aleksejm/6xUSB-Power-Meter/ESP-12-breakout-master/README.md

# ESP-12 breakout board

---
A simple ESP-12 breakout board for development and deployment.

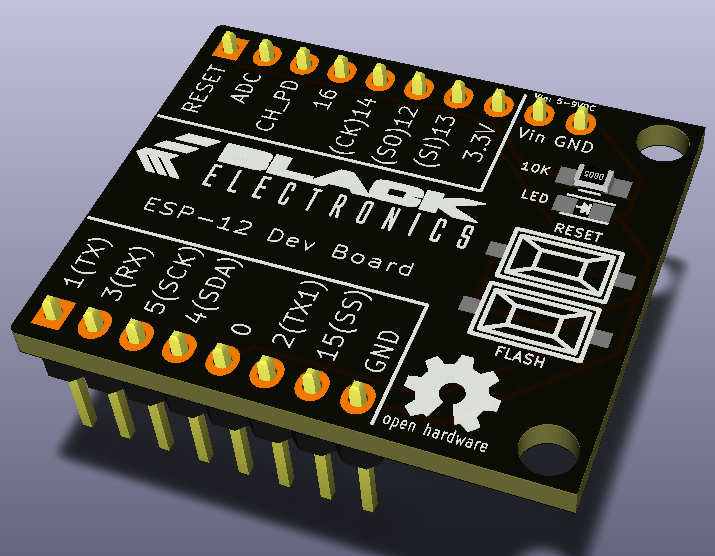
[picture p1: ESP-12-breakout-master/top.png]
Top


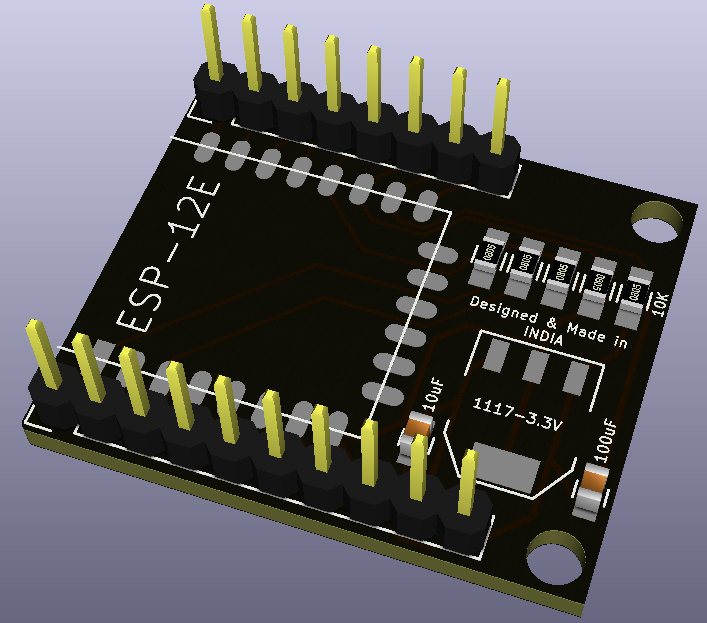
[picture p2: ESP-12-breakout-master/bottom.png]
Bottom


see [logs](https://hackaday.io/project/13018-esp-12e-breakout-board)

[Cern Open Hardware v1.2 Licence](http://www.ohwr.org/attachments/2388/cern_ohl_v_1_2.txt)
