aleksejm/6xUSB-Power-Meter/Hardware/PCB/6xUSB_PowMet_new/6xUSB_PowMet.html

## KiBoM PCB Bill of Materials

Source File | F:\OneDrive\GitHub\6xUSB-Power-Meter\Hardware\PCB\6xUSB_PowMet_new\6xUSB_PowMet.sch
BoM Date | 02/12/2018 14:07:56
Schematic Version | v2.2
Schematic Date | 2018-11-22
KiCad Version | Eeschema (5.0.1)-3
Component Groups | 71
Component Count (per PCB) | 159
Fitted Components (per PCB) | 159
Number of PCBs | 1
Total Component Count (for 1 PCBs) | 159

## Component Groups

KiCad Fields (default)

Generated Fields

User Fields

Empty Fields

| Description | Part | References | Value | Footprint | Quantity Per PCB | Datasheet | Series | Tolerance | Voltage | Part Number | Manufacturerer
