aleksejm/6xUSB-Power-Meter/Hardware/PCB/6xUSB_PowMet_new/_6xUSB_PowMet.html

# F:\OneDrive\GitHub\6xUSB-Power-Meter\Hardware\PCB\6xUSB_PowMet_new\6xUSB_PowMet.sch

02/12/2018 13:47:54

Eeschema (5.0.1)-3

Component Count:161

Ref | Qnty | Value | Part | Footprint | Description | Vendor
C1 | 1 | 1n | Device:C_Small | Capacitors_SMD:C_0805 | Unpolarized capacitor, small symbol
C2, C3 | 2 | 100n | Device:C_Small | Capacitors_SMD:C_0805 | Unpolarized capacitor, small symbol
C4, C5 | 2 | 22pF | Device:C_Small | Capacitors_SMD:C_0603 | Unpolarized capacitor, small symbol
C6, C7 | 2 | 18pF | Device:C_Small | Capacitors_SMD:C_0805 | Unpolarized capacitor, small symbol
C8, C21, C23 | 3 | 100n | Device:C | Capacitors_SMD:C_0805 | Unpolarized capacitor
C9 | 1 | 10nF | Device:C_Small | Capacitors_SMD:C_0805 | Unpolarized capacitor, small symbol
C10 | 1 | 100uF | Device:CP1_Small | Capacitors_SMD:C_0805 | Polarized capacitor, small US symbol
C11, C12, C14 | 3 | 0.1uF | Device:C_Small | Capacitors_SMD:C_0603 | Unpolarized capacitor, small symbol
C13 | 1 | 10uF | Device:C_Small | Capacitors_SMD:C_0805 | Unpolarized capacitor, small symbol
C15, C27, C41, C42, C43, C44, C45 | 7 | 10uF | Device:C_Small | Capacitors_SMD:C_0805 | Unpolarized capacitor, small symbol
C16, C17 | 2 | 22uF | Device:C_Small | Capacitors_SMD:C_1206 | Unpolarized capacitor, small symbol
C18, C19, C24, C29, C32, C37, C38, C39, C40 | 9 | 100nF | Device:C_Small | Capacitors_SMD:C_0805 | Unpolarized capacitor, small symbol
C20 | 1 | 15nF | Device:C_Small | Capacitors_SMD:C_0805 | Unpolarized capacitor, small symbol
C22, C31, C33, C34, C35, C36 | 6 | 1nF | Device:C_Small | Capacitors_SMD:C_0805 | Unpolarized capacitor, small symbol
C25 | 1 | 470nF | Device:C_Small | Capacitors_SMD:C_0805 | Unpolarized capacitor, small symbol
C26 | 1 | 1uF | Device:C_Small | Capacitors_SMD:C_0805 | Unpolarized capacitor, small symbol
C28 | 1 | 470pF | Device:C_Small | Capacitors_SMD:C_0805 | Unpolarized capacitor, small symbol
C30 | 1 | 220uF | Device:CP1_Small | Capacitors_SMD:c_elec_6.3x7.7 | Polarized capacitor, small US symbol
CON2 | 1 | JACK | conn:Jack-DC | Connect:JACK_ALIM | DC Barrel Jack
D1 | 1 | CD1206-S01575 | Device:D_Small | Diodes_SMD:D_1206 | Diode, small symbol
D2 | 1 | MC Stat | 6xUSB_PowMet-rescue:Led_Small | LEDs:LED_0603
D3 | 1 | Act | 6xUSB_PowMet-rescue:Led_Small | LEDs:LED_0805
D4 | 1 | SKL14 | Device:D_Schottky | Diodes_SMD:D_SOD-123F | Schottky diode
D5 | 1 | SK2030YD2 | 6xUSB_PowMet-rescue:SCHDPAK | TO_SOT_Packages_SMD:TO-263-2
F1 | 1 | 500mA | 6xUSB_PowMet-rescue:F_Small | Fuse_Holders_and_Fuses:Fuse_SMD1206_HandSoldering
F2, F3, F4, F5, F6, F7 | 6 | F_Small | 6xUSB_PowMet-rescue:F_Small | Fuse_Holders_and_Fuses:Fuse_SMD1206_Wave
IC1 | 1 | ATMEGA32-M | atmel:ATMEGA32-16MU | Housings_QFP:TQFP-44_10x10mm_Pitch0.8mm | QFN/MLF44, 32k Flash, 2k SRAM, 1k EEPROM, JTAG
J1 | 1 | Conn_01x07 | conn:Conn_01x07 | Connectors_Molex:Molex_SPOX-5267_22-03-5075_07x2.54mm_Straight | Generic connector, single row, 01x07
J2 | 1 | Conn_01x02 | conn:Conn_01x02 | Connectors_Molex:Molex_SPOX-5267_22-03-5025_02x2.54mm_Straight | Generic connector, single row, 01x02
J3 | 1 | Conn_01x06 | conn:Conn_01x06 | Connectors_Molex:Molex_SPOX-5267_22-03-5065_06x2.54mm_Straight | Generic connector, single row, 01x06
JP1 | 1 | Reset | Jumper:SolderJumper_2_Open | Jumpers:SMT-JUMPER_2_NO_SILK | Solder Jumper, 2-pole, open
L1 | 1 | 10uH | 6xUSB_PowMet-rescue:L-RESCUE-6xUSB_PowMet | Inductors:Inductor_1212
L2 | 1 | 100Mhz 470ohm | Device:Ferrite_Bead_Small | Resistors_SMD:R_0805_HandSoldering | Ferrite bead, small symbol
L3 | 1 | 2.2uH | 6xUSB_PowMet-rescue:INDUCTOR_SMALL | Inductors:SELF-WE-PD-XXL
LED1 | 1 | P4 | 6xUSB_PowMet-rescue:Led_Small | LEDs:LED_0805
LED2 | 1 | P2 | 6xUSB_PowMet-rescue:Led_Small | LEDs:LED_0805
LED3 | 1 | P3 | 6xUSB_PowMet-rescue:Led_Small | LEDs:LED_0805
LED4 | 1 | P1 | 6xUSB_PowMet-rescue:Led_Small | LEDs:LED_0805
LED5 | 1 | U_PW | 6xUSB_PowMet-rescue:Led_Small | LEDs:LED_D5.0mm
LED6 | 1 | DC_PW | 6xUSB_PowMet-rescue:Led_Small | LEDs:LED_D5.0mm
LED7 | 1 | ST_USB | 6xUSB_PowMet-rescue:Led_Small | LEDs:LED_D5.0mm
LED8 | 1 | ST_DC | 6xUSB_PowMet-rescue:Led_Small | LEDs:LED_D5.0mm
P1 | 1 | USB_B | conn:USB_B | Connect:USB_B | USB Type B connector
P2, P4 | 2 | CONN_02X04 | 6xUSB_PowMet-rescue:CONN_02X04 | Socket_Strips:Socket_Strip_Straight_2x04
P3, P5, P6, P7, P8, P9 | 6 | USB_A | conn:USB_A | USB-A_vertical1:USB_A_Vertical | USB Type A connector
Q1 | 1 | CSD17577Q5A | transistors:IRF7607PBF | Personal:AB2_SON5x6_FET | HexFET N-MOS Power Mosfet, Vds 20V, Rdson 0.03R, Id 5.2A, Micro8
Q2 | 1 | CSD16342Q5A | transistors:IRF7607PBF | Mosfet:AB2_SON5x6_FET | HexFET N-MOS Power Mosfet, Vds 20V, Rdson 0.03R, Id 5.2A, Micro8
Q3, Q5, Q6, Q7, Q8, Q9 | 6 | IRLML6401 | 6xUSB_PowMet-rescue:P-CHAN-MOSFET_SOT | TO_SOT_Packages_SMD:SOT-23
Q4 | 1 | IRFR5305PBF | Device:Q_PMOS_GDS | TO_SOT_Packages_SMD1:TO-252-2Lead | P-MOSFET transistor, gate/drain/source
R1, R32 | 2 | 10K | Device:R_Small | Resistors_SMD:R_0805 | Resistor, small symbol
R2 | 1 | 15K | Device:R_Small | Resistors_SMD:R_0805 | Resistor, small symbol
R3, R4, R6, R7, R8, R10, R12, R15, R16, R20, R28, R30 | 12 | 10K | Device:R_Small | Resistors_SMD:R_0805 | Resistor, small symbol
R5, R11, R18, R19, R21, R22, R34, R50, R51 | 9 | 470 | Device:R_Small | Resistors_SMD:R_0805 | Resistor, small symbol
R9 | 1 | 2.7K | Device:R_Small | Resistors_SMD:R_0805 | Resistor, small symbol
R13, R14, R17 | 3 | 100K | Device:R_Small | Resistors_SMD:R_0805 | Resistor, small symbol
R23 | 1 | 100K | Device:R_Small | Resistors_SMD:R_0805 | Resistor, small symbol
R24 | 1 | 100 | Device:R_Small | Resistors_SMD:R_0805 | Resistor, small symbol
R25, R35, R37, R38, R39, R40 | 6 | 1K | Device:R_Small | Resistors_SMD:R_0805 | Resistor, small symbol
R26, R36, R42, R43, R44, R45 | 6 | 100R | Device:R_Small | Resistors_SMD:R_0805 | Resistor, small symbol
R27 | 1 | 1K07 | Device:R_Small | Resistors_SMD:R_0805 | Resistor, small symbol
R29, R41, R46, R47, R48, R49 | 6 | 0.02R | Device:R_Small | Resistors_SMD:R_1206 | Resistor, small symbol
R31 | 1 | 73K2 | Device:R_Small | Resistors_SMD:R_0805 | Resistor, small symbol
R33 | 1 | 470K | Device:R_Small | Resistors_SMD:R_0805 | Resistor, small symbol
SW1 | 1 | Reset | Switch:SW_Push | Buttons_Switches_SMD:SW_SPST_B3U-1000P | Push button switch, generic, two pins
U1 | 1 | ESP-12 | RF_Module:ESP-07 | ESP8266:ESP-12 | 802.11 b/g/n Wi-Fi Module
U2 | 1 | FE1.1s | 6xUSB_PowMet-rescue:FE1.1s | Housings_SSOP:TSSOP-28_4.4x9.7mm_Pitch0.65mm
U3 | 1 | 24LC02 | 6xUSB_PowMet-rescue:24LC02 | Housings_SOIC:SOIC-8_3.9x4.9mm_Pitch1.27mm
U4 | 1 | AP1117E33 | 6xUSB_PowMet-rescue:AP1117E50 | TO_SOT_Packages_SMD:SOT-89-3
U5 | 1 | LM4040 | 6xUSB_PowMet-rescue:LM4040AvvDBZ | TO_SOT_Packages_SMD:SOT-23
U6 | 1 | LM3150 | 6xUSB_PowMet-rescue:LM3150 | Housings_SSOP:SSOP-14_5.3x6.2mm_Pitch0.65mm
U7, U9, U10, U11, U12, U13 | 6 | LT6106 | 6xUSB_PowMet-rescue:LT6106 | TO_SOT_Packages_SMD:SOT-23-5
U8 | 1 | LTC4412 | 6xUSB_PowMet-rescue:LTC4412 | TO_SOT_Packages_SMD:SOT-23-6
Y1 | 1 | 16MHz | Device:Crystal_GND24_Small | Crystals:Crystal_SMD_2016-4pin_2.0x1.6mm | Four pin crystal, GND on pins 2 and 4, small symbol
Y2 | 1 | 12Mhz | Device:Crystal_Small | Crystals:Crystal_SMD_HC49-SD | Two pin crystal, small symbol
