aleksejm/6xUSB-Power-Meter/KiCad librarys/webench_schematic_exchange_design_4493365_1_Accel15/Accel15/readme.txt

**********************************************************
*************  Important Instructions Follow  ************
**********************************************************

All files exported to: Z:\\44\\93\\4493365\\1\Accel15\2016-05-09_02-05-33.lia

To import your new Board into PCAD / ACCEL:

1. Unzip the downloaded folder files to a local directory and
Start the Accel/ PCAD program.
2. From the menu select "File" and then select "Open".
3. Select the file named in the path above ending with ".pcb"
and "Open" the file.
4. Your board should be viewable within Accel.

To import your new Schematic into PCAD / ACCEL:

1. Unzip the downloaded folder files to a local directory and
	Start the Accel/ PCAD program.
2. From the menu select "File" and then select "Open".
3. Select the file named in the path above ending with ".sch"
and "Open" the file.
4. Your board should be viewable within Accel.

For additional information, please visit this site:
http://www.accelerated-designs.com/help/PCAD_Accel_BrdSch_Import.html

To import your new library part to PCAD / ACCEL:

1. Start the Library Manager.
2. Select "Library" from the menu at the top of the screen.
3. Select "Translate"
4. Select the source file as the one we have sent you.
5. Specify where you would like to store the destination file.
6. Select the source Format as "PCAD ASCII".
7. Selcet the destination as "PCAD Binary"
8. Translate.

To import your new library parts into Protel DXP:

1. Start Protel DXP.
2. Select File/New/PCB Library.
3. Select File/Import
4. Browse to the included *.lia ile and select it.

For additional information, please visit this site:
http://www.accelerated-designs.com/help/PCAD_Accel_Import.html

If you're exporting to Altium, visit this site for more information:
http://www.accelerated-designs.com/help/Altiumimport.html

To view a video, please visit:
http://youtu.be/sJ1KhFu3wl4

Symbol "WB_DIODE_SCHOTTKY" renamed to "WB_DIODE_SCHOTTK"
Symbol "WB_PRIM_AC_VOLTAGE_SOURCE" renamed to "WB_PRIM_AC_VOLTA"
Symbol "WB_PRIMITIVE_CAPACITOR" renamed to "WB_PRIMITIVE_CAP"
Symbol "WB_PRIMITIVE_INDUCTOR" renamed to "WB_PRIMITIVE_IND"
Symbol "WB_STARTUP_VOLTAGE_SOURCE" renamed to "WB_STARTUP_VOLTA"
Symbol "WB_SOURCE_RESISTOR" renamed to "WB_SOURCE_RESIST"
Symbol "WB_PRIM_STARTUP_VOLTAGE_SOURCE" renamed to "WB_PRIM_STARTUP_"
Symbol "WB_PWL_CURRENT_LOAD" renamed to "WB_PWL_CURRENT_L"
Symbol "WB_PWL_VOLTAGE_SOURCE" renamed to "WB_PWL_VOLTAGE_S"
Symbol "WB_PRIM_PWL_VOLTAGE_SOURCE" renamed to "WB_PRIM_PWL_VOLT"
Symbol "WB_PRIMITIVE_BATTERY" renamed to "WB_PRIMITIVE_BAT"
Component "C0805C103K5RACTU" renamed to "C0805C103K5RACTU"
Component "WB_CURRENT_LOAD" renamed to "WB_CURRENT_LOAD"
Component "16SVP180MX" renamed to "16SVP180MX"
Component "CDBC520-G" renamed to "CDBC520-G"
Component "WB_GND" renamed to "WB_GND"
Component "SER2915L-223KL" renamed to "SER2915L-223KL"
Component "ERJ-6ENF3241V" renamed to "ERJ-6ENF3241V"
Component "ERJ-6ENF1002V" renamed to "ERJ-6ENF1002V"
Component "TPS5450DDAR" renamed to "TPS5450DDAR"
Component "WB_BATTERY" renamed to "WB_BATTERY"
Component "C3216X5R1E476M160AC" renamed to "C3216X5R1E476M16"
The Symbol WB_CONTINUATION was missing a RefDes attribute, a refdes was created for the symbol.
The Symbol WB_CONTINUATION was missing a Type attribute, a type was created for the symbol.
The Symbol WB_CONTINUATION was missing a Value attribute, a value was created for the symbol.
The Symbol WB_BLOCK_IO was missing a RefDes attribute, a refdes was created for the symbol.
The Symbol WB_BLOCK_IO was missing a Type attribute, a type was created for the symbol.
The Symbol WB_BLOCK_IO was missing a Value attribute, a value was created for the symbol.
The Symbol WB_VOLTAGE_PROBE was missing a RefDes attribute, a refdes was created for the symbol.
The Symbol WB_VOLTAGE_PROBE was missing a Type attribute, a type was created for the symbol.
The Symbol WB_VOLTAGE_PROBE was missing a Value attribute, a value was created for the symbol.
The Symbol WB_PRIM_AC_VOLTA was missing a RefDes attribute, a refdes was created for the symbol.
The Symbol WB_PRIM_AC_VOLTA was missing a Type attribute, a type was created for the symbol.
The Symbol WB_PRIM_AC_VOLTA was missing a Value attribute, a value was created for the symbol.
The Symbol WB_PRIMITIVE_CAP was missing a RefDes attribute, a refdes was created for the symbol.
The Symbol WB_PRIMITIVE_CAP was missing a Type attribute, a type was created for the symbol.
The Symbol WB_PRIMITIVE_CAP was missing a Value attribute, a value was created for the symbol.
The Symbol WB_PRIMITIVE_IND was missing a RefDes attribute, a refdes was created for the symbol.
The Symbol WB_PRIMITIVE_IND was missing a Type attribute, a type was created for the symbol.
The Symbol WB_PRIMITIVE_IND was missing a Value attribute, a value was created for the symbol.
The Symbol WB_STARTUP_VOLTA was missing a RefDes attribute, a refdes was created for the symbol.
The Symbol WB_STARTUP_VOLTA was missing a Type attribute, a type was created for the symbol.
The Symbol WB_STARTUP_VOLTA was missing a Value attribute, a value was created for the symbol.
The Symbol WB_SOURCE_RESIST was missing a RefDes attribute, a refdes was created for the symbol.
The Symbol WB_SOURCE_RESIST was missing a Type attribute, a type was created for the symbol.
The Symbol WB_SOURCE_RESIST was missing a Value attribute, a value was created for the symbol.
The Symbol WB_PRIM_STARTUP_ was missing a RefDes attribute, a refdes was created for the symbol.
The Symbol WB_PRIM_STARTUP_ was missing a Type attribute, a type was created for the symbol.
The Symbol WB_PRIM_STARTUP_ was missing a Value attribute, a value was created for the symbol.
The Symbol WB_CURRENT_PROBE was missing a RefDes attribute, a refdes was created for the symbol.
The Symbol WB_CURRENT_PROBE was missing a Type attribute, a type was created for the symbol.
The Symbol WB_CURRENT_PROBE was missing a Value attribute, a value was created for the symbol.
The Symbol WB_PWL_CURRENT_L was missing a RefDes attribute, a refdes was created for the symbol.
The Symbol WB_PWL_CURRENT_L was missing a Type attribute, a type was created for the symbol.
The Symbol WB_PWL_CURRENT_L was missing a Value attribute, a value was created for the symbol.
The Symbol WB_LOAD_RESISTOR was missing a RefDes attribute, a refdes was created for the symbol.
The Symbol WB_LOAD_RESISTOR was missing a Type attribute, a type was created for the symbol.
The Symbol WB_LOAD_RESISTOR was missing a Value attribute, a value was created for the symbol.
The Symbol WB_PWL_VOLTAGE_S was missing a RefDes attribute, a refdes was created for the symbol.
The Symbol WB_PWL_VOLTAGE_S was missing a Type attribute, a type was created for the symbol.
The Symbol WB_PWL_VOLTAGE_S was missing a Value attribute, a value was created for the symbol.
The Symbol WB_PRIM_PWL_VOLT was missing a RefDes attribute, a refdes was created for the symbol.
The Symbol WB_PRIM_PWL_VOLT was missing a Type attribute, a type was created for the symbol.
The Symbol WB_PRIM_PWL_VOLT was missing a Value attribute, a value was created for the symbol.
The Symbol WB_PRIMITIVE_BAT was missing a RefDes attribute, a refdes was created for the symbol.
The Symbol WB_PRIMITIVE_BAT was missing a Type attribute, a type was created for the symbol.
The Symbol WB_PRIMITIVE_BAT was missing a Value attribute, a value was created for the symbol.
SolderPaste and SolderMask data have been removed from the follow pad styles:
	"RX44Y57D0T"
	"R10630430000200A"
	"RX152Y31D0T"
	"RX71Y117D0T"
	"RX210Y220D0T"
	"RX250Y208D0T"
	"RX78Y18p14D0T"
	"RX94Y122D0T"
