aleksejm/6xUSB-Power-Meter/KiCad librarys/webench_schematic_exchange_design_4493365_1_Accel15/Pads3/2016-05-09_02-05-34/readme.txt

**********************************************************
*************  Important Instructions Follow  ************
**********************************************************

All files exported to: Z:\\44\\93\\4493365\\1\Pads3\2016-05-09_02-05-34\2016-05-09_02-05-34

To import your new BOARD file into PADS:

1. Unzip the downloaded folder files to a local directory and
Start the PowerPCB program.
2. Select File/Import from the menu at the top of the screen.
3. From the windows screen select the file and path listed above.
The file should have the extension ".asc".
4. You should now have an image of your board available in PADs.

For additional information, please visit this site:
http://www.accelerated-designs.com/help/PowerPCB_BrdSch_import.html

For more information and instructions on creating a library, please
visit this site:
http://www.accelerated-designs.com/help/PowerPCB_import.html

To import your new LIBRARY PARTS to PADS:
1. Start the PowerPCB program.
2. Select File/Library from the menu at the top of the screen.
3. Select the library to translate into from the "Library" list box.
4. Select the Decal icon.
5. Select import from the bottom of the library screen.
6. Select the *.d file included in the zip file.
7. To import a matching symbol with your footprint, simply
repeat the above proceedure (#4 - #6) for the CAE (*.c) and Parts
(*.p) files using the appropriate Icons.

For additional information, please visit this site:
http://www.accelerated-designs.com/help/PowerPCB_import.html

To view a video tutorial, please visit:
http://youtu.be/BT0ao-Y2C-M

Component "C0805C103K5RACTU" renamed to "C0805C103K5RACTU"
Component "WB_CURRENT_LOAD" renamed to "WB_CURRENT_LOAD"
Component "16SVP180MX" renamed to "16SVP180MX"
Component "CDBC520-G" renamed to "CDBC520-G"
Component "WB_GND" renamed to "WB_GND"
Component "SER2915L-223KL" renamed to "SER2915L-223KL"
Component "ERJ-6ENF3241V" renamed to "ERJ-6ENF3241V"
Component "ERJ-6ENF1002V" renamed to "ERJ-6ENF1002V"
Component "TPS5450DDAR" renamed to "TPS5450DDAR"
Component "WB_BATTERY" renamed to "WB_BATTERY"
Component "C3216X5R1E476M160AC" renamed to "C3216X5R1E476M160AC"
The Symbol WB_CONTINUATION was missing a RefDes attribute, a refdes was created for the symbol.
The Symbol WB_CONTINUATION was missing a Type attribute, a type was created for the symbol.
The Symbol WB_CONTINUATION was missing a Value attribute, a value was created for the symbol.
The Symbol WB_BLOCK_IO was missing a RefDes attribute, a refdes was created for the symbol.
The Symbol WB_BLOCK_IO was missing a Type attribute, a type was created for the symbol.
The Symbol WB_BLOCK_IO was missing a Value attribute, a value was created for the symbol.
The Symbol WB_VOLTAGE_PROBE was missing a RefDes attribute, a refdes was created for the symbol.
The Symbol WB_VOLTAGE_PROBE was missing a Type attribute, a type was created for the symbol.
The Symbol WB_VOLTAGE_PROBE was missing a Value attribute, a value was created for the symbol.
The Symbol WB_PRIM_AC_VOLTAGE_SOURCE was missing a RefDes attribute, a refdes was created for the symbol.
The Symbol WB_PRIM_AC_VOLTAGE_SOURCE was missing a Type attribute, a type was created for the symbol.
The Symbol WB_PRIM_AC_VOLTAGE_SOURCE was missing a Value attribute, a value was created for the symbol.
The Symbol WB_PRIMITIVE_CAPACITOR was missing a RefDes attribute, a refdes was created for the symbol.
The Symbol WB_PRIMITIVE_CAPACITOR was missing a Type attribute, a type was created for the symbol.
The Symbol WB_PRIMITIVE_CAPACITOR was missing a Value attribute, a value was created for the symbol.
The Symbol WB_PRIMITIVE_INDUCTOR was missing a RefDes attribute, a refdes was created for the symbol.
The Symbol WB_PRIMITIVE_INDUCTOR was missing a Type attribute, a type was created for the symbol.
The Symbol WB_PRIMITIVE_INDUCTOR was missing a Value attribute, a value was created for the symbol.
The Symbol WB_STARTUP_VOLTAGE_SOURCE was missing a RefDes attribute, a refdes was created for the symbol.
The Symbol WB_STARTUP_VOLTAGE_SOURCE was missing a Type attribute, a type was created for the symbol.
The Symbol WB_STARTUP_VOLTAGE_SOURCE was missing a Value attribute, a value was created for the symbol.
The Symbol WB_SOURCE_RESISTOR was missing a RefDes attribute, a refdes was created for the symbol.
The Symbol WB_SOURCE_RESISTOR was missing a Type attribute, a type was created for the symbol.
The Symbol WB_SOURCE_RESISTOR was missing a Value attribute, a value was created for the symbol.
The Symbol WB_PRIM_STARTUP_VOLTAGE_SOURCE was missing a RefDes attribute, a refdes was created for the symbol.
The Symbol WB_PRIM_STARTUP_VOLTAGE_SOURCE was missing a Type attribute, a type was created for the symbol.
The Symbol WB_PRIM_STARTUP_VOLTAGE_SOURCE was missing a Value attribute, a value was created for the symbol.
The Symbol WB_CURRENT_PROBE was missing a RefDes attribute, a refdes was created for the symbol.
The Symbol WB_CURRENT_PROBE was missing a Type attribute, a type was created for the symbol.
The Symbol WB_CURRENT_PROBE was missing a Value attribute, a value was created for the symbol.
The Symbol WB_PWL_CURRENT_LOAD was missing a RefDes attribute, a refdes was created for the symbol.
The Symbol WB_PWL_CURRENT_LOAD was missing a Type attribute, a type was created for the symbol.
The Symbol WB_PWL_CURRENT_LOAD was missing a Value attribute, a value was created for the symbol.
The Symbol WB_LOAD_RESISTOR was missing a RefDes attribute, a refdes was created for the symbol.
The Symbol WB_LOAD_RESISTOR was missing a Type attribute, a type was created for the symbol.
The Symbol WB_LOAD_RESISTOR was missing a Value attribute, a value was created for the symbol.
The Symbol WB_PWL_VOLTAGE_SOURCE was missing a RefDes attribute, a refdes was created for the symbol.
The Symbol WB_PWL_VOLTAGE_SOURCE was missing a Type attribute, a type was created for the symbol.
The Symbol WB_PWL_VOLTAGE_SOURCE was missing a Value attribute, a value was created for the symbol.
The Symbol WB_PRIM_PWL_VOLTAGE_SOURCE was missing a RefDes attribute, a refdes was created for the symbol.
The Symbol WB_PRIM_PWL_VOLTAGE_SOURCE was missing a Type attribute, a type was created for the symbol.
The Symbol WB_PRIM_PWL_VOLTAGE_SOURCE was missing a Value attribute, a value was created for the symbol.
The Symbol WB_PRIMITIVE_BATTERY was missing a RefDes attribute, a refdes was created for the symbol.
The Symbol WB_PRIMITIVE_BATTERY was missing a Type attribute, a type was created for the symbol.
The Symbol WB_PRIMITIVE_BATTERY was missing a Value attribute, a value was created for the symbol.

Ultra Librarian Gold 8.1.44 Process Report

Message - Component "C0805C103K5RACTU" attribute "Cap" references text style "" that is not in the database.
The default pattern text style "H50s3" was substituted.
Message - Component "C0805C103K5RACTU" attribute "ESR" references text style "" that is not in the database.
The default pattern text style "H50s3" was substituted.
Message - Component "C0805C103K5RACTU" attribute "IRMS" references text style "" that is not in the database.
The default pattern text style "H50s3" was substituted.
Message - Component "C0805C103K5RACTU" attribute "VDC" references text style "" that is not in the database.
The default pattern text style "H50s3" was substituted.
Message - Component "16SVP180MX" attribute "Datasheet URL" references text style "" that is not in the database.
The default pattern text style "H50s3" was substituted.
Message - Component "16SVP180MX" attribute "Cap" references text style "" that is not in the database.
The default pattern text style "H50s3" was substituted.
Message - Component "16SVP180MX" attribute "ESR" references text style "" that is not in the database.
The default pattern text style "H50s3" was substituted.
Message - Component "16SVP180MX" attribute "IRMS" references text style "" that is not in the database.
The default pattern text style "H50s3" was substituted.
Message - Component "16SVP180MX" attribute "VDC" references text style "" that is not in the database.
The default pattern text style "H50s3" was substituted.
Message - Component "CDBC520-G" attribute "Datasheet URL" references text style "" that is not in the database.
The default pattern text style "H50s3" was substituted.
Message - Component "CDBC520-G" attribute "Io" references text style "" that is not in the database.
The default pattern text style "H50s3" was substituted.
Message - Component "CDBC520-G" attribute "VRRM" references text style "" that is not in the database.
The default pattern text style "H50s3" was substituted.
Message - Component "CDBC520-G" attribute "VFatIo" references text style "" that is not in the database.
The default pattern text style "H50s3" was substituted.
Message - Component "SER2915L-223KL" attribute "Datasheet URL" references text style "" that is not in the database.
The default pattern text style "H50s3" was substituted.
Message - Component "SER2915L-223KL" attribute "L" references text style "" that is not in the database.
The default pattern text style "H50s3" was substituted.
Message - Component "SER2915L-223KL" attribute "DCR" references text style "" that is not in the database.
The default pattern text style "H50s3" was substituted.
Message - Component "SER2915L-223KL" attribute "IDC" references text style "" that is not in the database.
The default pattern text style "H50s3" was substituted.
Message - Component "ERJ-6ENF3241V" attribute "Resistance" references text style "" that is not in the database.
The default pattern text style "H50s3" was substituted.
Message - Component "ERJ-6ENF3241V" attribute "Power" references text style "" that is not in the database.
The default pattern text style "H50s3" was substituted.
Message - Component "ERJ-6ENF3241V" attribute "Tolerance" references text style "" that is not in the database.
The default pattern text style "H50s3" was substituted.
Message - Component "ERJ-6ENF1002V" attribute "Resistance" references text style "" that is not in the database.
The default pattern text style "H50s3" was substituted.
Message - Component "ERJ-6ENF1002V" attribute "Power" references text style "" that is not in the database.
The default pattern text style "H50s3" was substituted.
Message - Component "ERJ-6ENF1002V" attribute "Tolerance" references text style "" that is not in the database.
The default pattern text style "H50s3" was substituted.
Message - Component "TPS5450DDAR" attribute "Datasheet URL" references text style "" that is not in the database.
The default pattern text style "H50s3" was substituted.
Message - Component "TPS5450DDAR" attribute "Frequency" references text style "" that is not in the database.
The default pattern text style "H50s3" was substituted.
Message - Component "TPS5450DDAR" attribute "Imax" references text style "" that is not in the database.
The default pattern text style "H50s3" was substituted.
Message - Component "TPS5450DDAR" attribute "Package" references text style "" that is not in the database.
The default pattern text style "H50s3" was substituted.
Message - Component "TPS5450DDAR" attribute "Mktg_Package" references text style "" that is not in the database.
The default pattern text style "H50s3" was substituted.
Message - Component "TPS5450DDAR" attribute "NSID" references text style "" that is not in the database.
The default pattern text style "H50s3" was substituted.

TextStyle count:  24
Padstack count:   8
Pattern count:    6
Symbol count:     24
Component count:  11

Export

Component "TPS5450DDAR" duplicate pin name "NC" changed to "NC_1"
