aleksejm/6xUSB-Power-Meter/Hardware/Webench desing for eagle/webench_board_exchange_design_4493365_25_Eagle/Eagle/2017-07-22_13-21-48/readme.txt

 

**********************************************************
*************  Important Instructions Follow  ************
**********************************************************
 
All files exported to: Z:\\44\\93\\4493365\\25\Eagle\2017-07-22_13-21-48\2017-07-22_13-21-48.xml

**********************************************************
*****************Schematic Instructions  *******************
**********************************************************

To import your new Schematic file into Eagle:

1. Unzip the downloaded folder files to local directory and Start Eagle.
2. Select "File"->"Open"->"Schematic..." from the menu at the top of
the screen.
3. Browse to your newly exported file and select the ".sch" file extension.
4. You should now see your schamtic available in Eagle.

**********************************************************
*******************  PCB Instructions  *******************
**********************************************************

To import your new BOARD file into Eagle:

1. Unzip the downloaded folder files to local directory and Start Eagle.
2. Select "File"->"Open"->"Board..." from the menu at the top of
the screen.
3. Browse to your newly exported file and select the ".brd" file extension.
4. Planes will need to be repoured to update the polygon fills
	1. Once your board is loaded, type "ratsnest" into the command
	   line and press the Enter key.
	2. The polygons should all be filled now.
5. You should now have an image of your board available in Eagle.

**********************************************************
*******************  LIB Instructions  *******************
**********************************************************

To import your new library into Eagle:

1. Start Eagle.
2. Select "File"->"New"->"Library" from the menu.
3. In the blank library window, select "File" -> "Execute Script"
from the menu.
5. Browse to your newly exported Eagle Script file (".scr" file extension)
6. After opening the file, the script will populate the new library.
Layer 93 should NOT exist.
7. Use "File"->Save As: "AcceleratedDesigns_Lib.lbr" and to the desired
location in Eagle native format.
8. Update schematic with the imported library, Select Library and click on Update; open the library file
	and sync. each part.

For additional information, please visit this site:
http://www.accelerated-designs.com/help/Eagle_import.html

You may also find this video helpful:
http://youtu.be/5jGuWY-Yy3Q

**********************************************************
**********************************************************
**********************************************************

Component "6SVPC330M" renamed to "6SVPC330M"
Component "EMK212B7474KD-T" renamed to "EMK212B7474KD-T"
Component "08053C104KAT2A" renamed to "08053C104KAT2A"
Component "C0805C102K5RACTU" renamed to "C0805C102K5RACTU"
Component "C3216X5R1E476M160AC" renamed to "C3216X5R1E476M160AC"
Component "ERJ-6ENF7322V" renamed to "ERJ-6ENF7322V"
Component "CC0805KRX7R9BB153" renamed to "CC0805KRX7R9BB153"
Component "EMK212B7105KG-T" renamed to "EMK212B7105KG-T"
Component "B350A-13-F" renamed to "B350A-13-F"
Component "LM3150MH/NOPB" renamed to "LM3150MH/NOPB"
Component "XAL1010-472MEB" renamed to "XAL1010-472MEB"
Component "ERJ-6ENF1002V" renamed to "ERJ-6ENF1002V"
Component "ERJ-6ENF2373V" renamed to "ERJ-6ENF2373V"
Component "C0805C223K5RACTU" renamed to "C0805C223K5RACTU"
Component "TP-1502" renamed to "TP-1502"
Component "CSD16321Q5" renamed to "CSD16321Q5"
Component "CSD18509Q5B" renamed to "CSD18509Q5B"

Ultra Librarian Gold 8.1.204 Process Report

Message - Padstack "RX44Y57D0T" Shape(4) is a CIRCLE with no diameter.
Message - Padstack "RX44Y71D0T" Shape(4) is a CIRCLE with no diameter.
Message - Padstack "RX128Y31D0T" Shape(4) is a CIRCLE with no diameter.
Message - Padstack "RX86Y64D0T" Shape(4) is a CIRCLE with no diameter.
Message - Padstack "RX94Y445D0T" Shape(4) is a CIRCLE with no diameter.
Message - Padstack "RX56Y14D0T" Shape(4) is a CIRCLE with no diameter.
Message - Padstack "RX118Y122D0T" Shape(4) is a CIRCLE with no diameter.
Message - Padstack "RX31p5Y27p56D0T" Shape(4) is a CIRCLE with no diameter.
Message - Padstack "RX4p3Y4p56D0T" Shape(4) is a CIRCLE with no diameter.
Message - Padstack "RX1p37Yp71D0T" Shape(4) is a CIRCLE with no diameter.
Message - Padstack "RX3p85Y4p52D0T" Shape(4) is a CIRCLE with no diameter.
Message - Component "6SVPC330M" attribute "Datasheet URL" references text style "" that is not in the database.
The default pattern text style "H50s3" was substituted.
Message - Component "6SVPC330M" attribute "Cap" references text style "" that is not in the database.
The default pattern text style "H50s3" was substituted.
Message - Component "6SVPC330M" attribute "ESR" references text style "" that is not in the database.
The default pattern text style "H50s3" was substituted.
Message - Component "6SVPC330M" attribute "IRMS" references text style "" that is not in the database.
The default pattern text style "H50s3" was substituted.
Message - Component "6SVPC330M" attribute "VDC" references text style "" that is not in the database.
The default pattern text style "H50s3" was substituted.
Message - Component "EMK212B7474KD-T" attribute "Cap" references text style "" that is not in the database.
The default pattern text style "H50s3" was substituted.
Message - Component "EMK212B7474KD-T" attribute "ESR" references text style "" that is not in the database.
The default pattern text style "H50s3" was substituted.
Message - Component "EMK212B7474KD-T" attribute "IRMS" references text style "" that is not in the database.
The default pattern text style "H50s3" was substituted.
Message - Component "EMK212B7474KD-T" attribute "VDC" references text style "" that is not in the database.
The default pattern text style "H50s3" was substituted.
Message - Component "08053C104KAT2A" attribute "Cap" references text style "" that is not in the database.
The default pattern text style "H50s3" was substituted.
Message - Component "08053C104KAT2A" attribute "ESR" references text style "" that is not in the database.
The default pattern text style "H50s3" was substituted.
Message - Component "08053C104KAT2A" attribute "IRMS" references text style "" that is not in the database.
The default pattern text style "H50s3" was substituted.
Message - Component "08053C104KAT2A" attribute "VDC" references text style "" that is not in the database.
The default pattern text style "H50s3" was substituted.
Message - Component "C0805C102K5RACTU" attribute "Cap" references text style "" that is not in the database.
The default pattern text style "H50s3" was substituted.
Message - Component "C0805C102K5RACTU" attribute "ESR" references text style "" that is not in the database.
The default pattern text style "H50s3" was substituted.
Message - Component "C0805C102K5RACTU" attribute "IRMS" references text style "" that is not in the database.
The default pattern text style "H50s3" was substituted.
Message - Component "C0805C102K5RACTU" attribute "VDC" references text style "" that is not in the database.
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
Message - Component "ERJ-6ENF1002V" attribute "Power" references text style "" that is not in the database.
The default pattern text style "H50s3" was substituted.
Message - Component "ERJ-6ENF1002V" attribute "Tolerance" references text style "" that is not in the database.
The default pattern text style "H50s3" was substituted.
Message - Component "ERJ-6ENF2373V" attribute "Resistance" references text style "" that is not in the database.
The default pattern text style "H50s3" was substituted.
Message - Component "ERJ-6ENF2373V" attribute "Power" references text style "" that is not in the database.
The default pattern text style "H50s3" was substituted.
Message - Component "ERJ-6ENF2373V" attribute "Tolerance" references text style "" that is not in the database.
The default pattern text style "H50s3" was substituted.
Message - Component "C0805C223K5RACTU" attribute "Cap" references text style "" that is not in the database.
The default pattern text style "H50s3" was substituted.
Message - Component "C0805C223K5RACTU" attribute "ESR" references text style "" that is not in the database.
The default pattern text style "H50s3" was substituted.
Message - Component "C0805C223K5RACTU" attribute "IRMS" references text style "" that is not in the database.
The default pattern text style "H50s3" was substituted.
Message - Component "C0805C223K5RACTU" attribute "VDC" references text style "" that is not in the database.
The default pattern text style "H50s3" was substituted.

TextStyle count:  24
Padstack count:   16
Pattern count:    9
Symbol count:     9
Component count:  17

Export

Component "C3216X5R1E476M160AC" has the following missing dependency and will be skipped: Footprint "1206L"
