aleksejm/6xUSB-Power-Meter/3D_case/3Dcase.pdf

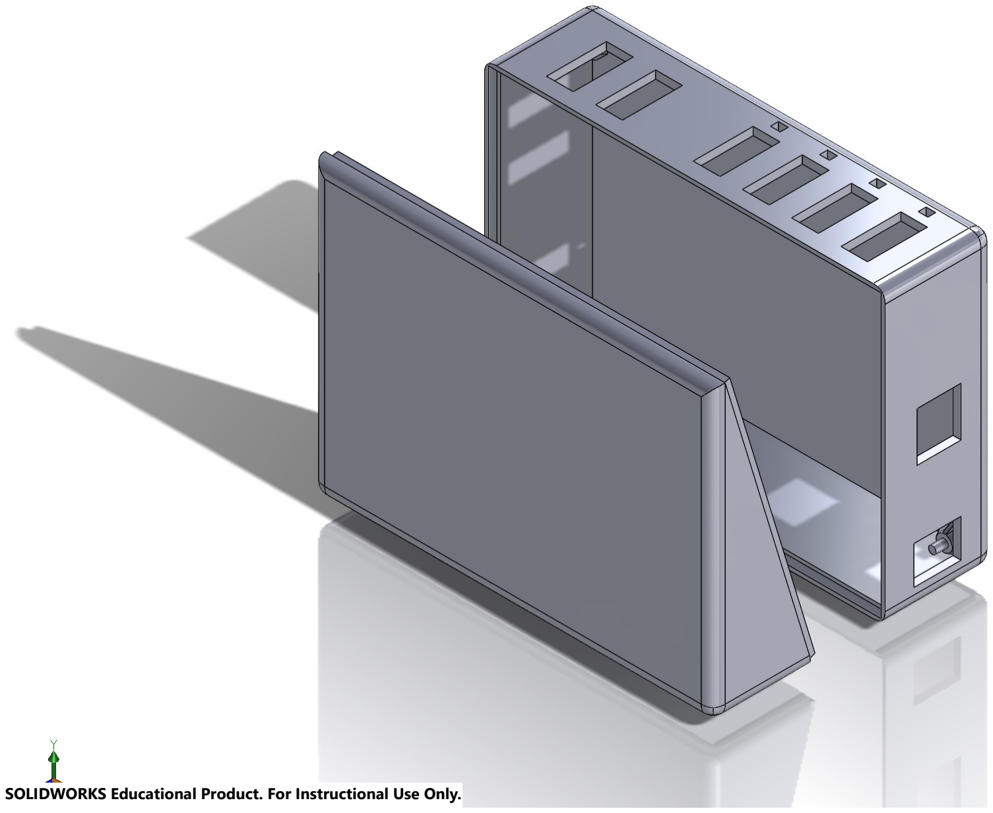
[picture p3: page 1]

SOLIDWORKS Educational Product. For Instructional Use Only.
