aleksejm/6xUSB-Power-Meter/5.5+Device+1.jpg

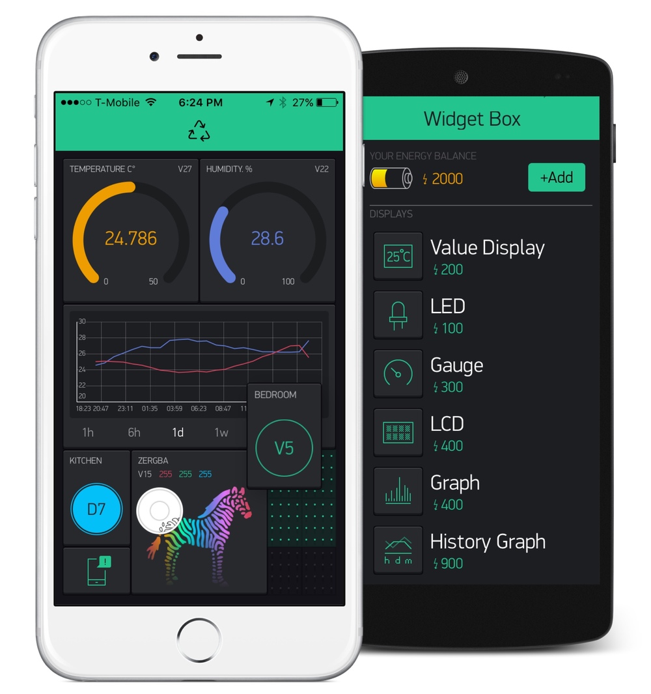
5.5+Device+1.jpg
