aleksejm/6xUSB-Power-Meter/6xUSB_PowMet1.PNG

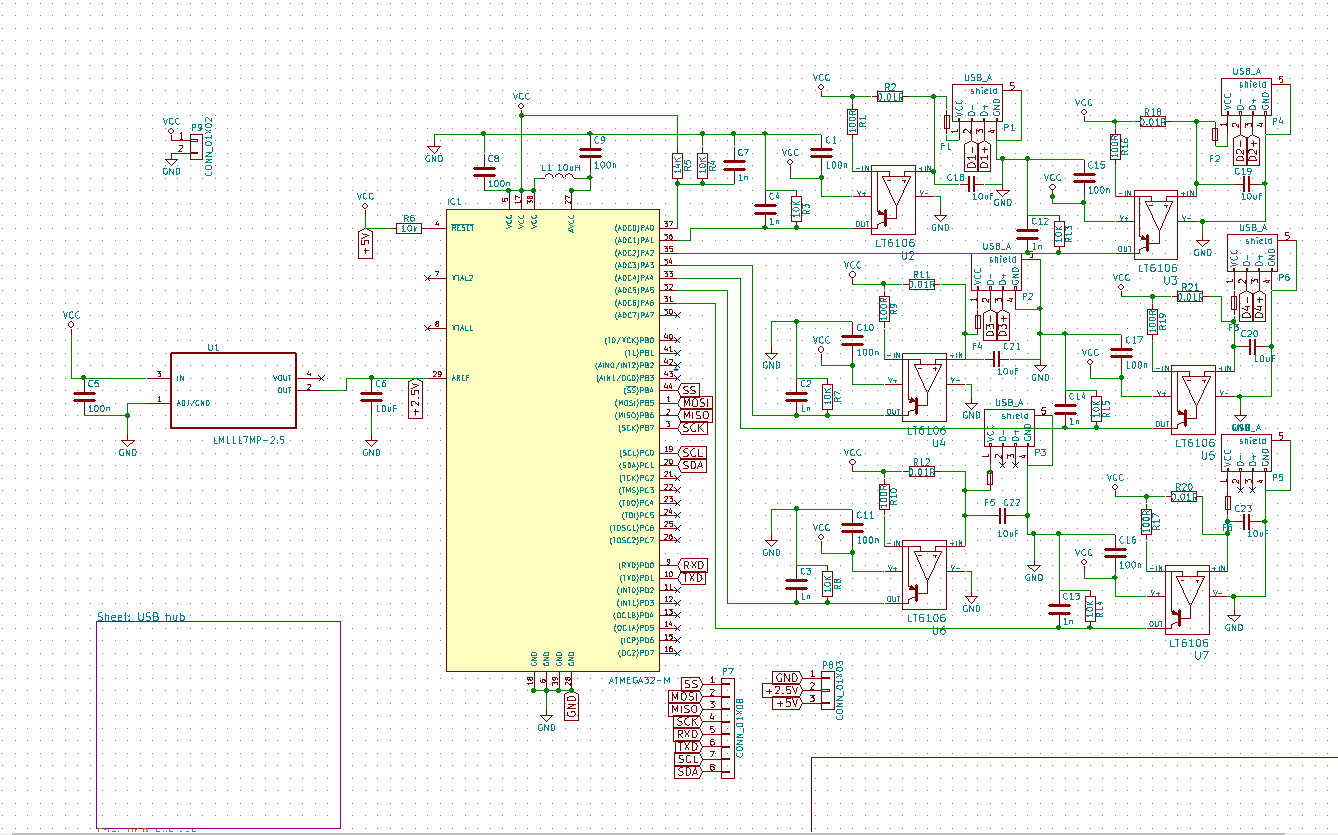
6xUSB_PowMet1.PNG
