aleksejm/6xUSB-Power-Meter/6xUSB_PowMet2_hub.PNG

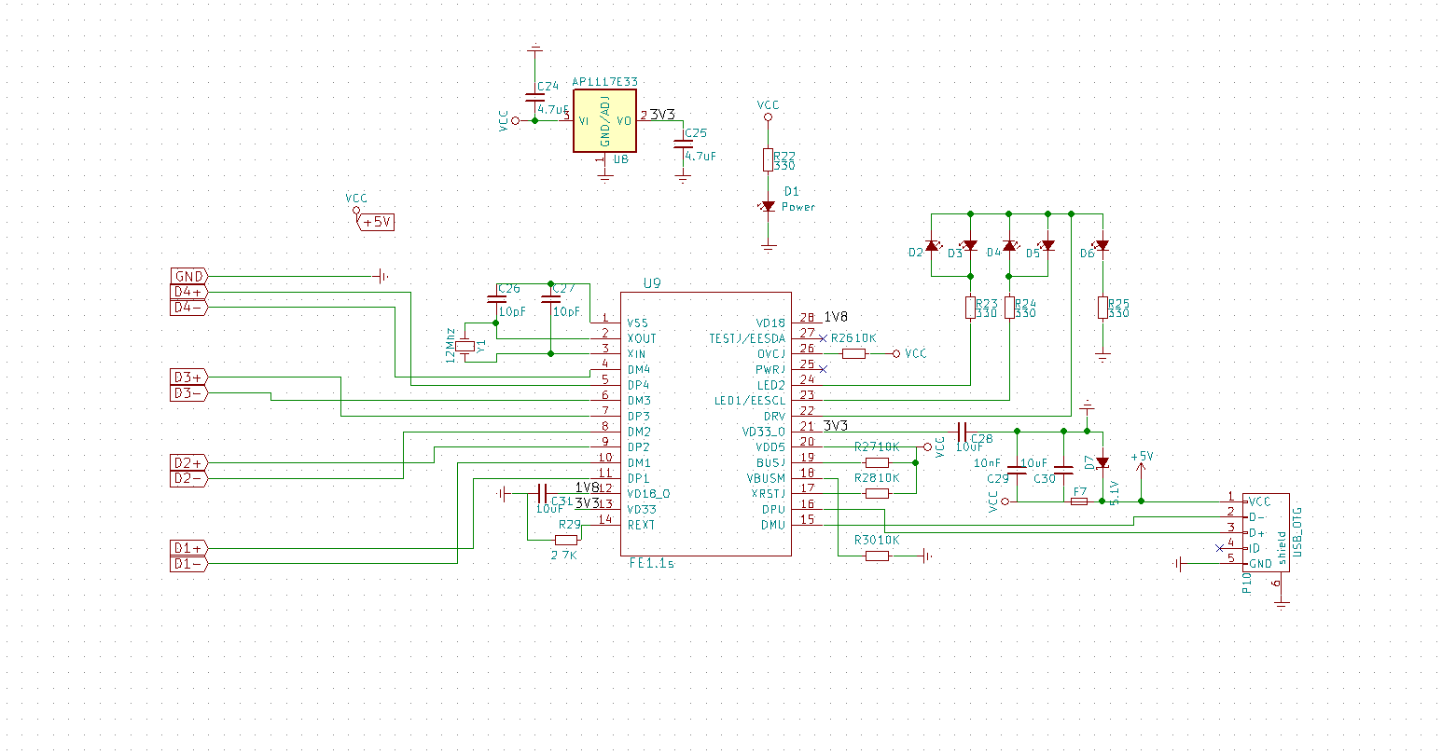
6xUSB_PowMet2_hub.PNG
