aleksejm/6xUSB-Power-Meter/6xUSB_PowMet_back.jpg

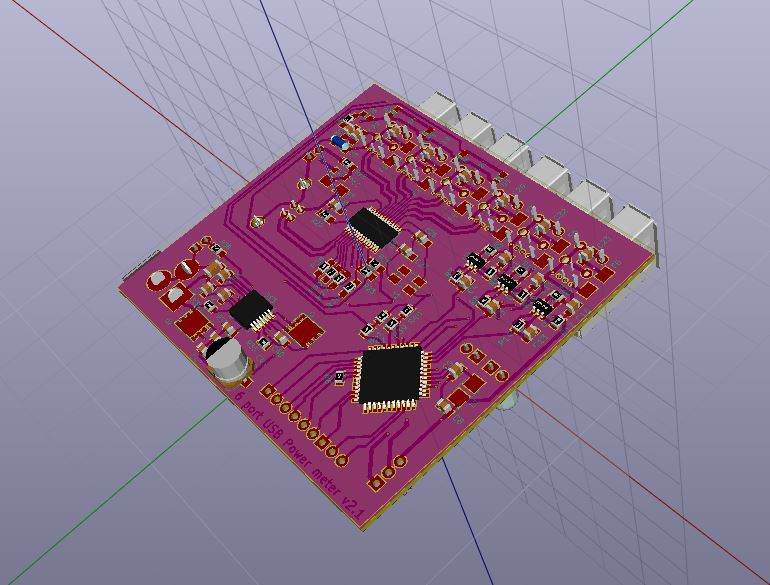
6xUSB_PowMet_back.jpg
