aleksejm/6xUSB-Power-Meter/6xUSB_PowMet_board1.jpg

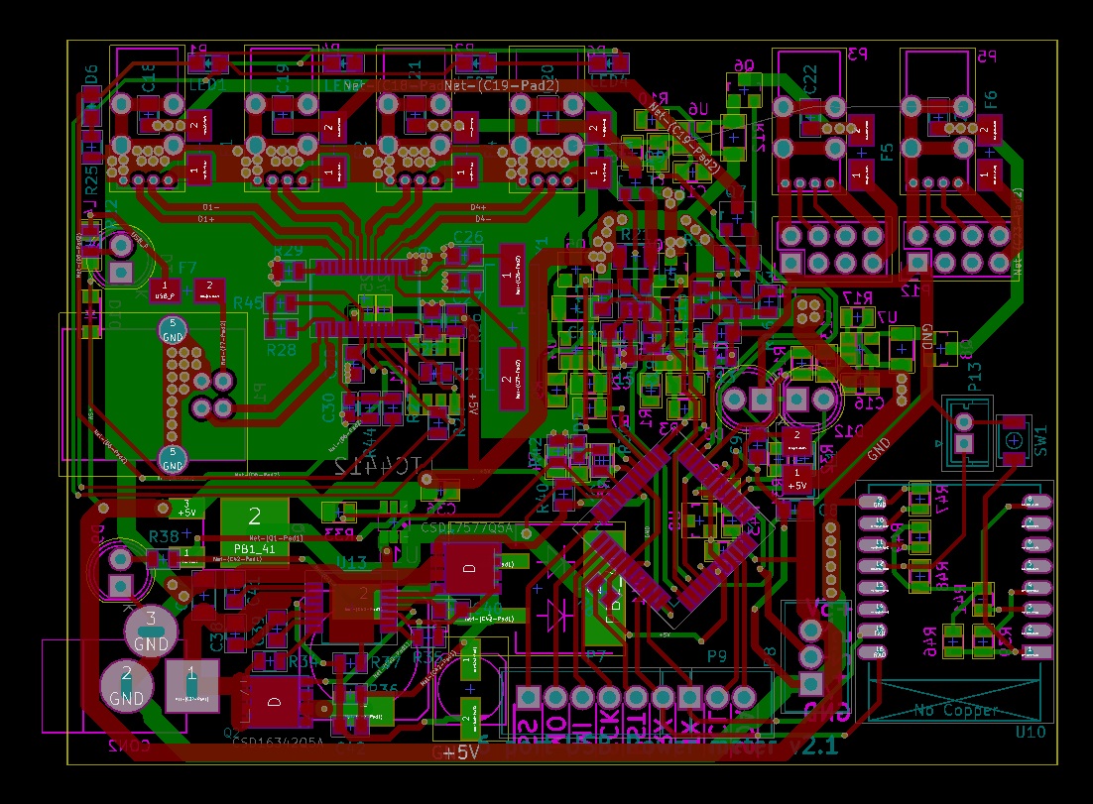
6xUSB_PowMet_board1.jpg
