aleksejm/6xUSB-Power-Meter/6xUSB_PowMet_board.JPG

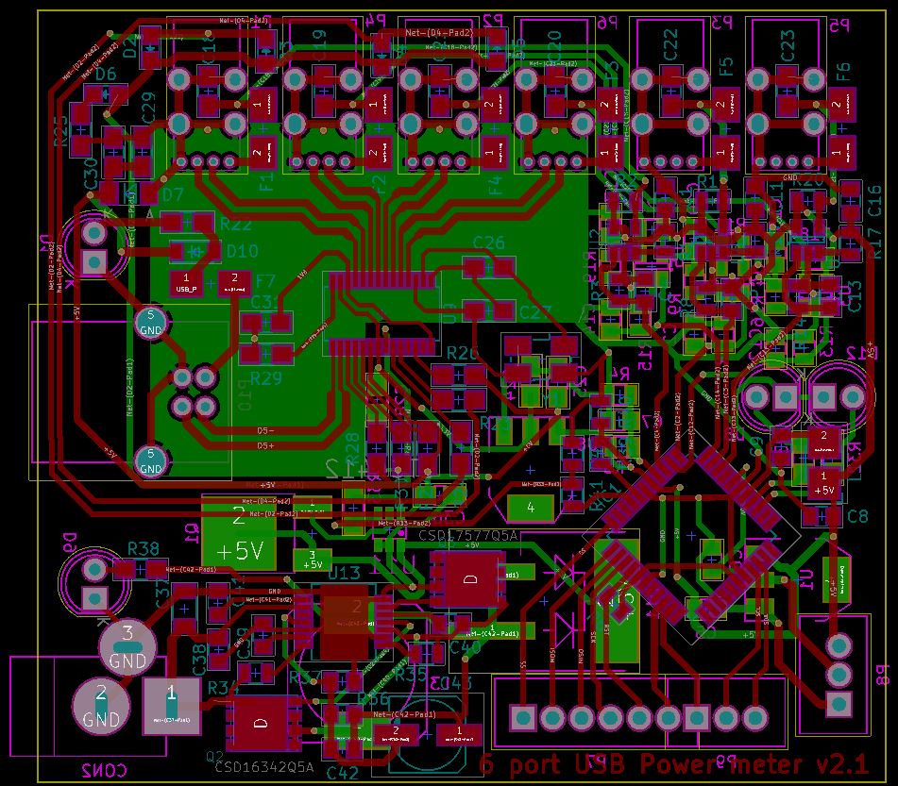
6xUSB_PowMet_board.JPG
