aleksejm/6xUSB-Power-Meter/6xUSB_PowMet_front1.jpg

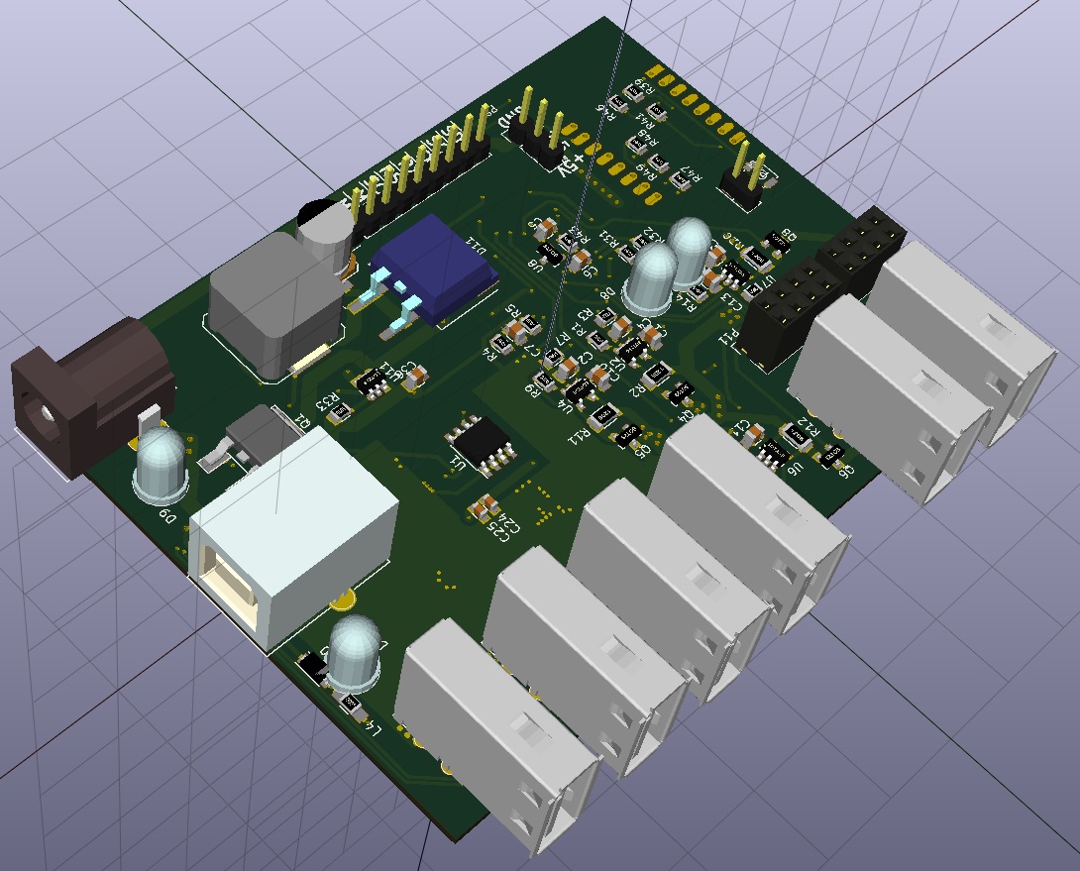
6xUSB_PowMet_front1.jpg
