aleksejm/6xUSB-Power-Meter/6xUSB_PowMet_front.jpg

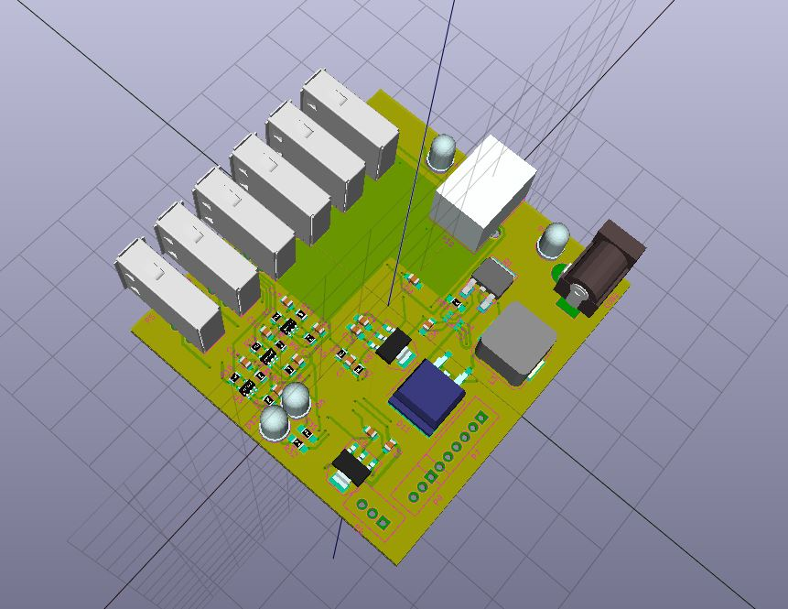
6xUSB_PowMet_front.jpg
