aleksejm/6xUSB-Power-Meter/Hardware/6xUSB_PowMet1.jpg

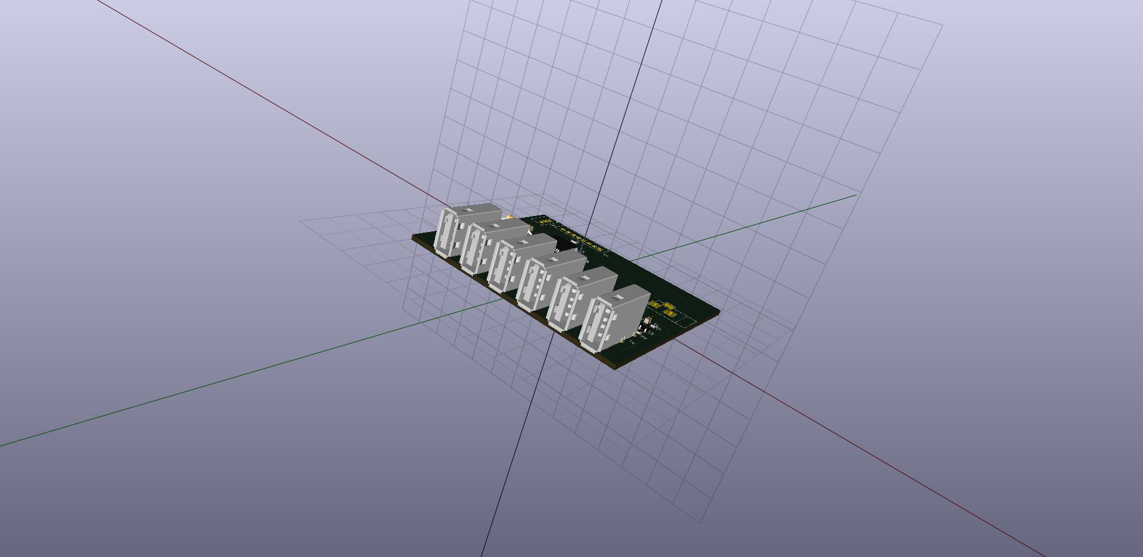
Hardware/6xUSB_PowMet1.jpg
