aleksejm/6xUSB-Power-Meter/Hardware/6xUSB_PowMet.jpg

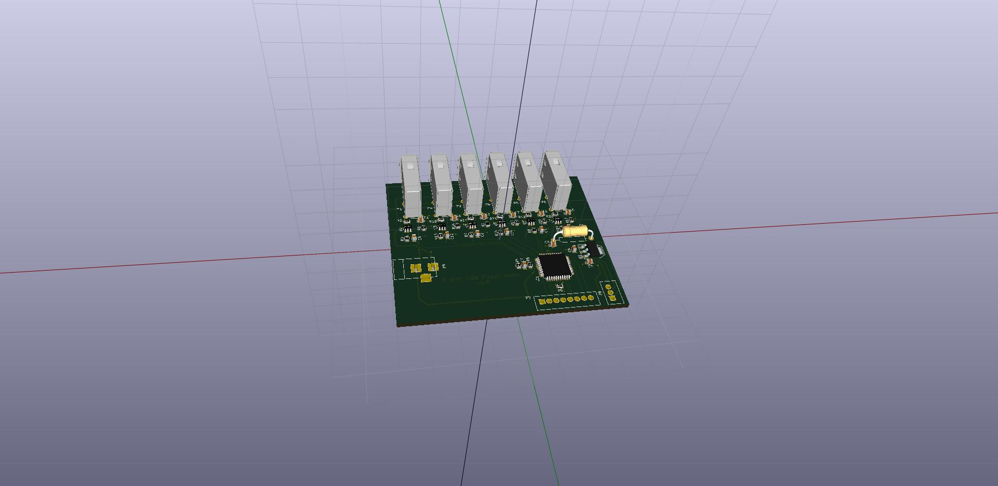
Hardware/6xUSB_PowMet.jpg
