aleksejm/6xUSB-Power-Meter/Hardware/6xUSB_PowMet_Blynk.jpg

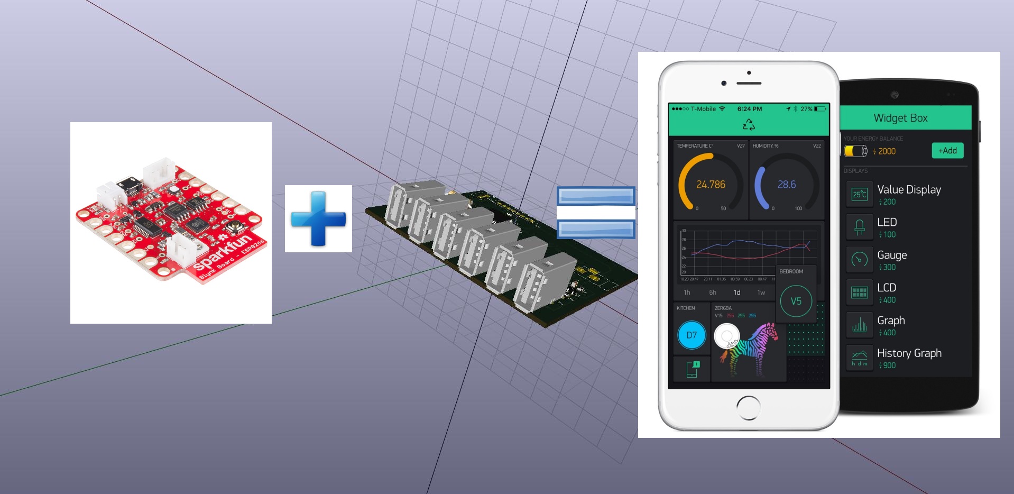
Hardware/6xUSB_PowMet_Blynk.jpg
