aleksejm/6xUSB-Power-Meter/Hardware/AoXUAwj.png

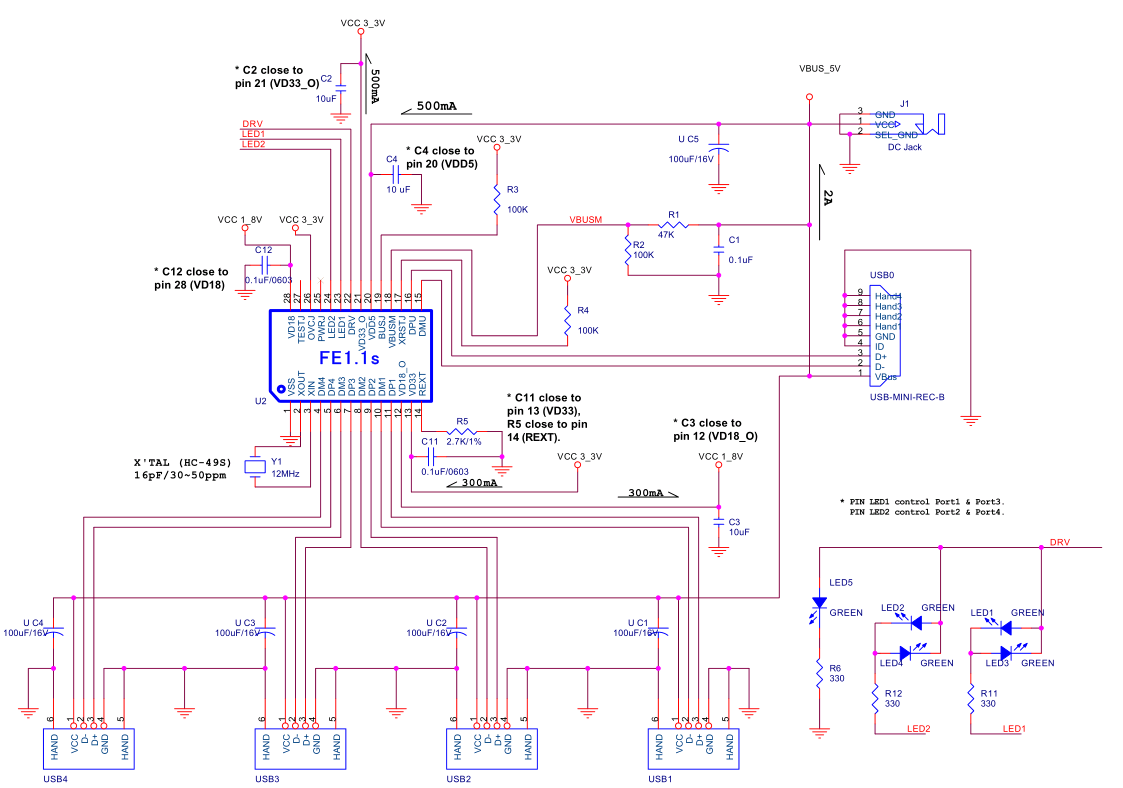
Hardware/AoXUAwj.png
