aleksejm/6xUSB-Power-Meter/Hardware/atmega32.png

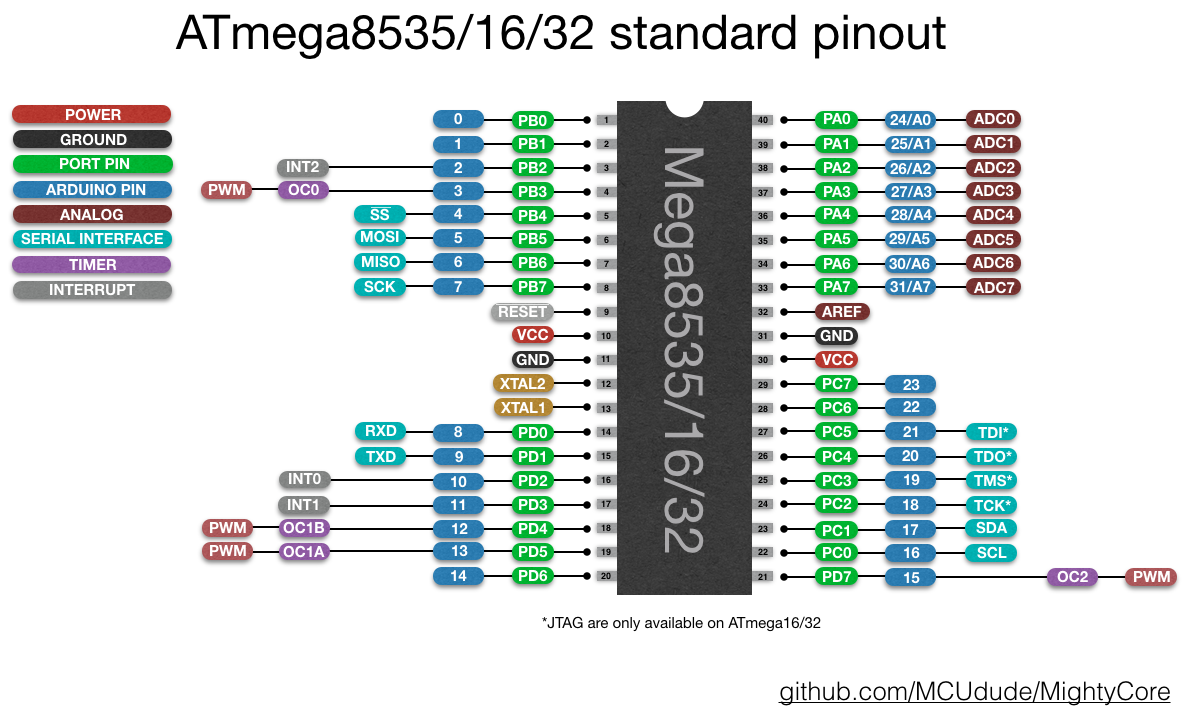
Hardware/atmega32.png
