aleksejm/6xUSB-Power-Meter/Hardware/fe1.1s_schematic_files/gf2_270x185.jpg

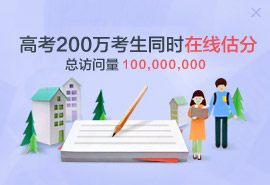
Hardware/fe1.1s_schematic_files/gf2_270x185.jpg
