aleksejm/6xUSB-Power-Meter/Hardware/view.jpg

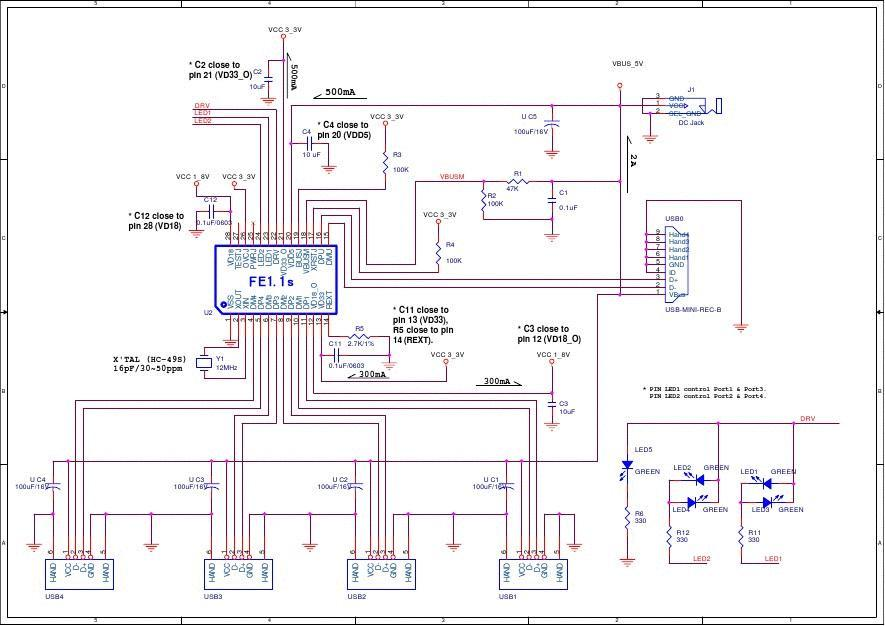
Hardware/view.jpg
