aleksejm/6xUSB-Power-Meter/LCD_Shield_3Dpcb.JPG

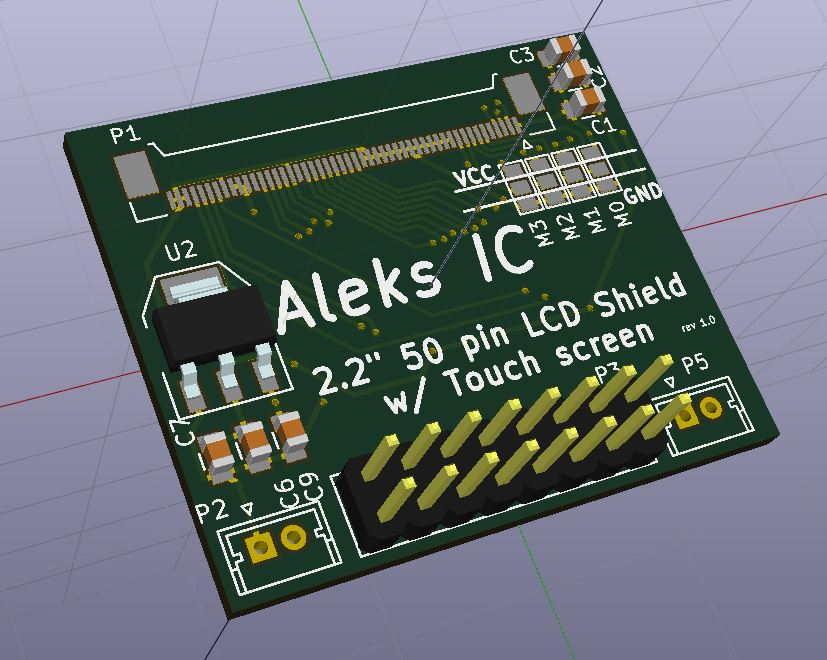
LCD_Shield_3Dpcb.JPG
