aleksejm/6xUSB-Power-Meter/LCD_Shield_pcb.JPG

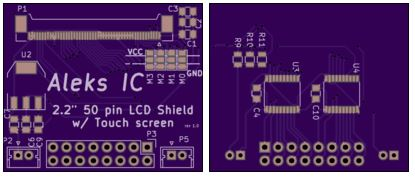
LCD_Shield_pcb.JPG
