aleksejm/6xUSB-Power-Meter/pcb.jpg

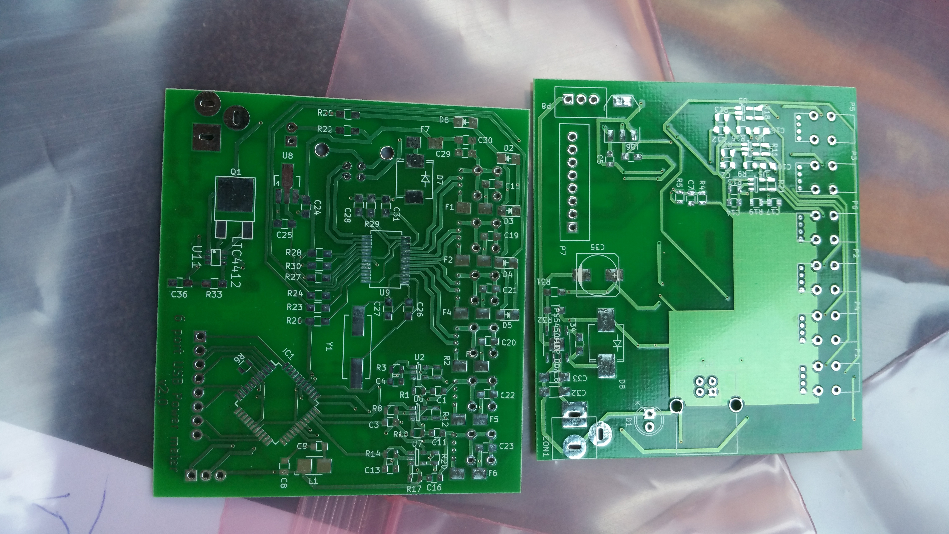
pcb.jpg
