aleksejm/6xUSB-Power-Meter/Schematic1.JPG

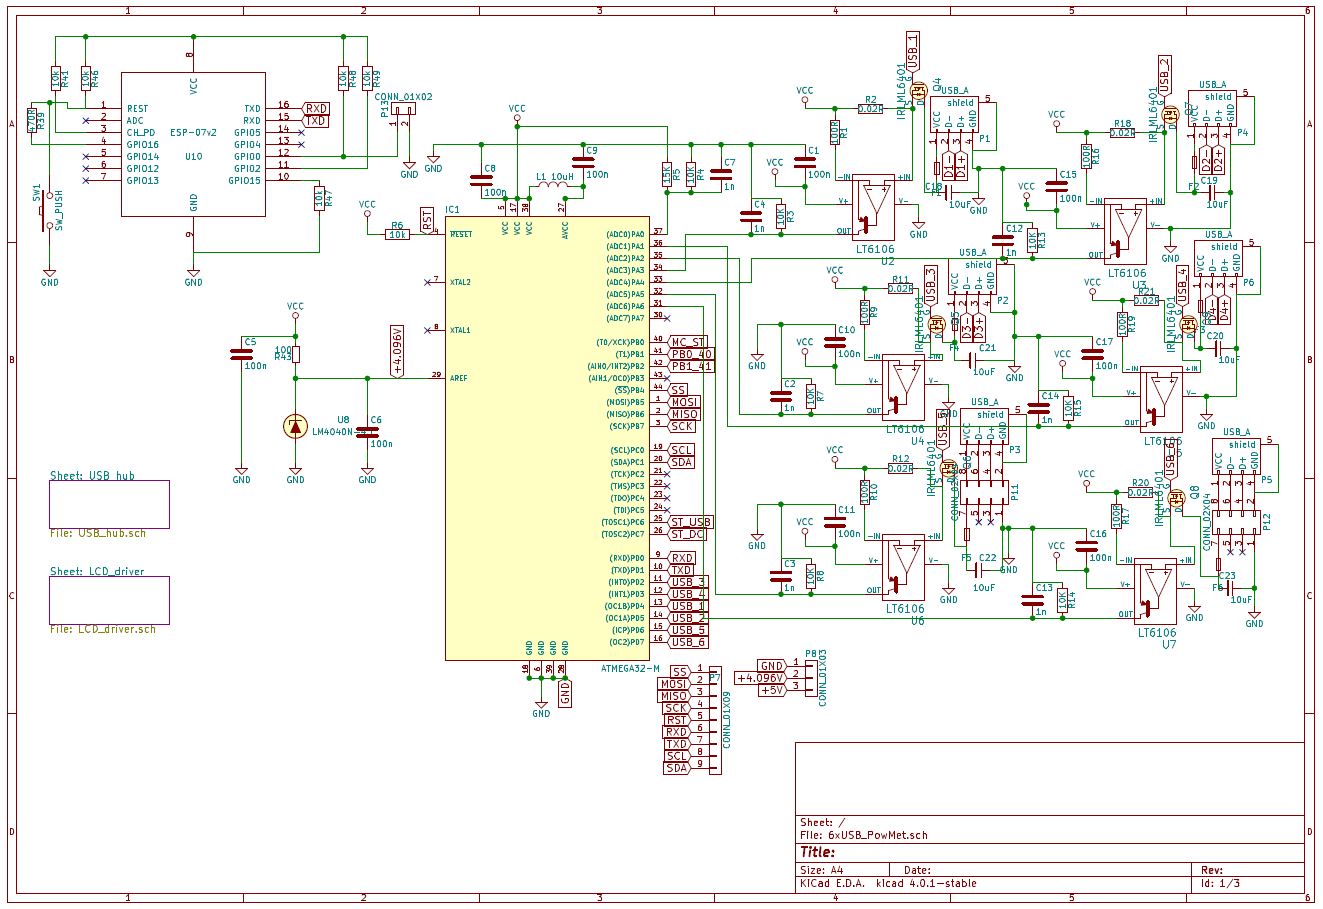
Schematic1.JPG
