aleksejm/6xUSB-Power-Meter/Schematic2.JPG

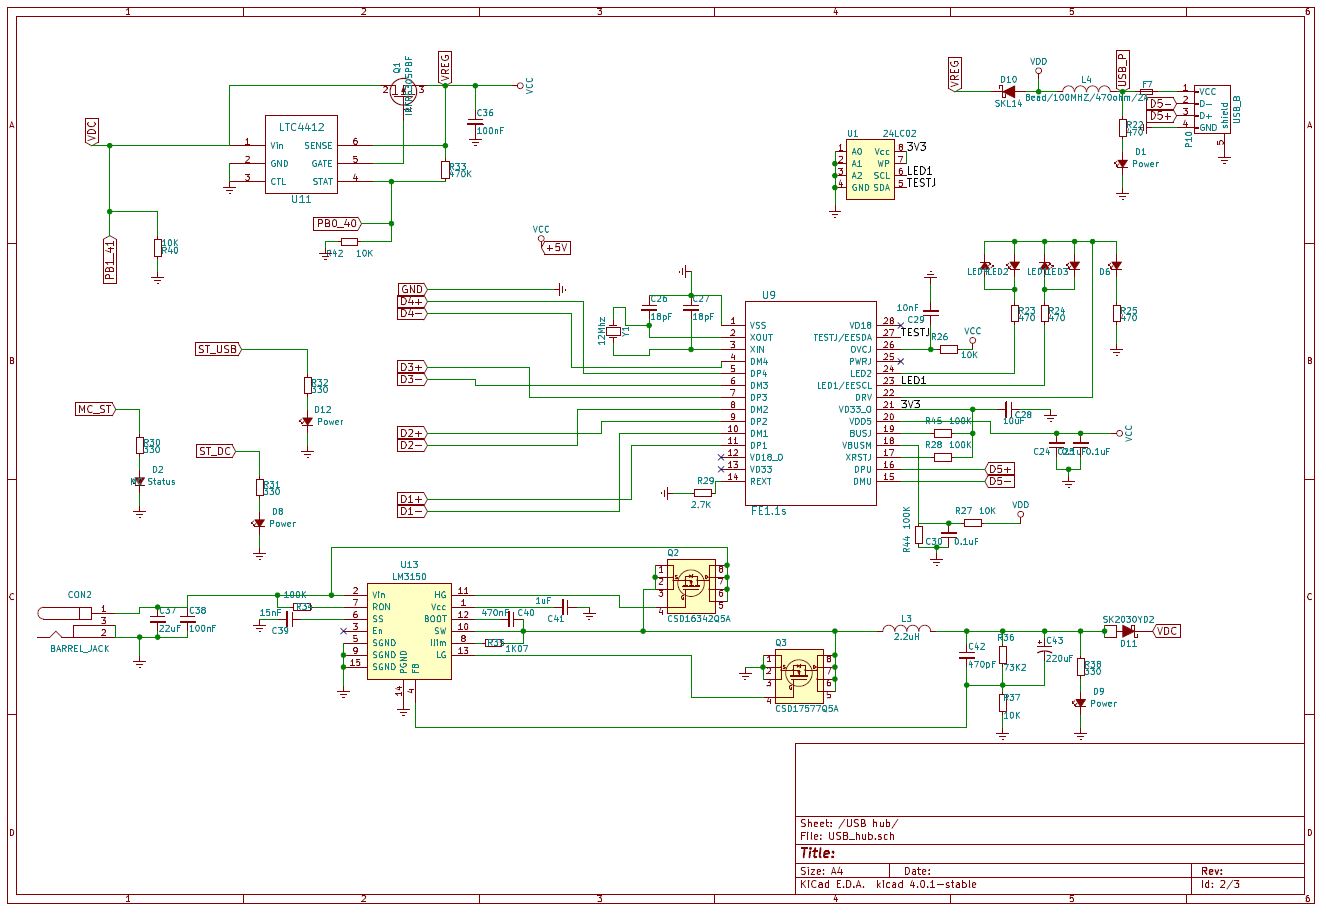
Schematic2.JPG
