aleksejm/6xUSB-Power-Meter/USB power table.png

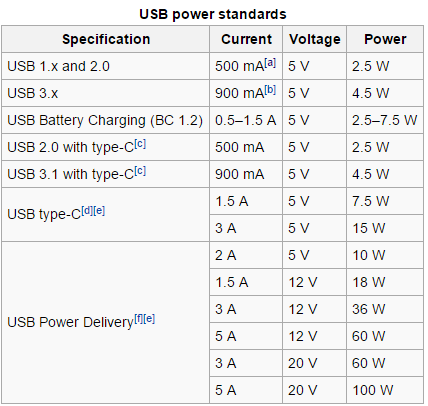
USB power table.png
