aleksejm/6xUSB-Power-Meter/USB_Protection+IV.JPG

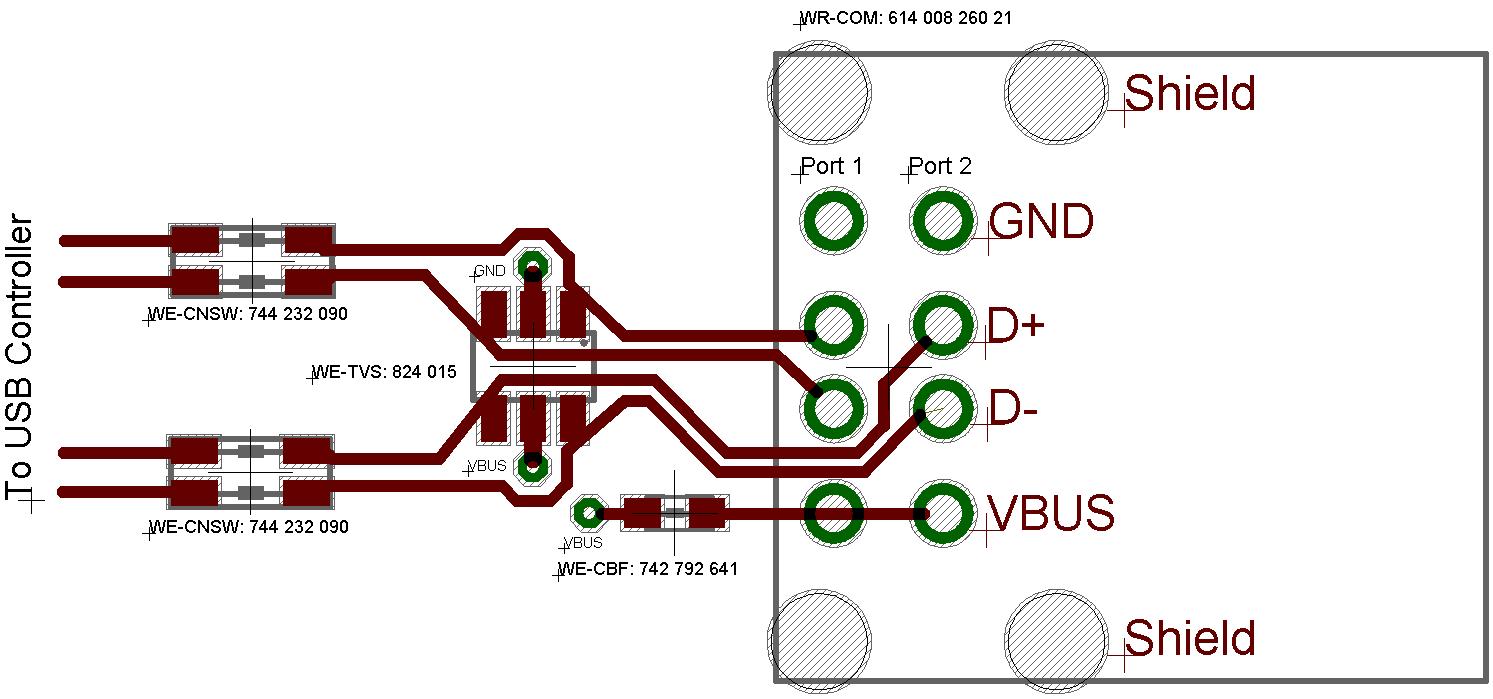
USB_Protection+IV.JPG
