aleksejm/6xUSB-Power-Meter/working.jpg

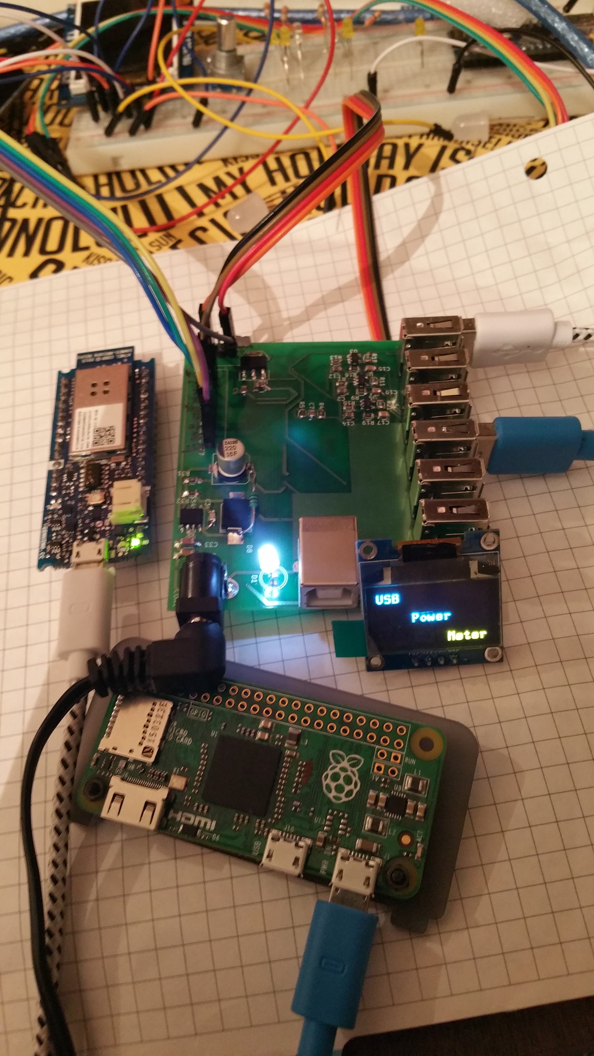
working.jpg
