aleksejm/6xUSB-Power-Meter/6xUSB_Pow_Met_BOM.xlsx

Sheet: Sheet1
version | source | date | tool | number | name | tstamps | title | company | rev | date2 | source3 | number4 | value | ref | value5 | footprint | lib | part | names | tstamps6 | tstamp | datasheet | field | name7 | lib8 | part9 | field10 | name11 | num | name12 | type | description | docs | fp | alias | logical | uri | code | name13 | ref14 | pin
D | M:/Personal/GitHub/6xUSB-Power-Meter/Hardware/PCB/6xUSB_PowMet.sch | 11.07.2016 11:37:07 | Eeschema 4.0.1-stable | 1 | / | / |  |  |  |  | 6xUSB_PowMet.sch | 1
D | M:/Personal/GitHub/6xUSB-Power-Meter/Hardware/PCB/6xUSB_PowMet.sch | 11.07.2016 11:37:07 | Eeschema 4.0.1-stable | 1 | / | / |  |  |  |  | 6xUSB_PowMet.sch | 2
D | M:/Personal/GitHub/6xUSB-Power-Meter/Hardware/PCB/6xUSB_PowMet.sch | 11.07.2016 11:37:07 | Eeschema 4.0.1-stable | 1 | / | / |  |  |  |  | 6xUSB_PowMet.sch | 3
D | M:/Personal/GitHub/6xUSB-Power-Meter/Hardware/PCB/6xUSB_PowMet.sch | 11.07.2016 11:37:07 | Eeschema 4.0.1-stable | 1 | / | / |  |  |  |  | 6xUSB_PowMet.sch | 4
D | M:/Personal/GitHub/6xUSB-Power-Meter/Hardware/PCB/6xUSB_PowMet.sch | 11.07.2016 11:37:07 | Eeschema 4.0.1-stable | 2 | /USB hub/ | /571758E7/ |  |  |  |  | USB_hub.sch | 1
D | M:/Personal/GitHub/6xUSB-Power-Meter/Hardware/PCB/6xUSB_PowMet.sch | 11.07.2016 11:37:07 | Eeschema 4.0.1-stable | 2 | /USB hub/ | /571758E7/ |  |  |  |  | USB_hub.sch | 2
D | M:/Personal/GitHub/6xUSB-Power-Meter/Hardware/PCB/6xUSB_PowMet.sch | 11.07.2016 11:37:07 | Eeschema 4.0.1-stable | 2 | /USB hub/ | /571758E7/ |  |  |  |  | USB_hub.sch | 3
D | M:/Personal/GitHub/6xUSB-Power-Meter/Hardware/PCB/6xUSB_PowMet.sch | 11.07.2016 11:37:07 | Eeschema 4.0.1-stable | 2 | /USB hub/ | /571758E7/ |  |  |  |  | USB_hub.sch | 4
D |  |  |  |  |  |  |  |  |  |  |  |  |  | U2 | LT6106 | TO_SOT_Packages_SMD:SOT-23-5 | 6xUSB_PowMet-cache | LT6106 | / | / | 570E2B6B
D |  |  |  |  |  |  |  |  |  |  |  |  |  | R6 | 10k | Resistors_SMD:R_0805 | device | R | / | / | 570E382E
D |  |  |  |  |  |  |  |  |  |  |  |  |  | C8 | 100n | Capacitors_SMD:C_0805 | device | C | / | / | 570E3C48
D |  |  |  |  |  |  |  |  |  |  |  |  |  | C9 | 100n | Capacitors_SMD:C_0805 | device | C | / | / | 570E3CA3
D |  |  |  |  |  |  |  |  |  |  |  |  |  | L1 | 10uH | Inductors:Inductor_1212 | 6xUSB_PowMet-rescue | L-RESCUE-6xUSB_PowMet | / | / | 570E40B6
D |  |  |  |  |  |  |  |  |  |  |  |  |  | R5 | 15K | Resistors_SMD:R_0805 | device | R | / | / | 570E46E8
D |  |  |  |  |  |  |  |  |  |  |  |  |  | R4 | 10K | Resistors_SMD:R_0805 | device | R | / | / | 570E4833
D |  |  |  |  |  |  |  |  |  |  |  |  |  | C7 | 1n | Capacitors_SMD:C_0805 | device | C | / | / | 570E48BE
D |  |  |  |  |  |  |  |  |  |  |  |  |  | C4 | 1n | Capacitors_SMD:C_0805 | device | C | / | / | 570E6D6B
D |  |  |  |  |  |  |  |  |  |  |  |  |  | C1 | 100n | Capacitors_SMD:C_0805 | device | C | / | / | 570E6DE6
D |  |  |  |  |  |  |  |  |  |  |  |  |  | R3 | 10K | Resistors_SMD:R_0805 | device | R | / | / | 570E6E51
D |  |  |  |  |  |  |  |  |  |  |  |  |  | R1 | 100R | Resistors_SMD:R_0805 | device | R | / | / | 570E73AC
D |  |  |  |  |  |  |  |  |  |  |  |  |  | R2 | 0.02R | Resistors_SMD:R_1206 | device | R | / | / | 570E75EB
D |  |  |  |  |  |  |  |  |  |  |  |  |  | U3 | LT6106 | TO_SOT_Packages_SMD:SOT-23-5 | 6xUSB_PowMet-cache | LT6106 | / | / | 570E7C75
D |  |  |  |  |  |  |  |  |  |  |  |  |  | C12 | 1n | Capacitors_SMD:C_0805 | device | C | / | / | 570E7C7B
D |  |  |  |  |  |  |  |  |  |  |  |  |  | C15 | 100n | Capacitors_SMD:C_0805 | device | C | / | / | 570E7C81
D |  |  |  |  |  |  |  |  |  |  |  |  |  | R13 | 10K | Resistors_SMD:R_0805 | device | R | / | / | 570E7C87
D |  |  |  |  |  |  |  |  |  |  |  |  |  | R16 | 100R | Resistors_SMD:R_0805 | device | R | / | / | 570E7C9D
D |  |  |  |  |  |  |  |  |  |  |  |  |  | R18 | 0.02R | Resistors_SMD:R_1206 | device | R | / | / | 570E7CAC
D |  |  |  |  |  |  |  |  |  |  |  |  |  | U4 | LT6106 | TO_SOT_Packages_SMD:SOT-23-5 | 6xUSB_PowMet-cache | LT6106 | / | / | 570EDEC8
D |  |  |  |  |  |  |  |  |  |  |  |  |  | C2 | 1n | Capacitors_SMD:C_0805 | device | C | / | / | 570EDECE
D |  |  |  |  |  |  |  |  |  |  |  |  |  | C10 | 100n | Capacitors_SMD:C_0805 | device | C | / | / | 570EDED4
D |  |  |  |  |  |  |  |  |  |  |  |  |  | R7 | 10K | Resistors_SMD:R_0805 | device | R | / | / | 570EDEDA
D |  |  |  |  |  |  |  |  |  |  |  |  |  | R9 | 100R | Resistors_SMD:R_0805 | device | R | / | / | 570EDEEF
D |  |  |  |  |  |  |  |  |  |  |  |  |  | R11 | 0.02R | Resistors_SMD:R_1206 | device | R | / | / | 570EDEFE | https://www.elfadistrelec.lv/Web/Downloads/_t/ds/erj8cw_eng_tds.pdf?mime=application%2Fpdf | ERJ8CWFR020V | Kod
D |  |  |  |  |  |  |  |  |  |  |  |  |  | U5 | LT6106 | TO_SOT_Packages_SMD:SOT-23-5 | 6xUSB_PowMet-cache | LT6106 | / | / | 570EE251
D |  |  |  |  |  |  |  |  |  |  |  |  |  | C14 | 1n | Capacitors_SMD:C_0805 | device | C | / | / | 570EE257
D |  |  |  |  |  |  |  |  |  |  |  |  |  | C17 | 100n | Capacitors_SMD:C_0805 | device | C | / | / | 570EE25D
D |  |  |  |  |  |  |  |  |  |  |  |  |  | R15 | 10K | Resistors_SMD:R_0805 | device | R | / | / | 570EE263
D |  |  |  |  |  |  |  |  |  |  |  |  |  | R19 | 100R | Resistors_SMD:R_0805 | device | R | / | / | 570EE278
D |  |  |  |  |  |  |  |  |  |  |  |  |  | R21 | 0.02R | Resistors_SMD:R_1206 | device | R | / | / | 570EE287
D |  |  |  |  |  |  |  |  |  |  |  |  |  | U6 | LT6106 | TO_SOT_Packages_SMD:SOT-23-5 | 6xUSB_PowMet-cache | LT6106 | / | / | 570EE6AF
D |  |  |  |  |  |  |  |  |  |  |  |  |  | C3 | 1n | Capacitors_SMD:C_0805 | device | C | / | / | 570EE6B5
D |  |  |  |  |  |  |  |  |  |  |  |  |  | C11 | 100n | Capacitors_SMD:C_0805 | device | C | / | / | 570EE6BB
D |  |  |  |  |  |  |  |  |  |  |  |  |  | R8 | 10K | Resistors_SMD:R_0805 | device | R | / | / | 570EE6C1
D |  |  |  |  |  |  |  |  |  |  |  |  |  | R10 | 100R | Resistors_SMD:R_0805 | device | R | / | / | 570EE6D6
D |  |  |  |  |  |  |  |  |  |  |  |  |  | R12 | 0.02R | Resistors_SMD:R_1206 | device | R | / | / | 570EE6E5
D |  |  |  |  |  |  |  |  |  |  |  |  |  | U7 | LT6106 | TO_SOT_Packages_SMD:SOT-23-5 | 6xUSB_PowMet-cache | LT6106 | / | / | 570EEA1B
D |  |  |  |  |  |  |  |  |  |  |  |  |  | C13 | 1n | Capacitors_SMD:C_0805 | device | C | / | / | 570EEA21
D |  |  |  |  |  |  |  |  |  |  |  |  |  | C16 | 100n | Capacitors_SMD:C_0805 | device | C | / | / | 570EEA27
D |  |  |  |  |  |  |  |  |  |  |  |  |  | R14 | 10K | Resistors_SMD:R_0805 | device | R | / | / | 570EEA2D
D |  |  |  |  |  |  |  |  |  |  |  |  |  | R17 | 100R | Resistors_SMD:R_0805 | device | R | / | / | 570EEA42
D |  |  |  |  |  |  |  |  |  |  |  |  |  | R20 | 0.02R | Resistors_SMD:R_1206 | device | R | / | / | 570EEA51
D |  |  |  |  |  |  |  |  |  |  |  |  |  | P1 | USB_A | USB-A_vertical1:USB_A_Vertical | conn | USB_A | / | / | 5710A0F2
D |  |  |  |  |  |  |  |  |  |  |  |  |  | P4 | USB_A | USB-A_vertical1:USB_A_Vertical | conn | USB_A | / | / | 5710A8AC
D |  |  |  |  |  |  |  |  |  |  |  |  |  | P2 | USB_A | USB-A_vertical1:USB_A_Vertical | conn | USB_A | / | / | 5710A975
D |  |  |  |  |  |  |  |  |  |  |  |  |  | P5 | USB_A | USB-A_vertical1:USB_A_Vertical | conn | USB_A | / | / | 5710B4D7
D |  |  |  |  |  |  |  |  |  |  |  |  |  | P3 | USB_A | USB-A_vertical1:USB_A_Vertical | conn | USB_A | / | / | 5710B5A7
D |  |  |  |  |  |  |  |  |  |  |  |  |  | P6 | USB_A | USB-A_vertical1:USB_A_Vertical | conn | USB_A | / | / | 5710B3D1
D |  |  |  |  |  |  |  |  |  |  |  |  |  | P8 | CONN_01X03 | Connect:Wafer_Vertical10x5.8x7RM2.5-3 | conn | CONN_01X03 | / | / | 571174BB
D |  |  |  |  |  |  |  |  |  |  |  |  |  | F1 | F_Small | Fuse_Holders_and_Fuses:Fuse_SMD1206_HandSoldering | device | F_Small | / | / | 571A9766
D |  |  |  |  |  |  |  |  |  |  |  |  |  | F2 | F_Small | Fuse_Holders_and_Fuses:Fuse_SMD1206_HandSoldering | device | F_Small | / | / | 571ABA94
D |  |  |  |  |  |  |  |  |  |  |  |  |  | F3 | F_Small | Fuse_Holders_and_Fuses:Fuse_SMD1206_HandSoldering | device | F_Small | / | / | 571ABBEE
D |  |  |  |  |  |  |  |  |  |  |  |  |  | F4 | F_Small | Fuse_Holders_and_Fuses:Fuse_SMD1206_HandSoldering | device | F_Small | / | / | 571ABCE5
D |  |  |  |  |  |  |  |  |  |  |  |  |  | F5 | F_Small | Fuse_Holders_and_Fuses:Fuse_SMD1206_HandSoldering | device | F_Small | / | / | 571ABE05
D |  |  |  |  |  |  |  |  |  |  |  |  |  | F6 | F_Small | Fuse_Holders_and_Fuses:Fuse_SMD1206_HandSoldering | device | F_Small | / | / | 571ABEF2
D |  |  |  |  |  |  |  |  |  |  |  |  |  | C18 | 10uF | Capacitors_SMD:C_0805 | device | C_Small | / | / | 571B50F2
D |  |  |  |  |  |  |  |  |  |  |  |  |  | C19 | 10uF | Capacitors_SMD:C_0805 | device | C_Small | / | / | 571B5652
D |  |  |  |  |  |  |  |  |  |  |  |  |  | C20 | 10uF | Capacitors_SMD:C_0805 | device | C_Small | / | / | 571B5934
D |  |  |  |  |  |  |  |  |  |  |  |  |  | C21 | 10uF | Capacitors_SMD:C_0805 | device | C_Small | / | / | 571B5A3D
D |  |  |  |  |  |  |  |  |  |  |  |  |  | C22 | 10uF | Capacitors_SMD:C_0805 | device | C_Small | / | / | 571B5B61
D |  |  |  |  |  |  |  |  |  |  |  |  |  | C23 | 10uF | Capacitors_SMD:C_0805 | device | C_Small | / | / | 571B5C5E
D |  |  |  |  |  |  |  |  |  |  |  |  |  | P7 | CONN_01X06 | Connect:Wafer_Vertical17.5x5.8x7RM2.5-6 | conn | CONN_01X06 | / | / | 57441869
D |  |  |  |  |  |  |  |  |  |  |  |  |  | P9 | CONN_01X03 | Connect:Wafer_Vertical10x5.8x7RM2.5-3 | conn | CONN_01X03 | / | / | 57441936
D |  |  |  |  |  |  |  |  |  |  |  |  |  | R43 | 100 | Resistors_SMD:R_0805 | device | R_Small | / | / | 57618F6B
D |  |  |  |  |  |  |  |  |  |  |  |  |  | U8 | LM4040N-4.1 | TO_SOT_Packages_SMD:SOT-23 | TexasInstruments | LM4040AvvDBZ | / | / | 5767B0E4 |  | IC TI LM4040AvvDBZ | BOM
D |  |  |  |  |  |  |  |  |  |  |  |  |  | C6 | 100n | Capacitors_SMD:C_0805 | device | C | / | / | 5767C2D0
D |  |  |  |  |  |  |  |  |  |  |  |  |  | C5 | 100n | Capacitors_SMD:C_0805 | device | C | / | / | 5767CCA6
D |  |  |  |  |  |  |  |  |  |  |  |  |  | Q4 | IRLML6401 | TO_SOT_Packages_SMD:SOT-23 | transistor | P-CHAN-MOSFET_SOT | / | / | 5774C8A2 | https://www.elfadistrelec.lv/Web/Downloads/1_/en/zmint_RECTIFIER_FET-Trans-IRLML6401_EN.pdf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
D |  |  |  |  |  |  |  |  |  |  |  |  |  | Q7 | IRLML6401 | TO_SOT_Packages_SMD:SOT-23 | transistor | P-CHAN-MOSFET_SOT | / | / | 57755F7C | https://www.elfadistrelec.lv/Web/Downloads/1_/en/zmint_RECTIFIER_FET-Trans-IRLML6401_EN.pdf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
D |  |  |  |  |  |  |  |  |  |  |  |  |  | Q5 | IRLML6401 | TO_SOT_Packages_SMD:SOT-23 | transistor | P-CHAN-MOSFET_SOT | / | / | 577568A4 | https://www.elfadistrelec.lv/Web/Downloads/1_/en/zmint_RECTIFIER_FET-Trans-IRLML6401_EN.pdf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
D |  |  |  |  |  |  |  |  |  |  |  |  |  | Q9 | IRLML6401 | TO_SOT_Packages_SMD:SOT-23 | transistor | P-CHAN-MOSFET_SOT | / | / | 577581AE | https://www.elfadistrelec.lv/Web/Downloads/1_/en/zmint_RECTIFIER_FET-Trans-IRLML6401_EN.pdf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
D |  |  |  |  |  |  |  |  |  |  |  |  |  | Q6 | IRLML6401 | TO_SOT_Packages_SMD:SOT-23 | transistor | P-CHAN-MOSFET_SOT | / | / | 5775AF53 | https://www.elfadistrelec.lv/Web/Downloads/1_/en/zmint_RECTIFIER_FET-Trans-IRLML6401_EN.pdf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
D |  |  |  |  |  |  |  |  |  |  |  |  |  | Q8 | IRLML6401 | TO_SOT_Packages_SMD:SOT-23 | transistor | P-CHAN-MOSFET_SOT | / | / | 5775BC2E | https://www.elfadistrelec.lv/Web/Downloads/1_/en/zmint_RECTIFIER_FET-Trans-IRLML6401_EN.pdf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
D |  |  |  |  |  |  |  |  |  |  |  |  |  | IC1 | ATMEGA32-M | Housings_QFP:TQFP-44_10x10mm_Pitch0.8mm | atmel | ATMEGA32-M | / | / | 570DEDBC
D |  |  |  |  |  |  |  |  |  |  |  |  |  | P11 | CONN_02X04 | Socket_Strips:Socket_Strip_Straight_2x04 | conn | CONN_02X04 | / | / | 577A61C4
D |  |  |  |  |  |  |  |  |  |  |  |  |  | P12 | CONN_02X04 | Socket_Strips:Socket_Strip_Straight_2x04 | conn | CONN_02X04 | / | / | 577A84E6
D |  |  |  |  |  |  |  |  |  |  |  |  |  | U10 | ESP-07v2 | ESP8266:ESP-07v2 | ESP8266 | ESP-07v2 | / | / | 577E5087
D |  |  |  |  |  |  |  |  |  |  |  |  |  | R47 | 10k | Resistors_SMD:R_0805 | device | R | / | / | 577E60F6
D |  |  |  |  |  |  |  |  |  |  |  |  |  | R41 | 10k | Resistors_SMD:R_0805 | device | R | / | / | 577E677D
D |  |  |  |  |  |  |  |  |  |  |  |  |  | R46 | 10k | Resistors_SMD:R_0805 | device | R | / | / | 577E6B97
D |  |  |  |  |  |  |  |  |  |  |  |  |  | R49 | 10k | Resistors_SMD:R_0805 | device | R | / | / | 577E71EB
D |  |  |  |  |  |  |  |  |  |  |  |  |  | R39 | 470R | Resistors_SMD:R_0805 | device | R | / | / | 577E763A
D |  |  |  |  |  |  |  |  |  |  |  |  |  | R48 | 10k | Resistors_SMD:R_0805 | device | R | / | / | 577E7BF2
D |  |  |  |  |  |  |  |  |  |  |  |  |  | P13 | CONN_01X02 | Connectors_Molex:Molex_MicroLatch-53253-0270_02x2.00mm_Straight | conn | CONN_01X02 | / | / | 577E817D
D |  |  |  |  |  |  |  |  |  |  |  |  |  | SW1 | SW_PUSH | Buttons_Switches_SMD:SW_SPST_B3U-1000P | device | SW_PUSH | / | / | 577E8867
D |  |  |  |  |  |  |  |  |  |  |  |  |  | C27 | 18pF | Capacitors_SMD:C_0805 | device | C_Small | /USB hub/ | /571758E7/ | 5717A030
D |  |  |  |  |  |  |  |  |  |  |  |  |  | C26 | 18pF | Capacitors_SMD:C_0805 | device | C_Small | /USB hub/ | /571758E7/ | 5717A070
D |  |  |  |  |  |  |  |  |  |  |  |  |  | Y1 | 12Mhz | Crystals:Crystal_HC49-SD_SMD | device | Crystal_Small | /USB hub/ | /571758E7/ | 5717A09F
D |  |  |  |  |  |  |  |  |  |  |  |  |  | R29 | 2.7K | Resistors_SMD:R_0805 | device | R_Small | /USB hub/ | /571758E7/ | 5718DE22
D |  |  |  |  |  |  |  |  |  |  |  |  |  | R22 | 470 | Resistors_SMD:R_0805 | device | R_Small | /USB hub/ | /571758E7/ | 5718F570
D |  |  |  |  |  |  |  |  |  |  |  |  |  | D1 | Power | LEDs:LED-5MM | device | Led_Small | /USB hub/ | /571758E7/ | 5718F5E1
D |  |  |  |  |  |  |  |  |  |  |  |  |  | R26 | 10K | Resistors_SMD:R_0805 | device | R_Small | /USB hub/ | /571758E7/ | 57190BCF
D |  |  |  |  |  |  |  |  |  |  |  |  |  | R23 | 470 | Resistors_SMD:R_0805 | device | R_Small | /USB hub/ | /571758E7/ | 57194837
D |  |  |  |  |  |  |  |  |  |  |  |  |  | LED4 | Led_Small | LEDs:LED_0805 | device | Led_Small | /USB hub/ | /571758E7/ | 57194916
D |  |  |  |  |  |  |  |  |  |  |  |  |  | LED2 | Led_Small | LEDs:LED_0805 | device | Led_Small | /USB hub/ | /571758E7/ | 571949EB
D |  |  |  |  |  |  |  |  |  |  |  |  |  | LED1 | Led_Small | LEDs:LED_0805 | device | Led_Small | /USB hub/ | /571758E7/ | 57194A55
D |  |  |  |  |  |  |  |  |  |  |  |  |  | LED3 | Led_Small | LEDs:LED_0805 | device | Led_Small | /USB hub/ | /571758E7/ | 57194AC4
D |  |  |  |  |  |  |  |  |  |  |  |  |  | R24 | 470 | Resistors_SMD:R_0805 | device | R_Small | /USB hub/ | /571758E7/ | 57195054
D |  |  |  |  |  |  |  |  |  |  |  |  |  | D6 | Led_Small | LEDs:LED_0805 | device | Led_Small | /USB hub/ | /571758E7/ | 57197C06
D |  |  |  |  |  |  |  |  |  |  |  |  |  | R25 | 470 | Resistors_SMD:R_0805 | device | R_Small | /USB hub/ | /571758E7/ | 57197CF7
D |  |  |  |  |  |  |  |  |  |  |  |  |  | C28 | 10uF | Capacitors_SMD:C_0805 | device | C_Small | /USB hub/ | /571758E7/ | 571991D3
D |  |  |  |  |  |  |  |  |  |  |  |  |  | R27 | 10K | Resistors_SMD:R_0805 | device | R_Small | /USB hub/ | /571758E7/ | 5719A40D
D |  |  |  |  |  |  |  |  |  |  |  |  |  | R28 | 100K | Resistors_SMD:R_0805 | device | R_Small | /USB hub/ | /571758E7/ | 5719A4AA
D |  |  |  |  |  |  |  |  |  |  |  |  |  | F7 | 500mA | Fuse_Holders_and_Fuses:Fuse_SMD1206_HandSoldering | device | F_Small | /USB hub/ | /571758E7/ | 5719B8C4
D |  |  |  |  |  |  |  |  |  |  |  |  |  | P10 | USB_B | Connect:USB_B | conn | USB_B | /USB hub/ | /571758E7/ | 572B35D9
D |  |  |  |  |  |  |  |  |  |  |  |  |  | U11 | LTC4412 | tom_kicad_lib:SOT-6 | 6xUSB_PowMet-cache | LTC4412 | /USB hub/ | /571758E7/ | 57343D46
D |  |  |  |  |  |  |  |  |  |  |  |  |  | Q1 | IRFR5305PBF | TO_SOT_Packages_SMD1:TO-252-2Lead | device | Q_PMOS_GDS | /USB hub/ | /571758E7/ | 57344130
D |  |  |  |  |  |  |  |  |  |  |  |  |  | C36 | 100nF | Capacitors_SMD:C_0805 | device | C_Small | /USB hub/ | /571758E7/ | 5734496A
D |  |  |  |  |  |  |  |  |  |  |  |  |  | R33 | 470K | Resistors_SMD:R_0805 | device | R_Small | /USB hub/ | /571758E7/ | 57344D56
D |  |  |  |  |  |  |  |  |  |  |  |  |  | CON2 | BARREL_JACK | Connect:JACK_ALIM | conn | BARREL_JACK | /USB hub/ | /571758E7/ | 574EA023
D |  |  |  |  |  |  |  |  |  |  |  |  |  | C37 | 22uF | Capacitors_SMD:C_1206 | device | C_Small | /USB hub/ | /571758E7/ | 574EA059
D |  |  |  |  |  |  |  |  |  |  |  |  |  | C38 | 100nF | Capacitors_SMD:C_0805 | device | C_Small | /USB hub/ | /571758E7/ | 574EA738
D |  |  |  |  |  |  |  |  |  |  |  |  |  | U13 | LM3150 | Housings_SSOP:SSOP-14_5.3x6.2mm_Pitch0.65mm | TexasInstruments | LM3150 | /USB hub/ | /571758E7/ | 574EA9D7 | http://www.ti.com/lit/ds/symlink/lm3150.pdf
D |  |  |  |  |  |  |  |  |  |  |  |  |  | R34 | 100K | Resistors_SMD:R_0805 | device | R_Small | /USB hub/ | /571758E7/ | 574EACE8
D |  |  |  |  |  |  |  |  |  |  |  |  |  | C39 | 15nF | Capacitors_SMD:C_0805 | device | C_Small | /USB hub/ | /571758E7/ | 574EB129
D |  |  |  |  |  |  |  |  |  |  |  |  |  | C41 | 1uF | Capacitors_SMD:C_0805 | device | C_Small | /USB hub/ | /571758E7/ | 574EBFCD
D |  |  |  |  |  |  |  |  |  |  |  |  |  | C40 | 470nF | Capacitors_SMD:C_0805 | device | C_Small | /USB hub/ | /571758E7/ | 574EC410
D |  |  |  |  |  |  |  |  |  |  |  |  |  | R35 | 1K07 | Resistors_SMD:R_0805 | device | R_Small | /USB hub/ | /571758E7/ | 574EC696
D |  |  |  |  |  |  |  |  |  |  |  |  |  | Q2 | CSD16342Q5A | Personal:AB2_SON5x6_FET | transistors | IRF7607PBF | /USB hub/ | /571758E7/ | 574ED3DE
D |  |  |  |  |  |  |  |  |  |  |  |  |  | Q3 | CSD17577Q5A | Personal:AB2_SON5x6_FET | transistors | IRF7607PBF | /USB hub/ | /571758E7/ | 574EE57F
D |  |  |  |  |  |  |  |  |  |  |  |  |  | L3 | 2.2uH | Inductors:SELF-WE-PD-XXL | device | INDUCTOR_SMALL | /USB hub/ | /571758E7/ | 574EF69D
D |  |  |  |  |  |  |  |  |  |  |  |  |  | C42 | 470pF | Capacitors_SMD:C_0805 | device | C_Small | /USB hub/ | /571758E7/ | 574EF8F2
D |  |  |  |  |  |  |  |  |  |  |  |  |  | R36 | 73K2 | Resistors_SMD:R_0805 | device | R_Small | /USB hub/ | /571758E7/ | 574EFCDD
D |  |  |  |  |  |  |  |  |  |  |  |  |  | R37 | 10K | Resistors_SMD:R_0805 | device | R_Small | /USB hub/ | /571758E7/ | 574F00A4
D |  |  |  |  |  |  |  |  |  |  |  |  |  | C43 | 220uF | Capacitors_SMD:c_elec_6.3x7.7 | device | CP1_Small | /USB hub/ | /571758E7/ | 574F07DD
D |  |  |  |  |  |  |  |  |  |  |  |  |  | D10 | SKL14 | Diodes_SMD:SOD-123 | device | D_Schottky | /USB hub/ | /571758E7/ | 574F61B3 |  | Schottky diode 1 A 40 V | Поле4
D |  |  |  |  |  |  |  |  |  |  |  |  |  | D11 | SK2030YD2 | Diodes_SMD:DD-PAK_TO263_DualDiode | device | SCHDPAK | /USB hub/ | /571758E7/ | 574F72ED
D |  |  |  |  |  |  |  |  |  |  |  |  |  | R38 | 330 | Resistors_SMD:R_0805 | device | R_Small | /USB hub/ | /571758E7/ | 574F8E31
D |  |  |  |  |  |  |  |  |  |  |  |  |  | D9 | Power | LEDs:LED-5MM | device | Led_Small | /USB hub/ | /571758E7/ | 574F8E37
D |  |  |  |  |  |  |  |  |  |  |  |  |  | R31 | 330 | Resistors_SMD:R_0805 | device | R_Small | /USB hub/ | /571758E7/ | 574FA36F
D |  |  |  |  |  |  |  |  |  |  |  |  |  | D8 | Power | LEDs:LED-5MM | device | Led_Small | /USB hub/ | /571758E7/ | 574FA375
D |  |  |  |  |  |  |  |  |  |  |  |  |  | R32 | 330 | Resistors_SMD:R_0805 | device | R_Small | /USB hub/ | /571758E7/ | 574FA454
D |  |  |  |  |  |  |  |  |  |  |  |  |  | D12 | Power | LEDs:LED-5MM | device | Led_Small | /USB hub/ | /571758E7/ | 574FA45A
D |  |  |  |  |  |  |  |  |  |  |  |  |  | R40 | 10K | Resistors_SMD:R_0805 | device | R_Small | /USB hub/ | /571758E7/ | 5757E462
D |  |  |  |  |  |  |  |  |  |  |  |  |  | R42 | 10K | Resistors_SMD:R_0805 | device | R_Small | /USB hub/ | /571758E7/ | 5757F961
D |  |  |  |  |  |  |  |  |  |  |  |  |  | U9 | FE1.1s | Housings_SSOP:TSSOP-28_4.4x9.7mm_Pitch0.65mm | 6xUSB_PowMet-cache | FE1.1s | /USB hub/ | /571758E7/ | 57179F33
D |  |  |  |  |  |  |  |  |  |  |  |  |  | R44 | 100K | Resistors_SMD:R_0805 | device | R_Small | /USB hub/ | /571758E7/ | 5762AED3
D |  |  |  |  |  |  |  |  |  |  |  |  |  | C30 | 0.1uF | Capacitors_SMD:C_0603 | device | C_Small | /USB hub/ | /571758E7/ | 5762AFA2
D |  |  |  |  |  |  |  |  |  |  |  |  |  | R45 | 100K | Resistors_SMD:R_0805 | device | R_Small | /USB hub/ | /571758E7/ | 5762BA86
D |  |  |  |  |  |  |  |  |  |  |  |  |  | C29 | 10nF | Capacitors_SMD:C_0805 | device | C_Small | /USB hub/ | /571758E7/ | 5762C62B
D |  |  |  |  |  |  |  |  |  |  |  |  |  | U1 | 24LC02 | Housings_SOIC:SOIC-8_3.9x4.9mm_Pitch1.27mm | 6xUSB_PowMet-cache | 24LC02 | /USB hub/ | /571758E7/ | 5762D4C9
D |  |  |  |  |  |  |  |  |  |  |  |  |  | L4 | Bead/100MHZ/470ohm/2A | Resistors_SMD:R_0805_HandSoldering | device | INDUCTOR_SMALL | /USB hub/ | /571758E7/ | 5762F6C7
D |  |  |  |  |  |  |  |  |  |  |  |  |  | C24 | 0.1uF | Capacitors_SMD:C_0603 | device | C_Small | /USB hub/ | /571758E7/ | 5768147B
D |  |  |  |  |  |  |  |  |  |  |  |  |  | C25 | 0.1uF | Capacitors_SMD:C_0603 | device | C_Small | /USB hub/ | /571758E7/ | 5768156F
D |  |  |  |  |  |  |  |  |  |  |  |  |  | R30 | 330 | Resistors_SMD:R_0805 | device | R_Small | /USB hub/ | /571758E7/ | 577C94E0
D |  |  |  |  |  |  |  |  |  |  |  |  |  | D2 | MC Status | LEDs:LED_0603 | device | Led_Small | /USB hub/ | /571758E7/ | 577C94E6
D |  |  |  |  |  |  |  |  |  |  |  |  |  |  |  |  |  |  |  |  |  |  |  |  | 6xUSB_PowMet-cache | 24LC02 | U | Reference
D |  |  |  |  |  |  |  |  |  |  |  |  |  |  |  |  |  |  |  |  |  |  |  |  | 6xUSB_PowMet-cache | 24LC02 | 24LC02 | Value
D |  |  |  |  |  |  |  |  |  |  |  |  |  |  |  |  |  |  |  |  |  |  |  |  | 6xUSB_PowMet-cache | 24LC02 |  |  | 1 | A0 | input
D |  |  |  |  |  |  |  |  |  |  |  |  |  |  |  |  |  |  |  |  |  |  |  |  | 6xUSB_PowMet-cache | 24LC02 |  |  | 2 | A1 | input
D |  |  |  |  |  |  |  |  |  |  |  |  |  |  |  |  |  |  |  |  |  |  |  |  | 6xUSB_PowMet-cache | 24LC02 |  |  | 3 | A2 | input
D |  |  |  |  |  |  |  |  |  |  |  |  |  |  |  |  |  |  |  |  |  |  |  |  | 6xUSB_PowMet-cache | 24LC02 |  |  | 4 | GND | power_in
D |  |  |  |  |  |  |  |  |  |  |  |  |  |  |  |  |  |  |  |  |  |  |  |  | 6xUSB_PowMet-cache | 24LC02 |  |  | 5 | SDA | input
D |  |  |  |  |  |  |  |  |  |  |  |  |  |  |  |  |  |  |  |  |  |  |  |  | 6xUSB_PowMet-cache | 24LC02 |  |  | 6 | SCL | input
D |  |  |  |  |  |  |  |  |  |  |  |  |  |  |  |  |  |  |  |  |  |  |  |  | 6xUSB_PowMet-cache | 24LC02 |  |  | 7 | WP | input
D |  |  |  |  |  |  |  |  |  |  |  |  |  |  |  |  |  |  |  |  |  |  |  |  | 6xUSB_PowMet-cache | 24LC02 |  |  | 8 | Vcc | power_in
D |  |  |  |  |  |  |  |  |  |  |  |  |  |  |  |  |  |  |  |  |  |  |  |  | atmel | ATMEGA32-M | IC | Reference |  |  |  | QFN/MLF44, 32k Flash, 2k SRAM, 1k EEPROM, JTAG | http://www.atmel.com/Images/doc2503.pdf
D |  |  |  |  |  |  |  |  |  |  |  |  |  |  |  |  |  |  |  |  |  |  |  |  | atmel | ATMEGA32-M | ATMEGA32-M | Value |  |  |  | QFN/MLF44, 32k Flash, 2k SRAM, 1k EEPROM, JTAG | http://www.atmel.com/Images/doc2503.pdf
D |  |  |  |  |  |  |  |  |  |  |  |  |  |  |  |  |  |  |  |  |  |  |  |  | atmel | ATMEGA32-M | MLF/QFN44 | Footprint |  |  |  | QFN/MLF44, 32k Flash, 2k SRAM, 1k EEPROM, JTAG | http://www.atmel.com/Images/doc2503.pdf
D |  |  |  |  |  |  |  |  |  |  |  |  |  |  |  |  |  |  |  |  |  |  |  |  | atmel | ATMEGA32-M |  |  | 1 | (MOSI)PB5 | BiDi | QFN/MLF44, 32k Flash, 2k SRAM, 1k EEPROM, JTAG | http://www.atmel.com/Images/doc2503.pdf
D |  |  |  |  |  |  |  |  |  |  |  |  |  |  |  |  |  |  |  |  |  |  |  |  | atmel | ATMEGA32-M |  |  | 2 | (MISO)PB6 | BiDi | QFN/MLF44, 32k Flash, 2k SRAM, 1k EEPROM, JTAG | http://www.atmel.com/Images/doc2503.pdf
D |  |  |  |  |  |  |  |  |  |  |  |  |  |  |  |  |  |  |  |  |  |  |  |  | atmel | ATMEGA32-M |  |  | 3 | (SCK)PB7 | BiDi | QFN/MLF44, 32k Flash, 2k SRAM, 1k EEPROM, JTAG | http://www.atmel.com/Images/doc2503.pdf
D |  |  |  |  |  |  |  |  |  |  |  |  |  |  |  |  |  |  |  |  |  |  |  |  | atmel | ATMEGA32-M |  |  | 4 | ~RESET | input | QFN/MLF44, 32k Flash, 2k SRAM, 1k EEPROM, JTAG | http://www.atmel.com/Images/doc2503.pdf
D |  |  |  |  |  |  |  |  |  |  |  |  |  |  |  |  |  |  |  |  |  |  |  |  | atmel | ATMEGA32-M |  |  | 5 | VCC | power_in | QFN/MLF44, 32k Flash, 2k SRAM, 1k EEPROM, JTAG | http://www.atmel.com/Images/doc2503.pdf
D |  |  |  |  |  |  |  |  |  |  |  |  |  |  |  |  |  |  |  |  |  |  |  |  | atmel | ATMEGA32-M |  |  | 6 | GND | power_in | QFN/MLF44, 32k Flash, 2k SRAM, 1k EEPROM, JTAG | http://www.atmel.com/Images/doc2503.pdf
D |  |  |  |  |  |  |  |  |  |  |  |  |  |  |  |  |  |  |  |  |  |  |  |  | atmel | ATMEGA32-M |  |  | 7 | XTAL2 | BiDi | QFN/MLF44, 32k Flash, 2k SRAM, 1k EEPROM, JTAG | http://www.atmel.com/Images/doc2503.pdf
D |  |  |  |  |  |  |  |  |  |  |  |  |  |  |  |  |  |  |  |  |  |  |  |  | atmel | ATMEGA32-M |  |  | 8 | XTAL1 | BiDi | QFN/MLF44, 32k Flash, 2k SRAM, 1k EEPROM, JTAG | http://www.atmel.com/Images/doc2503.pdf
D |  |  |  |  |  |  |  |  |  |  |  |  |  |  |  |  |  |  |  |  |  |  |  |  | atmel | ATMEGA32-M |  |  | 9 | (RXD)PD0 | BiDi | QFN/MLF44, 32k Flash, 2k SRAM, 1k EEPROM, JTAG | http://www.atmel.com/Images/doc2503.pdf
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
D |  |  |  |  |  |  |  |  |  |  |  |  |  |  |  |  |  |  |  |  |  |  |  |  | atmel | ATMEGA32-M |  |  | 42 | (AIN0/INT2)PB2 | BiDi | QFN/MLF44, 32k Flash, 2k SRAM, 1k EEPROM, JTAG | http://www.atmel.com/Images/doc2503.pdf
D |  |  |  |  |  |  |  |  |  |  |  |  |  |  |  |  |  |  |  |  |  |  |  |  | atmel | ATMEGA32-M |  |  | 43 | (AIN1/OC0)PB3 | BiDi | QFN/MLF44, 32k Flash, 2k SRAM, 1k EEPROM, JTAG | http://www.atmel.com/Images/doc2503.pdf
D |  |  |  |  |  |  |  |  |  |  |  |  |  |  |  |  |  |  |  |  |  |  |  |  | atmel | ATMEGA32-M |  |  | 44 | (~SS~)PB4 | BiDi | QFN/MLF44, 32k Flash, 2k SRAM, 1k EEPROM, JTAG | http://www.atmel.com/Images/doc2503.pdf
D |  |  |  |  |  |  |  |  |  |  |  |  |  |  |  |  |  |  |  |  |  |  |  |  | conn | BARREL_JACK | CON | Reference |  |  |  | DC Barrel Jack
D |  |  |  |  |  |  |  |  |  |  |  |  |  |  |  |  |  |  |  |  |  |  |  |  | conn | BARREL_JACK | BARREL_JACK | Value |  |  |  | DC Barrel Jack
D |  |  |  |  |  |  |  |  |  |  |  |  |  |  |  |  |  |  |  |  |  |  |  |  | conn | BARREL_JACK |  |  | 1 | ~ | passive | DC Barrel Jack
D |  |  |  |  |  |  |  |  |  |  |  |  |  |  |  |  |  |  |  |  |  |  |  |  | conn | BARREL_JACK |  |  | 2 | ~ | passive | DC Barrel Jack
D |  |  |  |  |  |  |  |  |  |  |  |  |  |  |  |  |  |  |  |  |  |  |  |  | conn | BARREL_JACK |  |  | 3 | ~ | passive | DC Barrel Jack
D |  |  |  |  |  |  |  |  |  |  |  |  |  |  |  |  |  |  |  |  |  |  |  |  | device | C | C | Reference |  |  |  | Unpolarized capacitor
D |  |  |  |  |  |  |  |  |  |  |  |  |  |  |  |  |  |  |  |  |  |  |  |  | device | C | C | Value |  |  |  | Unpolarized capacitor
D |  |  |  |  |  |  |  |  |  |  |  |  |  |  |  |  |  |  |  |  |  |  |  |  | device | C |  |  | 1 | ~ | passive | Unpolarized capacitor
D |  |  |  |  |  |  |  |  |  |  |  |  |  |  |  |  |  |  |  |  |  |  |  |  | device | C |  |  | 2 | ~ | passive | Unpolarized capacitor
D |  |  |  |  |  |  |  |  |  |  |  |  |  |  |  |  |  |  |  |  |  |  |  |  | device | C |  |  |  |  |  | Unpolarized capacitor |  | C?
D |  |  |  |  |  |  |  |  |  |  |  |  |  |  |  |  |  |  |  |  |  |  |  |  | device | C |  |  |  |  |  | Unpolarized capacitor |  | C_????_*
D |  |  |  |  |  |  |  |  |  |  |  |  |  |  |  |  |  |  |  |  |  |  |  |  | device | C |  |  |  |  |  | Unpolarized capacitor |  | C_????
D |  |  |  |  |  |  |  |  |  |  |  |  |  |  |  |  |  |  |  |  |  |  |  |  | device | C |  |  |  |  |  | Unpolarized capacitor |  | SMD*_c
D |  |  |  |  |  |  |  |  |  |  |  |  |  |  |  |  |  |  |  |  |  |  |  |  | device | C |  |  |  |  |  | Unpolarized capacitor |  | Capacitor*
D |  |  |  |  |  |  |  |  |  |  |  |  |  |  |  |  |  |  |  |  |  |  |  |  | conn | CONN_01X02 | P | Reference |  |  |  | Connector 01x02
D |  |  |  |  |  |  |  |  |  |  |  |  |  |  |  |  |  |  |  |  |  |  |  |  | conn | CONN_01X02 | CONN_01X02 | Value |  |  |  | Connector 01x02
D |  |  |  |  |  |  |  |  |  |  |  |  |  |  |  |  |  |  |  |  |  |  |  |  | conn | CONN_01X02 |  |  | 1 | P1 | passive | Connector 01x02
D |  |  |  |  |  |  |  |  |  |  |  |  |  |  |  |  |  |  |  |  |  |  |  |  | conn | CONN_01X02 |  |  | 2 | P2 | passive | Connector 01x02
D |  |  |  |  |  |  |  |  |  |  |  |  |  |  |  |  |  |  |  |  |  |  |  |  | conn | CONN_01X02 |  |  |  |  |  | Connector 01x02 |  | Pin_Header_Straight_1X02
D |  |  |  |  |  |  |  |  |  |  |  |  |  |  |  |  |  |  |  |  |  |  |  |  | conn | CONN_01X02 |  |  |  |  |  | Connector 01x02 |  | Pin_Header_Angled_1X02
D |  |  |  |  |  |  |  |  |  |  |  |  |  |  |  |  |  |  |  |  |  |  |  |  | conn | CONN_01X02 |  |  |  |  |  | Connector 01x02 |  | Socket_Strip_Straight_1X02
D |  |  |  |  |  |  |  |  |  |  |  |  |  |  |  |  |  |  |  |  |  |  |  |  | conn | CONN_01X02 |  |  |  |  |  | Connector 01x02 |  | Socket_Strip_Angled_1X02
D |  |  |  |  |  |  |  |  |  |  |  |  |  |  |  |  |  |  |  |  |  |  |  |  | conn | CONN_01X03 | P | Reference |  |  |  | Connector 01x03
D |  |  |  |  |  |  |  |  |  |  |  |  |  |  |  |  |  |  |  |  |  |  |  |  | conn | CONN_01X03 | CONN_01X03 | Value |  |  |  | Connector 01x03
D |  |  |  |  |  |  |  |  |  |  |  |  |  |  |  |  |  |  |  |  |  |  |  |  | conn | CONN_01X03 |  |  | 1 | P1 | passive | Connector 01x03
D |  |  |  |  |  |  |  |  |  |  |  |  |  |  |  |  |  |  |  |  |  |  |  |  | conn | CONN_01X03 |  |  | 2 | P2 | passive | Connector 01x03
D |  |  |  |  |  |  |  |  |  |  |  |  |  |  |  |  |  |  |  |  |  |  |  |  | conn | CONN_01X03 |  |  | 3 | P3 | passive | Connector 01x03
D |  |  |  |  |  |  |  |  |  |  |  |  |  |  |  |  |  |  |  |  |  |  |  |  | conn | CONN_01X03 |  |  |  |  |  | Connector 01x03 |  | Pin_Header_Straight_1X03
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
D |  |  |  |  |  |  |  |  |  |  |  |  |  |  |  |  |  |  |  |  |  |  |  |  | device | Crystal_Small | Y | Reference |  |  |  | Two pin crystal
D |  |  |  |  |  |  |  |  |  |  |  |  |  |  |  |  |  |  |  |  |  |  |  |  | device | Crystal_Small | Crystal_Small | Value |  |  |  | Two pin crystal
D |  |  |  |  |  |  |  |  |  |  |  |  |  |  |  |  |  |  |  |  |  |  |  |  | device | Crystal_Small |  |  | 1 | 1 | passive | Two pin crystal
D |  |  |  |  |  |  |  |  |  |  |  |  |  |  |  |  |  |  |  |  |  |  |  |  | device | Crystal_Small |  |  | 2 | 2 | passive | Two pin crystal
D |  |  |  |  |  |  |  |  |  |  |  |  |  |  |  |  |  |  |  |  |  |  |  |  | device | Crystal_Small |  |  |  |  |  | Two pin crystal |  | Crystal_
D |  |  |  |  |  |  |  |  |  |  |  |  |  |  |  |  |  |  |  |  |  |  |  |  | device | D_Schottky | D | Reference |  |  |  | Diode schottky
D |  |  |  |  |  |  |  |  |  |  |  |  |  |  |  |  |  |  |  |  |  |  |  |  | device | D_Schottky | D_Schottky | Value |  |  |  | Diode schottky
D |  |  |  |  |  |  |  |  |  |  |  |  |  |  |  |  |  |  |  |  |  |  |  |  | device | D_Schottky |  |  | 1 | K | passive | Diode schottky
D |  |  |  |  |  |  |  |  |  |  |  |  |  |  |  |  |  |  |  |  |  |  |  |  | device | D_Schottky |  |  | 2 | A | passive | Diode schottky
D |  |  |  |  |  |  |  |  |  |  |  |  |  |  |  |  |  |  |  |  |  |  |  |  | device | D_Schottky |  |  |  |  |  | Diode schottky |  | D-Pak_TO252AA
D |  |  |  |  |  |  |  |  |  |  |  |  |  |  |  |  |  |  |  |  |  |  |  |  | device | D_Schottky |  |  |  |  |  | Diode schottky |  | Diode_*
D |  |  |  |  |  |  |  |  |  |  |  |  |  |  |  |  |  |  |  |  |  |  |  |  | device | D_Schottky |  |  |  |  |  | Diode schottky |  | *SingleDiode
D |  |  |  |  |  |  |  |  |  |  |  |  |  |  |  |  |  |  |  |  |  |  |  |  | device | D_Schottky |  |  |  |  |  | Diode schottky |  | *SingleDiode*
D |  |  |  |  |  |  |  |  |  |  |  |  |  |  |  |  |  |  |  |  |  |  |  |  | device | D_Schottky |  |  |  |  |  | Diode schottky |  | *_Diode_*
D |  |  |  |  |  |  |  |  |  |  |  |  |  |  |  |  |  |  |  |  |  |  |  |  | ESP8266 | ESP-12 | U | Reference |  |  |  | ESP8622 ESP-12 module, 16 pins, 2mm, PCB antenna | http://l0l.org.uk/2014/12/esp8266-modules-hardware-guide-gotta-catch-em-all/ |  | ESP-07v2
D |  |  |  |  |  |  |  |  |  |  |  |  |  |  |  |  |  |  |  |  |  |  |  |  | ESP8266 | ESP-12 | ESP-12 | Value |  |  |  | ESP8622 ESP-12 module, 16 pins, 2mm, PCB antenna | http://l0l.org.uk/2014/12/esp8266-modules-hardware-guide-gotta-catch-em-all/ |  | ESP-07v2
D |  |  |  |  |  |  |  |  |  |  |  |  |  |  |  |  |  |  |  |  |  |  |  |  | ESP8266 | ESP-12 |  |  | 1 | REST | input | ESP8622 ESP-12 module, 16 pins, 2mm, PCB antenna | http://l0l.org.uk/2014/12/esp8266-modules-hardware-guide-gotta-catch-em-all/ |  | ESP-07v2
D |  |  |  |  |  |  |  |  |  |  |  |  |  |  |  |  |  |  |  |  |  |  |  |  | ESP8266 | ESP-12 |  |  | 2 | ADC | passive | ESP8622 ESP-12 module, 16 pins, 2mm, PCB antenna | http://l0l.org.uk/2014/12/esp8266-modules-hardware-guide-gotta-catch-em-all/ |  | ESP-07v2
D |  |  |  |  |  |  |  |  |  |  |  |  |  |  |  |  |  |  |  |  |  |  |  |  | ESP8266 | ESP-12 |  |  | 3 | CH_PD | input | ESP8622 ESP-12 module, 16 pins, 2mm, PCB antenna | http://l0l.org.uk/2014/12/esp8266-modules-hardware-guide-gotta-catch-em-all/ |  | ESP-07v2
D |  |  |  |  |  |  |  |  |  |  |  |  |  |  |  |  |  |  |  |  |  |  |  |  | ESP8266 | ESP-12 |  |  | 4 | GPIO16 | BiDi | ESP8622 ESP-12 module, 16 pins, 2mm, PCB antenna | http://l0l.org.uk/2014/12/esp8266-modules-hardware-guide-gotta-catch-em-all/ |  | ESP-07v2
D |  |  |  |  |  |  |  |  |  |  |  |  |  |  |  |  |  |  |  |  |  |  |  |  | ESP8266 | ESP-12 |  |  | 5 | GPIO14 | BiDi | ESP8622 ESP-12 module, 16 pins, 2mm, PCB antenna | http://l0l.org.uk/2014/12/esp8266-modules-hardware-guide-gotta-catch-em-all/ |  | ESP-07v2
D |  |  |  |  |  |  |  |  |  |  |  |  |  |  |  |  |  |  |  |  |  |  |  |  | ESP8266 | ESP-12 |  |  | 6 | GPIO12 | BiDi | ESP8622 ESP-12 module, 16 pins, 2mm, PCB antenna | http://l0l.org.uk/2014/12/esp8266-modules-hardware-guide-gotta-catch-em-all/ |  | ESP-07v2
D |  |  |  |  |  |  |  |  |  |  |  |  |  |  |  |  |  |  |  |  |  |  |  |  | ESP8266 | ESP-12 |  |  | 7 | GPIO13 | BiDi | ESP8622 ESP-12 module, 16 pins, 2mm, PCB antenna | http://l0l.org.uk/2014/12/esp8266-modules-hardware-guide-gotta-catch-em-all/ |  | ESP-07v2
D |  |  |  |  |  |  |  |  |  |  |  |  |  |  |  |  |  |  |  |  |  |  |  |  | ESP8266 | ESP-12 |  |  | 8 | VCC | power_in | ESP8622 ESP-12 module, 16 pins, 2mm, PCB antenna | http://l0l.org.uk/2014/12/esp8266-modules-hardware-guide-gotta-catch-em-all/ |  | ESP-07v2
D |  |  |  |  |  |  |  |  |  |  |  |  |  |  |  |  |  |  |  |  |  |  |  |  | ESP8266 | ESP-12 |  |  | 9 | GND | power_in | ESP8622 ESP-12 module, 16 pins, 2mm, PCB antenna | http://l0l.org.uk/2014/12/esp8266-modules-hardware-guide-gotta-catch-em-all/ |  | ESP-07v2
D |  |  |  |  |  |  |  |  |  |  |  |  |  |  |  |  |  |  |  |  |  |  |  |  | ESP8266 | ESP-12 |  |  | 10 | GPIO15 | BiDi | ESP8622 ESP-12 module, 16 pins, 2mm, PCB antenna | http://l0l.org.uk/2014/12/esp8266-modules-hardware-guide-gotta-catch-em-all/ |  | ESP-07v2
D |  |  |  |  |  |  |  |  |  |  |  |  |  |  |  |  |  |  |  |  |  |  |  |  | ESP8266 | ESP-12 |  |  | 11 | GPIO2 | BiDi | ESP8622 ESP-12 module, 16 pins, 2mm, PCB antenna | http://l0l.org.uk/2014/12/esp8266-modules-hardware-guide-gotta-catch-em-all/ |  | ESP-07v2
D |  |  |  |  |  |  |  |  |  |  |  |  |  |  |  |  |  |  |  |  |  |  |  |  | ESP8266 | ESP-12 |  |  | 12 | GPIO0 | BiDi | ESP8622 ESP-12 module, 16 pins, 2mm, PCB antenna | http://l0l.org.uk/2014/12/esp8266-modules-hardware-guide-gotta-catch-em-all/ |  | ESP-07v2
D |  |  |  |  |  |  |  |  |  |  |  |  |  |  |  |  |  |  |  |  |  |  |  |  | ESP8266 | ESP-12 |  |  | 13 | GPIO4 | BiDi | ESP8622 ESP-12 module, 16 pins, 2mm, PCB antenna | http://l0l.org.uk/2014/12/esp8266-modules-hardware-guide-gotta-catch-em-all/ |  | ESP-07v2
D |  |  |  |  |  |  |  |  |  |  |  |  |  |  |  |  |  |  |  |  |  |  |  |  | ESP8266 | ESP-12 |  |  | 14 | GPIO5 | BiDi | ESP8622 ESP-12 module, 16 pins, 2mm, PCB antenna | http://l0l.org.uk/2014/12/esp8266-modules-hardware-guide-gotta-catch-em-all/ |  | ESP-07v2
D |  |  |  |  |  |  |  |  |  |  |  |  |  |  |  |  |  |  |  |  |  |  |  |  | ESP8266 | ESP-12 |  |  | 15 | RXD | input | ESP8622 ESP-12 module, 16 pins, 2mm, PCB antenna | http://l0l.org.uk/2014/12/esp8266-modules-hardware-guide-gotta-catch-em-all/ |  | ESP-07v2
D |  |  |  |  |  |  |  |  |  |  |  |  |  |  |  |  |  |  |  |  |  |  |  |  | ESP8266 | ESP-12 |  |  | 16 | TXD | output | ESP8622 ESP-12 module, 16 pins, 2mm, PCB antenna | http://l0l.org.uk/2014/12/esp8266-modules-hardware-guide-gotta-catch-em-all/ |  | ESP-07v2
D |  |  |  |  |  |  |  |  |  |  |  |  |  |  |  |  |  |  |  |  |  |  |  |  | ESP8266 | ESP-12 |  |  |  |  |  | ESP8622 ESP-12 module, 16 pins, 2mm, PCB antenna | http://l0l.org.uk/2014/12/esp8266-modules-hardware-guide-gotta-catch-em-all/ | ESP-07* | ESP-07v2
D |  |  |  |  |  |  |  |  |  |  |  |  |  |  |  |  |  |  |  |  |  |  |  |  | ESP8266 | ESP-12 |  |  |  |  |  | ESP8622 ESP-12 module, 16 pins, 2mm, PCB antenna | http://l0l.org.uk/2014/12/esp8266-modules-hardware-guide-gotta-catch-em-all/ | ESP-12* | ESP-07v2
D |  |  |  |  |  |  |  |  |  |  |  |  |  |  |  |  |  |  |  |  |  |  |  |  | 6xUSB_PowMet-cache | FE1.1s | U | Reference
D |  |  |  |  |  |  |  |  |  |  |  |  |  |  |  |  |  |  |  |  |  |  |  |  | 6xUSB_PowMet-cache | FE1.1s | FE1.1s | Value
D |  |  |  |  |  |  |  |  |  |  |  |  |  |  |  |  |  |  |  |  |  |  |  |  | 6xUSB_PowMet-cache | FE1.1s |  |  | 1 | VSS | power_in
D |  |  |  |  |  |  |  |  |  |  |  |  |  |  |  |  |  |  |  |  |  |  |  |  | 6xUSB_PowMet-cache | FE1.1s |  |  | 2 | XOUT | output
D |  |  |  |  |  |  |  |  |  |  |  |  |  |  |  |  |  |  |  |  |  |  |  |  | 6xUSB_PowMet-cache | FE1.1s |  |  | 3 | XIN | input
D |  |  |  |  |  |  |  |  |  |  |  |  |  |  |  |  |  |  |  |  |  |  |  |  | 6xUSB_PowMet-cache | FE1.1s |  |  | 4 | DM4 | BiDi
D |  |  |  |  |  |  |  |  |  |  |  |  |  |  |  |  |  |  |  |  |  |  |  |  | 6xUSB_PowMet-cache | FE1.1s |  |  | 5 | DP4 | BiDi
D |  |  |  |  |  |  |  |  |  |  |  |  |  |  |  |  |  |  |  |  |  |  |  |  | 6xUSB_PowMet-cache | FE1.1s |  |  | 6 | DM3 | BiDi
D |  |  |  |  |  |  |  |  |  |  |  |  |  |  |  |  |  |  |  |  |  |  |  |  | 6xUSB_PowMet-cache | FE1.1s |  |  | 7 | DP3 | BiDi
D |  |  |  |  |  |  |  |  |  |  |  |  |  |  |  |  |  |  |  |  |  |  |  |  | 6xUSB_PowMet-cache | FE1.1s |  |  | 8 | DM2 | BiDi
D |  |  |  |  |  |  |  |  |  |  |  |  |  |  |  |  |  |  |  |  |  |  |  |  | 6xUSB_PowMet-cache | FE1.1s |  |  | 9 | DP2 | BiDi
D |  |  |  |  |  |  |  |  |  |  |  |  |  |  |  |  |  |  |  |  |  |  |  |  | 6xUSB_PowMet-cache | FE1.1s |  |  | 10 | DM1 | BiDi
D |  |  |  |  |  |  |  |  |  |  |  |  |  |  |  |  |  |  |  |  |  |  |  |  | 6xUSB_PowMet-cache | FE1.1s |  |  | 11 | DP1 | BiDi
D |  |  |  |  |  |  |  |  |  |  |  |  |  |  |  |  |  |  |  |  |  |  |  |  | 6xUSB_PowMet-cache | FE1.1s |  |  | 12 | VD18_O | power_out
D |  |  |  |  |  |  |  |  |  |  |  |  |  |  |  |  |  |  |  |  |  |  |  |  | 6xUSB_PowMet-cache | FE1.1s |  |  | 13 | VD33 | power_in
D |  |  |  |  |  |  |  |  |  |  |  |  |  |  |  |  |  |  |  |  |  |  |  |  | 6xUSB_PowMet-cache | FE1.1s |  |  | 14 | REXT | unspc
D |  |  |  |  |  |  |  |  |  |  |  |  |  |  |  |  |  |  |  |  |  |  |  |  | 6xUSB_PowMet-cache | FE1.1s |  |  | 15 | DMU | BiDi
D |  |  |  |  |  |  |  |  |  |  |  |  |  |  |  |  |  |  |  |  |  |  |  |  | 6xUSB_PowMet-cache | FE1.1s |  |  | 16 | DPU | BiDi
D |  |  |  |  |  |  |  |  |  |  |  |  |  |  |  |  |  |  |  |  |  |  |  |  | 6xUSB_PowMet-cache | FE1.1s |  |  | 17 | XRSTJ | input
D |  |  |  |  |  |  |  |  |  |  |  |  |  |  |  |  |  |  |  |  |  |  |  |  | 6xUSB_PowMet-cache | FE1.1s |  |  | 18 | VBUSM | input
D |  |  |  |  |  |  |  |  |  |  |  |  |  |  |  |  |  |  |  |  |  |  |  |  | 6xUSB_PowMet-cache | FE1.1s |  |  | 19 | BUSJ | input
D |  |  |  |  |  |  |  |  |  |  |  |  |  |  |  |  |  |  |  |  |  |  |  |  | 6xUSB_PowMet-cache | FE1.1s |  |  | 20 | VDD5 | power_in
D |  |  |  |  |  |  |  |  |  |  |  |  |  |  |  |  |  |  |  |  |  |  |  |  | 6xUSB_PowMet-cache | FE1.1s |  |  | 21 | VD33_O | power_out
D |  |  |  |  |  |  |  |  |  |  |  |  |  |  |  |  |  |  |  |  |  |  |  |  | 6xUSB_PowMet-cache | FE1.1s |  |  | 22 | DRV | BiDi
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
D |  |  |  |  |  |  |  |  |  |  |  |  |  |  |  |  |  |  |  |  |  |  |  |  | transistors | IRF7607PBF |  |  | 6 | D | passive | HexFET N-MOS Power Mosfet, Vds 20V, Rdson 0.03R, Id 5.2A, Micro8 | http://www.irf.com/product-info/datasheets/data/irf7607pbf.pdf
D |  |  |  |  |  |  |  |  |  |  |  |  |  |  |  |  |  |  |  |  |  |  |  |  | transistors | IRF7607PBF |  |  | 7 | D | passive | HexFET N-MOS Power Mosfet, Vds 20V, Rdson 0.03R, Id 5.2A, Micro8 | http://www.irf.com/product-info/datasheets/data/irf7607pbf.pdf
D |  |  |  |  |  |  |  |  |  |  |  |  |  |  |  |  |  |  |  |  |  |  |  |  | transistors | IRF7607PBF |  |  | 8 | D | passive | HexFET N-MOS Power Mosfet, Vds 20V, Rdson 0.03R, Id 5.2A, Micro8 | http://www.irf.com/product-info/datasheets/data/irf7607pbf.pdf
D |  |  |  |  |  |  |  |  |  |  |  |  |  |  |  |  |  |  |  |  |  |  |  |  | 6xUSB_PowMet-rescue | L-RESCUE-6xUSB_PowMet | L | Reference
D |  |  |  |  |  |  |  |  |  |  |  |  |  |  |  |  |  |  |  |  |  |  |  |  | 6xUSB_PowMet-rescue | L-RESCUE-6xUSB_PowMet | L-RESCUE-6xUSB_PowMet | Value
D |  |  |  |  |  |  |  |  |  |  |  |  |  |  |  |  |  |  |  |  |  |  |  |  | 6xUSB_PowMet-rescue | L-RESCUE-6xUSB_PowMet |  |  | 1 | ~ | passive
D |  |  |  |  |  |  |  |  |  |  |  |  |  |  |  |  |  |  |  |  |  |  |  |  | 6xUSB_PowMet-rescue | L-RESCUE-6xUSB_PowMet |  |  | 2 | ~ | passive
D |  |  |  |  |  |  |  |  |  |  |  |  |  |  |  |  |  |  |  |  |  |  |  |  | TexasInstruments | LM3150 | U | Reference |  |  |  | Wide-Vin Synchronous Buck SMPS Controller
D |  |  |  |  |  |  |  |  |  |  |  |  |  |  |  |  |  |  |  |  |  |  |  |  | TexasInstruments | LM3150 | LM3150 | Value |  |  |  | Wide-Vin Synchronous Buck SMPS Controller
D |  |  |  |  |  |  |  |  |  |  |  |  |  |  |  |  |  |  |  |  |  |  |  |  | TexasInstruments | LM3150 | IPC7351-Nominal:SOP65P640X120-15 | Footprint |  |  |  | Wide-Vin Synchronous Buck SMPS Controller
D |  |  |  |  |  |  |  |  |  |  |  |  |  |  |  |  |  |  |  |  |  |  |  |  | TexasInstruments | LM3150 | http://www.ti.com/lit/ds/symlink/lm3150.pdf | Datasheet |  |  |  | Wide-Vin Synchronous Buck SMPS Controller
D |  |  |  |  |  |  |  |  |  |  |  |  |  |  |  |  |  |  |  |  |  |  |  |  | TexasInstruments | LM3150 |  |  | 1 | Vcc | power_out | Wide-Vin Synchronous Buck SMPS Controller
D |  |  |  |  |  |  |  |  |  |  |  |  |  |  |  |  |  |  |  |  |  |  |  |  | TexasInstruments | LM3150 |  |  | 2 | Vin | power_in | Wide-Vin Synchronous Buck SMPS Controller
D |  |  |  |  |  |  |  |  |  |  |  |  |  |  |  |  |  |  |  |  |  |  |  |  | TexasInstruments | LM3150 |  |  | 3 | En | input | Wide-Vin Synchronous Buck SMPS Controller
D |  |  |  |  |  |  |  |  |  |  |  |  |  |  |  |  |  |  |  |  |  |  |  |  | TexasInstruments | LM3150 |  |  | 4 | FB | input | Wide-Vin Synchronous Buck SMPS Controller
D |  |  |  |  |  |  |  |  |  |  |  |  |  |  |  |  |  |  |  |  |  |  |  |  | TexasInstruments | LM3150 |  |  | 5 | SGND | power_in | Wide-Vin Synchronous Buck SMPS Controller
D |  |  |  |  |  |  |  |  |  |  |  |  |  |  |  |  |  |  |  |  |  |  |  |  | TexasInstruments | LM3150 |  |  | 6 | SS | input | Wide-Vin Synchronous Buck SMPS Controller
D |  |  |  |  |  |  |  |  |  |  |  |  |  |  |  |  |  |  |  |  |  |  |  |  | TexasInstruments | LM3150 |  |  | 7 | RON | input | Wide-Vin Synchronous Buck SMPS Controller
D |  |  |  |  |  |  |  |  |  |  |  |  |  |  |  |  |  |  |  |  |  |  |  |  | TexasInstruments | LM3150 |  |  | 8 | Ilim | input | Wide-Vin Synchronous Buck SMPS Controller
D |  |  |  |  |  |  |  |  |  |  |  |  |  |  |  |  |  |  |  |  |  |  |  |  | TexasInstruments | LM3150 |  |  | 9 | SGND | power_in | Wide-Vin Synchronous Buck SMPS Controller
D |  |  |  |  |  |  |  |  |  |  |  |  |  |  |  |  |  |  |  |  |  |  |  |  | TexasInstruments | LM3150 |  |  | 10 | SW | power_out | Wide-Vin Synchronous Buck SMPS Controller
D |  |  |  |  |  |  |  |  |  |  |  |  |  |  |  |  |  |  |  |  |  |  |  |  | TexasInstruments | LM3150 |  |  | 11 | HG | output | Wide-Vin Synchronous Buck SMPS Controller
D |  |  |  |  |  |  |  |  |  |  |  |  |  |  |  |  |  |  |  |  |  |  |  |  | TexasInstruments | LM3150 |  |  | 12 | BOOT | input | Wide-Vin Synchronous Buck SMPS Controller
D |  |  |  |  |  |  |  |  |  |  |  |  |  |  |  |  |  |  |  |  |  |  |  |  | TexasInstruments | LM3150 |  |  | 13 | LG | input | Wide-Vin Synchronous Buck SMPS Controller
D |  |  |  |  |  |  |  |  |  |  |  |  |  |  |  |  |  |  |  |  |  |  |  |  | TexasInstruments | LM3150 |  |  | 14 | PGND | power_in | Wide-Vin Synchronous Buck SMPS Controller
D |  |  |  |  |  |  |  |  |  |  |  |  |  |  |  |  |  |  |  |  |  |  |  |  | TexasInstruments | LM3150 |  |  | 15 | SGND | power_in | Wide-Vin Synchronous Buck SMPS Controller
D |  |  |  |  |  |  |  |  |  |  |  |  |  |  |  |  |  |  |  |  |  |  |  |  | TexasInstruments | LM4040AvvDBZ | U | Reference |  |  |  | VRef Shunt 0.1% 100ppm/K [SOT-23]
D |  |  |  |  |  |  |  |  |  |  |  |  |  |  |  |  |  |  |  |  |  |  |  |  | TexasInstruments | LM4040AvvDBZ | LM4040AvvDBZ | Value |  |  |  | VRef Shunt 0.1% 100ppm/K [SOT-23]
D |  |  |  |  |  |  |  |  |  |  |  |  |  |  |  |  |  |  |  |  |  |  |  |  | TexasInstruments | LM4040AvvDBZ | smd-semi:SOT-23 | Footprint |  |  |  | VRef Shunt 0.1% 100ppm/K [SOT-23]
D |  |  |  |  |  |  |  |  |  |  |  |  |  |  |  |  |  |  |  |  |  |  |  |  | TexasInstruments | LM4040AvvDBZ | IC TI LM4040AvvDBZ | BOM |  |  |  | VRef Shunt 0.1% 100ppm/K [SOT-23]
D |  |  |  |  |  |  |  |  |  |  |  |  |  |  |  |  |  |  |  |  |  |  |  |  | TexasInstruments | LM4040AvvDBZ |  |  | 1 | ~ | passive | VRef Shunt 0.1% 100ppm/K [SOT-23]
D |  |  |  |  |  |  |  |  |  |  |  |  |  |  |  |  |  |  |  |  |  |  |  |  | TexasInstruments | LM4040AvvDBZ |  |  | 2 | ~ | passive | VRef Shunt 0.1% 100ppm/K [SOT-23]
D |  |  |  |  |  |  |  |  |  |  |  |  |  |  |  |  |  |  |  |  |  |  |  |  | TexasInstruments | LM4040AvvDBZ |  |  |  |  |  | VRef Shunt 0.1% 100ppm/K [SOT-23] |  | SOT-23
D |  |  |  |  |  |  |  |  |  |  |  |  |  |  |  |  |  |  |  |  |  |  |  |  | 6xUSB_PowMet-cache | LT6106 | U | Reference
D |  |  |  |  |  |  |  |  |  |  |  |  |  |  |  |  |  |  |  |  |  |  |  |  | 6xUSB_PowMet-cache | LT6106 | LT6106 | Value
D |  |  |  |  |  |  |  |  |  |  |  |  |  |  |  |  |  |  |  |  |  |  |  |  | 6xUSB_PowMet-cache | LT6106 |  |  | 1 | OUT | passive
D |  |  |  |  |  |  |  |  |  |  |  |  |  |  |  |  |  |  |  |  |  |  |  |  | 6xUSB_PowMet-cache | LT6106 |  |  | 2 | V- | power_in
D |  |  |  |  |  |  |  |  |  |  |  |  |  |  |  |  |  |  |  |  |  |  |  |  | 6xUSB_PowMet-cache | LT6106 |  |  | 3 | -IN | passive
D |  |  |  |  |  |  |  |  |  |  |  |  |  |  |  |  |  |  |  |  |  |  |  |  | 6xUSB_PowMet-cache | LT6106 |  |  | 4 | +IN | passive
D |  |  |  |  |  |  |  |  |  |  |  |  |  |  |  |  |  |  |  |  |  |  |  |  | 6xUSB_PowMet-cache | LT6106 |  |  | 5 | V+ | power_in
D |  |  |  |  |  |  |  |  |  |  |  |  |  |  |  |  |  |  |  |  |  |  |  |  | 6xUSB_PowMet-cache | LTC4412 | U | Reference
D |  |  |  |  |  |  |  |  |  |  |  |  |  |  |  |  |  |  |  |  |  |  |  |  | 6xUSB_PowMet-cache | LTC4412 | LTC4412 | Value
D |  |  |  |  |  |  |  |  |  |  |  |  |  |  |  |  |  |  |  |  |  |  |  |  | 6xUSB_PowMet-cache | LTC4412 |  |  | 1 | Vin | power_in
D |  |  |  |  |  |  |  |  |  |  |  |  |  |  |  |  |  |  |  |  |  |  |  |  | 6xUSB_PowMet-cache | LTC4412 |  |  | 2 | GND | power_in
D |  |  |  |  |  |  |  |  |  |  |  |  |  |  |  |  |  |  |  |  |  |  |  |  | 6xUSB_PowMet-cache | LTC4412 |  |  | 3 | CTL | input
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
D |  |  |  |  |  |  |  |  |  |  |  |  |  |  |  |  |  |  |  |  |  |  |  |  | conn | USB_B |  |  | 2 | D- | passive | B connector
D |  |  |  |  |  |  |  |  |  |  |  |  |  |  |  |  |  |  |  |  |  |  |  |  | conn | USB_B |  |  | 3 | D+ | passive | B connector
D |  |  |  |  |  |  |  |  |  |  |  |  |  |  |  |  |  |  |  |  |  |  |  |  | conn | USB_B |  |  | 4 | GND | power_in | B connector
D |  |  |  |  |  |  |  |  |  |  |  |  |  |  |  |  |  |  |  |  |  |  |  |  | conn | USB_B |  |  | 5 | shield | passive | B connector
D |  |  |  |  |  |  |  |  |  |  |  |  |  |  |  |  |  |  |  |  |  |  |  |  | conn | USB_B |  |  |  |  |  | B connector |  | USB*
D |  |  |  |  |  |  |  |  |  |  |  |  |  |  |  |  |  |  |  |  |  |  |  |  |  |  |  |  |  |  |  |  |  |  |  | 6xUSB_PowMet-rescue | M:\Personal\GitHub\6xUSB-Power-Meter\Hardware\PCB\6xUSB_PowMet-rescue.lib
D |  |  |  |  |  |  |  |  |  |  |  |  |  |  |  |  |  |  |  |  |  |  |  |  |  |  |  |  |  |  |  |  |  |  |  | device | C:\Program Files\KiCad\share\kicad\library\device.lib
D |  |  |  |  |  |  |  |  |  |  |  |  |  |  |  |  |  |  |  |  |  |  |  |  |  |  |  |  |  |  |  |  |  |  |  | transistors | C:\Program Files\KiCad\share\kicad\library\transistors.lib
D |  |  |  |  |  |  |  |  |  |  |  |  |  |  |  |  |  |  |  |  |  |  |  |  |  |  |  |  |  |  |  |  |  |  |  | conn | C:\Program Files\KiCad\share\kicad\library\conn.lib
D |  |  |  |  |  |  |  |  |  |  |  |  |  |  |  |  |  |  |  |  |  |  |  |  |  |  |  |  |  |  |  |  |  |  |  | atmel | C:\Program Files\KiCad\share\kicad\library\atmel.lib
D |  |  |  |  |  |  |  |  |  |  |  |  |  |  |  |  |  |  |  |  |  |  |  |  |  |  |  |  |  |  |  |  |  |  |  | TexasInstruments | M:\Personal\kicad-schlib-master\kicad-schlib-master\library\TexasInstruments.lib
D |  |  |  |  |  |  |  |  |  |  |  |  |  |  |  |  |  |  |  |  |  |  |  |  |  |  |  |  |  |  |  |  |  |  |  | transistor | M:\Personal\kicad-lib-master2\kicad-lib-master\components\transistor.lib
D |  |  |  |  |  |  |  |  |  |  |  |  |  |  |  |  |  |  |  |  |  |  |  |  |  |  |  |  |  |  |  |  |  |  |  | ESP8266 | M:\Personal\kicad-ESP8266-master\kicad-ESP8266-master\ESP8266.lib
D |  |  |  |  |  |  |  |  |  |  |  |  |  |  |  |  |  |  |  |  |  |  |  |  |  |  |  |  |  |  |  |  |  |  |  | 6xUSB_PowMet-cache | M:\Personal\GitHub\6xUSB-Power-Meter\Hardware\PCB\6xUSB_PowMet-cache.lib
D |  |  |  |  |  |  |  |  |  |  |  |  |  |  |  |  |  |  |  |  |  |  |  |  |  |  |  |  |  |  |  |  |  |  |  |  |  | 1 | Net-(R9-Pad2) | U4 | 3
D |  |  |  |  |  |  |  |  |  |  |  |  |  |  |  |  |  |  |  |  |  |  |  |  |  |  |  |  |  |  |  |  |  |  |  |  |  | 1 | Net-(R9-Pad2) | R9 | 2
D |  |  |  |  |  |  |  |  |  |  |  |  |  |  |  |  |  |  |  |  |  |  |  |  |  |  |  |  |  |  |  |  |  |  |  |  |  | 2 | Net-(Q7-Pad2) | Q7 | 2
D |  |  |  |  |  |  |  |  |  |  |  |  |  |  |  |  |  |  |  |  |  |  |  |  |  |  |  |  |  |  |  |  |  |  |  |  |  | 2 | Net-(Q7-Pad2) | U3 | 4
D |  |  |  |  |  |  |  |  |  |  |  |  |  |  |  |  |  |  |  |  |  |  |  |  |  |  |  |  |  |  |  |  |  |  |  |  |  | 2 | Net-(Q7-Pad2) | R18 | 2
D |  |  |  |  |  |  |  |  |  |  |  |  |  |  |  |  |  |  |  |  |  |  |  |  |  |  |  |  |  |  |  |  |  |  |  |  |  | 3 | Net-(R19-Pad2) | R19 | 2
D |  |  |  |  |  |  |  |  |  |  |  |  |  |  |  |  |  |  |  |  |  |  |  |  |  |  |  |  |  |  |  |  |  |  |  |  |  | 3 | Net-(R19-Pad2) | U5 | 3
D |  |  |  |  |  |  |  |  |  |  |  |  |  |  |  |  |  |  |  |  |  |  |  |  |  |  |  |  |  |  |  |  |  |  |  |  |  | 4 | Net-(R16-Pad2) | U3 | 3
D |  |  |  |  |  |  |  |  |  |  |  |  |  |  |  |  |  |  |  |  |  |  |  |  |  |  |  |  |  |  |  |  |  |  |  |  |  | 4 | Net-(R16-Pad2) | R16 | 2
D |  |  |  |  |  |  |  |  |  |  |  |  |  |  |  |  |  |  |  |  |  |  |  |  |  |  |  |  |  |  |  |  |  |  |  |  |  | 5 | Net-(Q4-Pad2) | U2 | 4
D |  |  |  |  |  |  |  |  |  |  |  |  |  |  |  |  |  |  |  |  |  |  |  |  |  |  |  |  |  |  |  |  |  |  |  |  |  | 5 | Net-(Q4-Pad2) | Q4 | 2
D |  |  |  |  |  |  |  |  |  |  |  |  |  |  |  |  |  |  |  |  |  |  |  |  |  |  |  |  |  |  |  |  |  |  |  |  |  | 5 | Net-(Q4-Pad2) | R2 | 2
D |  |  |  |  |  |  |  |  |  |  |  |  |  |  |  |  |  |  |  |  |  |  |  |  |  |  |  |  |  |  |  |  |  |  |  |  |  | 6 | Net-(R1-Pad2) | U2 | 3
D |  |  |  |  |  |  |  |  |  |  |  |  |  |  |  |  |  |  |  |  |  |  |  |  |  |  |  |  |  |  |  |  |  |  |  |  |  | 6 | Net-(R1-Pad2) | R1 | 2
D |  |  |  |  |  |  |  |  |  |  |  |  |  |  |  |  |  |  |  |  |  |  |  |  |  |  |  |  |  |  |  |  |  |  |  |  |  | 7 | Net-(P11-Pad5) | P11 | 5
D |  |  |  |  |  |  |  |  |  |  |  |  |  |  |  |  |  |  |  |  |  |  |  |  |  |  |  |  |  |  |  |  |  |  |  |  |  | 8 | Net-(P11-Pad3) | P11 | 3
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
D |  |  |  |  |  |  |  |  |  |  |  |  |  |  |  |  |  |  |  |  |  |  |  |  |  |  |  |  |  |  |  |  |  |  |  |  |  | 101 | USB_P | R22 | 1
D |  |  |  |  |  |  |  |  |  |  |  |  |  |  |  |  |  |  |  |  |  |  |  |  |  |  |  |  |  |  |  |  |  |  |  |  |  | 101 | USB_P | L4 | 2

Sheet: Sheet2
ref | value5 | footprint | lib | part | datasheet | field | name7 | Elfa | Elfa +10 | Elfa +100 | Lemona | CLemona +10 | Lemona +100 | Salvats | TME 100+ | num | name12 | type | description | docs | fp | alias | logical | uri | code | name13 | ref14 | pin
U2 | LT6106 | TO_SOT_Packages_SMD:SOT-23-5 | 6xUSB_PowMet-cache | LT6106 |  |  |  | 1.27 | 1.22 | 1.09 | 1.77
R6 | 10k | Resistors_SMD:R_0805 | device | R |  |  |  |  |  |  |  |  |  | 0.01
C8 | 100n | Capacitors_SMD:C_0805 | device | C |  |  |  | 0.00423 | 0.00399 | 0.00375 |  |  |  | 0.007
C9 | 100n | Capacitors_SMD:C_0805 | device | C
L1 | 10uH | Inductors:Inductor_1212 | 6xUSB_PowMet-rescue | L-RESCUE-6xUSB_PowMet |  | CV201210-100K |  | 0.266 | 0.154 | 0.117 | 0.26 | 0.15 | 0.11
R5 | 15K | Resistors_SMD:R_0805 | device | R |  |  |  | 0.013 | 0.012 |  |  |  |  | 0.01
R4 | 10K | Resistors_SMD:R_0805 | device | R
C7 | 1n | Capacitors_SMD:C_0805 | device | C |  | C0805C102J5GAC7025 |  | 0.0082 | 0.00774 | 0.00726 | 0.0105 |  |  | 0.009
C4 | 1n | Capacitors_SMD:C_0805 | device | C
C1 | 100n | Capacitors_SMD:C_0805 | device | C
R3 | 10K | Resistors_SMD:R_0805 | device | R
R1 | 100R | Resistors_SMD:R_0805 | device | R
R2 | 0.02R | Resistors_SMD:R_1206 | device | R |  | Welwyn LR1206-01-R020-F-LF |  |  |  |  | 0.46 | 0.41 | 0.38
U3 | LT6106 | TO_SOT_Packages_SMD:SOT-23-5 | 6xUSB_PowMet-cache | LT6106 |  |  |  | 1.05 | 1.01 | 0.9 | 1.77
C12 | 1n | Capacitors_SMD:C_0805 | device | C
C15 | 100n | Capacitors_SMD:C_0805 | device | C
R13 | 10K | Resistors_SMD:R_0805 | device | R
R16 | 100R | Resistors_SMD:R_0805 | device | R
R18 | 0.02R | Resistors_SMD:R_1206 | device | R
U4 | LT6106 | TO_SOT_Packages_SMD:SOT-23-5 | 6xUSB_PowMet-cache | LT6106 |  |  |  | 1.05 | 1.01 | 0.9 | 1.77
C2 | 1n | Capacitors_SMD:C_0805 | device | C
C10 | 100n | Capacitors_SMD:C_0805 | device | C
R7 | 10K | Resistors_SMD:R_0805 | device | R
R9 | 100R | Resistors_SMD:R_0805 | device | R
R11 | 0.02R | Resistors_SMD:R_1206 | device | R | https://www.elfadistrelec.lv/Web/Downloads/_t/ds/erj8cw_eng_tds.pdf?mime=application%2Fpdf | ERJ8CWFR020V | Kod
U5 | LT6106 | TO_SOT_Packages_SMD:SOT-23-5 | 6xUSB_PowMet-cache | LT6106 |  |  |  | 1.05 | 1.01 | 0.9 | 1.77
C14 | 1n | Capacitors_SMD:C_0805 | device | C
C17 | 100n | Capacitors_SMD:C_0805 | device | C
R15 | 10K | Resistors_SMD:R_0805 | device | R
R19 | 100R | Resistors_SMD:R_0805 | device | R
R21 | 0.02R | Resistors_SMD:R_1206 | device | R
U6 | LT6106 | TO_SOT_Packages_SMD:SOT-23-5 | 6xUSB_PowMet-cache | LT6106 |  |  |  | 1.05 | 1.01 | 0.9 | 1.77
C3 | 1n | Capacitors_SMD:C_0805 | device | C
C11 | 100n | Capacitors_SMD:C_0805 | device | C
R8 | 10K | Resistors_SMD:R_0805 | device | R
R10 | 100R | Resistors_SMD:R_0805 | device | R
R12 | 0.02R | Resistors_SMD:R_1206 | device | R
U7 | LT6106 | TO_SOT_Packages_SMD:SOT-23-5 | 6xUSB_PowMet-cache | LT6106 |  |  |  | 1.05 | 1.01 | 0.9 | 1.77
C13 | 1n | Capacitors_SMD:C_0805 | device | C
C16 | 100n | Capacitors_SMD:C_0805 | device | C
R14 | 10K | Resistors_SMD:R_0805 | device | R
R17 | 100R | Resistors_SMD:R_0805 | device | R
R20 | 0.02R | Resistors_SMD:R_1206 | device | R
P1 | USB_A | USB-A_vertical1:USB_A_Vertical | conn | USB_A |  | MX-67329-8000 |  |  |  |  | 1.07 |  |  | 1.17
P4 | USB_A | USB-A_vertical1:USB_A_Vertical | conn | USB_A
P2 | USB_A | USB-A_vertical1:USB_A_Vertical | conn | USB_A
P5 | USB_A | USB-A_vertical1:USB_A_Vertical | conn | USB_A
P3 | USB_A | USB-A_vertical1:USB_A_Vertical | conn | USB_A
P6 | USB_A | USB-A_vertical1:USB_A_Vertical | conn | USB_A
P8 | CONN_01X03 | Connect:Wafer_Vertical10x5.8x7RM2.5-3 | conn | CONN_01X03
F1 | F_Small | Fuse_Holders_and_Fuses:Fuse_SMD1206_HandSoldering | device | F_Small |  | MF-NSMF200-2 |  | 0.424 | 0.385 | 0.371 | 0.36
F2 | F_Small | Fuse_Holders_and_Fuses:Fuse_SMD1206_HandSoldering | device | F_Small
F3 | F_Small | Fuse_Holders_and_Fuses:Fuse_SMD1206_HandSoldering | device | F_Small
F4 | F_Small | Fuse_Holders_and_Fuses:Fuse_SMD1206_HandSoldering | device | F_Small
F5 | F_Small | Fuse_Holders_and_Fuses:Fuse_SMD1206_HandSoldering | device | F_Small
F6 | F_Small | Fuse_Holders_and_Fuses:Fuse_SMD1206_HandSoldering | device | F_Small
C18 | 10uF | Capacitors_SMD:C_0805 | device | C_Small |  | CL21A106KOQNNNE |  |  |  |  |  |  |  | 0.026
C19 | 10uF | Capacitors_SMD:C_0805 | device | C_Small
C20 | 10uF | Capacitors_SMD:C_0805 | device | C_Small
C21 | 10uF | Capacitors_SMD:C_0805 | device | C_Small
C22 | 10uF | Capacitors_SMD:C_0805 | device | C_Small
C23 | 10uF | Capacitors_SMD:C_0805 | device | C_Small
P7 | CONN_01X06 | Connect:Wafer_Vertical17.5x5.8x7RM2.5-6 | conn | CONN_01X06
P9 | CONN_01X03 | Connect:Wafer_Vertical10x5.8x7RM2.5-3 | conn | CONN_01X03
R43 | 100 | Resistors_SMD:R_0805 | device | R_Small
U8 | LM4040N-4.1 | TO_SOT_Packages_SMD:SOT-23 | TexasInstruments | LM4040AvvDBZ |  | IC TI LM4040AvvDBZ | BOM |  |  |  | 0.71 | 0.58 | 0.46
C6 | 100n | Capacitors_SMD:C_0805 | device | C
C5 | 100n | Capacitors_SMD:C_0805 | device | C
Q4 | IRLML6401 | TO_SOT_Packages_SMD:SOT-23 | transistor | P-CHAN-MOSFET_SOT | https://www.elfadistrelec.lv/Web/Downloads/1_/en/zmint_RECTIFIER_FET-Trans-IRLML6401_EN.pdf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 |  |  | 0.27 | 0.23 |  | 0.11 | 0.09 | 0.08
Q7 | IRLML6401 | TO_SOT_Packages_SMD:SOT-23 | transistor | P-CHAN-MOSFET_SOT | https://www.elfadistrelec.lv/Web/Downloads/1_/en/zmint_RECTIFIER_FET-Trans-IRLML6401_EN.pdf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 |  |  | 0.27 | 0.23 |  |  |  | 0.09
Q5 | IRLML6401 | TO_SOT_Packages_SMD:SOT-23 | transistor | P-CHAN-MOSFET_SOT | https://www.elfadistrelec.lv/Web/Downloads/1_/en/zmint_RECTIFIER_FET-Trans-IRLML6401_EN.pdf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 |  |  | 0.27 | 0.23 |  |  |  | 0.09
Q9 | IRLML6401 | TO_SOT_Packages_SMD:SOT-23 | transistor | P-CHAN-MOSFET_SOT | https://www.elfadistrelec.lv/Web/Downloads/1_/en/zmint_RECTIFIER_FET-Trans-IRLML6401_EN.pdf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 |  |  | 0.27 | 0.23 |  |  |  | 0.09
Q6 | IRLML6401 | TO_SOT_Packages_SMD:SOT-23 | transistor | P-CHAN-MOSFET_SOT | https://www.elfadistrelec.lv/Web/Downloads/1_/en/zmint_RECTIFIER_FET-Trans-IRLML6401_EN.pdf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 |  |  | 0.27 | 0.23 |  |  |  | 0.09
Q8 | IRLML6401 | TO_SOT_Packages_SMD:SOT-23 | transistor | P-CHAN-MOSFET_SOT | https://www.elfadistrelec.lv/Web/Downloads/1_/en/zmint_RECTIFIER_FET-Trans-IRLML6401_EN.pdf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 |  |  | 0.27 | 0.23 |  |  |  | 0.09
IC1 | ATMEGA32-M | Housings_QFP:TQFP-44_10x10mm_Pitch0.8mm | atmel | ATMEGA32-M |  |  |  |  |  |  | 4.56 |  |  | 3.56
P11 | CONN_02X04 | Socket_Strips:Socket_Strip_Straight_2x04 | conn | CONN_02X04
P12 | CONN_02X04 | Socket_Strips:Socket_Strip_Straight_2x04 | conn | CONN_02X04
U10 | ESP-07v2 | ESP8266:ESP-07v2 | ESP8266 | ESP-07v2
R47 | 10k | Resistors_SMD:R_0805 | device | R
R41 | 10k | Resistors_SMD:R_0805 | device | R
R46 | 10k | Resistors_SMD:R_0805 | device | R
R49 | 10k | Resistors_SMD:R_0805 | device | R
R39 | 470R | Resistors_SMD:R_0805 | device | R
R48 | 10k | Resistors_SMD:R_0805 | device | R
P13 | CONN_01X02 | Connectors_Molex:Molex_MicroLatch-53253-0270_02x2.00mm_Straight | conn | CONN_01X02
SW1 | SW_PUSH | Buttons_Switches_SMD:SW_SPST_B3U-1000P | device | SW_PUSH
C27 | 18pF | Capacitors_SMD:C_0805 | device | C_Small |  | CSM18PFNP0 |  |  |  |  | 0.04
C26 | 18pF | Capacitors_SMD:C_0805 | device | C_Small
Y1 | 12Mhz | Crystals:Crystal_HC49-SD_SMD | device | Crystal_Small |  | ABLS-12.000MHZ-B4-T |  |  |  |  | 0.83 |  | 0.29
R29 | 2.7K | Resistors_SMD:R_0805 0.1% | device | R_Small |  | ERA6APB272V |  | 0.6655 | 0.605 | 0.5687 | 0.45
R22 | 470 | Resistors_SMD:R_0805 | device | R_Small
D1 | Power | LEDs:LED-5MM | device | Led_Small
R26 | 10K | Resistors_SMD:R_0805 | device | R_Small
R23 | 470 | Resistors_SMD:R_0805 | device | R_Small
LED4 | Led_Small | LEDs:LED_0805 | device | Led_Small
LED2 | Led_Small | LEDs:LED_0805 | device | Led_Small
LED1 | Led_Small | LEDs:LED_0805 | device | Led_Small
LED3 | Led_Small | LEDs:LED_0805 | device | Led_Small
R24 | 470 | Resistors_SMD:R_0805 | device | R_Small
D6 | Led_Small | LEDs:LED_0805 | device | Led_Small
R25 | 470 | Resistors_SMD:R_0805 | device | R_Small
C28 | 10uF | Capacitors_SMD:C_0805 | device | C_Small
R27 | 10K | Resistors_SMD:R_0805 | device | R_Small
R28 | 100K | Resistors_SMD:R_0805 | device | R_Small
F7 | 500mA | Fuse_Holders_and_Fuses:Fuse_SMD1206_HandSoldering | device | F_Small |  | SF-1206F050-2 |  | 0.442 | 0.401 | 0.334 | 0.48 | 0.43
P10 | USB_B | Connect:USB_B | conn | USB_B
U11 | LTC4412 | tom_kicad_lib:SOT-6 | 6xUSB_PowMet-cache | LTC4412 |  |  |  | 3.84 | 3.57 | 3.29 | 3.82 | 3.15 | 2.74
Q1 | IRFR5305PBF | TO_SOT_Packages_SMD1:TO-252-2Lead | device | Q_PMOS_GDS |  |  |  | 1.31 | 0.847 | 0.75 |  |  |  | 0.67
C36 | 100nF | Capacitors_SMD:C_0805 | device | C_Small
R33 | 470K | Resistors_SMD:R_0805 | device | R_Small
CON2 | BARREL_JACK | Connect:JACK_ALIM | conn | BARREL_JACK
C37 | 22uF | Capacitors_SMD:C_1206/0805 | device | C_Small |  |  |  |  |  |  |  |  |  | 0.029
C38 | 100nF | Capacitors_SMD:C_0805 | device | C_Small
U13 | LM3150 | Housings_SSOP:SSOP-14_5.3x6.2mm_Pitch0.65mm | TexasInstruments | LM3150 | http://www.ti.com/lit/ds/symlink/lm3150.pdf |  |  |  |  |  | 4.27 | 3.7 | 3.19
R34 | 100K | Resistors_SMD:R_0805 | device | R_Small
C39 | 15nF | Capacitors_SMD:C_0805 | device | C_Small |  | RND1500805B153K500 | CSM15NFY5V | 0.0659 | 0.0316 | 0.0241 | 0.04
C41 | 1uF | Capacitors_SMD:C_0805 | device | C_Small |  | CL21F105ZBFNNNE |  |  |  |  |  |  |  | 0.008
C40 | 470nF | Capacitors_SMD:C_0805 | device | C_Small |  | L21B474KBFNNNG |  |  |  |  |  |  |  | 0.023
R35 | 1K07 | Resistors_SMD:R_0805 | device | R_Small |  | ERJ6ENF1071V |  |  |  |  |  | 0.07 | 0.02
Q2 | CSD16342Q5A | Personal:AB2_SON5x6_FET | transistors | IRF7607PBF |  |  |  |  |  |  | 1
Q3 | CSD17577Q5A | Personal:AB2_SON5x6_FET | transistors | IRF7607PBF |  |  |  |  |  |  | 1.2
L3 | 2.2uH | Inductors:SELF-WE-PD-XXL | device | INDUCTOR_SMALL |  | SRP1245A-2R2M |  | 1.83 | 1.61 | 1.34 | 1.78 | 1.56 | 1.31
C42 | 470pF | Capacitors_SMD:C_0805 | device | C_Small |  |  |  |  |  |  |  |  |  | 0.005
R36 | 73K2 | Resistors_SMD:R_0805 | device | R_Small |  | PCF0805R-73K2BT1 |  |  |  |  | 0.86 | 0.37 | 0.33
R37 | 10K | Resistors_SMD:R_0805 | device | R_Small
C43 | 220uF | Capacitors_SMD:c_elec_6.3x7.7 | device | CP1_Small |  |  |  | 0.266 | 0.243 | 0.22 |  |  |  | 0.18
D10 | SKL14 | Diodes_SMD:SOD-123 | device | D_Schottky |  | Schottky diode 1 A 40 V | Поле4 | 0.0968 | 0.0847 | 0.0726 | 0.1 | 0.09 | 0.08
D11 | SK2030YD2 | Diodes_SMD:DD-PAK_TO263_DualDiode | device | SCHDPAK |  |  |  | 0.66 | 0.595 | 0.528 | 0.64
R38 | 330 | Resistors_SMD:R_0805 | device | R_Small
D9 | Power | LEDs:LED-5MM | device | Led_Small
R31 | 330 | Resistors_SMD:R_0805 | device | R_Small
D8 | Power | LEDs:LED-5MM | device | Led_Small
R32 | 330 | Resistors_SMD:R_0805 | device | R_Small
D12 | Power | LEDs:LED-5MM | device | Led_Small
R40 | 10K | Resistors_SMD:R_0805 | device | R_Small
R42 | 10K | Resistors_SMD:R_0805 | device | R_Small
U9 | FE1.1s | Housings_SSOP:TSSOP-28_4.4x9.7mm_Pitch0.65mm | 6xUSB_PowMet-cache | FE1.1s
R44 | 100K | Resistors_SMD:R_0805 | device | R_Small
C30 | 0.1uF | Capacitors_SMD:C_0603 | device | C_Small |  | C0603C104Z3VACTU |  | 0.0676 | 0.0288 | 0.022 | 0.0657 | 0.028 | 0.0214
R45 | 100K | Resistors_SMD:R_0805 | device | R_Small
C29 | 10nF | Capacitors_SMD:C_0805 | device | C_Small
U1 | 24LC02 | Housings_SOIC:SOIC-8_3.9x4.9mm_Pitch1.27mm | 6xUSB_PowMet-cache | 24LC02 |  |  |  | 0.254 | 0.242 | 0.223 | 0.24
L4 | Bead/100MHZ/470ohm/2A | Resistors_SMD:R_0805_HandSoldering | device | INDUCTOR_SMALL |  | HZ0805G471R-10 |  |  |  |  | 0.15 | 0.11 | 0.0871
C24 | 0.1uF | Capacitors_SMD:C_0603 | device | C_Small
C25 | 0.1uF | Capacitors_SMD:C_0603 | device | C_Small
R30 | 330 | Resistors_SMD:R_0805 | device | R_Small
D2 | MC Status | LEDs:LED_0603 | device | Led_Small
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
