aleksejm/6xUSB-Power-Meter/Parts.xlsx

ref | value5 | footprint | Count | part | names | tstamps6 | Salvats.lv | 10+ | Elfase.lv | 10+2 | Lemona.lv | 10+3 | TME.lv | docs
IC1 | ATMEGA32-M | Housings_QFP:TQFP-44_10x10mm_Pitch0.8mm | atmel | ATMEGA32-M | / | / | 3.56 |  |  |  | 3.69
U | LT6106 | TO_SOT_Packages_SMD: SOT-23-5 | 6 | LT6106 | / | / |  |  | 1.27 | 1.22 | 1.77 |  | 2.41
U1 | LM1117MP-2.5 | TO_SOT_Packages_SMD:SOT-223 (ZLDO1117G33TA) | 1 | LM1117MP-2.5 | / | / |  |  | 0.59 |  | 1 | 0.76
C5 | 100n | Capacitors_SMD:C_0805 | 9 | C | / | / |  | 0.07 | 0.09 |  | 0.04
C6 | 10uF | Capacitors_Tantalum_SMD:TantalC_SizeA_EIA-3216 | 1 | C | / | / | 0.11 |  |  |  | 0.14
R6 | 10k | Resistors_SMD:R_0805 | 13 | R | / | / |  |  |  |  |  | 0.29
L1 | 10uH | Resistors_ThroughHole:Resistor_Horizontal_RM15mm | 1 | XAL6060-103MEC | / | / |  |  | 0.35 |  | 4.98
R5 | 14K | Resistors_SMD:R_0805 | 1 | R | / | /
C7 | 1n | Capacitors_SMD:C_0805 | 7 | C | / | /
R1 | 100R | Resistors_SMD:R_0805 | 6 | R | / | /
R2 | 0.01R | Resistors_SMD:R_0805 | 6 | R | / | / |  | 0.1
P1 | USB_A | USB-A_vertical1:USB_A_Vertical | 6 | USB_A | / | / | 1.71
P7 | CONN_01X08 | Connect:Wafer_Vertical22.5x5.8x7RM2.5-8 | 1 | CONN_01X08 | / | /
P8 | CONN_01X03 | Connect:Wafer_Vertical10x5.8x7RM2.5-3 | 1 | CONN_01X03 | / | /
F1 | F_Small 0.5A | Fuse_Holders_and_Fuses:Fuse_SMD1206_HandSoldering | 1 | F_Small | / | /
F2 | F_Small 3A | Fuse_Holders_and_Fuses:Fuse_SMD1206_HandSoldering | 6 | F_Small | / | / | 0.57
C18 | 10uF | Capacitors_SMD:C_0805_HandSoldering | 9 | C_Small | / | / |  | 0.26
U9 | FE1.1s | Housings_SSOP:SSOP-28_5.3x10.2mm_Pitch0.65mm | 1 | FE1.1s | /USB hub/ | /571758E7/
C27 | 10pF | Capacitors_SMD:C_0805_HandSoldering | 2 | C_Small | /USB hub/ | /571758E7/ |  | 0.14
Y1 | 12Mhz | Quartz SMD 12 MHz, LF XTAL032878, IQD | 1 | Crystal_Small | /USB hub/ | /571758E7/ |  |  | 1.16 | 1.09
R29 | 2.7K | Resistors_SMD:R_0805_HandSoldering | 1 | R_Small | /USB hub/ | /571758E7/
R22 | 330 | Resistors_SMD:R_0805_HandSoldering | device | R_Small | /USB hub/ | /571758E7/
D1 | Power | LEDs:LED-5MM | device | Led_Small | /USB hub/ | /571758E7/
R23 | 330 | Resistors_SMD:R_0805_HandSoldering | device | R_Small | /USB hub/ | /571758E7/
D2 | Led_Small | LEDs:LED-5MM | device | Led_Small | /USB hub/ | /571758E7/
D3 | Led_Small | LEDs:LED-5MM | device | Led_Small | /USB hub/ | /571758E7/
D4 | Led_Small | LEDs:LED-5MM | device | Led_Small | /USB hub/ | /571758E7/
D5 | Led_Small | LEDs:LED-5MM | device | Led_Small | /USB hub/ | /571758E7/
R24 | 330 | Resistors_SMD:R_0805_HandSoldering | device | R_Small | /USB hub/ | /571758E7/
D6 | Led_Small | LEDs:LED-5MM | device | Led_Small | /USB hub/ | /571758E7/
R25 | 330 | Resistors_SMD:R_0805_HandSoldering | device | R_Small | /USB hub/ | /571758E7/
C29 | 10nF | Capacitors_SMD:C_0805_HandSoldering | device | C_Small | /USB hub/ | /571758E7/ | 0.07
F7 | F_Small | Fuse_Holders_and_Fuses:Fuse_SMD1206_HandSoldering | 1 | F | /USB hub/ | /571758E7/ | 0.57
D7 | 5.1V | Diodes_SMD:SMC_Standard | device | D_Schottky_Small | /USB hub/ | /571758E7/ | 0.09
U8 | AP1117E33 | TO_SOT_Packages_SMD:SOT89-3_Housing_Handsoldering | regul | AP1117E33 | /USB hub/ | /571758E7/ |  |  |  |  | 0.66
C24 | 4.7uF | Capacitors_SMD:C_0805_HandSoldering | device | C_Small | /USB hub/ | /571758E7/ |  | 0.31
P10 | USB_B |  | conn | USB_B | /USB hub/ | /571758E7/ | 0.26
CON1 | BARREL_JACK | Connect:JACK_ALIM | conn | BARREL_JACK | /USB hub/ | /571758E7/
C33 | 47uF | Capacitors_SMD:C_1206_HandSoldering | 2 | C_Small | /USB hub/ | /571758E7/ | 0.13
C34 | 10n | Capacitors_SMD:C_0805_HandSoldering | device | C_Small | /USB hub/ | /571758E7/ |  | 0.35
U10 | TPS5450-EP_DDA_8 | TPS5450-EP_DDA_8:DDA8_3X2P49 | TPS5450-EP_DDA_8 | TPS5450-EP_DDA_8 | /USB hub/ | /571758E7/ |  |  | 8.19 | 6.59 | 6.9
D8 | D_Schottky | Diodes_SMD:SMC_Handsoldering | device | D_Schottky | /USB hub/ | /571758E7/
R32 | 3.24K | Resistors_SMD:R_0805_HandSoldering | device | R_Small | /USB hub/ | /571758E7/ |  | 0.1
L2 | INDUCTOR_SMALL | SER2915L-223KL | device | 22 uH | /USB hub/ | /571758E7/ |  |  |  |  | 10.98
C35 | 180uF | Capacitors_SMD:c_elec_8x10.5 | device | CP1_Small | /USB hub/ | /571758E7/
U11 | LTC4412 | tom_kicad_lib:SOT-6 | tom_kicad | LTC4412 | /USB hub/ | /571758E7/ |  |  | 3.84 | 3.57 | 4.22
Q1 | IRFR5305PBF | TO_SOT_Packages_SMD1:TO-252-2Lead | device | Q_PMOS_GDS | /USB hub/ | /571758E7/ | 0.67 |  |  |  | 1.06
C36 | 100nF | Capacitors_SMD:C_0805_HandSoldering | device | C_Small | /USB hub/ | /571758E7/ |  | 0.07
R33 | 470K | Resistors_SMD:R_0805_HandSoldering | device | R_Small | /USB hub/ | /571758E7/ |  | 0.1
