aleksejm/6xUSB-Power-Meter/Hardware/PCB/6xUSB_PowMet.xlsx

 |  |  |  |  |  |  | Board Qty: | 250
 |  |  |  |  |  |  | Total Cost: | $19071.08 |  |  |  | $9300.69 |  |  |  |  |  | $7782.62 |  |  |  |  |  | $6473.75 |  |  |  |  |  | $9193.75 |  |  |  |  |  | $192829.26 |  |  |  |  |  | $7598.33
 |  |  |  |  |  |  | Unit Cost: | $76.28
Global Part Info |  |  |  |  |  |  |  |  | Digi-Key |  |  |  |  |  | Farnell |  |  |  |  |  | Mouser |  |  |  |  |  | Newark |  |  |  |  |  | Rs Components |  |  |  |  |  | ARROW
Refs | Value | Desc | Footprint | Manf | Manf# | Qty | Unit$ | Ext$ | Avail | Purch | Unit$ | Ext$ | Cat# | Doc | Avail | Purch | Unit$ | Ext$ | Cat# | Doc | Avail | Purch | Unit$ | Ext$ | Cat# | Doc | Avail | Purch | Unit$ | Ext$ | Cat# | Doc | Avail | Purch | Unit$ | Ext$ | Cat# | Doc | Avail | Purch | Unit$ | Ext$ | Cat# | Doc
C29 | 10nF |  | Capacitors_SMD:C_0805 | AVX | 08055C103KAT2A | 250 | $0.0097 | $2.43 | 171559 |  | $0.02 | $4.03 | 478-1383-1-ND | Link (http://www.digikey.com/product-detail/en/avx-corporation/08055C103KAT2A/478-1383-1-ND/564415) |  |  | $0.02 | $5.26 | 499225 | Link (http://it.farnell.com/avx/08055c103kat2a/condensatore-mlcc-x7r-10nf-50v/dp/499225) | 339968 |  | $0.01 | $2.75 | 581-08055C103K | Link (http://www.mouser.com/Search/Refine.aspx?Keyword=08055C103KAT2A%20) |  |  | $0.01 | $2.75 | 19C6332 | Link (http://www.newark.com/avx/08055c103kat2a/ceramic-capacitor-0-01uf-50v-x7r/dp/19C6332) | 2350 |  | $0.02 | $4.25 | 464-6672 | Link (http://it.rs-online.com/web/c/?searchTerm=08055C103KAT2A%20) | 79981 |  | $0.0097 | $2.43 |  | Link (https://www.arrow.com/en/products/08055c103kat2a/avx)
D1 | USB Power |  | LEDs:LED_D3.0mm_Horizontal_O6.35mm_Z6.0mm | Lite-On Technology | LTL-4291N | 250 | $0.0550 | $13.75 | 2726 |  | $0.09 | $23.46 | 160-1968-ND | Link (http://www.digikey.com/scripts/DkSearch/dksus.dll?WT.z_header=search_go&lang=en) |  |  |  |  |  |  | 5584 |  | $0.06 | $13.75 | 859-LTL-4291N | Link (http://www.mouser.com/Search/Refine.aspx?Keyword=LTL-4291N%20) |  |  |  |  |  |  |  |  |  |  |  |  | 97 |  | $0.2909 | $72.72
J1 | MICROUSB |  | kicad-libs-master:USB-MICRO-B-FCI-10118193 | Amphenol FCI | 10118193-0001LF | 250 | $0.2487 | $62.19 | 131424 |  | $0.27 | $68.61 | 609-4616-1-ND | Link (http://www.digikey.com/product-detail/en/amphenol-fci/10118193-0001LF/609-4616-1-ND/2785380) |  |  | $0.25 | $62.19 | 2751675 | Link (http://it.farnell.com/webapp/wcs/stores/servlet/Search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) | 41401 |  | $0.28 | $69.75 | 649-10118193-0001LF | Link (http://www.mouser.com/Search/Refine.aspx?Keyword=10118193-0001LF%20) |  |  | $0.27 | $68.25 | 67T2259 | Link (http://www.newark.com/webapp/wcs/stores/servlet/Search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) | 14 |  | $17.51 | $4376.90 | 863-2989 | Link (http://it.rs-online.com/web/c/?searchTerm=10118193-0001LF%20) | 16544 |  | $0.2697 | $67.42
CON2 | BARREL_JACK |  | Connect:JACK_ALIM | CUI Inc | PJ-082BH | 250 | $1.2000 | $300.00 | 2688 |  | $1.45 | $362.10 | CP-082BHCT-ND | Link (http://www.digikey.com/product-detail/en/cui-inc/PJ-082BH/CP-082BHCT-ND/3102547) |  |  |  |  |  |  | 2680 |  | $1.20 | $300.00 | 490-PJ-082BH | Link (http://www.mouser.com/Search/Refine.aspx?Keyword=PJ-082BH%20) |  |  |  |  |  |  |  |  |  |  |  |  | 314 |  | $1.7663 | $441.57
Q4-Q9 | IRLML6401 |  | TO_SOT_Packages_SMD:SOT-23 | Infineon Technologies AG | IRLML6401GTRPBF | 1500 | $0.1300 | $195.00 | 1724 |  | $0.15 | $220.26 | IRLML6401GTRPBFCT-ND | Link (http://www.digikey.com/product-detail/en/infineon-technologies/IRLML6401GTRPBF/IRLML6401GTRPBFCT-ND/2354251) |  |  |  |  |  |  | 5147 |  | $0.13 | $195.00 | 942-IRLML6401GTRPBF | Link (http://www.mouser.com/Search/Refine.aspx?Keyword=IRLML6401GTRPBF%20) |  |  |  |  |  |  | 550 |  | $0.23 | $350.79 | 907-5163 | Link (http://it.rs-online.com/web/c/?searchTerm=IRLML6401GTRPBF%20) | 1874 |  | $0.1416 | $212.40
C40 | 470nF |  | Capacitors_SMD:C_0805 | Taiyo Yuden | EMK212B7474KD-T | 250 | $0.0222 | $5.55 | 64988 |  | $0.04 | $9.20 | 587-1282-1-ND | Link (http://www.digikey.com/product-detail/en/taiyo-yuden/EMK212B7474KD-T/587-1282-1-ND/931059) |  |  | $0.02 | $5.55 | 2371391 | Link (http://it.farnell.com/webapp/wcs/stores/servlet/Search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) | 8215 |  | $0.03 | $7.25 | 963-EMK212B7474KD-T | Link (http://www.mouser.com/Search/Refine.aspx?Keyword=EMK212B7474KD-T%20) |  |  | $0.03 | $6.75 | 77M8438 | Link (http://www.newark.com/taiyo-yuden/emk212b7474kd-t/ceramic-capacitor-0-47uf-16v-x7r/dp/77M8438) |  |  |  |  |  |  | 10134 |  | $0.0280 | $7.00
C1,C3-C10,C15-C17,C27,C34,C35,C38,C48 | 100n |  | Capacitors_SMD:C_0805 | AVX | 08053C104KAT2A | 4250 | $0.0080 | $34.00 | 721714 |  | $0.01 | $48.49 | 478-3755-1-ND | Link (http://www.digikey.com/product-detail/en/avx-corporation/08053C104KAT2A/478-3755-1-ND/1116453) |  |  | $0.01 | $48.34 | 1740665 | Link (http://it.farnell.com/avx/08053c104kat2a/condensatore-mlcc-x7r-100nf-25v/dp/1740665) | 271062 |  | $0.01 | $34.00 | 581-08053C104K | Link (http://www.mouser.com/Search/Refine.aspx?Keyword=08053C104KAT2A%20) |  |  | $0.01 | $46.75 | 96M1381 | Link (http://www.newark.com/avx/08053c104kat2a/ceramic-capacitor-0-1uf-25v-x7r/dp/96M1381) | 10400 |  | $0.01 | $63.25 | 390-990 | Link (http://it.rs-online.com/web/c/?searchTerm=08053C104KAT2A%20) | 9832 |  | $0.0166 | $70.55
Q3 | CSD18509Q5B |  | Personal:AB2_SON5x6_FET | Texas Instruments | CSD18509Q5B | 250 | $1.4200 | $355.00 | 11368 |  | $1.60 | $399.50 | 296-37962-1-ND | Link (http://www.digikey.com/product-detail/en/texas-instruments/CSD18509Q5BT/296-37962-1-ND/4915649) |  |  | $1.99 | $496.95 | 2447869 | Link (http://it.farnell.com/texas-instruments/csd18509q5bt/mosfet-canale-n-40v-100a-vson/dp/2447869) | 5491 |  | $1.42 | $355.00 | 595-CSD18509Q5B | Link (http://www.mouser.com/ProductDetail/Texas-Instruments/CSD18509Q5B/) |  |  | $1.57 | $392.50 | 94X0491 | Link (http://www.newark.com/webapp/wcs/stores/servlet/Search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) | 35 |  | $1.83 | $456.56 | 914-2936 | Link (http://it.rs-online.com/web/c/?searchTerm=CSD18509Q5B%20) | 180 |  | $1.6362 | $409.05
D6 | Led_Small_3mm |  | LEDs:LED_D3.0mm_Horizontal_O6.35mm_Z6.0mm | Lite-On | MCL034MD | 250 | $0.0563 | $14.08 |  |  |  |  |  |  |  |  | $0.06 | $14.08 | 1581113 | Link (http://it.farnell.com/webapp/wcs/stores/servlet/Search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) |  |  |  |  |  |  |  |  | $0.08 | $20.50 | 14N9378 | Link (http://www.newark.com/webapp/wcs/stores/servlet/Search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) |  |  |  |  |  |  |  |  |  | $0.00
R7,R32 | 22R |  | Resistors_SMD:R_0805 | Yageo | RC0805JR-0722RL | 500 | $0.0040 | $2.00 | 832155 |  | $0.01 | $3.80 | 311-22ARCT-ND | Link (http://www.digikey.com/product-detail/en/yageo/RC0805JR-0722RL/311-22ARCT-ND/731232) |  |  | $0.01 | $4.20 | 9233806 | Link (http://it.farnell.com/yageo-phycomp/rc0805jr-0722rl/res-film-spesso-22r-5-0-125w-0805/dp/9233806) | 23511 |  | $0.004 | $2.00 | 603-RC0805JR-0722RL | Link (http://www.mouser.com/ProductDetail/Yageo/RC0805JR-0722RL/) |  |  | $0.004 | $2.00 | 68R0268 | Link (http://www.newark.com/yageo/rc0805jr-0722rl/res-thick-film-22r-5-0-125w-0805/dp/68R0268) | 11 |  | $5.49 | $2742.54 | 618-3987 | Link (http://it.rs-online.com/web/c/?searchTerm=RC0805JR-0722RL%20) | 2110 |  | $0.0070 | $3.50
R33 | 470K |  | Resistors_SMD:R_0805 | Yageo | RC0805JR-07470KL | 250 | $0.0040 | $1.00 | 142553 |  | $0.01 | $1.90 | 311-470KARCT-ND | Link (http://www.digikey.com/product-detail/en/yageo/RC0805JR-07470KL/311-470KARCT-ND/731281) |  |  | $0.01 | $2.79 | 9234330 | Link (http://it.farnell.com/yageo-phycomp/rc0805jr-07470kl/res-film-spesso-470k-5-0-125w/dp/9234330) | 13679 |  | $0.004 | $1.00 | 603-RC0805JR-07470KL | Link (http://www.mouser.com/ProductDetail/Yageo/RC0805JR-07470KL/?qs=sGAEpiMZZMu61qfTUdNhG0IfGdGRhTL5f7wUixn3vjY%3d) |  |  | $0.01 | $1.75 | 26M6828 | Link (http://www.newark.com/webapp/wcs/stores/servlet/Search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) |  |  |  |  |  |  | 10000 |  | $0.0072 | $1.80
U8 | LM4040N-4.1 |  | TO_SOT_Packages_SMD:SOT-23 | Texas Instruments | LM4040DIM3-4.1/NOPB | 250 | $0.4082 | $102.05 | 6749 |  | $0.54 | $134.20 | LM4040DIM3-4.1/NOPBCT-ND | Link (http://www.digikey.com/product-detail/en/texas-instruments/LM4040DIM3-4.1-NOPB/LM4040DIM3-4.1-NOPBCT-ND/212713) |  |  | $0.41 | $102.05 | 1468816 | Link (http://it.farnell.com/texas-instruments/lm4040dim3-4-1-nopb/rif-tensione-shunt-4-096v-sot/dp/1468816) | 981 |  | $0.41 | $103.25 | 926-LM4040DIM341NOPB | Link (http://www.mouser.com/ProductDetail/Texas-Instruments/LM4040DIM3-41-NOPB/) |  |  | $0.41 | $103.00 | 26K2435 | Link (http://www.newark.com/texas-instruments/lm4040dim3-4-1-nopb/voltage-ref-shunt-4-096v-sot-23/dp/26K2435) | 180 |  | $0.62 | $154.13 | 535-9644 | Link (http://it.rs-online.com/web/c/?searchTerm=LM4040DIM3-4.1%2FNOPB%20) | 2923 |  | $0.4345 | $108.62
R35 | 1K07 |  | Resistors_SMD:R_0805 | Vishay | CRCW0805464RFKEA | 250 | $0.0187 | $4.68 | 4590 |  | $0.02 | $4.68 | 541-464CCT-ND | Link (http://www.digikey.com/product-detail/en/vishay-dale/CRCW0805464RFKEA/541-464CCT-ND/1180744) |  |  | $0.02 | $5.93 | 1653004 | Link (http://it.farnell.com/vishay/crcw0805464rfkea/res-film-spesso-464r-1-0-125w/dp/1653004) | 4286 |  | $0.03 | $7.00 | 71-CRCW0805-464-E3 | Link (http://www.mouser.com/Search/Refine.aspx?Keyword=CRCW0805464RFKEA%20) |  |  | $0.02 | $4.75 | 53K0276 | Link (http://www.newark.com/vishay/crcw0805464rfkea/thick-film-resistor-464-ohm-125mw/dp/53K0276) |  |  |  |  | 679-1412 | Link (http://it.rs-online.com/web/p/resistori-smd/6791412P/) | 22 |  | $0.0813 | $20.32
SW1 | Reset |  | Buttons_Switches_SMD:SW_SPST_B3U-1000P |  |  | 250 | $0.0000 | $0.00 |  |  |  |  |  |  |  |  |  |  |  |  |  |  |  |  |  |  |  |  |  |  |  |  |  |  |  |  |  |  |  |  |  | $0.00
C43 | 330uF |  | Capacitors_SMD:CP_Elec_6.3x5.8 | Panasonic | 6SVPC330M | 250 | $0.4635 | $115.87 | 25136 |  | $0.58 | $144.80 | P16611CT-ND | Link (http://www.digikey.com/product-detail/en/panasonic-electronic-components/6SVPC330M/P16611CT-ND/4204447) |  |  | $0.47 | $116.66 | 2354770 | Link (http://it.farnell.com/panasonic-electronic-components/6svpc330m/condens-elett-allum-330uf-6-3v/dp/2354770) | 512 |  | $0.58 | $145.25 | 667-6SVPC330M | Link (http://www.mouser.com/Search/Refine.aspx?Keyword=6SVPC330M%20) |  |  | $0.65 | $162.75 | 89Y2716 | Link (http://www.newark.com/webapp/wcs/stores/servlet/Search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) | 240 |  | $0.46 | $115.87 | 795-5459 | Link (http://it.rs-online.com/web/p/condensatori-elettrolitici/7955459/) | 220 |  | $0.5048 | $126.20
U2,U4-U7,U14 | LT6106 |  | TO_SOT_Packages_SMD:SOT-23-5 | Linear Technology | LT6106IS5#TRPBF | 1500 | $1.0100 | $1515.00 | 105 |  | $1.01 | $1515.00 | LT6106IS5#TRMPBFCT-ND | Link (http://www.digikey.com/product-detail/en/linear-technology/LT6106IS5-TRMPBF/LT6106IS5-TRMPBFCT-ND/5965267) |  |  |  |  |  |  |  |  |  |  |  |  |  |  | $1.41 | $2115.00 | 84Y2567 | Link (http://www.newark.com/webapp/wcs/stores/servlet/Search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) |  |  |  |  |  |  | out |  | $1.0100 | $1515.00
D11 | SK152-TP |  | agg:DO-214AB-SMC | Micro Commercial Components | SK152-TP | 250 | $0.4327 | $108.17 |  |  |  |  |  |  |  |  |  |  |  |  |  |  |  |  | Not Assigned | Link (http://www.mouser.com/Search/Refine.aspx?Keyword=SK152-TP%20) |  |  |  |  |  |  |  |  |  |  |  |  | out |  | $0.4327 | $108.17
D9 | Power DC |  | LEDs:LED_D3.0mm_Horizontal_O6.35mm_Z6.0mm | Lite-On Technology | LTL-4291N | 250 | $0.0550 | $13.75 | 2726 |  | $0.09 | $23.46 | 160-1968-ND | Link (http://www.digikey.com/scripts/DkSearch/dksus.dll?WT.z_header=search_go&lang=en) |  |  |  |  |  |  | 5584 |  | $0.06 | $13.75 | 859-LTL-4291N | Link (http://www.mouser.com/Search/Refine.aspx?Keyword=LTL-4291N%20) |  |  |  |  |  |  |  |  |  |  |  |  | 97 |  | $0.2909 | $72.72
R36 | 73K2 |  | Resistors_SMD:R_0805 | Panasonic | ERJ-6ENF7322V | 250 | $0.0080 | $2.00 | 62502 |  | $0.02 | $4.17 | P73.2KCCT-ND | Link (http://www.digikey.com/product-detail/en/panasonic-electronic-components/ERJ-6ENF7322V/P73.2KCCT-ND/119511) |  |  | $0.01 | $3.48 | 2303742 | Link (http://it.farnell.com/panasonic-electronic-components/erj6enf7322v/res-film-spesso-73k2-1-0-125w/dp/2303742) | 11856 |  | $0.01 | $2.25 | 667-ERJ-6ENF7322V | Link (http://www.mouser.com/Search/Refine.aspx?Keyword=ERJ-6ENF7322V%20) |  |  | $0.01 | $2.00 | 53W4905 | Link (http://www.newark.com/panasonic-electronic-components/erj-6enf7322v/res-thick-film-73k2-1-0-125w-0805/dp/53W4905) |  |  | $0.57 | $143.50 | 812-7276 | Link (http://it.rs-online.com/web/c/?searchTerm=ERJ-6ENF7322V%20) | 1212 |  | $0.0111 | $2.77
R28,R38,R45 | 100K |  | Resistors_SMD:R_0805 | Yageo | RC0805JR-07100KL | 750 | $0.0020 | $1.50 | 583667 |  | $0.01 | $5.70 | 311-100KARCT-ND | Link (http://www.digikey.com/product-detail/en/yageo/RC0805JR-07100KL/311-100KARCT-ND/731186) |  |  | $0.01 | $5.74 | 9234250 | Link (http://it.farnell.com/yageo-phycomp/rc0805jr-07100kl/res-film-spesso-100k-5-0-125w/dp/9234250) | 176465 |  | $0.004 | $3.00 | 603-RC0805JR-07100KL | Link (http://www.mouser.com/ProductDetail/Yageo/RC0805JR-07100KL/) |  |  | $0.002 | $1.50 | 12AC2208 | Link (http://www.newark.com/yageo-phycomp/rc0805jr-07100kl/res-thick-film-100k-5-0-125w-0805/dp/12AC2208) |  |  |  |  |  |  | 106878 |  | $0.0071 | $5.33
R3,R4,R6,R8-R10,R13,R15-R17,R19,R26,R27,R30,R39,R40,R42 | 10K |  | Resistors_SMD:R_0805 | Yageo | RC0805JR-0710KL | 4250 | $0.0030 | $12.58 | 2409489 |  | $0.00296 | $12.58 | 311-10KARCT-ND | Link (http://www.digikey.com/product-detail/en/yageo/RC0805JR-0710KL/311-10KARCT-ND/731188) |  |  | $0.01 | $23.94 | 9234136 | Link (http://it.farnell.com/yageo-phycomp/rc0805jr-0710kl/res-film-spesso-10k-5-0-125w-0805/dp/9234136) | 334723 |  | $0.003 | $12.75 | 603-RC0805JR-0710KL | Link (http://www.mouser.com/Search/Refine.aspx?Keyword=RC0805JR-0710KL%20Yageo) |  |  | $0.003 | $12.75 | 68R0258 | Link (http://www.newark.com/yageo/rc0805jr-0710kl/res-thick-film-10k-5-0-125w-0805/dp/68R0258) | 8 |  | $19.29 | $81997.16 | 618-5163 | Link (http://it.rs-online.com/web/c/?searchTerm=RC0805JR-0710KL%20) |  |  |  | $0.00
C41 | 1uF |  | Capacitors_SMD:C_0805 | Taiyo Yuden | EMK212B7105KG-T | 250 | $0.0178 | $4.44 | 33192 |  | $0.04 | $11.00 | 587-1283-1-ND | Link (http://www.digikey.com/product-detail/en/taiyo-yuden/EMK212B7105KG-T/587-1283-1-ND/931060) |  |  | $0.02 | $4.44 | 2371387 | Link (http://it.farnell.com/webapp/wcs/stores/servlet/Search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) | 26687 |  | $0.05 | $11.50 | 963-EMK212B7105KG-T | Link (http://www.mouser.com/Search/Refine.aspx?Keyword=EMK212B7105KG-T%20) |  |  | $0.04 | $10.00 | 77M8436 | Link (http://www.newark.com/taiyo-yuden/emk212b7105kg-t/ceramic-capacitor-1uf-16v-x7r/dp/77M8436) |  |  |  |  |  |  | 2566 |  | $0.3570 | $89.25
C18-C20,C28,C36,C44,C45 | 10uF |  | Capacitors_SMD:C_0805 | Taiyo Yuden | EMK212ABJ106KG-T | 1750 | $0.0147 | $25.72 |  |  | $0.04 | $62.42 | EMK212ABJ106KG-T-ND | Link (http://www.digikey.com/scripts/DkSearch/dksus.dll?WT.z_header=search_go&lang=en) |  |  |  |  |  |  | 31960 |  | $0.04 | $71.75 | 963-EMK212ABJ106KG-T | Link (http://www.mouser.com/Search/Refine.aspx?Keyword=EMK212ABJ106KG-T%20) |  |  | $0.03 | $50.75 | 36X2055 | Link (http://www.newark.com/webapp/wcs/stores/servlet/Search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) |  |  |  |  |  |  | 816 |  | $0.0147 | $25.72
D3 | CD1206-S01575 |  | Diodes_SMD:D_1206 | Bourns | CD1206-S01575 | 250 | $0.0468 | $11.69 | 315000 |  | $0.06 | $14.33 | CD1206-S01575CT-ND | Link (http://www.digikey.com/product-detail/en/bourns-inc/CD1206-S01575/CD1206-S01575CT-ND/3741949) |  |  | $0.06 | $16.08 | 2211947 | Link (http://it.farnell.com/bourns/cd1206-s01575/diodo-commutaz-100v-150ma-1206/dp/2211947) | 45180 |  | $0.05 | $13.50 | 652-CD1206-S01575 | Link (http://www.mouser.com/Search/Refine.aspx?Keyword=CD1206-S01575%20) |  |  | $0.05 | $12.50 | 09J8040 | Link (http://www.newark.com/bourns/cd1206-s01575/diode-switching-100v-150ma-1206/dp/09J8040) | 1500 |  | $0.05 | $11.69 | 773-4514 | Link (http://it.rs-online.com/web/c/?searchTerm=CD1206-S01575%20) | 24086 |  | $0.3760 | $94.00
Y2 | 16.000 Mhz |  | Crystals:Crystal_SMD_5032-4pin_5.0x3.2mm | IQD | LFXTAL058709Cutt | 250 | $0.2553 | $63.83 |  |  |  |  |  |  |  |  |  |  |  |  | 474 |  | $0.29 | $72.50 | 449-LFXTAL058709CUTT | Link (http://www.mouser.com/ProductDetail/IQD/LFXTAL058709Cutt/) |  |  |  |  |  |  |  |  |  |  |  |  | out |  | $0.2553 | $63.83
Y1 | 12Mhz |  | Crystals:Crystal_HC49-SD_SMD | TXC Corporation | 9C-12.000MAAJ-T | 250 | $0.2623 | $65.57 | 7683 |  | $0.31 | $77.00 | 887-1053-1-ND | Link (http://www.digikey.com/product-detail/en/txc-corporation/9C-12.000MAAJ-T/887-1053-1-ND/2118930) |  |  | $0.29 | $73.35 | 1842280 | Link (http://it.farnell.com/txc/9c-12-000maaj-t/xtal-12-000mhz-18pf-smd-hc-49s/dp/1842280) | 790 |  | $0.28 | $70.25 | 717-9C-12.000MAAJ-T | Link (http://www.mouser.com/Search/Refine.aspx?Keyword=9C-12.000MAAJ-T%20) |  |  | $0.29 | $73.50 | 84R5843 | Link (http://www.newark.com/txc/9c-12-000maaj-t/crystal-12mhz-18pf-hc-49s/dp/84R5843) |  |  |  |  |  |  | 107 |  | $0.2623 | $65.57
R37 | 10K |  | Resistors_SMD:R_0805 | Panasonic | ERJ-6ENF1002V | 250 | $0.0040 | $1.00 |  |  | $0.02 | $4.17 | P10.0KCCT-ND | Link (http://www.digikey.com/product-detail/en/panasonic-electronic-components/ERJ-6ENF1002V/P10.0KCCT-ND/119248) |  |  | $0.01 | $3.48 | 2303654 | Link (http://it.farnell.com/panasonic-electronic-components/erj6enf1002v/res-film-spesso-10k-1-0-125w-0805/dp/2303654) | 53833 |  | $0.01 | $2.25 | 667-ERJ-6ENF1002V | Link (http://www.mouser.com/Search/Refine.aspx?Keyword=ERJ-6ENF1002V%20) |  |  | $0.004 | $1.00 | 90W3242 | Link (http://www.newark.com/panasonic-electronic-components/erj-6enf1002v/res-thick-film-10k-1-0-125w-0805/dp/90W3242) | 12 |  |  |  | 732-6031 | Link (http://it.rs-online.com/web/p/resistori-smd/7326031/) |  |  |  | $0.00
U12 | 5v to 3.3v LDO |  | TO_SOT_Packages_SMD:SOT-223-3Lead_TabPin2 | Texas Instruments | UA78M33CDCY | 250 | $0.2934 | $73.35 | 46068 |  | $0.38 | $94.88 | 296-27140-5-ND | Link (http://www.digikey.com/product-detail/en/texas-instruments/UA78M33CDCY/296-27140-5-ND/1910312) |  |  | $0.29 | $73.35 | 2296031 | Link (http://it.farnell.com/texas-instruments/ua78m33cdcy/v-reg-2vdo-0-5a-3-3v-4sot223/dp/2296031) | 3806 |  | $0.30 | $75.25 | 595-UA78M33CDCY | Link (http://www.mouser.com/ProductDetail/Texas-Instruments/UA78M33CDCY/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) |  |  | $0.30 | $75.00 | 03P0895 | Link (http://www.newark.com/texas-instruments/ua78m33cdcy/linear-voltage-regulator-3-3v/dp/03P0895) | 10 |  | $0.43 | $108.43 | 661-6733 | Link (http://it.rs-online.com/web/c/?searchTerm=UA78M33CDCY%20) | 2792 |  | $0.3139 | $78.48
D2 | MC Status |  | LEDs:LED_0603 | OSRAM Opto Semiconductors | LB Q39E-L2OO-35-1 | 250 | $0.0755 | $18.87 |  |  | $0.08 | $18.91 | LBQ39E-L2OO-35-1-ND | Link (http://www.digikey.com/scripts/DkSearch/dksus.dll?WT.z_header=search_go&lang=en) |  |  |  |  |  |  | 7594 |  | $0.08 | $20.50 | 720-LBQ39EL2N2351 | Link (http://www.mouser.com/Search/Refine.aspx?Keyword=LB%20Q39E-L2OO-35-1%20) |  |  |  |  |  |  | 14850 |  | $0.08 | $18.87 | 914-8640 | Link (http://it.rs-online.com/web/c/?searchTerm=LB%20Q39E-L2OO-35-1%20) |  |  |  | $0.00
U3 | ATMEGA32U4-AU |  | Housings_QFP:LQFP-44_10x10mm_Pitch0.8mm | Atmel | ATMEGA32U4-AU | 250 | $3.4196 | $854.90 | 9015 |  | $3.42 | $854.90 | ATMEGA32U4-AU-ND | Link (http://www.digikey.com/product-detail/en/microchip-technology/ATMEGA32U4-AU/ATMEGA32U4-AU-ND/1914602) |  |  | $3.71 | $927.47 | 1748525 | Link (http://it.farnell.com/atmel/atmega32u4-au/mcu-8bit-megaavr-16mhz-tqfp-44/dp/1748525) |  |  |  |  |  |  |  |  | $3.42 | $855.00 | 68T2838 | Link (http://www.newark.com/microchip/atmega32u4-au/microcontroller-mcu-8-bit-megaavr/dp/68T2838) | 8 |  | $5.40 | $1350.01 | 715-3805 | Link (http://it.rs-online.com/web/p/microcontroller/7153805/) | 1487 |  | $4.1540 | $1038.50
C2 | 0.33uF |  | Capacitors_SMD:C_0805 | Samsung Electro-Mechanics | CL21B334KOCNNNC | 250 | $0.0599 | $14.97 | 25231 |  | $0.06 | $14.97 | 1276-1797-1-ND | Link (http://www.digikey.com/product-detail/en/samsung-electro-mechanics-america-inc/CL21B334KOCNNNC/1276-1797-1-ND/3889883) |  |  |  |  |  |  |  |  |  |  |  |  |  |  |  |  |  |  |  |  |  |  | 766-5566 | Link (http://it.rs-online.com/web/c/?searchTerm=CL21B334KOCNNNC%20) | 349 |  | $0.3140 | $78.50
Q2 | CSD16321Q5 |  | Personal:AB2_SON5x6_FET | Texas Instruments | CSD16321Q5 | 250 | $1.1000 | $275.00 | 51153 |  | $1.26 | $315.60 | 296-24517-1-ND | Link (http://www.digikey.com/product-detail/en/texas-instruments/CSD16321Q5/296-24517-1-ND/2062291) |  |  | $1.26 | $316.24 | 1778303 | Link (http://it.farnell.com/texas-instruments/csd16321q5/mosfet-canale-n-25v-100a-8son/dp/1778303) |  |  |  |  |  |  |  |  | $1.10 | $275.00 | 34T4848 | Link (http://www.newark.com/texas-instruments/csd16321q5/n-channel-power-mosfet-nexfet/dp/34T4848) | 1060 |  | $1.42 | $353.98 | 827-4684 | Link (http://it.rs-online.com/web/c/?searchTerm=CSD16321Q5%20) | 2500 |  | $1.2274 | $306.85
C47,C49 | 1uF |  | Capacitors_SMD:C_0805 | Samsung Electro-Mechanics | CL21B105KPFNNNE | 500 | $0.0212 | $10.59 | 65 |  | $0.02 | $10.59 | 1276-1275-1-ND | Link (http://www.digikey.com/product-detail/en/samsung-electro-mechanics-america-inc/CL21B105KPFNNNE/1276-1275-1-ND/3889361) |  |  |  |  |  |  |  |  |  |  |  |  |  |  |  |  |  |  |  |  | $18.86 | $9428.81 | 766-5682 | Link (http://it.rs-online.com/web/c/?searchTerm=CL21B105KPFNNNE%20) | 290 |  | $0.2170 | $108.50
F7,F8 | MSMF050-2 |  | Resistors_SMD:R_1812 | Bourns | MF-MSMF050-2 | 500 | $0.1254 | $62.72 | 66376 |  | $0.13 | $64.90 | MF-MSMF050-2CT-ND | Link (http://www.digikey.com/product-detail/en/bourns-inc/MF-MSMF050-2/MF-MSMF050-2CT-ND/662842) |  |  | $0.13 | $62.72 | 9350314 | Link (http://it.farnell.com/bourns/msmf050-2/fuse-ptc-reset-15v-0-5a-smd/dp/9350314) | 33544 |  | $0.21 | $104.00 | 652-MF-MSMF050-2 | Link (http://www.mouser.com/Search/Refine.aspx?Keyword=MF-MSMF050-2%20) |  |  | $0.20 | $98.00 | 02J2718 | Link (http://www.newark.com/bourns/msmf050-2/fuse-ptc-reset-15v-500ma-1812/dp/02J2718) | 200 |  | $0.23 | $117.46 | 647-8156 | Link (http://it.rs-online.com/web/c/?searchTerm=MF-MSMF050-2%20) | 4631 |  | $0.1517 | $75.85
L8,L9 | WE-CBF |  | Inductors_SMD:L_0603 | WГјrth Elektronik | 742792641 | 1000 | $0.0950 | $95.00 | 39466 |  | $0.14 | $141.00 | 732-1592-1-ND | Link (http://www.digikey.com/product-detail/en/wurth-electronics-inc/742792641/732-1592-1-ND/1639536) |  |  | $0.14 | $140.32 | 1635705 | Link (http://it.farnell.com/wurth-elektronik/742792641/ferrite-perlina-0603-0-15ohm-2a/dp/1635705) | 16821 |  | $0.10 | $95.00 | 710-742792641 | Link (http://www.mouser.com/Search/Refine.aspx?Keyword=742792641%20) |  |  | $0.15 | $150.00 | 08P2436 | Link (http://www.newark.com/wurth-elektronik/742792641/ferrite-bead-0-15ohm-2a-0603/dp/08P2436) | 700 |  | $0.18 | $182.84 | 124-1834 | Link (http://it.rs-online.com/web/c/?searchTerm=742792641%20) |  |  |  | $0.00
C24,C30,C33 | 0.1uF |  | Capacitors_SMD:C_0603 | Yageo | CC0603KPX7R7BB104 | 750 | $0.0040 | $3.00 | 4139218 |  | $0.01 | $5.07 | 311-1088-1-ND | Link (http://www.digikey.com/product-detail/en/yageo/CC0603KRX7R7BB104/311-1088-1-ND/302998) |  |  |  |  |  |  | 9236 |  | $0.004 | $3.00 | 603-C0603KPX7R7BB104 | Link (http://www.mouser.com/Search/Refine.aspx?Keyword=CC0603KPX7R7BB104%20Yageo) |  |  |  |  | 65R8150 | Link (http://www.newark.com/webapp/wcs/stores/servlet/Search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) | 30 |  | $20.34 | $15251.39 | 669-8763 | Link (http://it.rs-online.com/web/c/?searchTerm=CC0603KPX7R7BB104%20) | 12695 |  | $0.0059 | $4.42
C25,C32 | 22pF |  | Capacitors_SMD:C_0603 | Yageo | CC0603JRNPO8BN220 | 500 | $0.0062 | $3.10 |  |  | $0.01 | $3.10 | CC0603JRNPO8BN220-ND | Link (http://www.digikey.com/scripts/DkSearch/dksus.dll?WT.z_header=search_go&lang=en) |  |  |  |  |  |  | 36214 |  | $0.01 | $6.00 | 603-CC603JRNPO8BN220 | Link (http://www.mouser.com/Search/Refine.aspx?Keyword=CC0603JRNPO8BN220%20Yageo) |  |  | $0.03 | $13.50 | 94W2864 | Link (http://www.newark.com/avx/06033a220jat2a/ceramic-capacitor-22pf-25v-c0g/dp/94W2864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) | 2 |  | $8.57 | $4283.89 | 616-9133 | Link (http://it.rs-online.com/web/c/?searchTerm=CC0603JRNPO8BN220%20) |  |  |  | $0.00
U9 | FE1.1s |  | Housings_SSOP:TSSOP-28_4.4x9.7mm_Pitch0.65mm | Terminus | FE1.1s-BSOP28B | 250 | $0.0170 | $4.25 |  |  | 0.35 |  |  |  |  |  |  |  |  |  |  |  |  |  |  |  |  |  |  |  |  |  |  |  |  |  |  |  |  |  | $0.0170 | $4.25
RV1,RV2 | CG0603MLC-05E |  | Inductors_SMD:L_0603 | Bourns | CG0603MLC-05E | 500 | $0.1095 | $54.74 | 199647 |  | $0.20 | $100.84 | CG0603MLC-05ECT-ND | Link (http://www.digikey.com/product-detail/en/bourns-inc/CG0603MLC-05E/CG0603MLC-05ECT-ND/3438061) |  |  | $0.11 | $54.74 | 1838966 | Link (http://it.farnell.com/bourns/cg0603mlc-05e/varistore-supp-protez-esd-20v/dp/1838966) | 30956 |  | $0.14 | $69.50 | 652-CG0603MLC-05E | Link (http://www.mouser.com/Search/Refine.aspx?Keyword=CG0603MLC-05E%20) |  |  | $0.14 | $69.50 | 97M3815 | Link (http://www.newark.com/bourns/cg0603mlc-05e/varistor-5v-20v-0603/dp/97M3815) |  |  | $0.12 | $58.47 | 851-8256 | Link (http://it.rs-online.com/web/c/?searchTerm=CG0603MLC-05E%20) | 12 |  | $0.2751 | $137.55
D10 | SKL14 |  | Diodes_SMD:SOD-123 | Micro Commercial Components | SM5817PL-TP | 250 | $0.0800 | $20.00 |  |  | $0.16 | $40.56 | SM5817PL-TPMSCT-ND | Link (http://www.digikey.com/product-detail/en/micro-commercial-co/SM5817PL-TP/SM5817PL-TPMSCT-ND/1793410) |  |  |  |  |  |  |  |  | $0.12 | $31.00 | 833-SM5817PL-TP | Link (http://www.mouser.com/Search/Refine.aspx?Keyword=SM5817PL-TP%20) |  |  | $0.08 | $20.00 | 69R6425 | Link (http://www.newark.com/webapp/wcs/stores/servlet/Search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) |  |  |  |  |  |  | 217 |  | $0.1164 | $29.10
L3 | 4.7uH 5.2mOhm |  |  | Coilcraft | XAL1010-472MEB | 250 | $4.1300 | $1032.50 |  |  |  |  |  |  |  |  | $4.29 | $1073.63 | 2289017 | Link (http://it.farnell.com/webapp/wcs/stores/servlet/Search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) |  |  | $4.13 | $1032.50 | 994-XAL1010-472MEB | Link (http://www.mouser.com/ProductDetail/Coilcraft/XAL1010-472MEB/) |  |  |  |  |  |  |  |  |  |  |  |  |  |  |  | $0.00
C39 | 15nF |  | Capacitors_SMD:C_0805 | Yageo | CC0805KRX7R9BB153 | 250 | $0.0140 | $3.50 | 46201 |  | $0.03 | $7.50 | 311-1143-1-ND | Link (http://www.digikey.com/product-detail/en/yageo/CC0805KRX7R9BB153/311-1143-1-ND/303053) |  |  | $0.03 | $6.91 | 718658 | Link (http://it.farnell.com/yageo-phycomp/cc0805krx7r9bb153/condensatore-mlcc-x7r-15nf-50v/dp/718658) | 8092 |  | $0.02 | $4.50 | 603-CC805KRX7R9BB153 | Link (http://www.mouser.com/Search/Refine.aspx?Keyword=CC0805KRX7R9BB153%20Yageo) |  |  | $0.01 | $3.50 | 46WX109 | Link (http://www.newark.com/yageo-phycomp/cc0805krx7r9bb153/multilayer-ceramic-capacitor-cc/dp/46WX109) |  |  |  |  |  |  | 2944 |  | $0.0171 | $4.28
P10 | USB_B |  | Connect:USB_B | LUMBERG | 2411 03 | 250 | $0.3970 | $99.25 |  |  |  |  |  |  |  |  | $0.51 | $128.36 | 1308876 | Link (http://it.farnell.com/webapp/wcs/stores/servlet/Search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) |  |  | $0.40 | $99.25 | 651-3241103 | Link (http://www.mouser.com/ProductDetail/Phoenix-Contact/3241103/?qs=sGAEpiMZZMsKdvST4JBTTF%2fsuhVjvd5M) |  |  | $0.98 | $245.25 | 31M6500 | Link (http://www.newark.com/webapp/wcs/stores/servlet/Search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) |  |  |  |  |  |  | 1068 |  | $0.4190 | $104.75
R14,R22-R25,R41,R43,R44,R47 | 100R |  | Resistors_SMD:R_0805 | Yageo | RC0805JR-07100RL | 2250 | $0.0030 | $6.75 | 721568 |  | $0.00341 | $7.67 | 311-100ARCT-ND | Link (http://www.digikey.com/product-detail/en/yageo/RC0805JR-07100RL/311-100ARCT-ND/731185) |  |  | $0.01 | $13.15 | 9233881 | Link (http://it.farnell.com/yageo-phycomp/rc0805jr-07100rl/res-film-spesso-100r-5-0-125w/dp/9233881) | 118519 |  | $0.003 | $6.75 | 603-RC0805JR-07100RL | Link (http://www.mouser.com/ProductDetail/Yageo/RC0805JR-07100RL/?qs=sGAEpiMZZMu61qfTUdNhG5eFuApKbqVdcXVxqHLtdOg%3d) |  |  | $0.003 | $6.75 | 68R0261 | Link (http://www.newark.com/yageo/rc0805jr-07100rl/res-thick-film-100r-5-0-125w-0805/dp/68R0261) | 8 |  | $21.21 | $47715.41 | 618-5135 | Link (http://it.rs-online.com/web/c/?searchTerm=RC0805JR-07100RL%20) | 4041 |  | $0.0068 | $15.30
Q1 | IRFR5305PBF |  | TO_SOT_Packages_SMD1:TO-252-2Lead | Infineon Technologies | QS8J13TR | 250 | $0.2720 | $68.00 | 14494 |  | $0.65 | $162.88 | IRFR5305PBFCT-ND | Link (http://www.digikey.com/product-detail/en/infineon-technologies/IRFR5305TRPBF/IRFR5305PBFCT-ND/812554) |  |  | 0.272 |  | 2101421 | Link (http://it.farnell.com/webapp/wcs/stores/servlet/Search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) |  |  |  |  |  |  |  |  |  |  |  |  |  |  |  |  |  |  | 825 |  | $0.4658 | $116.45
R1,R46 | 470R |  | Resistors_SMD:R_0805 | Yageo | RC0805JR-07470RL | 500 | $0.0040 | $2.00 | 257593 |  | $0.01 | $3.80 | 311-470ARCT-ND | Link (http://www.digikey.com/product-detail/en/yageo/RC0805JR-07470RL/311-470ARCT-ND/731280) |  |  | $0.01 | $3.83 | 9233962 | Link (http://it.farnell.com/yageo-phycomp/rc0805jr-07470rl/res-film-spesso-470r-5-0-125w/dp/9233962) | 106265 |  | $0.004 | $2.00 | 603-RC0805JR-07470RL | Link (http://www.mouser.com/Search/Refine.aspx?Keyword=RC0805JR-07470RL%20Yageo) |  |  | $0.004 | $2.00 | 68R0276 | Link (http://www.newark.com/yageo/rc0805jr-07470rl/res-thick-film-470r-5-0-125w-0805/dp/68R0276) | 2 |  | $19.29 | $9646.73 | 618-2546 | Link (http://it.rs-online.com/web/c/?searchTerm=RC0805JR-07470RL%20) | 458 |  | $0.0068 | $3.40
U1 | 24LC02 |  | Housings_SOIC:SOIC-8_3.9x4.9mm_Pitch1.27mm | Microchip Technology | 24LC02BT-I/SN | 250 | $0.1956 | $48.90 | 6461 |  | $0.26 | $64.00 | 24LC02BT-I/SNCT-ND | Link (http://www.digikey.com/product-detail/en/microchip-technology/24LC02BT-I-SN/24LC02BT-I-SNCT-ND/5011020) |  |  | $0.22 | $55.81 | 2763400 | Link (http://it.farnell.com/webapp/wcs/stores/servlet/Search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) |  |  |  |  |  |  |  |  | $0.36 | $89.75 | 18AC8068 | Link (http://www.newark.com/microchip/24lc02bt-i-sn/eeprom-2kbit-400khz-i2c-soic-8/dp/18AC8068) | 2825 |  | $0.20 | $48.90 | 823-0795 | Link (http://it.rs-online.com/web/c/?searchTerm=24LC02BT-I%2FSN%20) | 93 |  | $0.2627 | $65.67
U10 | ESP-07v2 |  | ESP8266:ESP-12E |  |  | 250 | $2.0000 | $500.00 |  |  | 2 |  |  |  |  |  |  |  |  |  |  |  |  |  |  |  |  |  |  |  |  |  |  |  |  |  |  |  |  |  |  | $0.00
TP1 | TEST |  | Measurement_Points:Measurement_Point_Round-SMD-Pad_Small |  |  | 250 | $0.0000 | $0.00 |  |  |  |  |  |  |  |  |  |  |  |  |  |  |  |  |  |  |  |  |  |  |  |  |  |  |  |  |  |  |  |  |  | $0.00
F1-F6 | F_Small |  | Fuse_Holders_and_Fuses:Fuse_SMD1206_Reflow | BEL Group | C1S 3.5 | 1500 | $0.1330 | $199.50 |  |  |  |  |  |  |  |  |  |  |  |  | 13865 |  | $0.13 | $199.50 | 530-C1S3.5 | Link (http://www.mouser.com/ProductDetail/Bel-Fuse/C1S-35/) |  |  |  |  |  |  |  |  |  |  |  |  | 4756 |  | $0.2005 | $300.75
P8 | CONN_01X03 |  | Pin_Headers:Pin_Header_Straight_1x03 |  |  | 250 | $0.0000 | $0.00 |  |  |  |  |  |  |  |  |  |  |  |  |  |  |  |  |  |  |  |  |  |  |  |  |  |  |  |  |  |  |  |  |  | $0.00
L1 | MH2029-300Y |  | Inductors_SMD:L_0805 | Bourns | MH2029-300Y | 250 | $0.0270 | $6.75 | 29894 |  | $0.0272 | $6.81 | MH2029-300YCT-ND | Link (http://www.digikey.com/product-detail/en/bourns-inc/MH2029-300Y/MH2029-300YCT-ND/3741761) |  |  | $0.17 | $42.79 | 1635729 | Link (http://it.farnell.com/wurth-elektronik/74279206/ferrite-bead-0-025ohm-3a-0805/dp/1635729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) | 9 |  | $0.0270 | $6.75 | 652-MH2029-300Y | Link (http://www.mouser.com/Search/Refine.aspx?Keyword=MH2029-300Y%20) |  |  |  | $0.00 | 02J2762 | Link (http://www.newark.com/bourns/mh2029-300y/ferrite-bead-0805-0-025ohm-3a/dp/02J2762) |  |  |  |  |  |  | 4000 |  | $0.0324 | $8.10
LED1-LED4 | Led_Small |  | Inductors_SMD:L_1806 | Kingbright | APA3010CGCK-GX | 1000 | $0.1050 | $105.00 | 13329 |  | $0.11 | $110.88 | 754-1580-1-ND | Link (http://www.digikey.com/product-detail/en/kingbright/APA3010CGCK-GX/754-1580-1-ND/2757947) |  |  | $0.15 | $146.00 | 3229580 | Link (http://it.farnell.com/webapp/wcs/stores/servlet/Search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) | 9872 |  | $0.10 | $105.00 | 604-APA3010CGCK-GX | Link (http://www.mouser.com/Search/Refine.aspx?Keyword=APA3010CGCK-GX%20) |  |  |  |  |  |  |  |  |  |  |  |  |  |  |  | $0.00
L2,L5-L7,L10 | WE-CNSW |  | Inductors_SMD:L_1206 | WГјrth Elektronik | 744232090 | 1250 | $0.7824 | $977.96 | 4911 |  | $0.82 | $1028.75 | 732-1469-1-ND | Link (http://www.digikey.com/product-detail/en/wurth-electronics-inc/744232090/732-1469-1-ND/1639481) |  |  | $0.78 | $977.96 | 1636474 | Link (http://it.farnell.com/wurth-elektronik/744232090/filtro-comune-emi-0-37a/dp/1636474) | 21631 |  | $1.00 | $1250.00 | 710-744232090 | Link (http://www.mouser.com/Search/Refine.aspx?Keyword=744232090%20) |  |  | $1.00 | $1250.00 | 08P2547 | Link (http://www.newark.com/webapp/wcs/stores/servlet/Search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) | 165 |  | $1.16 | $1453.65 | 500-3032 | Link (http://it.rs-online.com/web/p/induttori-avvolti-smd/5003032/) |  |  |  | $0.00
L4 | Bead/100MHZ/470ohm/2A |  | Resistors_SMD:R_0805_HandSoldering | Murata Electronics | BLM41PG471SN1L | 250 | $0.1530 | $38.25 | 58880 |  | $0.15 | $38.26 | 490-1060-1-ND | Link (http://www.digikey.com/product-detail/en/murata-electronics-north-america/BLM41PG471SN1L/490-1060-1-ND/584506) |  |  |  |  |  |  | 4039 |  | $0.15 | $38.25 | 81-BLM41PG471SN1L | Link (http://www.mouser.com/Search/Refine.aspx?Keyword=BLM41PG471SN1L%20) |  |  |  |  |  |  | 175 |  | $0.15 | $38.27 | 724-1602 | Link (http://it.rs-online.com/web/c/?searchTerm=BLM41PG471SN1L%20) | 6153 |  | $0.1578 | $39.45
R2,R11,R12,R18,R20,R21 | 0.02R |  | Resistors_SMD:R_1206 | Panasonic | ERJ8CWFR020V | 1500 | $0.1230 | $184.50 | 32426 |  | $0.13 | $189.57 | P0.02BVCT-ND | Link (http://www.digikey.com/product-detail/en/panasonic-electronic-components/ERJ-8CWFR020V/P0.02BVCT-ND/4927042) |  |  | $0.16 | $245.55 | 2145291 | Link (http://it.farnell.com/panasonic-electronic-components/erj8cwfr020v/resistore-pellicola-spessa-0-02/dp/2145291) | 20374 |  | $0.12 | $184.50 | 667-ERJ-8CWFR020V | Link (http://www.mouser.com/Search/Refine.aspx?Keyword=ERJ8CWFR020V%20) |  |  | $0.12 | $184.50 | 63W1419 | Link (http://www.newark.com/panasonic-electronic-components/erj8cwfr020v/smd-current-sense-resistors-aec/dp/63W1419) | 2 |  |  |  | 106-7117 | Link (http://it.rs-online.com/web/p/resistori-smd/1067117/) | 3558 |  | $0.6763 | $1014.45
C11-C14,C21-C23,C42 | 1nF |  | Capacitors_SMD:C_0805 | KEMET Corporation | C0805C102K5RACTU | 2000 | $0.0088 | $17.65 | 877870 |  | $0.01 | $21.60 | 399-1147-1-ND | Link (http://www.digikey.com/product-detail/en/kemet/C0805C102K5RACTU/399-1147-1-ND/411422) |  |  | $0.01 | $17.65 | 1414660 | Link (http://it.farnell.com/kemet/c0805c102k5ractu/condensatore-mlcc-x7r-1nf-50v/dp/1414660) |  |  |  |  |  |  |  |  | $0.01 | $22.00 | 64K2881 | Link (http://www.newark.com/kemet/c0805c102k5ractu/ceramic-capacitor-1000pf-50v-x7r/dp/64K2881) | 5300 |  | $0.01 | $25.51 | 264-4337 | Link (http://it.rs-online.com/web/c/?searchTerm=C0805C102K5RACTU%20) | 1738 |  | $0.0133 | $26.60
P13 | Burn |  | Pin_Headers:Pin_Header_Straight_2x01 |  |  | 250 | $0.0000 | $0.00 |  |  |  |  |  |  |  |  |  |  |  |  |  |  |  |  |  |  |  |  |  |  |  |  |  |  |  |  |  |  |  |  |  | $0.00
SW2 | Reset |  | Buttons_Switches_SMD:SW_SPST_B3U-3000P |  |  | 250 | $0.0000 | $0.00 |  |  |  |  |  |  |  |  |  |  |  |  |  |  |  |  |  |  |  |  |  |  |  |  |  |  |  |  |  |  |  |  |  | $0.00
U11 | LTC4412 | Testing pass | TO_SOT_Packages_SMD:SOT-23-6 | Linear Technology | LTC4412ES6#TRMPBF | 250 | $1.5800 | $395.00 | 27385 |  | $1.75 | $437.25 | LTC4412ES6#TRMPBFCT-ND | Link (http://www.digikey.com/product-detail/en/linear-technology/LTC4412ES6-TRMPBF/LTC4412ES6-TRMPBFCT-ND/890097) |  |  | $1.59 | $398.62 | 1663917 | Link (http://it.farnell.com/linear-technology/ltc4412es6-trmpbf/ic-power-path-controller-tsot23/dp/1663917) |  |  |  |  |  |  |  |  | $1.59 | $397.50 | 56M9516 | Link (http://www.newark.com/linear-technology/ltc4412es6-trmpbf/hot-swap-controller-28v-tsot-23/dp/56M9516) | 33 |  | $2.57 | $643.12 | 471-415 | Link (http://it.rs-online.com/web/p/controller-hot-swap/0471415/) | 2612 |  | $1.5800 | $395.00
C31,C37,C51 | 47uF |  | Capacitors_SMD:C_1206 | TDK | C3216X5R1E476M160AC | 750 | $0.3380 | $253.50 |  |  | $0.54 | $403.21 | 445-8047-1-ND | Link (http://www.digikey.com/product-detail/en/tdk-corporation/C3216X5R1E476M160AC/445-8047-1-ND/2792164) |  |  | $0.35 | $264.69 | 2525172 | Link (http://it.farnell.com/tdk/c3216x5r1e476m160ac/condensatore-mlcc-x5r-47uf-25v/dp/2525172) | 417 |  | $0.54 | $405.00 | 810-C3216X5R1E476M | Link (http://www.mouser.com/Search/Refine.aspx?Keyword=C3216X5R1E476M160AC%20TDK) |  |  | $0.34 | $253.50 | 65T7805 | Link (http://www.newark.com/tdk/c3216x5r1e476m160ac/ceramic-capacitor-47uf-25v-x5r/dp/65T7805) |  |  | $1.14 | $853.06 | 788-3060 | Link (http://it.rs-online.com/web/p/condensatori-ceramici-multistrato/7883060/) |  |  |  | $0.00
C46 | 22uF |  | Capacitors_Tantalum_SMD:CP_Tantalum_Case-R_EIA-2012-12_Reflow | AVX | F920J226MPA | 250 | $0.1170 | $29.25 | 56909 |  | $0.20 | $49.65 | 478-8119-1-ND | Link (http://www.digikey.com/product-detail/en/avx-corporation/F920J226MPA/478-8119-1-ND/4005716) |  |  |  |  |  |  | 9599 |  | $0.17 | $41.75 | 647-F920J226MPA | Link (http://www.mouser.com/ProductDetail/AVX/F920J226MPA/?qs=sGAEpiMZZMuEN2agSAc2puC4lhRhLeol0maKbKPpiSU%3d) |  |  | $0.12 | $29.25 | 54K5145 | Link (http://www.newark.com/webapp/wcs/stores/servlet/Search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) |  |  | $0.18 | $44.38 | 136-2649 | Link (http://it.rs-online.com/web/p/condensatori-al-tantalio/1362649/) | 3678 |  | $0.1751 | $43.77
P7 | CONN_01X09 |  | Pin_Headers:Pin_Header_Straight_1x09_Pitch2.54mm |  |  | 250 | $0.0000 | $0.00 |  |  |  |  |  |  |  |  |  |  |  |  |  |  |  |  |  |  |  |  |  |  |  |  |  |  |  |  |  |  |  |  |  | $0.00
R48,R49 | 150R |  | Resistors_SMD:R_0805 | Yageo | RC0805JR-07150RL | 500 | $0.0040 | $2.00 | 243058 |  | $0.01 | $3.80 | 311-150ARCT-ND | Link (http://www.digikey.com/product-detail/en/yageo/RC0805JR-07150RL/311-150ARCT-ND/731202) |  |  | $0.01 | $4.20 | 9233903 | Link (http://it.farnell.com/yageo-phycomp/rc0805jr-07150rl/res-film-spesso-150r-5-0-125w/dp/9233903) | 39670 |  | $0.004 | $2.00 | 603-RC0805JR-07150RL | Link (http://www.mouser.com/ProductDetail/Yageo/RC0805JR-07150RL/?qs=sGAEpiMZZMu61qfTUdNhG5eFuApKbqVdPgkp9m8x55I%3d) |  |  | $0.004 | $2.00 | 68R0262 | Link (http://www.newark.com/yageo/rc0805jr-07150rl/res-thick-film-150r-5-0-125w-0805/dp/68R0262) | 13 |  | $5.49 | $2742.54 | 618-3432 | Link (http://it.rs-online.com/web/c/?searchTerm=RC0805JR-07150RL%20) | 220 |  | $0.0071 | $3.55
R31 | 330 |  | Resistors_SMD:R_0805 | Yageo | RC0805JR-07330RL | 250 | $0.0050 | $1.25 | 424076 |  | $0.01 | $1.90 | 311-330ARCT-ND | Link (http://www.digikey.com/product-detail/en/yageo/RC0805JR-07330RL/311-330ARCT-ND/731258) |  |  | $0.01 | $2.44 | 9233946 | Link (http://it.farnell.com/yageo-phycomp/rc0805jr-07330rl/res-film-spesso-330r-5-0-125w/dp/9233946) |  |  |  |  |  |  |  |  | $0.01 | $1.25 | 68R0272 | Link (http://www.newark.com/yageo/rc0805jr-07330rl/res-thick-film-330r-5-0-125w-0805/dp/68R0272) | 9 |  | $5.49 | $1371.27 | 618-3195 | Link (http://it.rs-online.com/web/c/?searchTerm=RC0805JR-07330RL%20) | 4176 |  | $0.0068 | $1.70
R5 | 15K |  | Resistors_SMD:R_0805 | Yageo | RC0805JR-0715KL | 250 | $0.0040 | $1.00 | 186442 |  | $0.01 | $1.90 | 311-15KARCT-ND | Link (http://www.digikey.com/product-detail/en/yageo/RC0805JR-0715KL/311-15KARCT-ND/731205) |  |  | $0.01 | $2.47 | 9234152 | Link (http://it.farnell.com/yageo-phycomp/rc0805jr-0715kl/res-film-spesso-15k-5-0-125w-0805/dp/9234152) | 13578 |  | $0.004 | $1.00 | 603-RC0805JR-0715KL | Link (http://www.mouser.com/ProductDetail/Yageo/RC0805JR-0715KL/) |  |  | $0.01 | $1.25 | 26M6821 | Link (http://www.newark.com/webapp/wcs/stores/servlet/Search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) |  |  |  |  |  |  | 4368 |  | $0.0078 | $1.95
R29 | 2.7K |  | Resistors_SMD:R_0805 | MULTICOMP | MCWR08X2701FTL | 250 | $0.0040 | $1.00 |  |  |  |  |  |  |  |  | $0.0043583 | $1.09 | 2447627 | Link (http://it.farnell.com/multicomp/mcwr08x2701ftl/resist-film-spesso-2-7kohm-1-0/dp/2447627) |  |  |  |  |  |  |  |  | $0.004 | $1.00 | 94X1945 | Link (http://www.newark.com/multicomp/mcwr08x2701ftl/surface-mount-chip-resistor-thick/dp/94X1945) |  |  |  |  |  |  |  |  |  | $0.00
P1-P6 | USB_A |  | USB_A_Vertical:USB_A_Vertical | Wurth Electronics | 614004184726 | 1500 | $0.7664 | $1149.63 | 624 |  | $0.81 | $1210.95 | 732-10010-ND | Link (http://www.digikey.com/scripts/DkSearch/dksus.dll?WT.z_header=search_go&lang=en) |  |  | $0.77 | $1149.63 | 2617113 | Link (http://it.farnell.com/webapp/wcs/stores/servlet/Search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) | 826 |  | $0.79 | $1179.00 | 710-614004184726 | Link (http://www.mouser.com/Search/Refine.aspx?Keyword=614004184726%20) |  |  | $0.92 | $1375.50 | 96Y9883 | Link (http://www.newark.com/webapp/wcs/stores/servlet/Search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) |  |  |  |  |  |  |  |  |  | $0.00
P11,P12 | CONN_02X04 |  | Socket_Strips:Socket_Strip_Straight_2x04 |  |  | 500 | $0.0000 | $0.00 |  |  |  |  |  |  |  |  |  |  |  |  |  |  |  |  |  |  |  |  |  |  |  |  |  |  |  |  |  |  |  |  |  | $0.00
R34 | 237K |  | Resistors_SMD:R_0805 | Panasonic | ERJ-6ENF2373V | 250 | $0.0080 | $2.00 | 79530 |  | $0.02 | $4.17 | P237KCCT-ND | Link (http://www.digikey.com/product-detail/en/panasonic-electronic-components/ERJ-6ENF2373V/P237KCCT-ND/119658) |  |  | $0.01 | $3.48 | 2303801 | Link (http://it.farnell.com/panasonic-electronic-components/erj6enf2373v/res-film-spesso-237k-1-0-125w/dp/2303801) | 31165 |  | $0.01 | $2.25 | 667-ERJ-6ENF2373V | Link (http://www.mouser.com/Search/Refine.aspx?Keyword=ERJ-6ENF2373V%20) |  |  | $0.01 | $2.00 | 90W3378 | Link (http://www.newark.com/panasonic-electronic-components/erj-6enf2373v/res-thick-film-237k-1-0-125w-0805/dp/90W3378) |  |  | $0.54 | $135.53 | 814-4710 | Link (http://it.rs-online.com/web/c/?searchTerm=ERJ-6ENF2373V%20) | 4579 |  | $0.0103 | $2.58
C26,C52 | 18pF |  | Capacitors_SMD:C_0805 | Samsung Electro-Mechanics | CL21C180JBANNNC | 500 | $0.0052 | $2.60 | 177389 |  | $0.02 | $7.70 | 1276-1107-1-ND | Link (http://www.digikey.com/product-detail/en/samsung-electro-mechanics-america-inc/CL21C180JBANNNC/1276-1107-1-ND/3889193) |  |  |  |  |  |  |  |  |  |  |  |  |  |  |  |  |  |  | 1 |  | $11.62 | $5809.30 | 766-5809 | Link (http://it.rs-online.com/web/c/?searchTerm=CL21C180JBANNNC%20) | 704 |  | $0.0052 | $2.60
U13 | LM3150 |  | Housings_SSOP:SSOP-14_5.3x6.2mm_Pitch0.65mm | Texas Instruments | LM3150MH/NOPB | 250 | $2.7000 | $675.00 | 597 |  | $2.87 | $718.25 | LM3150MH/NOPB-ND | Link (http://www.digikey.com/scripts/DkSearch/dksus.dll?WT.z_header=search_go&lang=en) |  |  | $2.70 | $675.00 | 2323532 | Link (http://it.farnell.com/webapp/wcs/stores/servlet/Search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) |  |  |  |  |  |  |  |  | $2.72 | $680.00 | 96W2973 | Link (http://www.newark.com/webapp/wcs/stores/servlet/Search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) | 27 |  | $2.92 | $730.81 | 660-6128 | Link (http://it.rs-online.com/web/c/?searchTerm=LM3150MH%2FNOPB%20) | out |  |  | $0.00
 |  |  | LCD+PCB+Case |  |  | 250 | $30.6200 | $7655.00 |  |  | $30.62 |  |  |  |  |  |  |  |  |  |  |  |  |  |  |  |  |  |  |  |  |  |  |  |  |  |  |  |  |  |  | $0.00
 |  |  | PCB+Assembly | PCBWay |  | 250 | $4.1000 | $1025.00 |  |  | $4.10 |  |  |  |  |  |  |  |  |  |  |  |  |  |  |  |  |  |  |  |  |  |  |  |  |  |  |  |  |  |  | $0.00
 |  |  | LCD | Buydisplay.com |  |  |  |  |  |  | $11.52
 |  |  | Case |  |  |  |  |  |  |  | $15.00
 |  |  |  | PCBWay shipping |  |  |  | 65
 |  | Unit sell price | $90.00 |  | Crowtfunding loan | 5%
 |  | Profit per unit | $13.72 |  | Crowtfunding price | $1125.00
 |  | Full profit per Qty | $3428.92
 |  |  |  |  | My profit | $2303.92
 |  | Qty sold by | $22500.00
 |  |  | $3428.92
