aleksejm/6xUSB-Power-Meter/Hardware/PCB/Book1.xlsx

version | source | date | tool | number | name | tstamps | title | company | rev | date2 | source3 | number4 | value | ref | value5 | footprint | datasheet | field | name6 | lib | part | names | tstamps7 | tstamp | lib8 | part9 | alias | description | docs | fp | field10 | name11 | num | name12 | type | logical | uri | code | name13 | ref14 | pin
D | C:\Users\aleks\OneDrive\GitHub\6xUSB-Power-Meter\Hardware\PCB\6xUSB_PowMet.sch | 01/08/2017 22:26:18 | Eeschema 4.0.6 | 1 | / | / |  |  |  |  | 6xUSB_PowMet.sch | 1
D | C:\Users\aleks\OneDrive\GitHub\6xUSB-Power-Meter\Hardware\PCB\6xUSB_PowMet.sch | 01/08/2017 22:26:18 | Eeschema 4.0.6 | 1 | / | / |  |  |  |  | 6xUSB_PowMet.sch | 2
D | C:\Users\aleks\OneDrive\GitHub\6xUSB-Power-Meter\Hardware\PCB\6xUSB_PowMet.sch | 01/08/2017 22:26:18 | Eeschema 4.0.6 | 1 | / | / |  |  |  |  | 6xUSB_PowMet.sch | 3
D | C:\Users\aleks\OneDrive\GitHub\6xUSB-Power-Meter\Hardware\PCB\6xUSB_PowMet.sch | 01/08/2017 22:26:18 | Eeschema 4.0.6 | 1 | / | / |  |  |  |  | 6xUSB_PowMet.sch | 4
D | C:\Users\aleks\OneDrive\GitHub\6xUSB-Power-Meter\Hardware\PCB\6xUSB_PowMet.sch | 01/08/2017 22:26:18 | Eeschema 4.0.6 | 2 | /USB hub/ | /571758E7/ |  |  |  |  | USB_hub.sch | 1
D | C:\Users\aleks\OneDrive\GitHub\6xUSB-Power-Meter\Hardware\PCB\6xUSB_PowMet.sch | 01/08/2017 22:26:18 | Eeschema 4.0.6 | 2 | /USB hub/ | /571758E7/ |  |  |  |  | USB_hub.sch | 2
D | C:\Users\aleks\OneDrive\GitHub\6xUSB-Power-Meter\Hardware\PCB\6xUSB_PowMet.sch | 01/08/2017 22:26:18 | Eeschema 4.0.6 | 2 | /USB hub/ | /571758E7/ |  |  |  |  | USB_hub.sch | 3
D | C:\Users\aleks\OneDrive\GitHub\6xUSB-Power-Meter\Hardware\PCB\6xUSB_PowMet.sch | 01/08/2017 22:26:18 | Eeschema 4.0.6 | 2 | /USB hub/ | /571758E7/ |  |  |  |  | USB_hub.sch | 4
D |  |  |  |  |  |  |  |  |  |  |  |  |  | U2 | LT6106 | TO_SOT_Packages_SMD:SOT-23-5 | http://static6.arrow.com/aropdfconversion/8b6405b3cc635e5cb55e8c67a047617597ae70a1/43127956299691224992.pdf | Linear Technology | Manufacturer | 6xUSB_PowMet-cache | LT6106-RESCUE-6xUSB_PowMet | / | / | 570E2B6B
D |  |  |  |  |  |  |  |  |  |  |  |  |  | U2 | LT6106 | TO_SOT_Packages_SMD:SOT-23-5 | http://static6.arrow.com/aropdfconversion/8b6405b3cc635e5cb55e8c67a047617597ae70a1/43127956299691224992.pdf | LT6106IS5#TRPBF | Part Number | 6xUSB_PowMet-cache | LT6106-RESCUE-6xUSB_PowMet | / | / | 570E2B6B
D |  |  |  |  |  |  |  |  |  |  |  |  |  | R6 | 10K | Resistors_SMD:R_0805 |  |  |  | device | R | / | / | 570E382E
D |  |  |  |  |  |  |  |  |  |  |  |  |  | R5 | 15K | Resistors_SMD:R_0805 |  |  |  | device | R | / | / | 570E46E8
D |  |  |  |  |  |  |  |  |  |  |  |  |  | R4 | 10K | Resistors_SMD:R_0805 |  |  |  | device | R | / | / | 570E4833
D |  |  |  |  |  |  |  |  |  |  |  |  |  | C7 | 1n | Capacitors_SMD:C_0805 |  |  |  | device | C | / | / | 570E48BE
D |  |  |  |  |  |  |  |  |  |  |  |  |  | C4 | 1n | Capacitors_SMD:C_0805 |  |  |  | device | C | / | / | 570E6D6B
D |  |  |  |  |  |  |  |  |  |  |  |  |  | C1 | 100n | Capacitors_SMD:C_0805 |  |  |  | device | C | / | / | 570E6DE6
D |  |  |  |  |  |  |  |  |  |  |  |  |  | R3 | 10K | Resistors_SMD:R_0805 |  |  |  | device | R | / | / | 570E6E51
D |  |  |  |  |  |  |  |  |  |  |  |  |  | R1 | 100R | Resistors_SMD:R_0805 |  |  |  | device | R | / | / | 570E73AC
D |  |  |  |  |  |  |  |  |  |  |  |  |  | C12 | 1n | Capacitors_SMD:C_0805 |  |  |  | device | C | / | / | 570E7C7B
D |  |  |  |  |  |  |  |  |  |  |  |  |  | C15 | 100n | Capacitors_SMD:C_0805 |  |  |  | device | C | / | / | 570E7C81
D |  |  |  |  |  |  |  |  |  |  |  |  |  | R13 | 10K | Resistors_SMD:R_0805 |  |  |  | device | R | / | / | 570E7C87
D |  |  |  |  |  |  |  |  |  |  |  |  |  | R16 | 100R | Resistors_SMD:R_0805 |  |  |  | device | R | / | / | 570E7C9D
D |  |  |  |  |  |  |  |  |  |  |  |  |  | C2 | 1n | Capacitors_SMD:C_0805 |  |  |  | device | C | / | / | 570EDECE
D |  |  |  |  |  |  |  |  |  |  |  |  |  | C10 | 100n | Capacitors_SMD:C_0805 |  |  |  | device | C | / | / | 570EDED4
D |  |  |  |  |  |  |  |  |  |  |  |  |  | R7 | 10K | Resistors_SMD:R_0805 |  |  |  | device | R | / | / | 570EDEDA
D |  |  |  |  |  |  |  |  |  |  |  |  |  | R9 | 100R | Resistors_SMD:R_0805 |  |  |  | device | R | / | / | 570EDEEF
D |  |  |  |  |  |  |  |  |  |  |  |  |  | R11 | 0.02R | Resistors_SMD:R_1206 | https://www.elfadistrelec.lv/Web/Downloads/_t/ds/erj8cw_eng_tds.pdf?mime=application%2Fpdf | ERJ8CWFR020V | Part Number | device | R | / | / | 570EDEFE
D |  |  |  |  |  |  |  |  |  |  |  |  |  | R11 | 0.02R | Resistors_SMD:R_1206 | https://www.elfadistrelec.lv/Web/Downloads/_t/ds/erj8cw_eng_tds.pdf?mime=application%2Fpdf | Panasonic | Manufacturer | device | R | / | / | 570EDEFE
D |  |  |  |  |  |  |  |  |  |  |  |  |  | R11 | 0.02R | Resistors_SMD:R_1206 | https://www.elfadistrelec.lv/Web/Downloads/_t/ds/erj8cw_eng_tds.pdf?mime=application%2Fpdf | Res Thick Film 1206 0.02 Ohm 1% 1W ±50ppm/°C Pad SMD Automotive T/R | Description | device | R | / | / | 570EDEFE
D |  |  |  |  |  |  |  |  |  |  |  |  |  | R11 | 0.02R | Resistors_SMD:R_1206 | https://www.elfadistrelec.lv/Web/Downloads/_t/ds/erj8cw_eng_tds.pdf?mime=application%2Fpdf | 1% | Tolerance | device | R | / | / | 570EDEFE
D |  |  |  |  |  |  |  |  |  |  |  |  |  | C14 | 1n | Capacitors_SMD:C_0805 |  |  |  | device | C | / | / | 570EE257
D |  |  |  |  |  |  |  |  |  |  |  |  |  | C17 | 100n | Capacitors_SMD:C_0805 |  |  |  | device | C | / | / | 570EE25D
D |  |  |  |  |  |  |  |  |  |  |  |  |  | R15 | 10K | Resistors_SMD:R_0805 |  |  |  | device | R | / | / | 570EE263
D |  |  |  |  |  |  |  |  |  |  |  |  |  | R19 | 100R | Resistors_SMD:R_0805 |  |  |  | device | R | / | / | 570EE278
D |  |  |  |  |  |  |  |  |  |  |  |  |  | C3 | 1n | Capacitors_SMD:C_0805 |  |  |  | device | C | / | / | 570EE6B5
D |  |  |  |  |  |  |  |  |  |  |  |  |  | C11 | 100n | Capacitors_SMD:C_0805 |  |  |  | device | C | / | / | 570EE6BB
D |  |  |  |  |  |  |  |  |  |  |  |  |  | R8 | 10K | Resistors_SMD:R_0805 |  |  |  | device | R | / | / | 570EE6C1
D |  |  |  |  |  |  |  |  |  |  |  |  |  | R10 | 100R | Resistors_SMD:R_0805 |  |  |  | device | R | / | / | 570EE6D6
D |  |  |  |  |  |  |  |  |  |  |  |  |  | C13 | 1n | Capacitors_SMD:C_0805 |  |  |  | device | C | / | / | 570EEA21
D |  |  |  |  |  |  |  |  |  |  |  |  |  | C16 | 100n | Capacitors_SMD:C_0805 |  |  |  | device | C | / | / | 570EEA27
D |  |  |  |  |  |  |  |  |  |  |  |  |  | R14 | 10K | Resistors_SMD:R_0805 |  |  |  | device | R | / | / | 570EEA2D
D |  |  |  |  |  |  |  |  |  |  |  |  |  | R17 | 100R | Resistors_SMD:R_0805 |  |  |  | device | R | / | / | 570EEA42
D |  |  |  |  |  |  |  |  |  |  |  |  |  | P1 | USB_A | USB_A_Vertical:USB_A_Vertical |  |  |  | 6xUSB_PowMet-rescue | USB_A-RESCUE-6xUSB_PowMet | / | / | 5710A0F2
D |  |  |  |  |  |  |  |  |  |  |  |  |  | P4 | USB_A | USB_A_Vertical:USB_A_Vertical |  |  |  | 6xUSB_PowMet-rescue | USB_A-RESCUE-6xUSB_PowMet | / | / | 5710A8AC
D |  |  |  |  |  |  |  |  |  |  |  |  |  | P2 | USB_A | USB_A_Vertical:USB_A_Vertical |  |  |  | 6xUSB_PowMet-rescue | USB_A-RESCUE-6xUSB_PowMet | / | / | 5710A975
D |  |  |  |  |  |  |  |  |  |  |  |  |  | P5 | USB_A | USB_A_Vertical:USB_A_Vertical |  |  |  | 6xUSB_PowMet-rescue | USB_A-RESCUE-6xUSB_PowMet | / | / | 5710B4D7
D |  |  |  |  |  |  |  |  |  |  |  |  |  | P3 | USB_A | USB_A_Vertical:USB_A_Vertical |  |  |  | 6xUSB_PowMet-rescue | USB_A-RESCUE-6xUSB_PowMet | / | / | 5710B5A7
D |  |  |  |  |  |  |  |  |  |  |  |  |  | P6 | USB_A | USB_A_Vertical:USB_A_Vertical |  |  |  | 6xUSB_PowMet-rescue | USB_A-RESCUE-6xUSB_PowMet | / | / | 5710B3D1
D |  |  |  |  |  |  |  |  |  |  |  |  |  | P8 | CONN_01X03 | Pin_Headers:Pin_Header_Straight_1x03 |  |  |  | conn | CONN_01X03 | / | / | 571174BB
D |  |  |  |  |  |  |  |  |  |  |  |  |  | F1 | F_Small | Fuse_Holders_and_Fuses:Fuse_SMD1206_HandSoldering |  |  |  | 6xUSB_PowMet-cache | F_Small | / | / | 571A9766
D |  |  |  |  |  |  |  |  |  |  |  |  |  | F2 | F_Small | Fuse_Holders_and_Fuses:Fuse_SMD1206_HandSoldering |  |  |  | 6xUSB_PowMet-cache | F_Small | / | / | 571ABA94
D |  |  |  |  |  |  |  |  |  |  |  |  |  | F3 | F_Small | Fuse_Holders_and_Fuses:Fuse_SMD1206_HandSoldering |  |  |  | 6xUSB_PowMet-cache | F_Small | / | / | 571ABBEE
D |  |  |  |  |  |  |  |  |  |  |  |  |  | F4 | F_Small | Fuse_Holders_and_Fuses:Fuse_SMD1206_HandSoldering |  |  |  | 6xUSB_PowMet-cache | F_Small | / | / | 571ABCE5
D |  |  |  |  |  |  |  |  |  |  |  |  |  | F5 | F_Small | Fuse_Holders_and_Fuses:Fuse_SMD1206_HandSoldering |  |  |  | 6xUSB_PowMet-cache | F_Small | / | / | 571ABE05
D |  |  |  |  |  |  |  |  |  |  |  |  |  | F6 | F_Small | Fuse_Holders_and_Fuses:Fuse_SMD1206_HandSoldering |  |  |  | 6xUSB_PowMet-cache | F_Small | / | / | 571ABEF2
D |  |  |  |  |  |  |  |  |  |  |  |  |  | C18 | 10uF | Capacitors_SMD:C_0805 |  |  |  | device | C_Small | / | / | 571B50F2
D |  |  |  |  |  |  |  |  |  |  |  |  |  | C19 | 10uF | Capacitors_SMD:C_0805 |  |  |  | device | C_Small | / | / | 571B5652
D |  |  |  |  |  |  |  |  |  |  |  |  |  | C20 | 10uF | Capacitors_SMD:C_0805 |  |  |  | device | C_Small | / | / | 571B5934
D |  |  |  |  |  |  |  |  |  |  |  |  |  | C21 | 10uF | Capacitors_SMD:C_0805 |  |  |  | device | C_Small | / | / | 571B5A3D
D |  |  |  |  |  |  |  |  |  |  |  |  |  | C22 | 10uF | Capacitors_SMD:C_0805 |  |  |  | device | C_Small | / | / | 571B5B61
D |  |  |  |  |  |  |  |  |  |  |  |  |  | C23 | 10uF | Capacitors_SMD:C_0805 |  |  |  | device | C_Small | / | / | 571B5C5E
D |  |  |  |  |  |  |  |  |  |  |  |  |  | P7 | CONN_01X09 | Pin_Headers:Pin_Header_Straight_1x09_Pitch2.54mm |  |  |  | conn | CONN_01X09 | / | / | 57441869
D |  |  |  |  |  |  |  |  |  |  |  |  |  | R43 | 100R | Resistors_SMD:R_0805 |  |  |  | device | R_Small | / | / | 57618F6B
D |  |  |  |  |  |  |  |  |  |  |  |  |  | U8 | LM4040N-4.1 | TO_SOT_Packages_SMD:SOT-23 | http://www.ti.com/lit/ds/symlink/lm4040-n.pdf | LM4040DIM3-4.1/NOPB | Part Number | 6xUSB_PowMet-cache | LM4040AvvDBZ | / | / | 5767B0E4
D |  |  |  |  |  |  |  |  |  |  |  |  |  | U8 | LM4040N-4.1 | TO_SOT_Packages_SMD:SOT-23 | http://www.ti.com/lit/ds/symlink/lm4040-n.pdf | Texas Instruments | Manufacturer | 6xUSB_PowMet-cache | LM4040AvvDBZ | / | / | 5767B0E4
D |  |  |  |  |  |  |  |  |  |  |  |  |  | U8 | LM4040N-4.1 | TO_SOT_Packages_SMD:SOT-23 | http://www.ti.com/lit/ds/symlink/lm4040-n.pdf | V-Ref Precision 4.096V 15mA 3-Pin SOT-23 T/R | Description | 6xUSB_PowMet-cache | LM4040AvvDBZ | / | / | 5767B0E4
D |  |  |  |  |  |  |  |  |  |  |  |  |  | C6 | 100n | Capacitors_SMD:C_0805 |  |  |  | device | C | / | / | 5767C2D0
D |  |  |  |  |  |  |  |  |  |  |  |  |  | C5 | 100n | Capacitors_SMD:C_0805 |  |  |  | device | C | / | / | 5767CCA6
D |  |  |  |  |  |  |  |  |  |  |  |  |  | Q4 | IRLML6401 | TO_SOT_Packages_SMD:SOT-23 | https://www.elfadistrelec.lv/Web/Downloads/1_/en/zmint_RECTIFIER_FET-Trans-IRLML6401_EN.pdf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 |  |  | transistor | P-CHAN-MOSFET_SOT | / | / | 5774C8A2
D |  |  |  |  |  |  |  |  |  |  |  |  |  | Q7 | IRLML6401 | TO_SOT_Packages_SMD:SOT-23 | https://www.elfadistrelec.lv/Web/Downloads/1_/en/zmint_RECTIFIER_FET-Trans-IRLML6401_EN.pdf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 |  |  | transistor | P-CHAN-MOSFET_SOT | / | / | 57755F7C
D |  |  |  |  |  |  |  |  |  |  |  |  |  | Q5 | IRLML6401 | TO_SOT_Packages_SMD:SOT-23 | https://www.elfadistrelec.lv/Web/Downloads/1_/en/zmint_RECTIFIER_FET-Trans-IRLML6401_EN.pdf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 |  |  | transistor | P-CHAN-MOSFET_SOT | / | / | 577568A4
D |  |  |  |  |  |  |  |  |  |  |  |  |  | Q9 | IRLML6401 | TO_SOT_Packages_SMD:SOT-23 | https://www.elfadistrelec.lv/Web/Downloads/1_/en/zmint_RECTIFIER_FET-Trans-IRLML6401_EN.pdf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 |  |  | transistor | P-CHAN-MOSFET_SOT | / | / | 577581AE
D |  |  |  |  |  |  |  |  |  |  |  |  |  | Q6 | IRLML6401 | TO_SOT_Packages_SMD:SOT-23 | https://www.elfadistrelec.lv/Web/Downloads/1_/en/zmint_RECTIFIER_FET-Trans-IRLML6401_EN.pdf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 |  |  | transistor | P-CHAN-MOSFET_SOT | / | / | 5775AF53
D |  |  |  |  |  |  |  |  |  |  |  |  |  | Q8 | IRLML6401 | TO_SOT_Packages_SMD:SOT-23 | https://www.elfadistrelec.lv/Web/Downloads/1_/en/zmint_RECTIFIER_FET-Trans-IRLML6401_EN.pdf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 |  |  | transistor | P-CHAN-MOSFET_SOT | / | / | 5775BC2E
D |  |  |  |  |  |  |  |  |  |  |  |  |  | P11 | CONN_02X04 | Socket_Strips:Socket_Strip_Straight_2x04 |  |  |  | conn | CONN_02X04 | / | / | 577A61C4
D |  |  |  |  |  |  |  |  |  |  |  |  |  | P12 | CONN_02X04 | Socket_Strips:Socket_Strip_Straight_2x04 |  |  |  | conn | CONN_02X04 | / | / | 577A84E6
D |  |  |  |  |  |  |  |  |  |  |  |  |  | U10 | ESP-07v2 | ESP8266:ESP-12E |  |  |  | ESP8266 | ESP-12E | / | / | 577E5087
D |  |  |  |  |  |  |  |  |  |  |  |  |  | R47 | 10K | Resistors_SMD:R_0805 |  |  |  | device | R | / | / | 577E60F6
D |  |  |  |  |  |  |  |  |  |  |  |  |  | R41 | 10K | Resistors_SMD:R_0805 |  |  |  | device | R | / | / | 577E677D
D |  |  |  |  |  |  |  |  |  |  |  |  |  | R46 | 10K | Resistors_SMD:R_0805 |  |  |  | device | R | / | / | 577E6B97
D |  |  |  |  |  |  |  |  |  |  |  |  |  | R49 | 10K | Resistors_SMD:R_0805 |  |  |  | device | R | / | / | 577E71EB
D |  |  |  |  |  |  |  |  |  |  |  |  |  | R39 | 470R | Resistors_SMD:R_0805 |  |  |  | device | R | / | / | 577E763A
D |  |  |  |  |  |  |  |  |  |  |  |  |  | R48 | 10K | Resistors_SMD:R_0805 |  |  |  | device | R | / | / | 577E7BF2
D |  |  |  |  |  |  |  |  |  |  |  |  |  | P13 | Burn | Pin_Headers:Pin_Header_Straight_2x01 |  |  |  | conn | CONN_01X02 | / | / | 577E817D
D |  |  |  |  |  |  |  |  |  |  |  |  |  | SW1 | Reset | Buttons_Switches_SMD:SW_SPST_B3U-1000P |  |  |  | 6xUSB_PowMet-cache | SW_PUSH | / | / | 577E8867
D |  |  |  |  |  |  |  |  |  |  |  |  |  | C34 | 100n | Capacitors_SMD:C_0805 |  |  |  | device | C | / | / | 57A9A6FF
D |  |  |  |  |  |  |  |  |  |  |  |  |  | C44 | 100uF | Capacitors_SMD:C_0805 |  |  |  | device | CP1_Small | / | / | 57AA1481
D |  |  |  |  |  |  |  |  |  |  |  |  |  | U12 | AP1117E50 | TO_SOT_Packages_SMD:SOT-223-3Lead_TabPin2 |  |  |  | 6xUSB_PowMet-cache | AP1117E50 | / | / | 57AA1C18
D |  |  |  |  |  |  |  |  |  |  |  |  |  | C35 | 10uF | Capacitors_SMD:C_0805 |  |  |  | device | CP1_Small | / | / | 57AA228B
D |  |  |  |  |  |  |  |  |  |  |  |  |  | C45 | 100uF | Capacitors_SMD:C_0805 |  |  |  | device | CP1_Small | / | / | 57AA23F0
D |  |  |  |  |  |  |  |  |  |  |  |  |  | Y2 | 16.000 Mhz | Crystals:Crystal_SMD_3225-4pin_3.2x2.5mm | http://static6.arrow.com/aropdfconversion/4198db9119c7b2debcc1accfb3993af095de02d4/kx-7-12-88602_05.pdf | 12.88602 | Part Number | device | Crystal_GND24_Small | / | / | 587AF0E2
D |  |  |  |  |  |  |  |  |  |  |  |  |  | Y2 | 16.000 Mhz | Crystals:Crystal_SMD_3225-4pin_3.2x2.5mm | http://static6.arrow.com/aropdfconversion/4198db9119c7b2debcc1accfb3993af095de02d4/kx-7-12-88602_05.pdf | GEYER ELECTRONIC | Manufacturer | device | Crystal_GND24_Small | / | / | 587AF0E2
D |  |  |  |  |  |  |  |  |  |  |  |  |  | C32 | 22pF | Capacitors_SMD:C_0603 |  |  |  | device | C_Small | / | / | 587AF826
D |  |  |  |  |  |  |  |  |  |  |  |  |  | C33 | 22pF | Capacitors_SMD:C_0603 |  |  |  | device | C_Small | / | / | 587AF9C3
D |  |  |  |  |  |  |  |  |  |  |  |  |  | TP1 | TEST | Measurement_Points:Measurement_Point_Round-SMD-Pad_Small |  |  |  | device | TEST | / | / | 587DB6AB
D |  |  |  |  |  |  |  |  |  |  |  |  |  | L8 | WE-CBF | Inductors_SMD:L_0603 | http://katalog.we-online.de/pbs/datasheet/742792641.pdf | 742792641 | Part Number | device | L_Small | / | / | 597185B6
D |  |  |  |  |  |  |  |  |  |  |  |  |  | L8 | WE-CBF | Inductors_SMD:L_0603 | http://katalog.we-online.de/pbs/datasheet/742792641.pdf | Würth Elektronik | Manufacturer | device | L_Small | / | / | 597185B6
D |  |  |  |  |  |  |  |  |  |  |  |  |  | L8 | WE-CBF | Inductors_SMD:L_0603 | http://katalog.we-online.de/pbs/datasheet/742792641.pdf | WE-CBF SMD EMI Suppression Ferrite | Description | device | L_Small | / | / | 597185B6
D |  |  |  |  |  |  |  |  |  |  |  |  |  | L9 | WE-CBF | Inductors_SMD:L_0603 | http://katalog.we-online.de/pbs/datasheet/742792641.pdf | 742792641 | Part Number | device | L_Small | / | / | 5971A25C
D |  |  |  |  |  |  |  |  |  |  |  |  |  | L9 | WE-CBF | Inductors_SMD:L_0603 | http://katalog.we-online.de/pbs/datasheet/742792641.pdf | Würth Elektronik | Manufacturer | device | L_Small | / | / | 5971A25C
D |  |  |  |  |  |  |  |  |  |  |  |  |  | L9 | WE-CBF | Inductors_SMD:L_0603 | http://katalog.we-online.de/pbs/datasheet/742792641.pdf | WE-CBF SMD EMI Suppression Ferrite | Description | device | L_Small | / | / | 5971A25C
D |  |  |  |  |  |  |  |  |  |  |  |  |  | U3 | ATMEGA32U4-AU | Housings_QFP:LQFP-44_10x10mm_Pitch0.8mm | http://www.atmel.com/Images/Atmel-7766-8-bit-AVR-ATmega16U4-32U4_Datasheet.pdf | ATMEGA32U4-AU | Part Number | atmel | ATMEGA32U4-AU | / | / | 597551F3
D |  |  |  |  |  |  |  |  |  |  |  |  |  | U3 | ATMEGA32U4-AU | Housings_QFP:LQFP-44_10x10mm_Pitch0.8mm | http://www.atmel.com/Images/Atmel-7766-8-bit-AVR-ATmega16U4-32U4_Datasheet.pdf | Atmel | Manufacturer | atmel | ATMEGA32U4-AU | / | / | 597551F3
D |  |  |  |  |  |  |  |  |  |  |  |  |  | C49 | 1uF | Capacitors_SMD:C_0805 |  |  |  | device | C | / | / | 59766DA1
D |  |  |  |  |  |  |  |  |  |  |  |  |  | C9 | 100n | Capacitors_SMD:C_0805 |  |  |  | device | C | / | / | 5976896B
D |  |  |  |  |  |  |  |  |  |  |  |  |  | C8 | 100n | Capacitors_SMD:C_0805 |  |  |  | device | C | / | / | 59768AE6
D |  |  |  |  |  |  |  |  |  |  |  |  |  | D3 | CD1206-S01575 | Diodes_SMD:D_1206 | http://static6.arrow.com/aropdfconversion/c5ad23a7cc18bccfba57f019e9e9646848d208e9/381cd1206_s01575.pdf | Bourns | Manufacturer | device | D | / | / | 59769822
D |  |  |  |  |  |  |  |  |  |  |  |  |  | D3 | CD1206-S01575 | Diodes_SMD:D_1206 | http://static6.arrow.com/aropdfconversion/c5ad23a7cc18bccfba57f019e9e9646848d208e9/381cd1206_s01575.pdf | Diode Small Signal Switching 100V 0.15A 2-Pin Case 1206 | Description | device | D | / | / | 59769822
D |  |  |  |  |  |  |  |  |  |  |  |  |  | D3 | CD1206-S01575 | Diodes_SMD:D_1206 | http://static6.arrow.com/aropdfconversion/c5ad23a7cc18bccfba57f019e9e9646848d208e9/381cd1206_s01575.pdf | CD1206-S01575 | Part Number | device | D | / | / | 59769822
D |  |  |  |  |  |  |  |  |  |  |  |  |  | L1 | MH2029-300Y | Inductors_SMD:L_0805 | http://static6.arrow.com/aropdfconversion/cc20dccb9d8de17ada558365213bd0c522d14c01/36079323380305480mh.pdf | MH2029-300Y | Part Number | device | Ferrite_Bead | / | / | 5976AA17
D |  |  |  |  |  |  |  |  |  |  |  |  |  | L1 | MH2029-300Y | Inductors_SMD:L_0805 | http://static6.arrow.com/aropdfconversion/cc20dccb9d8de17ada558365213bd0c522d14c01/36079323380305480mh.pdf | Bourns | Manufacturer | device | Ferrite_Bead | / | / | 5976AA17
D |  |  |  |  |  |  |  |  |  |  |  |  |  | C50 | 1uF | Capacitors_SMD:C_0805 |  |  |  | device | C | / | / | 5976E22E
D |  |  |  |  |  |  |  |  |  |  |  |  |  | C48 | 100n | Capacitors_SMD:C_0805 |  |  |  | device | C | / | / | 5976F2D8
D |  |  |  |  |  |  |  |  |  |  |  |  |  | SW2 | Reset | Buttons_Switches_SMD:SW_SPST_B3U-3000P |  |  |  | 6xUSB_PowMet-cache | SW_PUSH | / | / | 5977586B
D |  |  |  |  |  |  |  |  |  |  |  |  |  | U6 | LT6106 | TO_SOT_Packages_SMD:SOT-23-5 | http://static6.arrow.com/aropdfconversion/8b6405b3cc635e5cb55e8c67a047617597ae70a1/43127956299691224992.pdf | Linear Technology | Manufacturer | 6xUSB_PowMet-cache | LT6106-RESCUE-6xUSB_PowMet | / | / | 59783650
D |  |  |  |  |  |  |  |  |  |  |  |  |  | U6 | LT6106 | TO_SOT_Packages_SMD:SOT-23-5 | http://static6.arrow.com/aropdfconversion/8b6405b3cc635e5cb55e8c67a047617597ae70a1/43127956299691224992.pdf | LT6106IS5#TRPBF | Part Number | 6xUSB_PowMet-cache | LT6106-RESCUE-6xUSB_PowMet | / | / | 59783650
D |  |  |  |  |  |  |  |  |  |  |  |  |  | U4 | LT6106 | TO_SOT_Packages_SMD:SOT-23-5 | http://static6.arrow.com/aropdfconversion/8b6405b3cc635e5cb55e8c67a047617597ae70a1/43127956299691224992.pdf | Linear Technology | Manufacturer | 6xUSB_PowMet-cache | LT6106-RESCUE-6xUSB_PowMet | / | / | 597837C8
D |  |  |  |  |  |  |  |  |  |  |  |  |  | U4 | LT6106 | TO_SOT_Packages_SMD:SOT-23-5 | http://static6.arrow.com/aropdfconversion/8b6405b3cc635e5cb55e8c67a047617597ae70a1/43127956299691224992.pdf | LT6106IS5#TRPBF | Part Number | 6xUSB_PowMet-cache | LT6106-RESCUE-6xUSB_PowMet | / | / | 597837C8
D |  |  |  |  |  |  |  |  |  |  |  |  |  | U14 | LT6106 | TO_SOT_Packages_SMD:SOT-23-5 | http://static6.arrow.com/aropdfconversion/8b6405b3cc635e5cb55e8c67a047617597ae70a1/43127956299691224992.pdf | Linear Technology | Manufacturer | 6xUSB_PowMet-cache | LT6106-RESCUE-6xUSB_PowMet | / | / | 59783943
D |  |  |  |  |  |  |  |  |  |  |  |  |  | U14 | LT6106 | TO_SOT_Packages_SMD:SOT-23-5 | http://static6.arrow.com/aropdfconversion/8b6405b3cc635e5cb55e8c67a047617597ae70a1/43127956299691224992.pdf | LT6106IS5#TRPBF | Part Number | 6xUSB_PowMet-cache | LT6106-RESCUE-6xUSB_PowMet | / | / | 59783943
D |  |  |  |  |  |  |  |  |  |  |  |  |  | U5 | LT6106 | TO_SOT_Packages_SMD:SOT-23-5 | http://static6.arrow.com/aropdfconversion/8b6405b3cc635e5cb55e8c67a047617597ae70a1/43127956299691224992.pdf | LT6106IS5#TRPBF | Part Number | 6xUSB_PowMet-cache | LT6106-RESCUE-6xUSB_PowMet | / | / | 59783C6D
D |  |  |  |  |  |  |  |  |  |  |  |  |  | U5 | LT6106 | TO_SOT_Packages_SMD:SOT-23-5 | http://static6.arrow.com/aropdfconversion/8b6405b3cc635e5cb55e8c67a047617597ae70a1/43127956299691224992.pdf | Linear Technology | Manufacturer | 6xUSB_PowMet-cache | LT6106-RESCUE-6xUSB_PowMet | / | / | 59783C6D
D |  |  |  |  |  |  |  |  |  |  |  |  |  | U7 | LT6106 | TO_SOT_Packages_SMD:SOT-23-5 | http://static6.arrow.com/aropdfconversion/8b6405b3cc635e5cb55e8c67a047617597ae70a1/43127956299691224992.pdf | Linear Technology | Manufacturer | 6xUSB_PowMet-cache | LT6106-RESCUE-6xUSB_PowMet | / | / | 59783DF6
D |  |  |  |  |  |  |  |  |  |  |  |  |  | U7 | LT6106 | TO_SOT_Packages_SMD:SOT-23-5 | http://static6.arrow.com/aropdfconversion/8b6405b3cc635e5cb55e8c67a047617597ae70a1/43127956299691224992.pdf | LT6106IS5#TRPBF | Part Number | 6xUSB_PowMet-cache | LT6106-RESCUE-6xUSB_PowMet | / | / | 59783DF6
D |  |  |  |  |  |  |  |  |  |  |  |  |  | J1 | MICROUSB |  |  |  |  | connector | MICROUSB | / | / | 5978A370
D |  |  |  |  |  |  |  |  |  |  |  |  |  | F8 | MF-MSMF050-2 500mA |  | http://static6.arrow.com/aropdfconversion/74a5ab4ba8290f06db3af6ac65bcdf33c76e9b0a/34906507975219mfmsmf.pdfsfvrsn20.pdfsfvrsn20.pdf | Bourns | Manufacturer | device | Fuse_Small | / | / | 5978A47B
D |  |  |  |  |  |  |  |  |  |  |  |  |  | F8 | MF-MSMF050-2 500mA |  | http://static6.arrow.com/aropdfconversion/74a5ab4ba8290f06db3af6ac65bcdf33c76e9b0a/34906507975219mfmsmf.pdfsfvrsn20.pdfsfvrsn20.pdf | PTC Resettable Fuse 0.5A(hold) 1A(trip) 15V 100A 0.8W 0.15s 0.15Ohm SMD Solder Pad 1812 T/R Automotive | Description | device | Fuse_Small | / | / | 5978A47B
D |  |  |  |  |  |  |  |  |  |  |  |  |  | R32 | 22R | Resistors_SMD:R_0805 |  |  |  | device | R | / | / | 5978BE79
D |  |  |  |  |  |  |  |  |  |  |  |  |  | R40 | 22R | Resistors_SMD:R_0805 |  |  |  | device | R | / | / | 5978C181
D |  |  |  |  |  |  |  |  |  |  |  |  |  | RV2 | CG0603MLC-05E | Inductors_SMD:L_0603 | http://static6.arrow.com/aropdfconversion/43b6461ae6f5ef31c195dc6e604d43ab4b1338fc/420mlc.pdf | Bourns | Manufacturer | standard | VDR | / | / | 5978FDB3
D |  |  |  |  |  |  |  |  |  |  |  |  |  | RV2 | CG0603MLC-05E | Inductors_SMD:L_0603 | http://static6.arrow.com/aropdfconversion/43b6461ae6f5ef31c195dc6e604d43ab4b1338fc/420mlc.pdf | CG0603MLC-05E | Part Number | standard | VDR | / | / | 5978FDB3
D |  |  |  |  |  |  |  |  |  |  |  |  |  | RV2 | CG0603MLC-05E | Inductors_SMD:L_0603 | http://static6.arrow.com/aropdfconversion/43b6461ae6f5ef31c195dc6e604d43ab4b1338fc/420mlc.pdf | ESD Suppressor Multilayer Varistor 5V Automotive 2-Pin Case 0603 T/R | Description | standard | VDR | / | / | 5978FDB3
D |  |  |  |  |  |  |  |  |  |  |  |  |  | RV1 | CG0603MLC-05E | Inductors_SMD:L_0603 | http://static6.arrow.com/aropdfconversion/43b6461ae6f5ef31c195dc6e604d43ab4b1338fc/420mlc.pdf | Bourns | Manufacturer | standard | VDR | / | / | 59790150
D |  |  |  |  |  |  |  |  |  |  |  |  |  | RV1 | CG0603MLC-05E | Inductors_SMD:L_0603 | http://static6.arrow.com/aropdfconversion/43b6461ae6f5ef31c195dc6e604d43ab4b1338fc/420mlc.pdf | CG0603MLC-05E | Part Number | standard | VDR | / | / | 59790150
D |  |  |  |  |  |  |  |  |  |  |  |  |  | RV1 | CG0603MLC-05E | Inductors_SMD:L_0603 | http://static6.arrow.com/aropdfconversion/43b6461ae6f5ef31c195dc6e604d43ab4b1338fc/420mlc.pdf | ESD Suppressor Multilayer Varistor 5V Automotive 2-Pin Case 0603 T/R | Description | standard | VDR | / | / | 59790150
D |  |  |  |  |  |  |  |  |  |  |  |  |  | C47 | 100n | Capacitors_SMD:C_0805 |  |  |  | device | C | / | / | 59790ECB
D |  |  |  |  |  |  |  |  |  |  |  |  |  | R50 | 10K | Resistors_SMD:R_0805 |  |  |  | device | R | / | / | 597910FD
D |  |  |  |  |  |  |  |  |  |  |  |  |  | C46 | 22uF | Capacitors_Tantalum_SMD:CP_Tantalum_Case-R_EIA-2012-12_Reflow | http://static6.arrow.com/aropdfconversion/59110e392f1566cf71b857b0891b5d0e5e383cd4/3227828444572420f92.pdf | F920J226MPA | Part Number | device | CP1_Small | / | / | 5979251E
D |  |  |  |  |  |  |  |  |  |  |  |  |  | C46 | 22uF | Capacitors_Tantalum_SMD:CP_Tantalum_Case-R_EIA-2012-12_Reflow | http://static6.arrow.com/aropdfconversion/59110e392f1566cf71b857b0891b5d0e5e383cd4/3227828444572420f92.pdf | AVX | Manufacturer | device | CP1_Small | / | / | 5979251E
D |  |  |  |  |  |  |  |  |  |  |  |  |  | C46 | 22uF | Capacitors_Tantalum_SMD:CP_Tantalum_Case-R_EIA-2012-12_Reflow | http://static6.arrow.com/aropdfconversion/59110e392f1566cf71b857b0891b5d0e5e383cd4/3227828444572420f92.pdf | Cap Tant Solid 22uF 6.3V P CASE 20% (2 X 1.25 X 1.1mm) Inward L SMD 5 Ohm 125°C T/R | Description | device | CP1_Small | / | / | 5979251E
D |  |  |  |  |  |  |  |  |  |  |  |  |  | R2 | 0.02R | Resistors_SMD:R_1206 | https://www.elfadistrelec.lv/Web/Downloads/_t/ds/erj8cw_eng_tds.pdf?mime=application%2Fpdf | ERJ8CWFR020V | Part Number | device | R | / | / | 597EF3A5
D |  |  |  |  |  |  |  |  |  |  |  |  |  | R2 | 0.02R | Resistors_SMD:R_1206 | https://www.elfadistrelec.lv/Web/Downloads/_t/ds/erj8cw_eng_tds.pdf?mime=application%2Fpdf | Panasonic | Manufacturer | device | R | / | / | 597EF3A5
D |  |  |  |  |  |  |  |  |  |  |  |  |  | R2 | 0.02R | Resistors_SMD:R_1206 | https://www.elfadistrelec.lv/Web/Downloads/_t/ds/erj8cw_eng_tds.pdf?mime=application%2Fpdf | Res Thick Film 1206 0.02 Ohm 1% 1W ±50ppm/°C Pad SMD Automotive T/R | Description | device | R | / | / | 597EF3A5
D |  |  |  |  |  |  |  |  |  |  |  |  |  | R2 | 0.02R | Resistors_SMD:R_1206 | https://www.elfadistrelec.lv/Web/Downloads/_t/ds/erj8cw_eng_tds.pdf?mime=application%2Fpdf | 1% | Tolerance | device | R | / | / | 597EF3A5
D |  |  |  |  |  |  |  |  |  |  |  |  |  | R18 | 0.02R | Resistors_SMD:R_1206 | https://www.elfadistrelec.lv/Web/Downloads/_t/ds/erj8cw_eng_tds.pdf?mime=application%2Fpdf | ERJ8CWFR020V | Part Number | device | R | / | / | 597EF527
D |  |  |  |  |  |  |  |  |  |  |  |  |  | R18 | 0.02R | Resistors_SMD:R_1206 | https://www.elfadistrelec.lv/Web/Downloads/_t/ds/erj8cw_eng_tds.pdf?mime=application%2Fpdf | Panasonic | Manufacturer | device | R | / | / | 597EF527
D |  |  |  |  |  |  |  |  |  |  |  |  |  | R18 | 0.02R | Resistors_SMD:R_1206 | https://www.elfadistrelec.lv/Web/Downloads/_t/ds/erj8cw_eng_tds.pdf?mime=application%2Fpdf | Res Thick Film 1206 0.02 Ohm 1% 1W ±50ppm/°C Pad SMD Automotive T/R | Description | device | R | / | / | 597EF527
D |  |  |  |  |  |  |  |  |  |  |  |  |  | R18 | 0.02R | Resistors_SMD:R_1206 | https://www.elfadistrelec.lv/Web/Downloads/_t/ds/erj8cw_eng_tds.pdf?mime=application%2Fpdf | 1% | Tolerance | device | R | / | / | 597EF527
D |  |  |  |  |  |  |  |  |  |  |  |  |  | R21 | 0.02R | Resistors_SMD:R_1206 | https://www.elfadistrelec.lv/Web/Downloads/_t/ds/erj8cw_eng_tds.pdf?mime=application%2Fpdf | ERJ8CWFR020V | Part Number | device | R | / | / | 597EF6CA
D |  |  |  |  |  |  |  |  |  |  |  |  |  | R21 | 0.02R | Resistors_SMD:R_1206 | https://www.elfadistrelec.lv/Web/Downloads/_t/ds/erj8cw_eng_tds.pdf?mime=application%2Fpdf | Panasonic | Manufacturer | device | R | / | / | 597EF6CA
D |  |  |  |  |  |  |  |  |  |  |  |  |  | R21 | 0.02R | Resistors_SMD:R_1206 | https://www.elfadistrelec.lv/Web/Downloads/_t/ds/erj8cw_eng_tds.pdf?mime=application%2Fpdf | Res Thick Film 1206 0.02 Ohm 1% 1W ±50ppm/°C Pad SMD Automotive T/R | Description | device | R | / | / | 597EF6CA
D |  |  |  |  |  |  |  |  |  |  |  |  |  | R21 | 0.02R | Resistors_SMD:R_1206 | https://www.elfadistrelec.lv/Web/Downloads/_t/ds/erj8cw_eng_tds.pdf?mime=application%2Fpdf | 1% | Tolerance | device | R | / | / | 597EF6CA
D |  |  |  |  |  |  |  |  |  |  |  |  |  | R20 | 0.02R | Resistors_SMD:R_1206 | https://www.elfadistrelec.lv/Web/Downloads/_t/ds/erj8cw_eng_tds.pdf?mime=application%2Fpdf | ERJ8CWFR020V | Part Number | device | R | / | / | 597EF85E
D |  |  |  |  |  |  |  |  |  |  |  |  |  | R20 | 0.02R | Resistors_SMD:R_1206 | https://www.elfadistrelec.lv/Web/Downloads/_t/ds/erj8cw_eng_tds.pdf?mime=application%2Fpdf | Panasonic | Manufacturer | device | R | / | / | 597EF85E
D |  |  |  |  |  |  |  |  |  |  |  |  |  | R20 | 0.02R | Resistors_SMD:R_1206 | https://www.elfadistrelec.lv/Web/Downloads/_t/ds/erj8cw_eng_tds.pdf?mime=application%2Fpdf | Res Thick Film 1206 0.02 Ohm 1% 1W ±50ppm/°C Pad SMD Automotive T/R | Description | device | R | / | / | 597EF85E
D |  |  |  |  |  |  |  |  |  |  |  |  |  | R20 | 0.02R | Resistors_SMD:R_1206 | https://www.elfadistrelec.lv/Web/Downloads/_t/ds/erj8cw_eng_tds.pdf?mime=application%2Fpdf | 1% | Tolerance | device | R | / | / | 597EF85E
D |  |  |  |  |  |  |  |  |  |  |  |  |  | R12 | 0.02R | Resistors_SMD:R_1206 | https://www.elfadistrelec.lv/Web/Downloads/_t/ds/erj8cw_eng_tds.pdf?mime=application%2Fpdf | ERJ8CWFR020V | Part Number | device | R | / | / | 597EF9E7
D |  |  |  |  |  |  |  |  |  |  |  |  |  | R12 | 0.02R | Resistors_SMD:R_1206 | https://www.elfadistrelec.lv/Web/Downloads/_t/ds/erj8cw_eng_tds.pdf?mime=application%2Fpdf | Panasonic | Manufacturer | device | R | / | / | 597EF9E7
D |  |  |  |  |  |  |  |  |  |  |  |  |  | R12 | 0.02R | Resistors_SMD:R_1206 | https://www.elfadistrelec.lv/Web/Downloads/_t/ds/erj8cw_eng_tds.pdf?mime=application%2Fpdf | Res Thick Film 1206 0.02 Ohm 1% 1W ±50ppm/°C Pad SMD Automotive T/R | Description | device | R | / | / | 597EF9E7
D |  |  |  |  |  |  |  |  |  |  |  |  |  | R12 | 0.02R | Resistors_SMD:R_1206 | https://www.elfadistrelec.lv/Web/Downloads/_t/ds/erj8cw_eng_tds.pdf?mime=application%2Fpdf | 1% | Tolerance | device | R | / | / | 597EF9E7
D |  |  |  |  |  |  |  |  |  |  |  |  |  | C27 | 18pF | Capacitors_SMD:C_0805 |  |  |  | device | C_Small | /USB hub/ | /571758E7/ | 5717A030
D |  |  |  |  |  |  |  |  |  |  |  |  |  | C26 | 18pF | Capacitors_SMD:C_0805 |  |  |  | device | C_Small | /USB hub/ | /571758E7/ | 5717A070
D |  |  |  |  |  |  |  |  |  |  |  |  |  | Y1 | 12Mhz | Crystals:Crystal_HC49-SD_SMD |  |  |  | device | Crystal_Small | /USB hub/ | /571758E7/ | 5717A09F
D |  |  |  |  |  |  |  |  |  |  |  |  |  | R29 | 2.7K | Resistors_SMD:R_0805 |  |  |  | device | R_Small | /USB hub/ | /571758E7/ | 5718DE22
D |  |  |  |  |  |  |  |  |  |  |  |  |  | R22 | 470R | Resistors_SMD:R_0805 |  |  |  | device | R_Small | /USB hub/ | /571758E7/ | 5718F570
D |  |  |  |  |  |  |  |  |  |  |  |  |  | D1 | Power USB | LEDs:LED-5MM |  |  |  | 6xUSB_PowMet-cache | Led_Small | /USB hub/ | /571758E7/ | 5718F5E1
D |  |  |  |  |  |  |  |  |  |  |  |  |  | R26 | 10K | Resistors_SMD:R_0805 |  |  |  | device | R_Small | /USB hub/ | /571758E7/ | 57190BCF
D |  |  |  |  |  |  |  |  |  |  |  |  |  | R23 | 470R | Resistors_SMD:R_0805 |  |  |  | device | R_Small | /USB hub/ | /571758E7/ | 57194837
D |  |  |  |  |  |  |  |  |  |  |  |  |  | LED4 | Led_Small | LEDs:LED_0805 |  |  |  | 6xUSB_PowMet-cache | Led_Small | /USB hub/ | /571758E7/ | 57194916
D |  |  |  |  |  |  |  |  |  |  |  |  |  | LED2 | Led_Small | LEDs:LED_0805 |  |  |  | 6xUSB_PowMet-cache | Led_Small | /USB hub/ | /571758E7/ | 571949EB
D |  |  |  |  |  |  |  |  |  |  |  |  |  | LED1 | Led_Small | LEDs:LED_0805 |  |  |  | 6xUSB_PowMet-cache | Led_Small | /USB hub/ | /571758E7/ | 57194A55
D |  |  |  |  |  |  |  |  |  |  |  |  |  | LED3 | Led_Small | LEDs:LED_0805 |  |  |  | 6xUSB_PowMet-cache | Led_Small | /USB hub/ | /571758E7/ | 57194AC4
D |  |  |  |  |  |  |  |  |  |  |  |  |  | R24 | 470R | Resistors_SMD:R_0805 |  |  |  | device | R_Small | /USB hub/ | /571758E7/ | 57195054
D |  |  |  |  |  |  |  |  |  |  |  |  |  | D6 | Led_Small | LEDs:LED_0805 |  |  |  | 6xUSB_PowMet-cache | Led_Small | /USB hub/ | /571758E7/ | 57197C06
D |  |  |  |  |  |  |  |  |  |  |  |  |  | R25 | 470R | Resistors_SMD:R_0805 |  |  |  | device | R_Small | /USB hub/ | /571758E7/ | 57197CF7
D |  |  |  |  |  |  |  |  |  |  |  |  |  | C28 | 10uF | Capacitors_SMD:C_0805 |  |  |  | device | C_Small | /USB hub/ | /571758E7/ | 571991D3
D |  |  |  |  |  |  |  |  |  |  |  |  |  | R27 | 10K | Resistors_SMD:R_0805 |  |  |  | device | R_Small | /USB hub/ | /571758E7/ | 5719A40D
D |  |  |  |  |  |  |  |  |  |  |  |  |  | R28 | 100K | Resistors_SMD:R_0805 |  |  |  | device | R_Small | /USB hub/ | /571758E7/ | 5719A4AA
D |  |  |  |  |  |  |  |  |  |  |  |  |  | F7 | 500mA | Fuse_Holders_and_Fuses:Fuse_SMD1206_HandSoldering |  |  |  | 6xUSB_PowMet-cache | F_Small | /USB hub/ | /571758E7/ | 5719B8C4
D |  |  |  |  |  |  |  |  |  |  |  |  |  | P10 | USB_B | Connect:USB_B |  |  |  | 6xUSB_PowMet-rescue | USB_B-RESCUE-6xUSB_PowMet | /USB hub/ | /571758E7/ | 572B35D9
D |  |  |  |  |  |  |  |  |  |  |  |  |  | U11 | LTC4412 | TO_SOT_Packages_SMD:SOT-23-6 |  | LTC44125 | Part Number | 6xUSB_PowMet-cache | LTC4412 | /USB hub/ | /571758E7/ | 57343D46
D |  |  |  |  |  |  |  |  |  |  |  |  |  | U11 | LTC4412 | TO_SOT_Packages_SMD:SOT-23-6 |  | Linear Technology | Manufacturer | 6xUSB_PowMet-cache | LTC4412 | /USB hub/ | /571758E7/ | 57343D46
D |  |  |  |  |  |  |  |  |  |  |  |  |  | Q1 | IRFR5305PBF | TO_SOT_Packages_SMD1:TO-252-2Lead |  |  |  | device | Q_PMOS_GDS | /USB hub/ | /571758E7/ | 57344130
D |  |  |  |  |  |  |  |  |  |  |  |  |  | C36 | 100n | Capacitors_SMD:C_0805 |  |  |  | device | C_Small | /USB hub/ | /571758E7/ | 5734496A
D |  |  |  |  |  |  |  |  |  |  |  |  |  | R33 | 470K | Resistors_SMD:R_0805 |  |  |  | device | R_Small | /USB hub/ | /571758E7/ | 57344D56
D |  |  |  |  |  |  |  |  |  |  |  |  |  | CON2 | BARREL_JACK | Connect:JACK_ALIM |  |  |  | 6xUSB_PowMet-cache | BARREL_JACK | /USB hub/ | /571758E7/ | 574EA023
D |  |  |  |  |  |  |  |  |  |  |  |  |  | C37 | 47uF | Capacitors_SMD:C_1206 | http://static6.arrow.com/aropdfconversion/556eea1f159619aad65b0f118fbc089253989279/37024850441143360mlcc_commercial_general_en.pdf | 10% | Tolerance | device | C_Small | /USB hub/ | /571758E7/ | 574EA059
D |  |  |  |  |  |  |  |  |  |  |  |  |  | C37 | 47uF | Capacitors_SMD:C_1206 | http://static6.arrow.com/aropdfconversion/556eea1f159619aad65b0f118fbc089253989279/37024850441143360mlcc_commercial_general_en.pdf | Ceramic X5R | Material | device | C_Small | /USB hub/ | /571758E7/ | 574EA059
D |  |  |  |  |  |  |  |  |  |  |  |  |  | C37 | 47uF | Capacitors_SMD:C_1206 | http://static6.arrow.com/aropdfconversion/556eea1f159619aad65b0f118fbc089253989279/37024850441143360mlcc_commercial_general_en.pdf | 25V | Voltage | device | C_Small | /USB hub/ | /571758E7/ | 574EA059
D |  |  |  |  |  |  |  |  |  |  |  |  |  | C37 | 47uF | Capacitors_SMD:C_1206 | http://static6.arrow.com/aropdfconversion/556eea1f159619aad65b0f118fbc089253989279/37024850441143360mlcc_commercial_general_en.pdf | C3216X5R1E476M160AC | Part Number | device | C_Small | /USB hub/ | /571758E7/ | 574EA059
D |  |  |  |  |  |  |  |  |  |  |  |  |  | C37 | 47uF | Capacitors_SMD:C_1206 | http://static6.arrow.com/aropdfconversion/556eea1f159619aad65b0f118fbc089253989279/37024850441143360mlcc_commercial_general_en.pdf | TDK | Manufacturer | device | C_Small | /USB hub/ | /571758E7/ | 574EA059
D |  |  |  |  |  |  |  |  |  |  |  |  |  | C37 | 47uF | Capacitors_SMD:C_1206 | http://static6.arrow.com/aropdfconversion/556eea1f159619aad65b0f118fbc089253989279/37024850441143360mlcc_commercial_general_en.pdf | Cap Ceramic 47uF 25V X5R 20% Pad SMD 1206 85°C T/R | Description | device | C_Small | /USB hub/ | /571758E7/ | 574EA059
D |  |  |  |  |  |  |  |  |  |  |  |  |  | C38 | 100n | Capacitors_SMD:C_0805 | http://static6.arrow.com/aropdfconversion/b3afa1c9bd47184a326079138700d3444719120a/599374459344930x7rdielectric.pdf | 10% | Tolerance | device | C_Small | /USB hub/ | /571758E7/ | 574EA738
D |  |  |  |  |  |  |  |  |  |  |  |  |  | C38 | 100n | Capacitors_SMD:C_0805 | http://static6.arrow.com/aropdfconversion/b3afa1c9bd47184a326079138700d3444719120a/599374459344930x7rdielectric.pdf | Ceramic X7R | Material | device | C_Small | /USB hub/ | /571758E7/ | 574EA738
D |  |  |  |  |  |  |  |  |  |  |  |  |  | C38 | 100n | Capacitors_SMD:C_0805 | http://static6.arrow.com/aropdfconversion/b3afa1c9bd47184a326079138700d3444719120a/599374459344930x7rdielectric.pdf | 25V | Voltage | device | C_Small | /USB hub/ | /571758E7/ | 574EA738
D |  |  |  |  |  |  |  |  |  |  |  |  |  | C38 | 100n | Capacitors_SMD:C_0805 | http://static6.arrow.com/aropdfconversion/b3afa1c9bd47184a326079138700d3444719120a/599374459344930x7rdielectric.pdf | 08053C104KAT2A | Part Number | device | C_Small | /USB hub/ | /571758E7/ | 574EA738
D |  |  |  |  |  |  |  |  |  |  |  |  |  | C38 | 100n | Capacitors_SMD:C_0805 | http://static6.arrow.com/aropdfconversion/b3afa1c9bd47184a326079138700d3444719120a/599374459344930x7rdielectric.pdf | AVX | Manufacturer | device | C_Small | /USB hub/ | /571758E7/ | 574EA738
D |  |  |  |  |  |  |  |  |  |  |  |  |  | C38 | 100n | Capacitors_SMD:C_0805 | http://static6.arrow.com/aropdfconversion/b3afa1c9bd47184a326079138700d3444719120a/599374459344930x7rdielectric.pdf | Cap Ceramic 0.1uF 25V X7R 10% Pad SMD 0805 125°C T/R | Description | device | C_Small | /USB hub/ | /571758E7/ | 574EA738
D |  |  |  |  |  |  |  |  |  |  |  |  |  | U13 | LM3150 | Housings_SSOP:SSOP-14_5.3x6.2mm_Pitch0.65mm | http://www.ti.com/lit/ds/symlink/lm3150.pdf | LM3150MH/NOPB | Part Number | 6xUSB_PowMet-cache | LM3150 | /USB hub/ | /571758E7/ | 574EA9D7
D |  |  |  |  |  |  |  |  |  |  |  |  |  | U13 | LM3150 | Housings_SSOP:SSOP-14_5.3x6.2mm_Pitch0.65mm | http://www.ti.com/lit/ds/symlink/lm3150.pdf | Texas Instruments | Manufacturer | 6xUSB_PowMet-cache | LM3150 | /USB hub/ | /571758E7/ | 574EA9D7
D |  |  |  |  |  |  |  |  |  |  |  |  |  | U13 | LM3150 | Housings_SSOP:SSOP-14_5.3x6.2mm_Pitch0.65mm | http://www.ti.com/lit/ds/symlink/lm3150.pdf | DC/DC Cntrlr Single-OUT Step Down 1000kHz 14-Pin HTSSOP EP Tube | Description | 6xUSB_PowMet-cache | LM3150 | /USB hub/ | /571758E7/ | 574EA9D7
D |  |  |  |  |  |  |  |  |  |  |  |  |  | R34 | 237K | Resistors_SMD:R_0805 | http://static6.arrow.com/aropdfconversion/d03448ccab639d0b72e66119dba2aa409b48fef3/aoa0000c298.pdf | 1% | Tolerance | device | R_Small | /USB hub/ | /571758E7/ | 574EACE8
D |  |  |  |  |  |  |  |  |  |  |  |  |  | R34 | 237K | Resistors_SMD:R_0805 | http://static6.arrow.com/aropdfconversion/d03448ccab639d0b72e66119dba2aa409b48fef3/aoa0000c298.pdf | ERJ-6ENF2373V | Part Number | device | R_Small | /USB hub/ | /571758E7/ | 574EACE8
D |  |  |  |  |  |  |  |  |  |  |  |  |  | R34 | 237K | Resistors_SMD:R_0805 | http://static6.arrow.com/aropdfconversion/d03448ccab639d0b72e66119dba2aa409b48fef3/aoa0000c298.pdf | Panasonic | Manufacturer | device | R_Small | /USB hub/ | /571758E7/ | 574EACE8
D |  |  |  |  |  |  |  |  |  |  |  |  |  | R34 | 237K | Resistors_SMD:R_0805 | http://static6.arrow.com/aropdfconversion/d03448ccab639d0b72e66119dba2aa409b48fef3/aoa0000c298.pdf | Res Thick Film 0805 237K Ohm 1% 0.125W(1/8W) ±100ppm/°C Pad SMD Automotive T/R | Description | device | R_Small | /USB hub/ | /571758E7/ | 574EACE8
D |  |  |  |  |  |  |  |  |  |  |  |  |  | C39 | 15nF | Capacitors_SMD:C_0805 | http://static6.arrow.com/aropdfconversion/24757b39bfe4fba68db384e0486d16a344d975e0/3upy-gphc_x7r_6.3v-to-50v_10.pdf | CC0805KRX7R9BB153 | Part Number | device | C_Small | /USB hub/ | /571758E7/ | 574EB129
D |  |  |  |  |  |  |  |  |  |  |  |  |  | C39 | 15nF | Capacitors_SMD:C_0805 | http://static6.arrow.com/aropdfconversion/24757b39bfe4fba68db384e0486d16a344d975e0/3upy-gphc_x7r_6.3v-to-50v_10.pdf | Yageo | Manufacturer | device | C_Small | /USB hub/ | /571758E7/ | 574EB129
D |  |  |  |  |  |  |  |  |  |  |  |  |  | C39 | 15nF | Capacitors_SMD:C_0805 | http://static6.arrow.com/aropdfconversion/24757b39bfe4fba68db384e0486d16a344d975e0/3upy-gphc_x7r_6.3v-to-50v_10.pdf | Cap Ceramic 0.015uF 50V X7R 10% Pad SMD 0805 125°C T/R | Description | device | C_Small | /USB hub/ | /571758E7/ | 574EB129
D |  |  |  |  |  |  |  |  |  |  |  |  |  | C39 | 15nF | Capacitors_SMD:C_0805 | http://static6.arrow.com/aropdfconversion/24757b39bfe4fba68db384e0486d16a344d975e0/3upy-gphc_x7r_6.3v-to-50v_10.pdf | 10% | Tolerance | device | C_Small | /USB hub/ | /571758E7/ | 574EB129
D |  |  |  |  |  |  |  |  |  |  |  |  |  | C39 | 15nF | Capacitors_SMD:C_0805 | http://static6.arrow.com/aropdfconversion/24757b39bfe4fba68db384e0486d16a344d975e0/3upy-gphc_x7r_6.3v-to-50v_10.pdf | 50V | Voltage | device | C_Small | /USB hub/ | /571758E7/ | 574EB129
D |  |  |  |  |  |  |  |  |  |  |  |  |  | C39 | 15nF | Capacitors_SMD:C_0805 | http://static6.arrow.com/aropdfconversion/24757b39bfe4fba68db384e0486d16a344d975e0/3upy-gphc_x7r_6.3v-to-50v_10.pdf | Ceramic X7R | Material | device | C_Small | /USB hub/ | /571758E7/ | 574EB129
D |  |  |  |  |  |  |  |  |  |  |  |  |  | C41 | 1uF | Capacitors_SMD:C_0805 | http://static6.arrow.com/aropdfconversion/511650c74d83875ee7140c0fb6c183bd2765d2a9/145emk212b7105kg-t.pdf | 10% | Tolerance | device | C_Small | /USB hub/ | /571758E7/ | 574EBFCD
D |  |  |  |  |  |  |  |  |  |  |  |  |  | C41 | 1uF | Capacitors_SMD:C_0805 | http://static6.arrow.com/aropdfconversion/511650c74d83875ee7140c0fb6c183bd2765d2a9/145emk212b7105kg-t.pdf | Ceramic X7R | Material | device | C_Small | /USB hub/ | /571758E7/ | 574EBFCD
D |  |  |  |  |  |  |  |  |  |  |  |  |  | C41 | 1uF | Capacitors_SMD:C_0805 | http://static6.arrow.com/aropdfconversion/511650c74d83875ee7140c0fb6c183bd2765d2a9/145emk212b7105kg-t.pdf | 16V | Voltage | device | C_Small | /USB hub/ | /571758E7/ | 574EBFCD
D |  |  |  |  |  |  |  |  |  |  |  |  |  | C41 | 1uF | Capacitors_SMD:C_0805 | http://static6.arrow.com/aropdfconversion/511650c74d83875ee7140c0fb6c183bd2765d2a9/145emk212b7105kg-t.pdf | EMK212B7105KG-T | Part Number | device | C_Small | /USB hub/ | /571758E7/ | 574EBFCD
D |  |  |  |  |  |  |  |  |  |  |  |  |  | C41 | 1uF | Capacitors_SMD:C_0805 | http://static6.arrow.com/aropdfconversion/511650c74d83875ee7140c0fb6c183bd2765d2a9/145emk212b7105kg-t.pdf | Taiyo Yuden | Manufacturer | device | C_Small | /USB hub/ | /571758E7/ | 574EBFCD
D |  |  |  |  |  |  |  |  |  |  |  |  |  | C41 | 1uF | Capacitors_SMD:C_0805 | http://static6.arrow.com/aropdfconversion/511650c74d83875ee7140c0fb6c183bd2765d2a9/145emk212b7105kg-t.pdf | Cap Ceramic 1uF 16V X7R 10% Pad SMD 0805 125°C T/R | Description | device | C_Small | /USB hub/ | /571758E7/ | 574EBFCD
D |  |  |  |  |  |  |  |  |  |  |  |  |  | C40 | 470nF | Capacitors_SMD:C_0805 | http://static6.arrow.com/aropdfconversion/2d18c5adc1c9cfff146e09462168166c833a580b/705emk212b7474kd-t.pdf | 10% | Tolerance | device | C_Small | /USB hub/ | /571758E7/ | 574EC410
D |  |  |  |  |  |  |  |  |  |  |  |  |  | C40 | 470nF | Capacitors_SMD:C_0805 | http://static6.arrow.com/aropdfconversion/2d18c5adc1c9cfff146e09462168166c833a580b/705emk212b7474kd-t.pdf | Ceramic X7R | Material | device | C_Small | /USB hub/ | /571758E7/ | 574EC410
D |  |  |  |  |  |  |  |  |  |  |  |  |  | C40 | 470nF | Capacitors_SMD:C_0805 | http://static6.arrow.com/aropdfconversion/2d18c5adc1c9cfff146e09462168166c833a580b/705emk212b7474kd-t.pdf | 16V | Voltage | device | C_Small | /USB hub/ | /571758E7/ | 574EC410
D |  |  |  |  |  |  |  |  |  |  |  |  |  | C40 | 470nF | Capacitors_SMD:C_0805 | http://static6.arrow.com/aropdfconversion/2d18c5adc1c9cfff146e09462168166c833a580b/705emk212b7474kd-t.pdf | EMK212B7474KD-T | Part Number | device | C_Small | /USB hub/ | /571758E7/ | 574EC410
D |  |  |  |  |  |  |  |  |  |  |  |  |  | C40 | 470nF | Capacitors_SMD:C_0805 | http://static6.arrow.com/aropdfconversion/2d18c5adc1c9cfff146e09462168166c833a580b/705emk212b7474kd-t.pdf | Taiyo Yuden | Manufacturer | device | C_Small | /USB hub/ | /571758E7/ | 574EC410
D |  |  |  |  |  |  |  |  |  |  |  |  |  | C40 | 470nF | Capacitors_SMD:C_0805 | http://static6.arrow.com/aropdfconversion/2d18c5adc1c9cfff146e09462168166c833a580b/705emk212b7474kd-t.pdf | Cap Ceramic 0.47uF 16V X7R 10% Pad SMD 0805 125°C T/R | Description | device | C_Small | /USB hub/ | /571758E7/ | 574EC410
D |  |  |  |  |  |  |  |  |  |  |  |  |  | R35 | 1K07 | Resistors_SMD:R_0805 | http://static6.arrow.com/aropdfconversion/d5179dcb942594ea17c1dd7efd570ea507861a2c/459801980462063dcrcwe3.pdf | 1% | Tolerance | device | R_Small | /USB hub/ | /571758E7/ | 574EC696
D |  |  |  |  |  |  |  |  |  |  |  |  |  | R35 | 1K07 | Resistors_SMD:R_0805 | http://static6.arrow.com/aropdfconversion/d5179dcb942594ea17c1dd7efd570ea507861a2c/459801980462063dcrcwe3.pdf | CRCW0805464RFKEA | Part Number | device | R_Small | /USB hub/ | /571758E7/ | 574EC696
D |  |  |  |  |  |  |  |  |  |  |  |  |  | R35 | 1K07 | Resistors_SMD:R_0805 | http://static6.arrow.com/aropdfconversion/d5179dcb942594ea17c1dd7efd570ea507861a2c/459801980462063dcrcwe3.pdf | Vishay | Manufacturer | device | R_Small | /USB hub/ | /571758E7/ | 574EC696
D |  |  |  |  |  |  |  |  |  |  |  |  |  | R35 | 1K07 | Resistors_SMD:R_0805 | http://static6.arrow.com/aropdfconversion/d5179dcb942594ea17c1dd7efd570ea507861a2c/459801980462063dcrcwe3.pdf | Res Thick Film 0805 464 Ohm 1% 0.125W(1/8W) ±100ppm/°C Pad SMD Automotive T/R | Description | device | R_Small | /USB hub/ | /571758E7/ | 574EC696
D |  |  |  |  |  |  |  |  |  |  |  |  |  | Q2 | CSD16321Q5 | Personal:AB2_SON5x6_FET | http://www.ti.com/lit/ds/symlink/csd16321q5.pdf | CSD16321Q5 | Part Number | transistors | IRF7607PBF | /USB hub/ | /571758E7/ | 574ED3DE
D |  |  |  |  |  |  |  |  |  |  |  |  |  | Q2 | CSD16321Q5 | Personal:AB2_SON5x6_FET | http://www.ti.com/lit/ds/symlink/csd16321q5.pdf | Texas Instruments | Manufacturer | transistors | IRF7607PBF | /USB hub/ | /571758E7/ | 574ED3DE
D |  |  |  |  |  |  |  |  |  |  |  |  |  | Q2 | CSD16321Q5 | Personal:AB2_SON5x6_FET | http://www.ti.com/lit/ds/symlink/csd16321q5.pdf | Trans MOSFET N-CH 25V 31A 8-Pin VSON-CLIP EP T/R | Description | transistors | IRF7607PBF | /USB hub/ | /571758E7/ | 574ED3DE
D |  |  |  |  |  |  |  |  |  |  |  |  |  | Q3 | CSD18509Q5B | Personal:AB2_SON5x6_FET | http://www.ti.com/lit/ds/symlink/csd18509q5b.pdf | CSD18509Q5B | Part Number | transistors | IRF7607PBF | /USB hub/ | /571758E7/ | 574EE57F
D |  |  |  |  |  |  |  |  |  |  |  |  |  | Q3 | CSD18509Q5B | Personal:AB2_SON5x6_FET | http://www.ti.com/lit/ds/symlink/csd18509q5b.pdf | Texas Instruments | Manufacturer | transistors | IRF7607PBF | /USB hub/ | /571758E7/ | 574EE57F
D |  |  |  |  |  |  |  |  |  |  |  |  |  | Q3 | CSD18509Q5B | Personal:AB2_SON5x6_FET | http://www.ti.com/lit/ds/symlink/csd18509q5b.pdf | Trans MOSFET N-CH Si 40V 100A 8-Pin VSON-CLIP EP T/R | Description | transistors | IRF7607PBF | /USB hub/ | /571758E7/ | 574EE57F
D |  |  |  |  |  |  |  |  |  |  |  |  |  | L3 | 4.7uH 5.2mOhm |  | http://www.coilcraft.com/pdfs/xal1010.pdf | XAL1010-472MEB | Part Number | 6xUSB_PowMet-cache | INDUCTOR_SMALL | /USB hub/ | /571758E7/ | 574EF69D
D |  |  |  |  |  |  |  |  |  |  |  |  |  | L3 | 4.7uH 5.2mOhm |  | http://www.coilcraft.com/pdfs/xal1010.pdf | Coilcraft | Manufacturer | 6xUSB_PowMet-cache | INDUCTOR_SMALL | /USB hub/ | /571758E7/ | 574EF69D
D |  |  |  |  |  |  |  |  |  |  |  |  |  | C42 | 1nF | Capacitors_SMD:C_0805 | http://static6.arrow.com/aropdfconversion/b12cc6352289b5896e435d1f7b2291aea88798a9/153903191648118kem_c1002_x7r_smd.pdf | C0805C102K5RACTU | Part Number | device | C_Small | /USB hub/ | /571758E7/ | 574EF8F2
D |  |  |  |  |  |  |  |  |  |  |  |  |  | C42 | 1nF | Capacitors_SMD:C_0805 | http://static6.arrow.com/aropdfconversion/b12cc6352289b5896e435d1f7b2291aea88798a9/153903191648118kem_c1002_x7r_smd.pdf | KEMET Corporation | Manufacturer | device | C_Small | /USB hub/ | /571758E7/ | 574EF8F2
D |  |  |  |  |  |  |  |  |  |  |  |  |  | C42 | 1nF | Capacitors_SMD:C_0805 | http://static6.arrow.com/aropdfconversion/b12cc6352289b5896e435d1f7b2291aea88798a9/153903191648118kem_c1002_x7r_smd.pdf | Cap Ceramic 0.001uF 50V X7R 10% Pad SMD 0805 125°C T/R | Description | device | C_Small | /USB hub/ | /571758E7/ | 574EF8F2
D |  |  |  |  |  |  |  |  |  |  |  |  |  | C42 | 1nF | Capacitors_SMD:C_0805 | http://static6.arrow.com/aropdfconversion/b12cc6352289b5896e435d1f7b2291aea88798a9/153903191648118kem_c1002_x7r_smd.pdf | 10% | Tolerance | device | C_Small | /USB hub/ | /571758E7/ | 574EF8F2
D |  |  |  |  |  |  |  |  |  |  |  |  |  | C42 | 1nF | Capacitors_SMD:C_0805 | http://static6.arrow.com/aropdfconversion/b12cc6352289b5896e435d1f7b2291aea88798a9/153903191648118kem_c1002_x7r_smd.pdf | 50V | Voltage | device | C_Small | /USB hub/ | /571758E7/ | 574EF8F2
D |  |  |  |  |  |  |  |  |  |  |  |  |  | C42 | 1nF | Capacitors_SMD:C_0805 | http://static6.arrow.com/aropdfconversion/b12cc6352289b5896e435d1f7b2291aea88798a9/153903191648118kem_c1002_x7r_smd.pdf | Ceramic X7R | Material | device | C_Small | /USB hub/ | /571758E7/ | 574EF8F2
D |  |  |  |  |  |  |  |  |  |  |  |  |  | R36 | 73K2 | Resistors_SMD:R_0805 | http://static6.arrow.com/aropdfconversion/d03448ccab639d0b72e66119dba2aa409b48fef3/aoa0000c298.pdf | 1% | Tolerance | device | R_Small | /USB hub/ | /571758E7/ | 574EFCDD
D |  |  |  |  |  |  |  |  |  |  |  |  |  | R36 | 73K2 | Resistors_SMD:R_0805 | http://static6.arrow.com/aropdfconversion/d03448ccab639d0b72e66119dba2aa409b48fef3/aoa0000c298.pdf | ERJ-6ENF7322V | Part Number | device | R_Small | /USB hub/ | /571758E7/ | 574EFCDD
D |  |  |  |  |  |  |  |  |  |  |  |  |  | R36 | 73K2 | Resistors_SMD:R_0805 | http://static6.arrow.com/aropdfconversion/d03448ccab639d0b72e66119dba2aa409b48fef3/aoa0000c298.pdf | Panasonic | Manufacturer | device | R_Small | /USB hub/ | /571758E7/ | 574EFCDD
D |  |  |  |  |  |  |  |  |  |  |  |  |  | R36 | 73K2 | Resistors_SMD:R_0805 | http://static6.arrow.com/aropdfconversion/d03448ccab639d0b72e66119dba2aa409b48fef3/aoa0000c298.pdf | Res Thick Film 0805 73.2K Ohm 1% 0.125W(1/8W) ±100ppm/°C Pad SMD Automotive T/R | Description | device | R_Small | /USB hub/ | /571758E7/ | 574EFCDD
D |  |  |  |  |  |  |  |  |  |  |  |  |  | R37 | 10K | Resistors_SMD:R_0805 | http://static6.arrow.com/aropdfconversion/d03448ccab639d0b72e66119dba2aa409b48fef3/aoa0000c298.pdf | 1% | Tolerance | device | R_Small | /USB hub/ | /571758E7/ | 574F00A4
D |  |  |  |  |  |  |  |  |  |  |  |  |  | R37 | 10K | Resistors_SMD:R_0805 | http://static6.arrow.com/aropdfconversion/d03448ccab639d0b72e66119dba2aa409b48fef3/aoa0000c298.pdf | ERJ-6ENF1002V | Part Number | device | R_Small | /USB hub/ | /571758E7/ | 574F00A4
D |  |  |  |  |  |  |  |  |  |  |  |  |  | R37 | 10K | Resistors_SMD:R_0805 | http://static6.arrow.com/aropdfconversion/d03448ccab639d0b72e66119dba2aa409b48fef3/aoa0000c298.pdf | Panasonic | Manufacturer | device | R_Small | /USB hub/ | /571758E7/ | 574F00A4
D |  |  |  |  |  |  |  |  |  |  |  |  |  | R37 | 10K | Resistors_SMD:R_0805 | http://static6.arrow.com/aropdfconversion/d03448ccab639d0b72e66119dba2aa409b48fef3/aoa0000c298.pdf | Res Thick Film 0805 10K Ohm 1% 0.125W(1/8W) ±100ppm/°C Pad SMD Automotive T/R | Description | device | R_Small | /USB hub/ | /571758E7/ | 574F00A4
D |  |  |  |  |  |  |  |  |  |  |  |  |  | C43 | 330uF | Capacitors_SMD:CP_Elec_6.3x5.8 | http://static6.arrow.com/aropdfconversion/258c2bee1879f4c1c8390cab555901de60d2b96b/33967906146408060aab8000ce4.pdf | 6SVPC330M | Part Number | device | CP1_Small | /USB hub/ | /571758E7/ | 574F07DD
D |  |  |  |  |  |  |  |  |  |  |  |  |  | C43 | 330uF | Capacitors_SMD:CP_Elec_6.3x5.8 | http://static6.arrow.com/aropdfconversion/258c2bee1879f4c1c8390cab555901de60d2b96b/33967906146408060aab8000ce4.pdf | Panasonic | Manufacturer | device | CP1_Small | /USB hub/ | /571758E7/ | 574F07DD
D |  |  |  |  |  |  |  |  |  |  |  |  |  | C43 | 330uF | Capacitors_SMD:CP_Elec_6.3x5.8 | http://static6.arrow.com/aropdfconversion/258c2bee1879f4c1c8390cab555901de60d2b96b/33967906146408060aab8000ce4.pdf | Cap Aluminum Polymer 330uF 6.3VDC 20% (6.3 X 5.9mm) SMD 0.017 Ohm 3390mA 2000h 105°C T/R | Description | device | CP1_Small | /USB hub/ | /571758E7/ | 574F07DD
D |  |  |  |  |  |  |  |  |  |  |  |  |  | C43 | 330uF | Capacitors_SMD:CP_Elec_6.3x5.8 | http://static6.arrow.com/aropdfconversion/258c2bee1879f4c1c8390cab555901de60d2b96b/33967906146408060aab8000ce4.pdf | 20% | Tolerance | device | CP1_Small | /USB hub/ | /571758E7/ | 574F07DD
D |  |  |  |  |  |  |  |  |  |  |  |  |  | C43 | 330uF | Capacitors_SMD:CP_Elec_6.3x5.8 | http://static6.arrow.com/aropdfconversion/258c2bee1879f4c1c8390cab555901de60d2b96b/33967906146408060aab8000ce4.pdf | 6V3 | Voltage | device | CP1_Small | /USB hub/ | /571758E7/ | 574F07DD
D |  |  |  |  |  |  |  |  |  |  |  |  |  | C43 | 330uF | Capacitors_SMD:CP_Elec_6.3x5.8 | http://static6.arrow.com/aropdfconversion/258c2bee1879f4c1c8390cab555901de60d2b96b/33967906146408060aab8000ce4.pdf | Aluminium | Material | device | CP1_Small | /USB hub/ | /571758E7/ | 574F07DD
D |  |  |  |  |  |  |  |  |  |  |  |  |  | D10 | SKL14 | Diodes_SMD:SOD-123 | http://static6.arrow.com/aropdfconversion/8c89a4b3d03a83d425368b11b4a19c17b71cacca/47sm5817pl-sm5819plsod-123fl-j.pdf | SM5817PL-TP | Part Number | device | D_Schottky | /USB hub/ | /571758E7/ | 574F61B3
D |  |  |  |  |  |  |  |  |  |  |  |  |  | D10 | SKL14 | Diodes_SMD:SOD-123 | http://static6.arrow.com/aropdfconversion/8c89a4b3d03a83d425368b11b4a19c17b71cacca/47sm5817pl-sm5819plsod-123fl-j.pdf | Micro Commercial Components | Manufacturer | device | D_Schottky | /USB hub/ | /571758E7/ | 574F61B3
D |  |  |  |  |  |  |  |  |  |  |  |  |  | D10 | SKL14 | Diodes_SMD:SOD-123 | http://static6.arrow.com/aropdfconversion/8c89a4b3d03a83d425368b11b4a19c17b71cacca/47sm5817pl-sm5819plsod-123fl-j.pdf | Diode Schottky 20V 1A 2-Pin SOD-123FL T/R | Description | device | D_Schottky | /USB hub/ | /571758E7/ | 574F61B3
D |  |  |  |  |  |  |  |  |  |  |  |  |  | D11 | SK2030YD2 | Diodes_SMD:DD-PAK_TO263_DualDiode |  |  |  | 6xUSB_PowMet-cache | SCHDPAK | /USB hub/ | /571758E7/ | 574F72ED
D |  |  |  |  |  |  |  |  |  |  |  |  |  | R38 | 330 | Resistors_SMD:R_0805 |  | 5% | Tolerance | device | R_Small | /USB hub/ | /571758E7/ | 574F8E31
D |  |  |  |  |  |  |  |  |  |  |  |  |  | D9 | Power | LEDs:LED-5MM |  |  |  | 6xUSB_PowMet-cache | Led_Small | /USB hub/ | /571758E7/ | 574F8E37
D |  |  |  |  |  |  |  |  |  |  |  |  |  | D8 | Power DC | LEDs:LED-5MM |  |  |  | 6xUSB_PowMet-cache | Led_Small | /USB hub/ | /571758E7/ | 574FA375
D |  |  |  |  |  |  |  |  |  |  |  |  |  | R42 | 10K | Resistors_SMD:R_0805 |  |  |  | device | R_Small | /USB hub/ | /571758E7/ | 5757F961
D |  |  |  |  |  |  |  |  |  |  |  |  |  | U9 | FE1.1s | Housings_SSOP:TSSOP-28_4.4x9.7mm_Pitch0.65mm |  |  |  | 6xUSB_PowMet-cache | FE1.1s | /USB hub/ | /571758E7/ | 57179F33
D |  |  |  |  |  |  |  |  |  |  |  |  |  | R44 | 100K | Resistors_SMD:R_0805 |  |  |  | device | R_Small | /USB hub/ | /571758E7/ | 5762AED3
D |  |  |  |  |  |  |  |  |  |  |  |  |  | C30 | 0.1uF | Capacitors_SMD:C_0603 |  |  |  | device | C_Small | /USB hub/ | /571758E7/ | 5762AFA2
D |  |  |  |  |  |  |  |  |  |  |  |  |  | R45 | 100K | Resistors_SMD:R_0805 |  |  |  | device | R_Small | /USB hub/ | /571758E7/ | 5762BA86
D |  |  |  |  |  |  |  |  |  |  |  |  |  | C29 | 10nF | Capacitors_SMD:C_0805 |  |  |  | device | C_Small | /USB hub/ | /571758E7/ | 5762C62B
D |  |  |  |  |  |  |  |  |  |  |  |  |  | U1 | 24LC02 | Housings_SOIC:SOIC-8_3.9x4.9mm_Pitch1.27mm |  |  |  | memory | 24LC02 | /USB hub/ | /571758E7/ | 5762D4C9
D |  |  |  |  |  |  |  |  |  |  |  |  |  | L4 | Bead/100MHZ/470ohm/2A | Resistors_SMD:R_0805_HandSoldering |  |  |  | 6xUSB_PowMet-cache | INDUCTOR_SMALL | /USB hub/ | /571758E7/ | 5762F6C7
D |  |  |  |  |  |  |  |  |  |  |  |  |  | C24 | 0.1uF | Capacitors_SMD:C_0603 |  | 10% | Tolerance | device | C_Small | /USB hub/ | /571758E7/ | 5768147B
D |  |  |  |  |  |  |  |  |  |  |  |  |  | C24 | 0.1uF | Capacitors_SMD:C_0603 |  | Ceramic X5R | Material | device | C_Small | /USB hub/ | /571758E7/ | 5768147B
D |  |  |  |  |  |  |  |  |  |  |  |  |  | C24 | 0.1uF | Capacitors_SMD:C_0603 |  | 16V | Voltage | device | C_Small | /USB hub/ | /571758E7/ | 5768147B
D |  |  |  |  |  |  |  |  |  |  |  |  |  | C25 | 0.1uF | Capacitors_SMD:C_0603 |  |  |  | device | C_Small | /USB hub/ | /571758E7/ | 5768156F
D |  |  |  |  |  |  |  |  |  |  |  |  |  | D2 | MC Status | LEDs:LED_0603 |  | blue | Description | 6xUSB_PowMet-cache | Led_Small | /USB hub/ | /571758E7/ | 577C94E6
D |  |  |  |  |  |  |  |  |  |  |  |  |  | R31 | 330 | Resistors_SMD:R_0805 |  | 5% | Tolerance | device | R_Small | /USB hub/ | /571758E7/ | 594859CE
D |  |  |  |  |  |  |  |  |  |  |  |  |  | R30 | 330 | Resistors_SMD:R_0805 |  | 5% | Tolerance | device | R_Small | /USB hub/ | /571758E7/ | 59485ACB
D |  |  |  |  |  |  |  |  |  |  |  |  |  | L2 | WE-CNSW | Inductors_SMD:L_1206 | http://www.mouser.com/ds/2/445/744232090-538468.pdf | 744232090 | Part Number | device | L_Core_double_Iron_Small | /USB hub/ | /571758E7/ | 59715EDA
D |  |  |  |  |  |  |  |  |  |  |  |  |  | L2 | WE-CNSW | Inductors_SMD:L_1206 | http://www.mouser.com/ds/2/445/744232090-538468.pdf | Würth Elektronik | Manufacturer | device | L_Core_double_Iron_Small | /USB hub/ | /571758E7/ | 59715EDA
D |  |  |  |  |  |  |  |  |  |  |  |  |  | L2 | WE-CNSW | Inductors_SMD:L_1206 | http://www.mouser.com/ds/2/445/744232090-538468.pdf | Common Mode Chokes / Filters WE-CNSW LnFltr1206 90Ohm 100MHz 370mA | Description | device | L_Core_double_Iron_Small | /USB hub/ | /571758E7/ | 59715EDA
D |  |  |  |  |  |  |  |  |  |  |  |  |  | C51 | 47uF | Capacitors_SMD:C_1206 | http://static6.arrow.com/aropdfconversion/556eea1f159619aad65b0f118fbc089253989279/37024850441143360mlcc_commercial_general_en.pdf | 10% | Tolerance | device | C_Small | /USB hub/ | /571758E7/ | 597DCE4A
D |  |  |  |  |  |  |  |  |  |  |  |  |  | C51 | 47uF | Capacitors_SMD:C_1206 | http://static6.arrow.com/aropdfconversion/556eea1f159619aad65b0f118fbc089253989279/37024850441143360mlcc_commercial_general_en.pdf | Ceramic X5R | Material | device | C_Small | /USB hub/ | /571758E7/ | 597DCE4A
D |  |  |  |  |  |  |  |  |  |  |  |  |  | C51 | 47uF | Capacitors_SMD:C_1206 | http://static6.arrow.com/aropdfconversion/556eea1f159619aad65b0f118fbc089253989279/37024850441143360mlcc_commercial_general_en.pdf | 25V | Voltage | device | C_Small | /USB hub/ | /571758E7/ | 597DCE4A
D |  |  |  |  |  |  |  |  |  |  |  |  |  | C51 | 47uF | Capacitors_SMD:C_1206 | http://static6.arrow.com/aropdfconversion/556eea1f159619aad65b0f118fbc089253989279/37024850441143360mlcc_commercial_general_en.pdf | C3216X5R1E476M160AC | Part Number | device | C_Small | /USB hub/ | /571758E7/ | 597DCE4A
D |  |  |  |  |  |  |  |  |  |  |  |  |  | C51 | 47uF | Capacitors_SMD:C_1206 | http://static6.arrow.com/aropdfconversion/556eea1f159619aad65b0f118fbc089253989279/37024850441143360mlcc_commercial_general_en.pdf | TDK | Manufacturer | device | C_Small | /USB hub/ | /571758E7/ | 597DCE4A
D |  |  |  |  |  |  |  |  |  |  |  |  |  | C51 | 47uF | Capacitors_SMD:C_1206 | http://static6.arrow.com/aropdfconversion/556eea1f159619aad65b0f118fbc089253989279/37024850441143360mlcc_commercial_general_en.pdf | Cap Ceramic 47uF 25V X5R 20% Pad SMD 1206 85°C T/R | Description | device | C_Small | /USB hub/ | /571758E7/ | 597DCE4A
D |  |  |  |  |  |  |  |  |  |  |  |  |  | C31 | 47uF | Capacitors_SMD:C_1206 | http://static6.arrow.com/aropdfconversion/556eea1f159619aad65b0f118fbc089253989279/37024850441143360mlcc_commercial_general_en.pdf | 10% | Tolerance | device | C_Small | /USB hub/ | /571758E7/ | 597DCD6A
D |  |  |  |  |  |  |  |  |  |  |  |  |  | C31 | 47uF | Capacitors_SMD:C_1206 | http://static6.arrow.com/aropdfconversion/556eea1f159619aad65b0f118fbc089253989279/37024850441143360mlcc_commercial_general_en.pdf | Ceramic X5R | Material | device | C_Small | /USB hub/ | /571758E7/ | 597DCD6A
D |  |  |  |  |  |  |  |  |  |  |  |  |  | C31 | 47uF | Capacitors_SMD:C_1206 | http://static6.arrow.com/aropdfconversion/556eea1f159619aad65b0f118fbc089253989279/37024850441143360mlcc_commercial_general_en.pdf | 25V | Voltage | device | C_Small | /USB hub/ | /571758E7/ | 597DCD6A
D |  |  |  |  |  |  |  |  |  |  |  |  |  | C31 | 47uF | Capacitors_SMD:C_1206 | http://static6.arrow.com/aropdfconversion/556eea1f159619aad65b0f118fbc089253989279/37024850441143360mlcc_commercial_general_en.pdf | C3216X5R1E476M160AC | Part Number | device | C_Small | /USB hub/ | /571758E7/ | 597DCD6A
D |  |  |  |  |  |  |  |  |  |  |  |  |  | C31 | 47uF | Capacitors_SMD:C_1206 | http://static6.arrow.com/aropdfconversion/556eea1f159619aad65b0f118fbc089253989279/37024850441143360mlcc_commercial_general_en.pdf | TDK | Manufacturer | device | C_Small | /USB hub/ | /571758E7/ | 597DCD6A
D |  |  |  |  |  |  |  |  |  |  |  |  |  | C31 | 47uF | Capacitors_SMD:C_1206 | http://static6.arrow.com/aropdfconversion/556eea1f159619aad65b0f118fbc089253989279/37024850441143360mlcc_commercial_general_en.pdf | Cap Ceramic 47uF 25V X5R 20% Pad SMD 1206 85°C T/R | Description | device | C_Small | /USB hub/ | /571758E7/ | 597DCD6A
D |  |  |  |  |  |  |  |  |  |  |  |  |  | L5 | WE-CNSW | Inductors_SMD:L_1206 | http://www.mouser.com/ds/2/445/744232090-538468.pdf | 744232090 | Part Number | device | L_Core_double_Iron_Small | /USB hub/ | /571758E7/ | 597EBFE9
D |  |  |  |  |  |  |  |  |  |  |  |  |  | L5 | WE-CNSW | Inductors_SMD:L_1206 | http://www.mouser.com/ds/2/445/744232090-538468.pdf | Würth Elektronik | Manufacturer | device | L_Core_double_Iron_Small | /USB hub/ | /571758E7/ | 597EBFE9
D |  |  |  |  |  |  |  |  |  |  |  |  |  | L5 | WE-CNSW | Inductors_SMD:L_1206 | http://www.mouser.com/ds/2/445/744232090-538468.pdf | Common Mode Chokes / Filters WE-CNSW LnFltr1206 90Ohm 100MHz 370mA | Description | device | L_Core_double_Iron_Small | /USB hub/ | /571758E7/ | 597EBFE9
D |  |  |  |  |  |  |  |  |  |  |  |  |  | L6 | WE-CNSW | Inductors_SMD:L_1206 | http://www.mouser.com/ds/2/445/744232090-538468.pdf | 744232090 | Part Number | device | L_Core_double_Iron_Small | /USB hub/ | /571758E7/ | 597EC0CB
D |  |  |  |  |  |  |  |  |  |  |  |  |  | L6 | WE-CNSW | Inductors_SMD:L_1206 | http://www.mouser.com/ds/2/445/744232090-538468.pdf | Würth Elektronik | Manufacturer | device | L_Core_double_Iron_Small | /USB hub/ | /571758E7/ | 597EC0CB
D |  |  |  |  |  |  |  |  |  |  |  |  |  | L6 | WE-CNSW | Inductors_SMD:L_1206 | http://www.mouser.com/ds/2/445/744232090-538468.pdf | Common Mode Chokes / Filters WE-CNSW LnFltr1206 90Ohm 100MHz 370mA | Description | device | L_Core_double_Iron_Small | /USB hub/ | /571758E7/ | 597EC0CB
D |  |  |  |  |  |  |  |  |  |  |  |  |  | L7 | WE-CNSW | Inductors_SMD:L_1206 | http://www.mouser.com/ds/2/445/744232090-538468.pdf | 744232090 | Part Number | device | L_Core_double_Iron_Small | /USB hub/ | /571758E7/ | 597EC1B8
D |  |  |  |  |  |  |  |  |  |  |  |  |  | L7 | WE-CNSW | Inductors_SMD:L_1206 | http://www.mouser.com/ds/2/445/744232090-538468.pdf | Würth Elektronik | Manufacturer | device | L_Core_double_Iron_Small | /USB hub/ | /571758E7/ | 597EC1B8
D |  |  |  |  |  |  |  |  |  |  |  |  |  | L7 | WE-CNSW | Inductors_SMD:L_1206 | http://www.mouser.com/ds/2/445/744232090-538468.pdf | Common Mode Chokes / Filters WE-CNSW LnFltr1206 90Ohm 100MHz 370mA | Description | device | L_Core_double_Iron_Small | /USB hub/ | /571758E7/ | 597EC1B8
D |  |  |  |  |  |  |  |  |  |  |  |  |  | L10 | WE-CNSW | Inductors_SMD:L_1206 | http://www.mouser.com/ds/2/445/744232090-538468.pdf | 744232090 | Part Number | device | L_Core_double_Iron_Small | /USB hub/ | /571758E7/ | 597EC2A4
D |  |  |  |  |  |  |  |  |  |  |  |  |  | L10 | WE-CNSW | Inductors_SMD:L_1206 | http://www.mouser.com/ds/2/445/744232090-538468.pdf | Würth Elektronik | Manufacturer | device | L_Core_double_Iron_Small | /USB hub/ | /571758E7/ | 597EC2A4
D |  |  |  |  |  |  |  |  |  |  |  |  |  | L10 | WE-CNSW | Inductors_SMD:L_1206 | http://www.mouser.com/ds/2/445/744232090-538468.pdf | Common Mode Chokes / Filters WE-CNSW LnFltr1206 90Ohm 100MHz 370mA | Description | device | L_Core_double_Iron_Small | /USB hub/ | /571758E7/ | 597EC2A4
D |  |  |  |  |  |  |  |  |  |  |  |  |  |  |  |  |  |  |  |  |  |  |  |  | memory | 24LC16 | 24LC00 | I2C Serial EEPROM, 16kb | http://ww1.microchip.com/downloads/en/DeviceDoc/21703d.pdf
D |  |  |  |  |  |  |  |  |  |  |  |  |  |  |  |  |  |  |  |  |  |  |  |  | memory | 24LC16 | 24LC01 | I2C Serial EEPROM, 16kb | http://ww1.microchip.com/downloads/en/DeviceDoc/21703d.pdf
D |  |  |  |  |  |  |  |  |  |  |  |  |  |  |  |  |  |  |  |  |  |  |  |  | memory | 24LC16 | 24LC02 | I2C Serial EEPROM, 16kb | http://ww1.microchip.com/downloads/en/DeviceDoc/21703d.pdf
D |  |  |  |  |  |  |  |  |  |  |  |  |  |  |  |  |  |  |  |  |  |  |  |  | memory | 24LC16 | 24LC04 | I2C Serial EEPROM, 16kb | http://ww1.microchip.com/downloads/en/DeviceDoc/21703d.pdf
D |  |  |  |  |  |  |  |  |  |  |  |  |  |  |  |  |  |  |  |  |  |  |  |  | memory | 24LC16 | 24LC08 | I2C Serial EEPROM, 16kb | http://ww1.microchip.com/downloads/en/DeviceDoc/21703d.pdf
D |  |  |  |  |  |  |  |  |  |  |  |  |  |  |  |  |  |  |  |  |  |  |  |  | memory | 24LC16 | 24LC32 | I2C Serial EEPROM, 16kb | http://ww1.microchip.com/downloads/en/DeviceDoc/21703d.pdf
D |  |  |  |  |  |  |  |  |  |  |  |  |  |  |  |  |  |  |  |  |  |  |  |  | memory | 24LC16 | 24LC64 | I2C Serial EEPROM, 16kb | http://ww1.microchip.com/downloads/en/DeviceDoc/21703d.pdf
D |  |  |  |  |  |  |  |  |  |  |  |  |  |  |  |  |  |  |  |  |  |  |  |  | memory | 24LC16 | 24LC128 | I2C Serial EEPROM, 16kb | http://ww1.microchip.com/downloads/en/DeviceDoc/21703d.pdf
D |  |  |  |  |  |  |  |  |  |  |  |  |  |  |  |  |  |  |  |  |  |  |  |  | memory | 24LC16 | 24LC256 | I2C Serial EEPROM, 16kb | http://ww1.microchip.com/downloads/en/DeviceDoc/21703d.pdf
D |  |  |  |  |  |  |  |  |  |  |  |  |  |  |  |  |  |  |  |  |  |  |  |  | memory | 24LC16 | 24LC512 | I2C Serial EEPROM, 16kb | http://ww1.microchip.com/downloads/en/DeviceDoc/21703d.pdf
D |  |  |  |  |  |  |  |  |  |  |  |  |  |  |  |  |  |  |  |  |  |  |  |  | memory | 24LC16 | 24LC1025 | I2C Serial EEPROM, 16kb | http://ww1.microchip.com/downloads/en/DeviceDoc/21703d.pdf
D |  |  |  |  |  |  |  |  |  |  |  |  |  |  |  |  |  |  |  |  |  |  |  |  | memory | 24LC16 |  | I2C Serial EEPROM, 16kb | http://ww1.microchip.com/downloads/en/DeviceDoc/21703d.pdf | SOIC*
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
D |  |  |  |  |  |  |  |  |  |  |  |  |  |  |  |  |  |  |  |  |  |  |  |  | atmel | ATMEGA16U4-AU |  | TQFP44, 16K Flash, 1.25K SRAM, 512B EEPROM, USB2.0 | http://www.atmel.com/images/atmel-7766-8-bit-avr-atmega16u4-32u4_%20datasheet.pdf |  |  |  | 7 | VBUS | passive
D |  |  |  |  |  |  |  |  |  |  |  |  |  |  |  |  |  |  |  |  |  |  |  |  | atmel | ATMEGA16U4-AU |  | TQFP44, 16K Flash, 1.25K SRAM, 512B EEPROM, USB2.0 | http://www.atmel.com/images/atmel-7766-8-bit-avr-atmega16u4-32u4_%20datasheet.pdf |  |  |  | 8 | (SS/PCINT0)PB0 | BiDi
D |  |  |  |  |  |  |  |  |  |  |  |  |  |  |  |  |  |  |  |  |  |  |  |  | atmel | ATMEGA16U4-AU |  | TQFP44, 16K Flash, 1.25K SRAM, 512B EEPROM, USB2.0 | http://www.atmel.com/images/atmel-7766-8-bit-avr-atmega16u4-32u4_%20datasheet.pdf |  |  |  | 9 | (SCLK/PCINT1)PB1 | BiDi
D |  |  |  |  |  |  |  |  |  |  |  |  |  |  |  |  |  |  |  |  |  |  |  |  | atmel | ATMEGA16U4-AU |  | TQFP44, 16K Flash, 1.25K SRAM, 512B EEPROM, USB2.0 | http://www.atmel.com/images/atmel-7766-8-bit-avr-atmega16u4-32u4_%20datasheet.pdf |  |  |  | 10 | (PDI/MOSI/PCINT2)PB2 | BiDi
D |  |  |  |  |  |  |  |  |  |  |  |  |  |  |  |  |  |  |  |  |  |  |  |  | atmel | ATMEGA16U4-AU |  | TQFP44, 16K Flash, 1.25K SRAM, 512B EEPROM, USB2.0 | http://www.atmel.com/images/atmel-7766-8-bit-avr-atmega16u4-32u4_%20datasheet.pdf |  |  |  | 11 | (PDO/MISO/PCINT3)PB3 | BiDi
D |  |  |  |  |  |  |  |  |  |  |  |  |  |  |  |  |  |  |  |  |  |  |  |  | atmel | ATMEGA16U4-AU |  | TQFP44, 16K Flash, 1.25K SRAM, 512B EEPROM, USB2.0 | http://www.atmel.com/images/atmel-7766-8-bit-avr-atmega16u4-32u4_%20datasheet.pdf |  |  |  | 12 | (OC0A/OC1C/~RTS~/PCINT7)PB7 | BiDi
D |  |  |  |  |  |  |  |  |  |  |  |  |  |  |  |  |  |  |  |  |  |  |  |  | atmel | ATMEGA16U4-AU |  | TQFP44, 16K Flash, 1.25K SRAM, 512B EEPROM, USB2.0 | http://www.atmel.com/images/atmel-7766-8-bit-avr-atmega16u4-32u4_%20datasheet.pdf |  |  |  | 13 | ~RESET~ | input
D |  |  |  |  |  |  |  |  |  |  |  |  |  |  |  |  |  |  |  |  |  |  |  |  | atmel | ATMEGA16U4-AU |  | TQFP44, 16K Flash, 1.25K SRAM, 512B EEPROM, USB2.0 | http://www.atmel.com/images/atmel-7766-8-bit-avr-atmega16u4-32u4_%20datasheet.pdf |  |  |  | 14 | VCC | power_in
D |  |  |  |  |  |  |  |  |  |  |  |  |  |  |  |  |  |  |  |  |  |  |  |  | atmel | ATMEGA16U4-AU |  | TQFP44, 16K Flash, 1.25K SRAM, 512B EEPROM, USB2.0 | http://www.atmel.com/images/atmel-7766-8-bit-avr-atmega16u4-32u4_%20datasheet.pdf |  |  |  | 15 | GND | power_in
D |  |  |  |  |  |  |  |  |  |  |  |  |  |  |  |  |  |  |  |  |  |  |  |  | atmel | ATMEGA16U4-AU |  | TQFP44, 16K Flash, 1.25K SRAM, 512B EEPROM, USB2.0 | http://www.atmel.com/images/atmel-7766-8-bit-avr-atmega16u4-32u4_%20datasheet.pdf |  |  |  | 16 | XTAL2 | output
D |  |  |  |  |  |  |  |  |  |  |  |  |  |  |  |  |  |  |  |  |  |  |  |  | atmel | ATMEGA16U4-AU |  | TQFP44, 16K Flash, 1.25K SRAM, 512B EEPROM, USB2.0 | http://www.atmel.com/images/atmel-7766-8-bit-avr-atmega16u4-32u4_%20datasheet.pdf |  |  |  | 17 | XTAL1 | input
D |  |  |  |  |  |  |  |  |  |  |  |  |  |  |  |  |  |  |  |  |  |  |  |  | atmel | ATMEGA16U4-AU |  | TQFP44, 16K Flash, 1.25K SRAM, 512B EEPROM, USB2.0 | http://www.atmel.com/images/atmel-7766-8-bit-avr-atmega16u4-32u4_%20datasheet.pdf |  |  |  | 18 | (OC0B/SCL/INT0)PD0 | BiDi
D |  |  |  |  |  |  |  |  |  |  |  |  |  |  |  |  |  |  |  |  |  |  |  |  | atmel | ATMEGA16U4-AU |  | TQFP44, 16K Flash, 1.25K SRAM, 512B EEPROM, USB2.0 | http://www.atmel.com/images/atmel-7766-8-bit-avr-atmega16u4-32u4_%20datasheet.pdf |  |  |  | 19 | (SDA/INT1)PD1 | BiDi
D |  |  |  |  |  |  |  |  |  |  |  |  |  |  |  |  |  |  |  |  |  |  |  |  | atmel | ATMEGA16U4-AU |  | TQFP44, 16K Flash, 1.25K SRAM, 512B EEPROM, USB2.0 | http://www.atmel.com/images/atmel-7766-8-bit-avr-atmega16u4-32u4_%20datasheet.pdf |  |  |  | 20 | (RXD/INT2)PD2 | BiDi
D |  |  |  |  |  |  |  |  |  |  |  |  |  |  |  |  |  |  |  |  |  |  |  |  | atmel | ATMEGA16U4-AU |  | TQFP44, 16K Flash, 1.25K SRAM, 512B EEPROM, USB2.0 | http://www.atmel.com/images/atmel-7766-8-bit-avr-atmega16u4-32u4_%20datasheet.pdf |  |  |  | 21 | (TXD/INT3)PD3 | BiDi
D |  |  |  |  |  |  |  |  |  |  |  |  |  |  |  |  |  |  |  |  |  |  |  |  | atmel | ATMEGA16U4-AU |  | TQFP44, 16K Flash, 1.25K SRAM, 512B EEPROM, USB2.0 | http://www.atmel.com/images/atmel-7766-8-bit-avr-atmega16u4-32u4_%20datasheet.pdf |  |  |  | 22 | (XCK1/~CTS~)PD5 | BiDi
D |  |  |  |  |  |  |  |  |  |  |  |  |  |  |  |  |  |  |  |  |  |  |  |  | atmel | ATMEGA16U4-AU |  | TQFP44, 16K Flash, 1.25K SRAM, 512B EEPROM, USB2.0 | http://www.atmel.com/images/atmel-7766-8-bit-avr-atmega16u4-32u4_%20datasheet.pdf |  |  |  | 23 | GND | power_in
D |  |  |  |  |  |  |  |  |  |  |  |  |  |  |  |  |  |  |  |  |  |  |  |  | atmel | ATMEGA16U4-AU |  | TQFP44, 16K Flash, 1.25K SRAM, 512B EEPROM, USB2.0 | http://www.atmel.com/images/atmel-7766-8-bit-avr-atmega16u4-32u4_%20datasheet.pdf |  |  |  | 24 | AVCC | power_in
D |  |  |  |  |  |  |  |  |  |  |  |  |  |  |  |  |  |  |  |  |  |  |  |  | atmel | ATMEGA16U4-AU |  | TQFP44, 16K Flash, 1.25K SRAM, 512B EEPROM, USB2.0 | http://www.atmel.com/images/atmel-7766-8-bit-avr-atmega16u4-32u4_%20datasheet.pdf |  |  |  | 25 | (ICP2/ADC8)PD4 | BiDi
D |  |  |  |  |  |  |  |  |  |  |  |  |  |  |  |  |  |  |  |  |  |  |  |  | atmel | ATMEGA16U4-AU |  | TQFP44, 16K Flash, 1.25K SRAM, 512B EEPROM, USB2.0 | http://www.atmel.com/images/atmel-7766-8-bit-avr-atmega16u4-32u4_%20datasheet.pdf |  |  |  | 26 | (T1/~OC4D~/ADC9)PD6 | BiDi
D |  |  |  |  |  |  |  |  |  |  |  |  |  |  |  |  |  |  |  |  |  |  |  |  | atmel | ATMEGA16U4-AU |  | TQFP44, 16K Flash, 1.25K SRAM, 512B EEPROM, USB2.0 | http://www.atmel.com/images/atmel-7766-8-bit-avr-atmega16u4-32u4_%20datasheet.pdf |  |  |  | 27 | (T0/OC4D/ADC10)PD7 | BiDi
D |  |  |  |  |  |  |  |  |  |  |  |  |  |  |  |  |  |  |  |  |  |  |  |  | atmel | ATMEGA16U4-AU |  | TQFP44, 16K Flash, 1.25K SRAM, 512B EEPROM, USB2.0 | http://www.atmel.com/images/atmel-7766-8-bit-avr-atmega16u4-32u4_%20datasheet.pdf |  |  |  | 28 | (ADC11/PCINT4)PB4 | BiDi
D |  |  |  |  |  |  |  |  |  |  |  |  |  |  |  |  |  |  |  |  |  |  |  |  | atmel | ATMEGA16U4-AU |  | TQFP44, 16K Flash, 1.25K SRAM, 512B EEPROM, USB2.0 | http://www.atmel.com/images/atmel-7766-8-bit-avr-atmega16u4-32u4_%20datasheet.pdf |  |  |  | 29 | (ADC12/OC1A/~OC4B~/PCINT12)PB5 | BiDi
D |  |  |  |  |  |  |  |  |  |  |  |  |  |  |  |  |  |  |  |  |  |  |  |  | atmel | ATMEGA16U4-AU |  | TQFP44, 16K Flash, 1.25K SRAM, 512B EEPROM, USB2.0 | http://www.atmel.com/images/atmel-7766-8-bit-avr-atmega16u4-32u4_%20datasheet.pdf |  |  |  | 30 | (ADC13/OC1B/OC4B/PCINT13)PB6 | BiDi
D |  |  |  |  |  |  |  |  |  |  |  |  |  |  |  |  |  |  |  |  |  |  |  |  | atmel | ATMEGA16U4-AU |  | TQFP44, 16K Flash, 1.25K SRAM, 512B EEPROM, USB2.0 | http://www.atmel.com/images/atmel-7766-8-bit-avr-atmega16u4-32u4_%20datasheet.pdf |  |  |  | 31 | (OC3A/~OC4A~)PC6 | BiDi
D |  |  |  |  |  |  |  |  |  |  |  |  |  |  |  |  |  |  |  |  |  |  |  |  | atmel | ATMEGA16U4-AU |  | TQFP44, 16K Flash, 1.25K SRAM, 512B EEPROM, USB2.0 | http://www.atmel.com/images/atmel-7766-8-bit-avr-atmega16u4-32u4_%20datasheet.pdf |  |  |  | 32 | (ICP3/CLK0/OC4A)PC7 | BiDi
D |  |  |  |  |  |  |  |  |  |  |  |  |  |  |  |  |  |  |  |  |  |  |  |  | atmel | ATMEGA16U4-AU |  | TQFP44, 16K Flash, 1.25K SRAM, 512B EEPROM, USB2.0 | http://www.atmel.com/images/atmel-7766-8-bit-avr-atmega16u4-32u4_%20datasheet.pdf |  |  |  | 33 | (~HWB~)PE2 | BiDi
D |  |  |  |  |  |  |  |  |  |  |  |  |  |  |  |  |  |  |  |  |  |  |  |  | atmel | ATMEGA16U4-AU |  | TQFP44, 16K Flash, 1.25K SRAM, 512B EEPROM, USB2.0 | http://www.atmel.com/images/atmel-7766-8-bit-avr-atmega16u4-32u4_%20datasheet.pdf |  |  |  | 34 | VCC | power_in
D |  |  |  |  |  |  |  |  |  |  |  |  |  |  |  |  |  |  |  |  |  |  |  |  | atmel | ATMEGA16U4-AU |  | TQFP44, 16K Flash, 1.25K SRAM, 512B EEPROM, USB2.0 | http://www.atmel.com/images/atmel-7766-8-bit-avr-atmega16u4-32u4_%20datasheet.pdf |  |  |  | 35 | GND | power_in
D |  |  |  |  |  |  |  |  |  |  |  |  |  |  |  |  |  |  |  |  |  |  |  |  | atmel | ATMEGA16U4-AU |  | TQFP44, 16K Flash, 1.25K SRAM, 512B EEPROM, USB2.0 | http://www.atmel.com/images/atmel-7766-8-bit-avr-atmega16u4-32u4_%20datasheet.pdf |  |  |  | 36 | (ADC7/TDI)PF7 | BiDi
D |  |  |  |  |  |  |  |  |  |  |  |  |  |  |  |  |  |  |  |  |  |  |  |  | atmel | ATMEGA16U4-AU |  | TQFP44, 16K Flash, 1.25K SRAM, 512B EEPROM, USB2.0 | http://www.atmel.com/images/atmel-7766-8-bit-avr-atmega16u4-32u4_%20datasheet.pdf |  |  |  | 37 | (ADC6/TDO)PF6 | BiDi
D |  |  |  |  |  |  |  |  |  |  |  |  |  |  |  |  |  |  |  |  |  |  |  |  | atmel | ATMEGA16U4-AU |  | TQFP44, 16K Flash, 1.25K SRAM, 512B EEPROM, USB2.0 | http://www.atmel.com/images/atmel-7766-8-bit-avr-atmega16u4-32u4_%20datasheet.pdf |  |  |  | 38 | (ADC5/TMS)PF5 | BiDi
D |  |  |  |  |  |  |  |  |  |  |  |  |  |  |  |  |  |  |  |  |  |  |  |  | atmel | ATMEGA16U4-AU |  | TQFP44, 16K Flash, 1.25K SRAM, 512B EEPROM, USB2.0 | http://www.atmel.com/images/atmel-7766-8-bit-avr-atmega16u4-32u4_%20datasheet.pdf |  |  |  | 39 | (ADC4/TCK)PF4 | BiDi
D |  |  |  |  |  |  |  |  |  |  |  |  |  |  |  |  |  |  |  |  |  |  |  |  | atmel | ATMEGA16U4-AU |  | TQFP44, 16K Flash, 1.25K SRAM, 512B EEPROM, USB2.0 | http://www.atmel.com/images/atmel-7766-8-bit-avr-atmega16u4-32u4_%20datasheet.pdf |  |  |  | 40 | (ADC1)PF1 | BiDi
D |  |  |  |  |  |  |  |  |  |  |  |  |  |  |  |  |  |  |  |  |  |  |  |  | atmel | ATMEGA16U4-AU |  | TQFP44, 16K Flash, 1.25K SRAM, 512B EEPROM, USB2.0 | http://www.atmel.com/images/atmel-7766-8-bit-avr-atmega16u4-32u4_%20datasheet.pdf |  |  |  | 41 | (ADC0)PF0 | BiDi
D |  |  |  |  |  |  |  |  |  |  |  |  |  |  |  |  |  |  |  |  |  |  |  |  | atmel | ATMEGA16U4-AU |  | TQFP44, 16K Flash, 1.25K SRAM, 512B EEPROM, USB2.0 | http://www.atmel.com/images/atmel-7766-8-bit-avr-atmega16u4-32u4_%20datasheet.pdf |  |  |  | 42 | AREF | passive
D |  |  |  |  |  |  |  |  |  |  |  |  |  |  |  |  |  |  |  |  |  |  |  |  | atmel | ATMEGA16U4-AU |  | TQFP44, 16K Flash, 1.25K SRAM, 512B EEPROM, USB2.0 | http://www.atmel.com/images/atmel-7766-8-bit-avr-atmega16u4-32u4_%20datasheet.pdf |  |  |  | 43 | GND | power_in
D |  |  |  |  |  |  |  |  |  |  |  |  |  |  |  |  |  |  |  |  |  |  |  |  | atmel | ATMEGA16U4-AU |  | TQFP44, 16K Flash, 1.25K SRAM, 512B EEPROM, USB2.0 | http://www.atmel.com/images/atmel-7766-8-bit-avr-atmega16u4-32u4_%20datasheet.pdf |  |  |  | 44 | AVCC | power_in
D |  |  |  |  |  |  |  |  |  |  |  |  |  |  |  |  |  |  |  |  |  |  |  |  | 6xUSB_PowMet-cache | BARREL_JACK |  |  |  |  | J | Reference
D |  |  |  |  |  |  |  |  |  |  |  |  |  |  |  |  |  |  |  |  |  |  |  |  | 6xUSB_PowMet-cache | BARREL_JACK |  |  |  |  | BARREL_JACK | Value
D |  |  |  |  |  |  |  |  |  |  |  |  |  |  |  |  |  |  |  |  |  |  |  |  | 6xUSB_PowMet-cache | BARREL_JACK |  |  |  |  |  |  | 1 | ~ | passive
D |  |  |  |  |  |  |  |  |  |  |  |  |  |  |  |  |  |  |  |  |  |  |  |  | 6xUSB_PowMet-cache | BARREL_JACK |  |  |  |  |  |  | 2 | ~ | passive
D |  |  |  |  |  |  |  |  |  |  |  |  |  |  |  |  |  |  |  |  |  |  |  |  | 6xUSB_PowMet-cache | BARREL_JACK |  |  |  |  |  |  | 3 | ~ | passive
D |  |  |  |  |  |  |  |  |  |  |  |  |  |  |  |  |  |  |  |  |  |  |  |  | device | C |  | Unpolarized capacitor |  | C_*
D |  |  |  |  |  |  |  |  |  |  |  |  |  |  |  |  |  |  |  |  |  |  |  |  | device | C |  | Unpolarized capacitor |  |  | C | Reference
D |  |  |  |  |  |  |  |  |  |  |  |  |  |  |  |  |  |  |  |  |  |  |  |  | device | C |  | Unpolarized capacitor |  |  | C | Value
D |  |  |  |  |  |  |  |  |  |  |  |  |  |  |  |  |  |  |  |  |  |  |  |  | device | C |  | Unpolarized capacitor |  |  |  |  | 1 | ~ | passive
D |  |  |  |  |  |  |  |  |  |  |  |  |  |  |  |  |  |  |  |  |  |  |  |  | device | C |  | Unpolarized capacitor |  |  |  |  | 2 | ~ | passive
D |  |  |  |  |  |  |  |  |  |  |  |  |  |  |  |  |  |  |  |  |  |  |  |  | conn | CONN_01X02 |  | Connector, single row, 01x02, pin header |  | Pin_Header_Straight_1X*
D |  |  |  |  |  |  |  |  |  |  |  |  |  |  |  |  |  |  |  |  |  |  |  |  | conn | CONN_01X02 |  | Connector, single row, 01x02, pin header |  | Pin_Header_Angled_1X*
D |  |  |  |  |  |  |  |  |  |  |  |  |  |  |  |  |  |  |  |  |  |  |  |  | conn | CONN_01X02 |  | Connector, single row, 01x02, pin header |  | Socket_Strip_Straight_1X*
D |  |  |  |  |  |  |  |  |  |  |  |  |  |  |  |  |  |  |  |  |  |  |  |  | conn | CONN_01X02 |  | Connector, single row, 01x02, pin header |  | Socket_Strip_Angled_1X*
D |  |  |  |  |  |  |  |  |  |  |  |  |  |  |  |  |  |  |  |  |  |  |  |  | conn | CONN_01X02 |  | Connector, single row, 01x02, pin header |  |  | J | Reference
D |  |  |  |  |  |  |  |  |  |  |  |  |  |  |  |  |  |  |  |  |  |  |  |  | conn | CONN_01X02 |  | Connector, single row, 01x02, pin header |  |  | CONN_01X02 | Value
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
D |  |  |  |  |  |  |  |  |  |  |  |  |  |  |  |  |  |  |  |  |  |  |  |  | device | Crystal_Small |  | Two pin crystal, small symbol |  |  | Crystal_Small | Value
D |  |  |  |  |  |  |  |  |  |  |  |  |  |  |  |  |  |  |  |  |  |  |  |  | device | Crystal_Small |  | Two pin crystal, small symbol |  |  |  |  | 1 | 1 | passive
D |  |  |  |  |  |  |  |  |  |  |  |  |  |  |  |  |  |  |  |  |  |  |  |  | device | Crystal_Small |  | Two pin crystal, small symbol |  |  |  |  | 2 | 2 | passive
D |  |  |  |  |  |  |  |  |  |  |  |  |  |  |  |  |  |  |  |  |  |  |  |  | device | D |  | Diode |  | TO-???*
D |  |  |  |  |  |  |  |  |  |  |  |  |  |  |  |  |  |  |  |  |  |  |  |  | device | D |  | Diode |  | *SingleDiode
D |  |  |  |  |  |  |  |  |  |  |  |  |  |  |  |  |  |  |  |  |  |  |  |  | device | D |  | Diode |  | *_Diode_*
D |  |  |  |  |  |  |  |  |  |  |  |  |  |  |  |  |  |  |  |  |  |  |  |  | device | D |  | Diode |  | *SingleDiode*
D |  |  |  |  |  |  |  |  |  |  |  |  |  |  |  |  |  |  |  |  |  |  |  |  | device | D |  | Diode |  | D_*
D |  |  |  |  |  |  |  |  |  |  |  |  |  |  |  |  |  |  |  |  |  |  |  |  | device | D |  | Diode |  |  | D | Reference
D |  |  |  |  |  |  |  |  |  |  |  |  |  |  |  |  |  |  |  |  |  |  |  |  | device | D |  | Diode |  |  | D | Value
D |  |  |  |  |  |  |  |  |  |  |  |  |  |  |  |  |  |  |  |  |  |  |  |  | device | D |  | Diode |  |  |  |  | 1 | K | passive
D |  |  |  |  |  |  |  |  |  |  |  |  |  |  |  |  |  |  |  |  |  |  |  |  | device | D |  | Diode |  |  |  |  | 2 | A | passive
D |  |  |  |  |  |  |  |  |  |  |  |  |  |  |  |  |  |  |  |  |  |  |  |  | device | D_Schottky |  | Schottky diode |  | TO-???*
D |  |  |  |  |  |  |  |  |  |  |  |  |  |  |  |  |  |  |  |  |  |  |  |  | device | D_Schottky |  | Schottky diode |  | *SingleDiode
D |  |  |  |  |  |  |  |  |  |  |  |  |  |  |  |  |  |  |  |  |  |  |  |  | device | D_Schottky |  | Schottky diode |  | *_Diode_*
D |  |  |  |  |  |  |  |  |  |  |  |  |  |  |  |  |  |  |  |  |  |  |  |  | device | D_Schottky |  | Schottky diode |  | *SingleDiode*
D |  |  |  |  |  |  |  |  |  |  |  |  |  |  |  |  |  |  |  |  |  |  |  |  | device | D_Schottky |  | Schottky diode |  | D_*
D |  |  |  |  |  |  |  |  |  |  |  |  |  |  |  |  |  |  |  |  |  |  |  |  | device | D_Schottky |  | Schottky diode |  |  | D | Reference
D |  |  |  |  |  |  |  |  |  |  |  |  |  |  |  |  |  |  |  |  |  |  |  |  | device | D_Schottky |  | Schottky diode |  |  | D_Schottky | Value
D |  |  |  |  |  |  |  |  |  |  |  |  |  |  |  |  |  |  |  |  |  |  |  |  | device | D_Schottky |  | Schottky diode |  |  |  |  | 1 | K | passive
D |  |  |  |  |  |  |  |  |  |  |  |  |  |  |  |  |  |  |  |  |  |  |  |  | device | D_Schottky |  | Schottky diode |  |  |  |  | 2 | A | passive
D |  |  |  |  |  |  |  |  |  |  |  |  |  |  |  |  |  |  |  |  |  |  |  |  | ESP8266 | ESP-12E |  | ESP8622 ESP-12E module, 22 pins, 2mm, PCB antenna | http://l0l.org.uk/2014/12/esp8266-modules-hardware-guide-gotta-catch-em-all/ | ESP-12E
D |  |  |  |  |  |  |  |  |  |  |  |  |  |  |  |  |  |  |  |  |  |  |  |  | ESP8266 | ESP-12E |  | ESP8622 ESP-12E module, 22 pins, 2mm, PCB antenna | http://l0l.org.uk/2014/12/esp8266-modules-hardware-guide-gotta-catch-em-all/ |  | U | Reference
D |  |  |  |  |  |  |  |  |  |  |  |  |  |  |  |  |  |  |  |  |  |  |  |  | ESP8266 | ESP-12E |  | ESP8622 ESP-12E module, 22 pins, 2mm, PCB antenna | http://l0l.org.uk/2014/12/esp8266-modules-hardware-guide-gotta-catch-em-all/ |  | ESP-12E | Value
D |  |  |  |  |  |  |  |  |  |  |  |  |  |  |  |  |  |  |  |  |  |  |  |  | ESP8266 | ESP-12E |  | ESP8622 ESP-12E module, 22 pins, 2mm, PCB antenna | http://l0l.org.uk/2014/12/esp8266-modules-hardware-guide-gotta-catch-em-all/ |  |  |  | 1 | REST | input
D |  |  |  |  |  |  |  |  |  |  |  |  |  |  |  |  |  |  |  |  |  |  |  |  | ESP8266 | ESP-12E |  | ESP8622 ESP-12E module, 22 pins, 2mm, PCB antenna | http://l0l.org.uk/2014/12/esp8266-modules-hardware-guide-gotta-catch-em-all/ |  |  |  | 2 | ADC | passive
D |  |  |  |  |  |  |  |  |  |  |  |  |  |  |  |  |  |  |  |  |  |  |  |  | ESP8266 | ESP-12E |  | ESP8622 ESP-12E module, 22 pins, 2mm, PCB antenna | http://l0l.org.uk/2014/12/esp8266-modules-hardware-guide-gotta-catch-em-all/ |  |  |  | 3 | CH_PD | input
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
D |  |  |  |  |  |  |  |  |  |  |  |  |  |  |  |  |  |  |  |  |  |  |  |  | ESP8266 | ESP-12E |  | ESP8622 ESP-12E module, 22 pins, 2mm, PCB antenna | http://l0l.org.uk/2014/12/esp8266-modules-hardware-guide-gotta-catch-em-all/ |  |  |  | 20 | GPIO5 | BiDi
D |  |  |  |  |  |  |  |  |  |  |  |  |  |  |  |  |  |  |  |  |  |  |  |  | ESP8266 | ESP-12E |  | ESP8622 ESP-12E module, 22 pins, 2mm, PCB antenna | http://l0l.org.uk/2014/12/esp8266-modules-hardware-guide-gotta-catch-em-all/ |  |  |  | 21 | RXD | input
D |  |  |  |  |  |  |  |  |  |  |  |  |  |  |  |  |  |  |  |  |  |  |  |  | ESP8266 | ESP-12E |  | ESP8622 ESP-12E module, 22 pins, 2mm, PCB antenna | http://l0l.org.uk/2014/12/esp8266-modules-hardware-guide-gotta-catch-em-all/ |  |  |  | 22 | TXD | output
D |  |  |  |  |  |  |  |  |  |  |  |  |  |  |  |  |  |  |  |  |  |  |  |  | 6xUSB_PowMet-cache | FE1.1s |  |  |  |  | U | Reference
D |  |  |  |  |  |  |  |  |  |  |  |  |  |  |  |  |  |  |  |  |  |  |  |  | 6xUSB_PowMet-cache | FE1.1s |  |  |  |  | FE1.1s | Value
D |  |  |  |  |  |  |  |  |  |  |  |  |  |  |  |  |  |  |  |  |  |  |  |  | 6xUSB_PowMet-cache | FE1.1s |  |  |  |  |  |  | 1 | VSS | power_in
D |  |  |  |  |  |  |  |  |  |  |  |  |  |  |  |  |  |  |  |  |  |  |  |  | 6xUSB_PowMet-cache | FE1.1s |  |  |  |  |  |  | 2 | XOUT | output
D |  |  |  |  |  |  |  |  |  |  |  |  |  |  |  |  |  |  |  |  |  |  |  |  | 6xUSB_PowMet-cache | FE1.1s |  |  |  |  |  |  | 3 | XIN | input
D |  |  |  |  |  |  |  |  |  |  |  |  |  |  |  |  |  |  |  |  |  |  |  |  | 6xUSB_PowMet-cache | FE1.1s |  |  |  |  |  |  | 4 | DM4 | BiDi
D |  |  |  |  |  |  |  |  |  |  |  |  |  |  |  |  |  |  |  |  |  |  |  |  | 6xUSB_PowMet-cache | FE1.1s |  |  |  |  |  |  | 5 | DP4 | BiDi
D |  |  |  |  |  |  |  |  |  |  |  |  |  |  |  |  |  |  |  |  |  |  |  |  | 6xUSB_PowMet-cache | FE1.1s |  |  |  |  |  |  | 6 | DM3 | BiDi
D |  |  |  |  |  |  |  |  |  |  |  |  |  |  |  |  |  |  |  |  |  |  |  |  | 6xUSB_PowMet-cache | FE1.1s |  |  |  |  |  |  | 7 | DP3 | BiDi
D |  |  |  |  |  |  |  |  |  |  |  |  |  |  |  |  |  |  |  |  |  |  |  |  | 6xUSB_PowMet-cache | FE1.1s |  |  |  |  |  |  | 8 | DM2 | BiDi
D |  |  |  |  |  |  |  |  |  |  |  |  |  |  |  |  |  |  |  |  |  |  |  |  | 6xUSB_PowMet-cache | FE1.1s |  |  |  |  |  |  | 9 | DP2 | BiDi
D |  |  |  |  |  |  |  |  |  |  |  |  |  |  |  |  |  |  |  |  |  |  |  |  | 6xUSB_PowMet-cache | FE1.1s |  |  |  |  |  |  | 10 | DM1 | BiDi
D |  |  |  |  |  |  |  |  |  |  |  |  |  |  |  |  |  |  |  |  |  |  |  |  | 6xUSB_PowMet-cache | FE1.1s |  |  |  |  |  |  | 11 | DP1 | BiDi
D |  |  |  |  |  |  |  |  |  |  |  |  |  |  |  |  |  |  |  |  |  |  |  |  | 6xUSB_PowMet-cache | FE1.1s |  |  |  |  |  |  | 12 | VD18_O | power_out
D |  |  |  |  |  |  |  |  |  |  |  |  |  |  |  |  |  |  |  |  |  |  |  |  | 6xUSB_PowMet-cache | FE1.1s |  |  |  |  |  |  | 13 | VD33 | power_in
D |  |  |  |  |  |  |  |  |  |  |  |  |  |  |  |  |  |  |  |  |  |  |  |  | 6xUSB_PowMet-cache | FE1.1s |  |  |  |  |  |  | 14 | REXT | unspc
D |  |  |  |  |  |  |  |  |  |  |  |  |  |  |  |  |  |  |  |  |  |  |  |  | 6xUSB_PowMet-cache | FE1.1s |  |  |  |  |  |  | 15 | DMU | BiDi
D |  |  |  |  |  |  |  |  |  |  |  |  |  |  |  |  |  |  |  |  |  |  |  |  | 6xUSB_PowMet-cache | FE1.1s |  |  |  |  |  |  | 16 | DPU | BiDi
D |  |  |  |  |  |  |  |  |  |  |  |  |  |  |  |  |  |  |  |  |  |  |  |  | 6xUSB_PowMet-cache | FE1.1s |  |  |  |  |  |  | 17 | XRSTJ | input
D |  |  |  |  |  |  |  |  |  |  |  |  |  |  |  |  |  |  |  |  |  |  |  |  | 6xUSB_PowMet-cache | FE1.1s |  |  |  |  |  |  | 18 | VBUSM | input
D |  |  |  |  |  |  |  |  |  |  |  |  |  |  |  |  |  |  |  |  |  |  |  |  | 6xUSB_PowMet-cache | FE1.1s |  |  |  |  |  |  | 19 | BUSJ | input
D |  |  |  |  |  |  |  |  |  |  |  |  |  |  |  |  |  |  |  |  |  |  |  |  | 6xUSB_PowMet-cache | FE1.1s |  |  |  |  |  |  | 20 | VDD5 | power_in
D |  |  |  |  |  |  |  |  |  |  |  |  |  |  |  |  |  |  |  |  |  |  |  |  | 6xUSB_PowMet-cache | FE1.1s |  |  |  |  |  |  | 21 | VD33_O | power_out
D |  |  |  |  |  |  |  |  |  |  |  |  |  |  |  |  |  |  |  |  |  |  |  |  | 6xUSB_PowMet-cache | FE1.1s |  |  |  |  |  |  | 22 | DRV | BiDi
D |  |  |  |  |  |  |  |  |  |  |  |  |  |  |  |  |  |  |  |  |  |  |  |  | 6xUSB_PowMet-cache | FE1.1s |  |  |  |  |  |  | 23 | LED1/EESCL | BiDi
D |  |  |  |  |  |  |  |  |  |  |  |  |  |  |  |  |  |  |  |  |  |  |  |  | 6xUSB_PowMet-cache | FE1.1s |  |  |  |  |  |  | 24 | LED2 | BiDi
D |  |  |  |  |  |  |  |  |  |  |  |  |  |  |  |  |  |  |  |  |  |  |  |  | 6xUSB_PowMet-cache | FE1.1s |  |  |  |  |  |  | 25 | PWRJ | power_out
D |  |  |  |  |  |  |  |  |  |  |  |  |  |  |  |  |  |  |  |  |  |  |  |  | 6xUSB_PowMet-cache | FE1.1s |  |  |  |  |  |  | 26 | OVCJ | input
D |  |  |  |  |  |  |  |  |  |  |  |  |  |  |  |  |  |  |  |  |  |  |  |  | 6xUSB_PowMet-cache | FE1.1s |  |  |  |  |  |  | 27 | TESTJ/EESDA | BiDi
D |  |  |  |  |  |  |  |  |  |  |  |  |  |  |  |  |  |  |  |  |  |  |  |  | 6xUSB_PowMet-cache | FE1.1s |  |  |  |  |  |  | 28 | VD18 | power_in
D |  |  |  |  |  |  |  |  |  |  |  |  |  |  |  |  |  |  |  |  |  |  |  |  | 6xUSB_PowMet-cache | F_Small |  |  |  | CP*
D |  |  |  |  |  |  |  |  |  |  |  |  |  |  |  |  |  |  |  |  |  |  |  |  | 6xUSB_PowMet-cache | F_Small |  |  |  | SM*
D |  |  |  |  |  |  |  |  |  |  |  |  |  |  |  |  |  |  |  |  |  |  |  |  | 6xUSB_PowMet-cache | F_Small |  |  |  |  | F | Reference
D |  |  |  |  |  |  |  |  |  |  |  |  |  |  |  |  |  |  |  |  |  |  |  |  | 6xUSB_PowMet-cache | F_Small |  |  |  |  | F_Small | Value
D |  |  |  |  |  |  |  |  |  |  |  |  |  |  |  |  |  |  |  |  |  |  |  |  | 6xUSB_PowMet-cache | F_Small |  |  |  |  |  |  | 1 | ~ | passive
D |  |  |  |  |  |  |  |  |  |  |  |  |  |  |  |  |  |  |  |  |  |  |  |  | 6xUSB_PowMet-cache | F_Small |  |  |  |  |  |  | 2 | ~ | passive
D |  |  |  |  |  |  |  |  |  |  |  |  |  |  |  |  |  |  |  |  |  |  |  |  | device | Ferrite_Bead |  | Ferrite bead |  | Inductor_*
D |  |  |  |  |  |  |  |  |  |  |  |  |  |  |  |  |  |  |  |  |  |  |  |  | device | Ferrite_Bead |  | Ferrite bead |  | L_*
D |  |  |  |  |  |  |  |  |  |  |  |  |  |  |  |  |  |  |  |  |  |  |  |  | device | Ferrite_Bead |  | Ferrite bead |  | *Ferrite*
D |  |  |  |  |  |  |  |  |  |  |  |  |  |  |  |  |  |  |  |  |  |  |  |  | device | Ferrite_Bead |  | Ferrite bead |  |  | L | Reference
D |  |  |  |  |  |  |  |  |  |  |  |  |  |  |  |  |  |  |  |  |  |  |  |  | device | Ferrite_Bead |  | Ferrite bead |  |  | Ferrite_Bead | Value
D |  |  |  |  |  |  |  |  |  |  |  |  |  |  |  |  |  |  |  |  |  |  |  |  | device | Ferrite_Bead |  | Ferrite bead |  |  |  |  | 1 | ~ | passive
D |  |  |  |  |  |  |  |  |  |  |  |  |  |  |  |  |  |  |  |  |  |  |  |  | device | Ferrite_Bead |  | Ferrite bead |  |  |  |  | 2 | ~ | passive
D |  |  |  |  |  |  |  |  |  |  |  |  |  |  |  |  |  |  |  |  |  |  |  |  | device | Fuse_Small |  | Fuse, small symbol |  | SM*
D |  |  |  |  |  |  |  |  |  |  |  |  |  |  |  |  |  |  |  |  |  |  |  |  | device | Fuse_Small |  | Fuse, small symbol |  |  | F | Reference
D |  |  |  |  |  |  |  |  |  |  |  |  |  |  |  |  |  |  |  |  |  |  |  |  | device | Fuse_Small |  | Fuse, small symbol |  |  | Fuse_Small | Value
D |  |  |  |  |  |  |  |  |  |  |  |  |  |  |  |  |  |  |  |  |  |  |  |  | device | Fuse_Small |  | Fuse, small symbol |  |  |  |  | 1 | ~ | passive
D |  |  |  |  |  |  |  |  |  |  |  |  |  |  |  |  |  |  |  |  |  |  |  |  | device | Fuse_Small |  | Fuse, small symbol |  |  |  |  | 2 | ~ | passive
D |  |  |  |  |  |  |  |  |  |  |  |  |  |  |  |  |  |  |  |  |  |  |  |  | 6xUSB_PowMet-cache | INDUCTOR_SMALL |  |  |  | Choke_*
D |  |  |  |  |  |  |  |  |  |  |  |  |  |  |  |  |  |  |  |  |  |  |  |  | 6xUSB_PowMet-cache | INDUCTOR_SMALL |  |  |  | *Coil*
D |  |  |  |  |  |  |  |  |  |  |  |  |  |  |  |  |  |  |  |  |  |  |  |  | 6xUSB_PowMet-cache | INDUCTOR_SMALL |  |  |  |  | L | Reference
D |  |  |  |  |  |  |  |  |  |  |  |  |  |  |  |  |  |  |  |  |  |  |  |  | 6xUSB_PowMet-cache | INDUCTOR_SMALL |  |  |  |  | INDUCTOR_SMALL | Value
D |  |  |  |  |  |  |  |  |  |  |  |  |  |  |  |  |  |  |  |  |  |  |  |  | 6xUSB_PowMet-cache | INDUCTOR_SMALL |  |  |  |  |  |  | 1 | 1 | input
D |  |  |  |  |  |  |  |  |  |  |  |  |  |  |  |  |  |  |  |  |  |  |  |  | 6xUSB_PowMet-cache | INDUCTOR_SMALL |  |  |  |  |  |  | 2 | 2 | input
D |  |  |  |  |  |  |  |  |  |  |  |  |  |  |  |  |  |  |  |  |  |  |  |  | transistors | IRF7607PBF |  | HexFET N-MOS Power Mosfet, Vds 20V, Rdson 0.03R, Id 5.2A, Micro8 | http://www.irf.com/product-info/datasheets/data/irf7607pbf.pdf | MSOP*3x3mm?Pitch0.65mm*
D |  |  |  |  |  |  |  |  |  |  |  |  |  |  |  |  |  |  |  |  |  |  |  |  | transistors | IRF7607PBF |  | HexFET N-MOS Power Mosfet, Vds 20V, Rdson 0.03R, Id 5.2A, Micro8 | http://www.irf.com/product-info/datasheets/data/irf7607pbf.pdf |  | Q | Reference
D |  |  |  |  |  |  |  |  |  |  |  |  |  |  |  |  |  |  |  |  |  |  |  |  | transistors | IRF7607PBF |  | HexFET N-MOS Power Mosfet, Vds 20V, Rdson 0.03R, Id 5.2A, Micro8 | http://www.irf.com/product-info/datasheets/data/irf7607pbf.pdf |  | IRF7607PBF | Value
D |  |  |  |  |  |  |  |  |  |  |  |  |  |  |  |  |  |  |  |  |  |  |  |  | transistors | IRF7607PBF |  | HexFET N-MOS Power Mosfet, Vds 20V, Rdson 0.03R, Id 5.2A, Micro8 | http://www.irf.com/product-info/datasheets/data/irf7607pbf.pdf |  | Housings_SSOP:MSOP-8_3x3mm_Pitch0.65mm | Footprint
D |  |  |  |  |  |  |  |  |  |  |  |  |  |  |  |  |  |  |  |  |  |  |  |  | transistors | IRF7607PBF |  | HexFET N-MOS Power Mosfet, Vds 20V, Rdson 0.03R, Id 5.2A, Micro8 | http://www.irf.com/product-info/datasheets/data/irf7607pbf.pdf |  |  |  | 1 | S | passive
D |  |  |  |  |  |  |  |  |  |  |  |  |  |  |  |  |  |  |  |  |  |  |  |  | transistors | IRF7607PBF |  | HexFET N-MOS Power Mosfet, Vds 20V, Rdson 0.03R, Id 5.2A, Micro8 | http://www.irf.com/product-info/datasheets/data/irf7607pbf.pdf |  |  |  | 2 | S | passive
D |  |  |  |  |  |  |  |  |  |  |  |  |  |  |  |  |  |  |  |  |  |  |  |  | transistors | IRF7607PBF |  | HexFET N-MOS Power Mosfet, Vds 20V, Rdson 0.03R, Id 5.2A, Micro8 | http://www.irf.com/product-info/datasheets/data/irf7607pbf.pdf |  |  |  | 3 | S | passive
D |  |  |  |  |  |  |  |  |  |  |  |  |  |  |  |  |  |  |  |  |  |  |  |  | transistors | IRF7607PBF |  | HexFET N-MOS Power Mosfet, Vds 20V, Rdson 0.03R, Id 5.2A, Micro8 | http://www.irf.com/product-info/datasheets/data/irf7607pbf.pdf |  |  |  | 4 | G | passive
D |  |  |  |  |  |  |  |  |  |  |  |  |  |  |  |  |  |  |  |  |  |  |  |  | transistors | IRF7607PBF |  | HexFET N-MOS Power Mosfet, Vds 20V, Rdson 0.03R, Id 5.2A, Micro8 | http://www.irf.com/product-info/datasheets/data/irf7607pbf.pdf |  |  |  | 5 | D | passive
D |  |  |  |  |  |  |  |  |  |  |  |  |  |  |  |  |  |  |  |  |  |  |  |  | transistors | IRF7607PBF |  | HexFET N-MOS Power Mosfet, Vds 20V, Rdson 0.03R, Id 5.2A, Micro8 | http://www.irf.com/product-info/datasheets/data/irf7607pbf.pdf |  |  |  | 6 | D | passive
D |  |  |  |  |  |  |  |  |  |  |  |  |  |  |  |  |  |  |  |  |  |  |  |  | transistors | IRF7607PBF |  | HexFET N-MOS Power Mosfet, Vds 20V, Rdson 0.03R, Id 5.2A, Micro8 | http://www.irf.com/product-info/datasheets/data/irf7607pbf.pdf |  |  |  | 7 | D | passive
D |  |  |  |  |  |  |  |  |  |  |  |  |  |  |  |  |  |  |  |  |  |  |  |  | transistors | IRF7607PBF |  | HexFET N-MOS Power Mosfet, Vds 20V, Rdson 0.03R, Id 5.2A, Micro8 | http://www.irf.com/product-info/datasheets/data/irf7607pbf.pdf |  |  |  | 8 | D | passive
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
