aleksejm/6xUSB-Power-Meter/Hardware/Step_Up_DC-DC_BOM.jpg

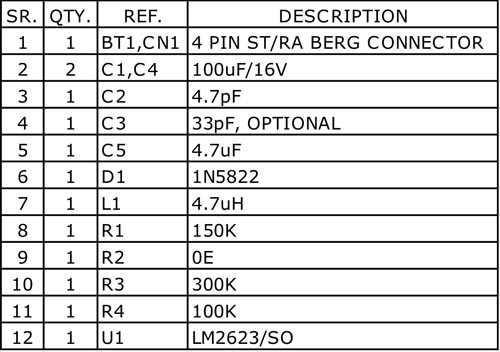
Hardware/Step_Up_DC-DC_BOM.jpg
