aleksejm/6xUSB-Power-Meter/3D_case/Case1.SLDASM

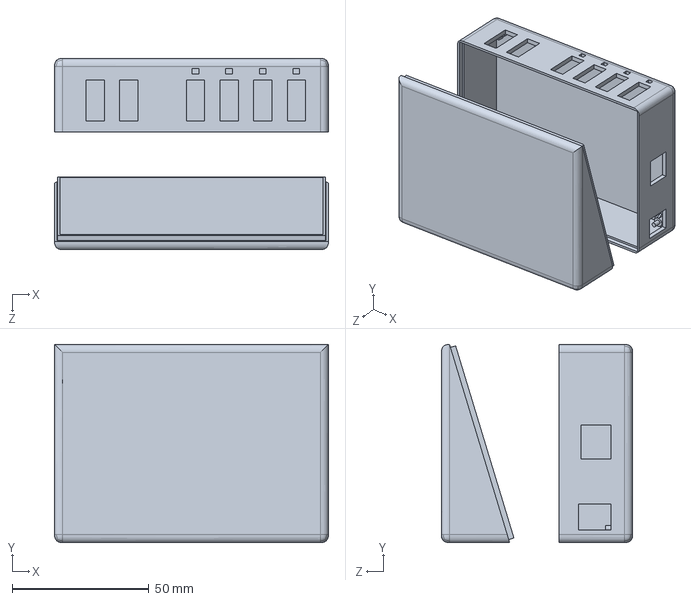
[picture p29: CAD file, 2019-04-29]
3D_case/Case1.SLDASM
100.2 x 72.5 x 70.0 mm
