aleksejm/6xUSB-Power-Meter/Hardware/PCB/6xUSB_PowMet.dxf

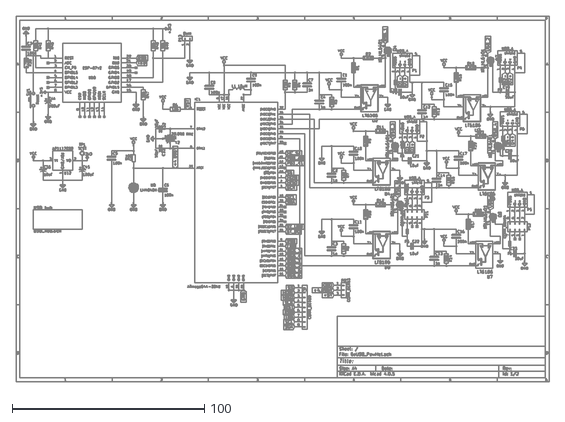
[picture p30: CAD file, 2019-04-29]
Hardware/PCB/6xUSB_PowMet.dxf
277.0 x 190.0
