aleksejm/6xUSB-Power-Meter/Hardware/PCB/6xUSB_PowMet_new/3s part/AB2_son.stl

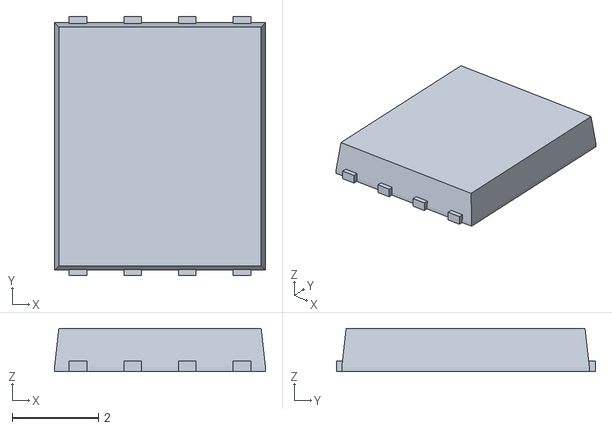
[picture p31: CAD file, 2019-04-29]
Hardware/PCB/6xUSB_PowMet_new/3s part/AB2_son.stl
4.90 x 6.02 x 1.00
