aleksejm/6xUSB-Power-Meter/Hardware/PCB/USB_hub-USB hub.dxf

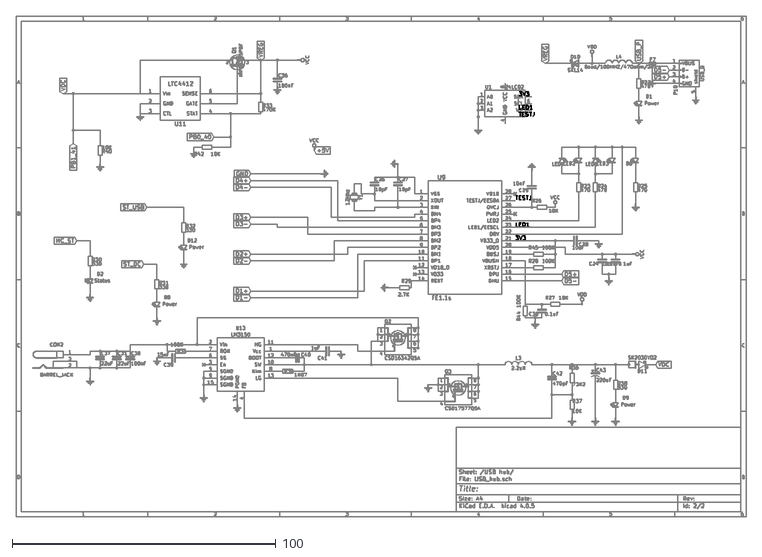
[picture p32: CAD file, 2019-04-29]
Hardware/PCB/USB_hub-USB hub.dxf
277.0 x 190.0
