aleksejm/6xUSB-Power-Meter/(list of files, cad)

Other CAD files:
ER-TFTM024-3(4-Wire-SPI)_TP_SD_FONT_FLASH/sd.OBJ
Hardware/PCB/6xUSB_PowMet_new/AB2_son.FCStd
3D_case/Case.SLDPRT
Hardware/PCB/6xUSB_PowMet_new/3s part/AB2_son.scad
