aleksejm/6xUSB-Power-Meter/Hardware/FE1_1s_B_V1_3/FE1_1s_B_V1_3/FE1_1s_B_LEDsetup.JPG

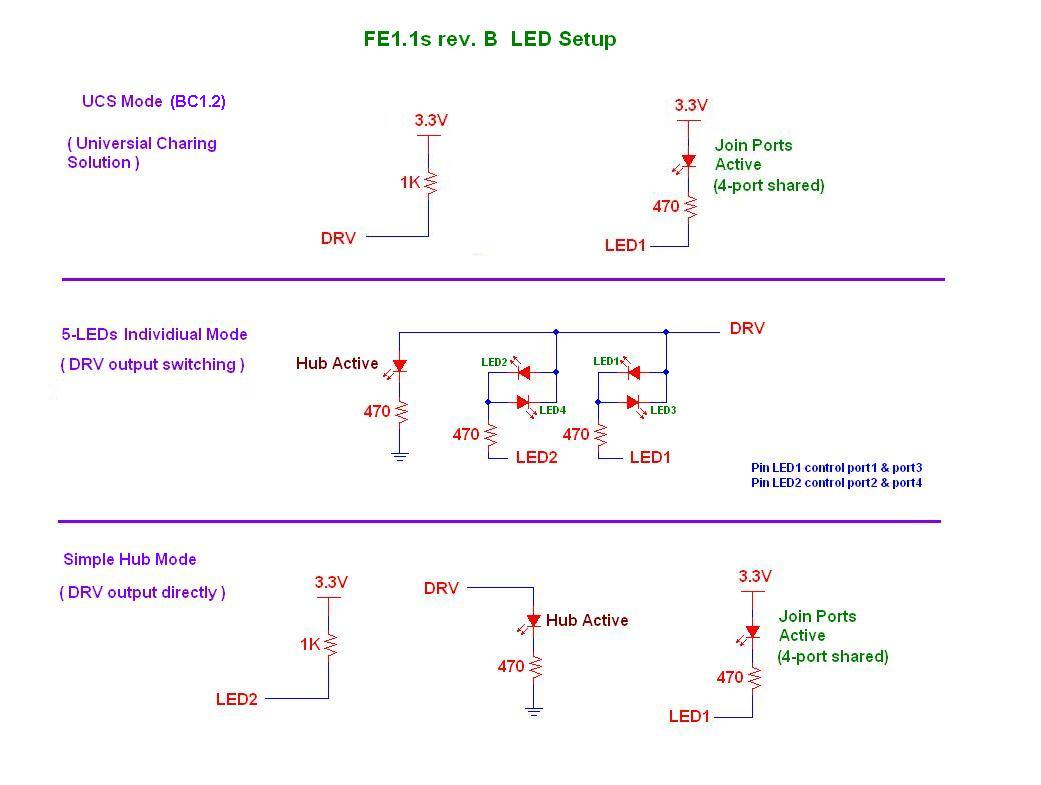
Hardware/FE1_1s_B_V1_3/FE1_1s_B_V1_3/FE1_1s_B_LEDsetup.JPG
