aleksejm/6xUSB-Power-Meter/Hardware/Step_Up_DC-DC_Schemetic-1024x525.jpg

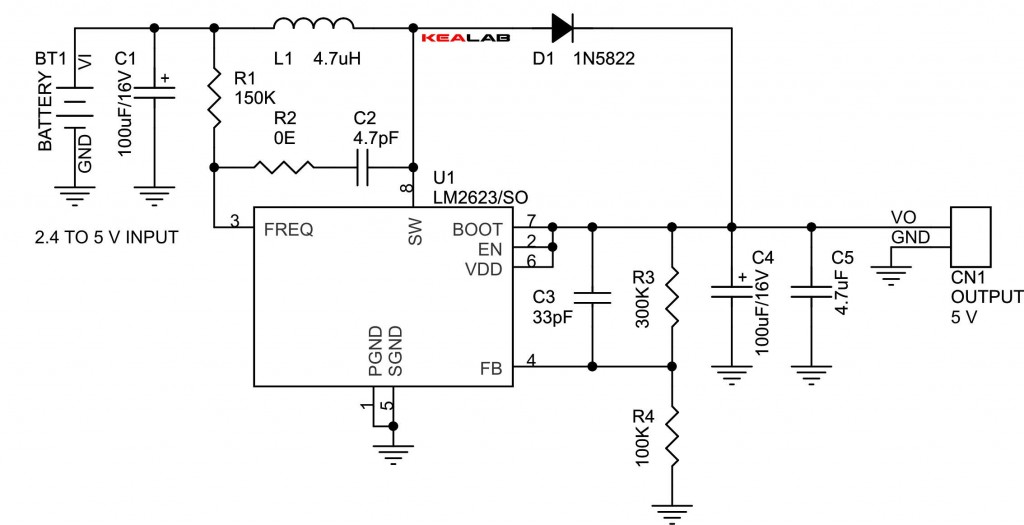
Hardware/Step_Up_DC-DC_Schemetic-1024x525.jpg
