aleksejm/6xUSB-Power-Meter/Hardware/LCD/ER-AS-ILI9341-Arduino-Schematic-Diagram.pdf

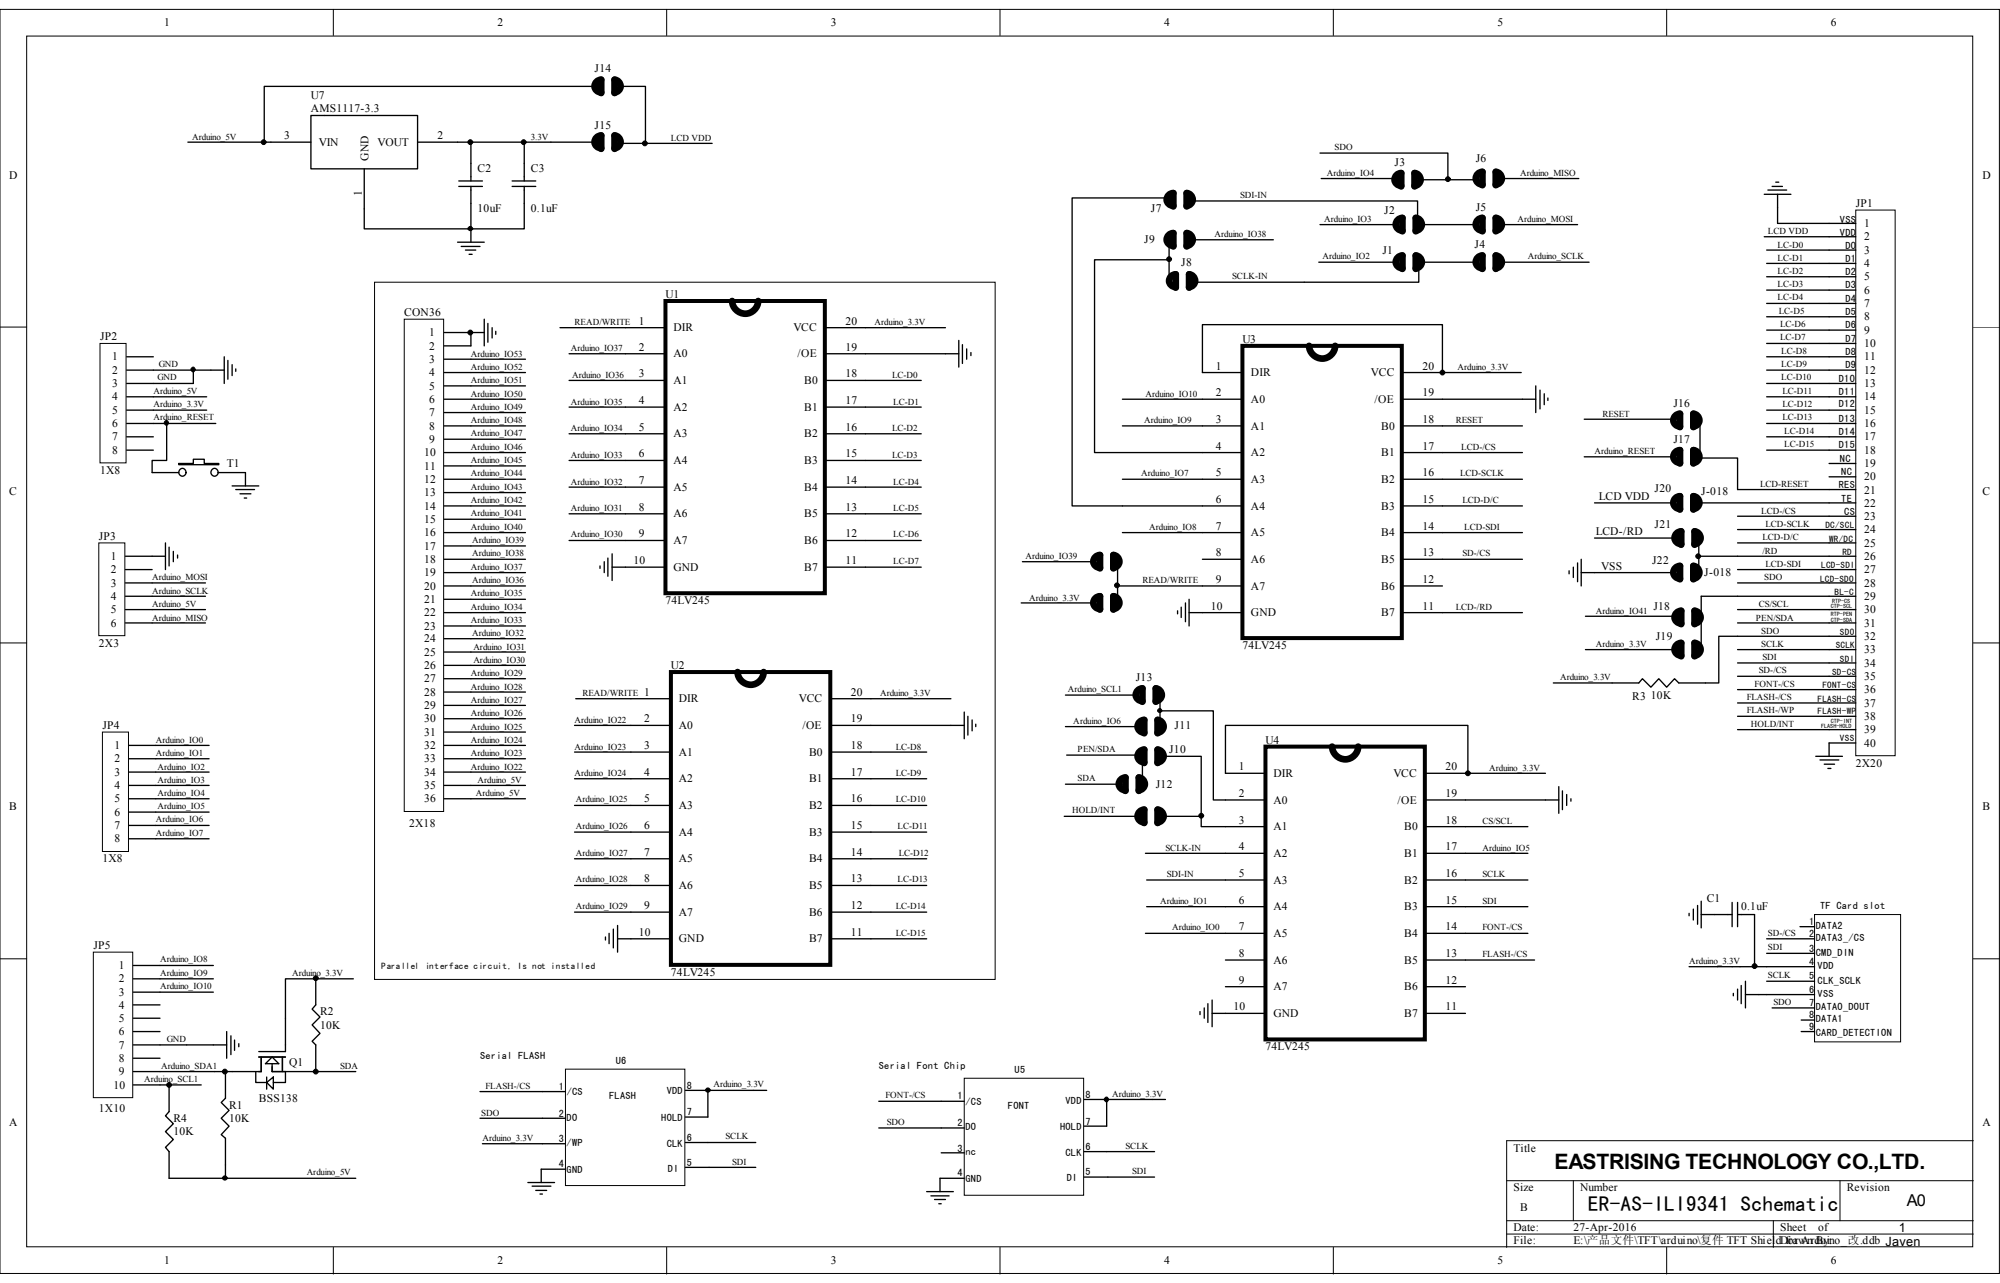
[picture p35: page 1]

Parallel interface circuit, Is not installed

Title
EASTRISING TECHNOLOGY CO.,LTD.
ER-AS-ILI9341 Schematic
