aleksejm/6xUSB-Power-Meter/Hardware/LCD/ER-TFT022-1_Interfacing.pdf

# DB0 DB1 DB2 DB3 DB4 DB5 DB6 DB7

# P0.0 P0.1 P0.2 P0.3 P0.4 P0.5 P0.6 P0.7

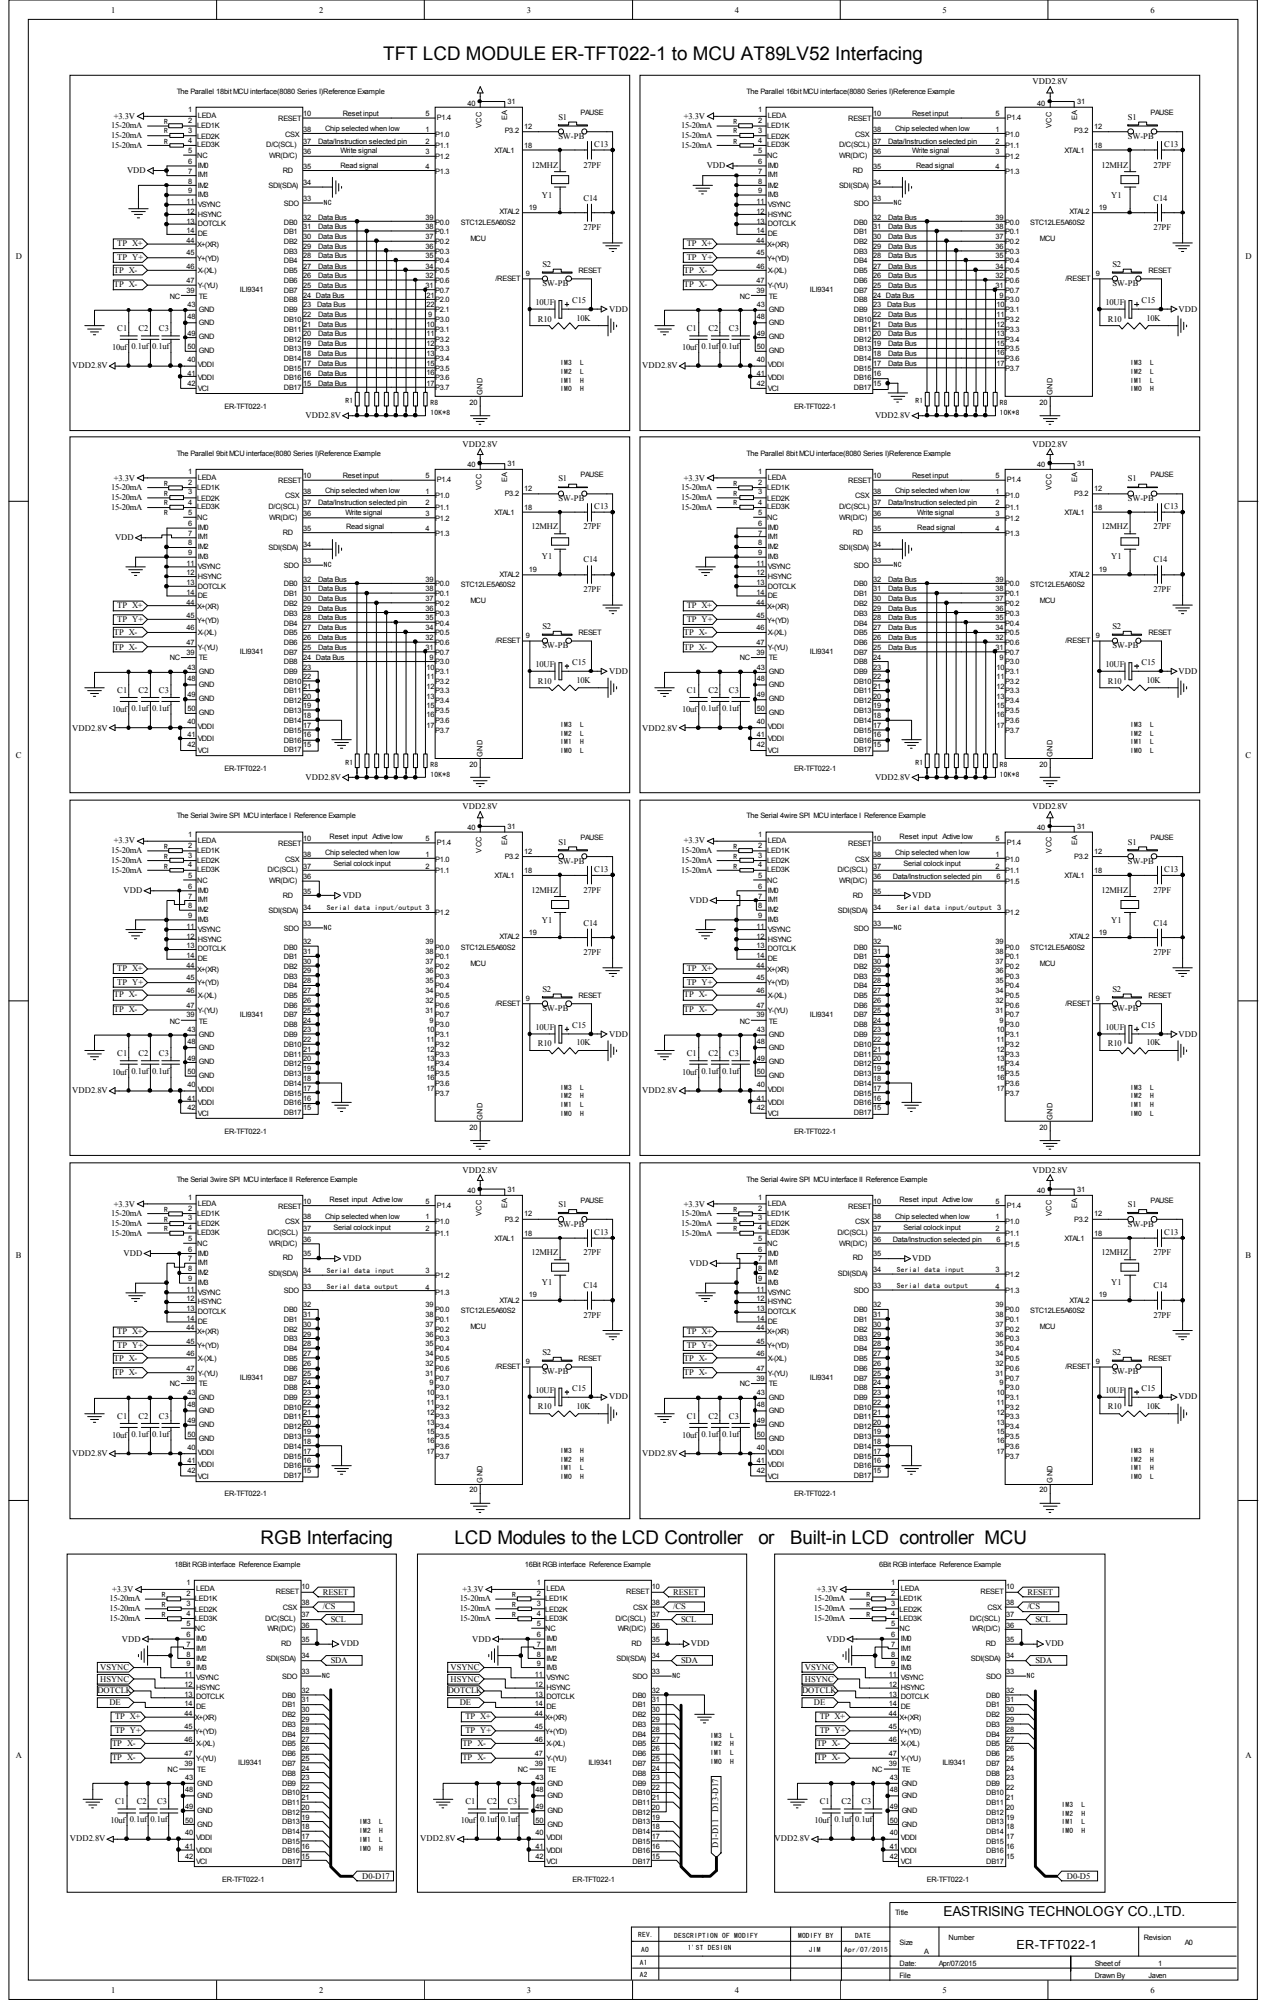
[picture p36: page 1]

TFT LCD MODULE ER-TFT022-1 to MCU AT89LV52 Interfacing

The Parallel 18bit MCU interface(8080 Series I)Reference Example

The Parallel 16bit MCU interface(8080 Series I)Reference Example

Data/Instruction selected pin Chip selected when low

Data Bus Data Bus Data Bus Data Bus Data Bus Data Bus Data Bus

The Parallel 9bit MCU interface(8080 Series I)Reference Example

The Parallel 8bit MCU interface(8080 Series I)Reference Example

The Serial 3wire SPI MCU interface I Reference Example

The Serial 4wire SPI MCU interface I Reference Example

Reset input Active low

Chip selected when low
Serial colock input

VDD
Serial data input/output 3

The Serial 3wire SPI MCU interface II Reference Example

The Serial 4wire SPI MCU interface II Reference Example

18Bit RGB interface Reference Example

16Bit RGB interface Reference Example

6Bit RGB interface Reference Example

EASTRISING TECHNOLOGY CO.,LTD.
