aleksejm/6xUSB-Power-Meter/Hardware/LCD/ER-TFTM024-3_Interfacing1.pdf

D

1 | 2 | 3 | 4 | 5 | 6

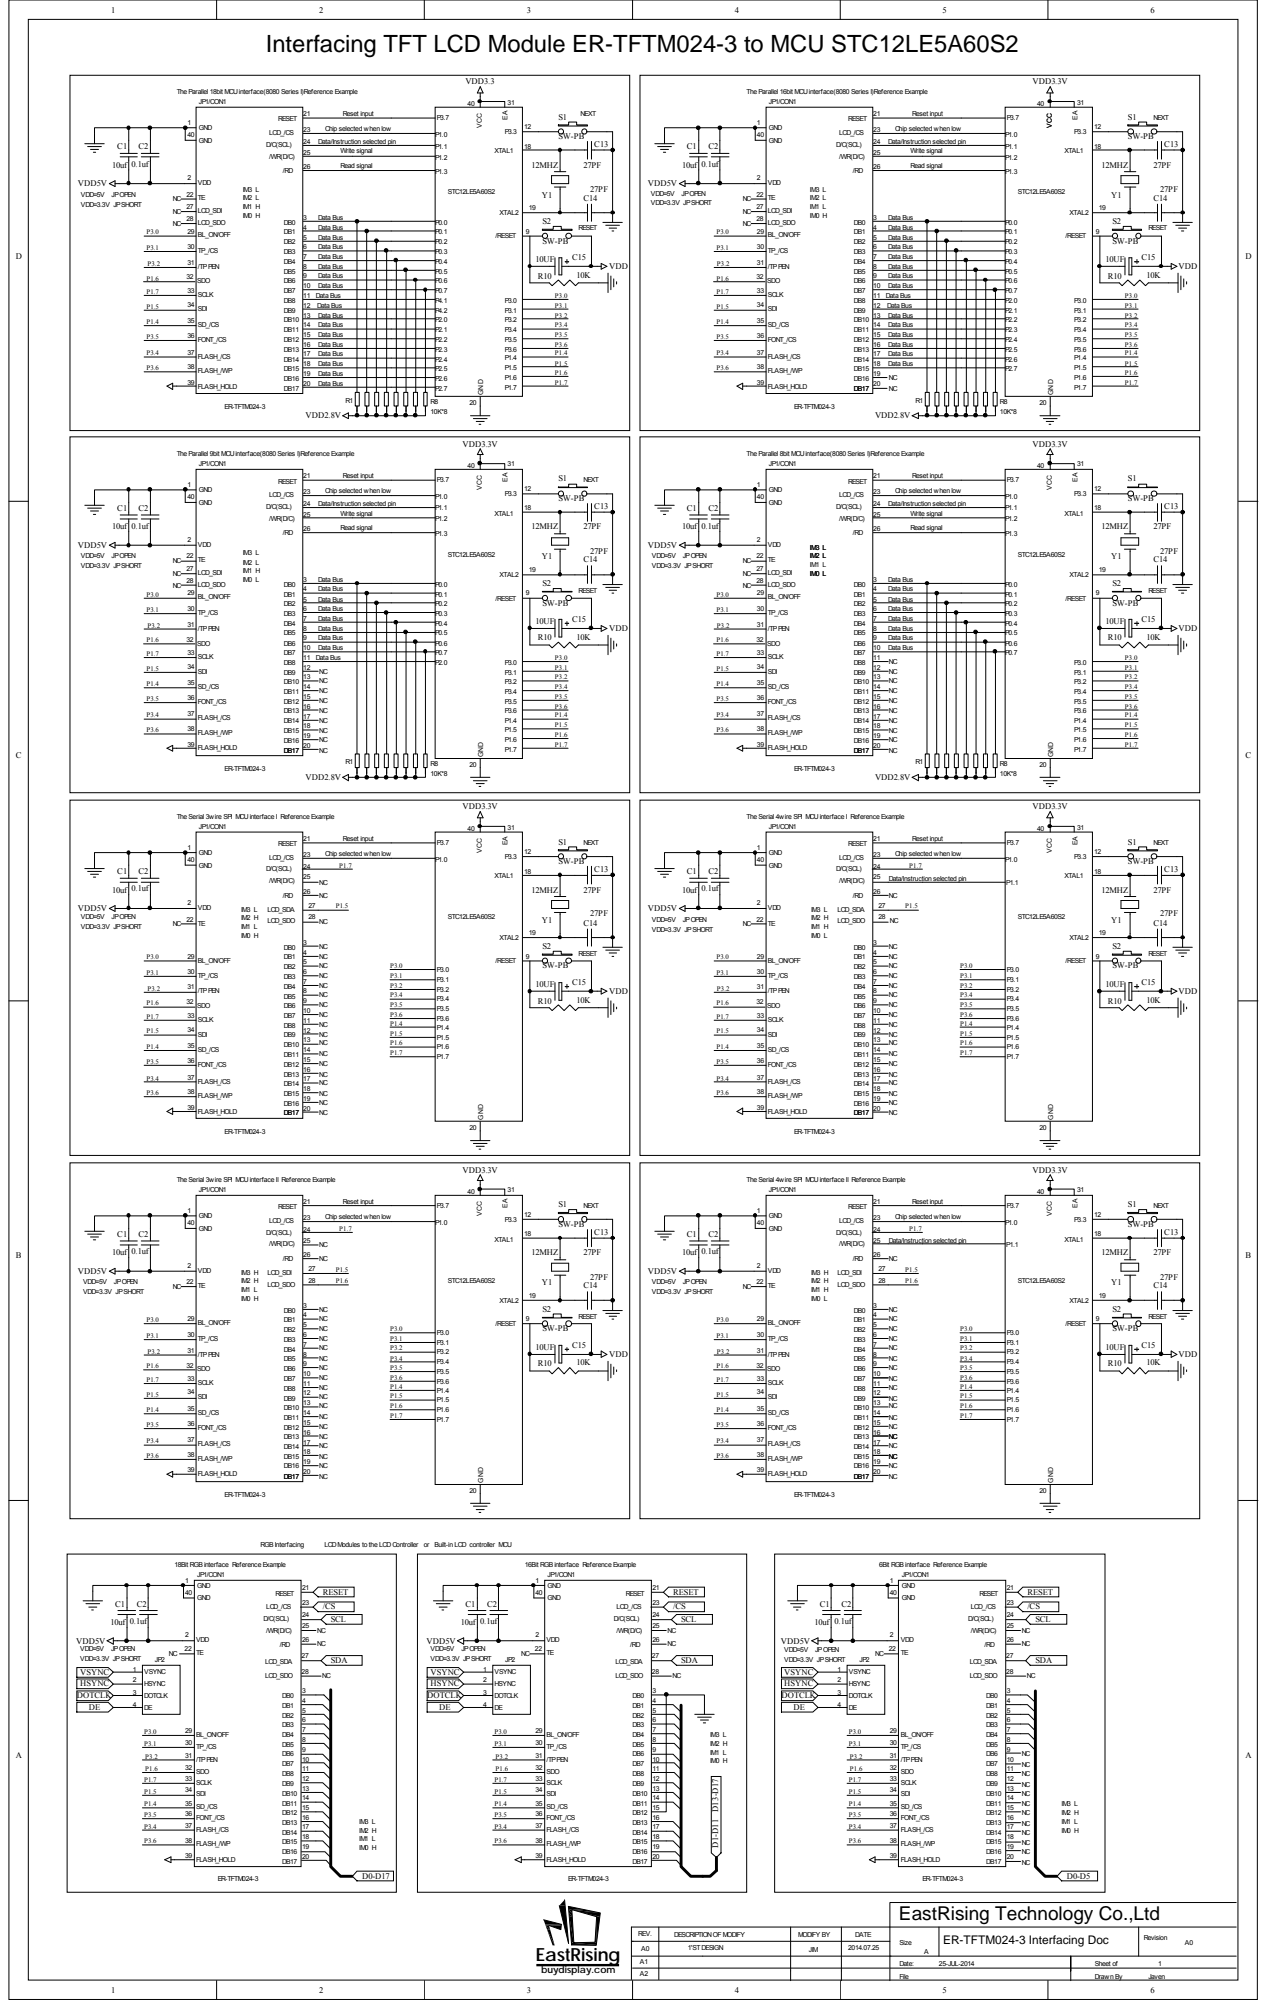
[picture p37: page 1]

Interfacing TFT LCD Module ER-TFTM024-3 to MCU STC12LE5A60S2

The Parallel 18bit MCU interface(8080 Series I)Reference Example

The Parallel 16bit MCU interface(8080 Series I)Reference Example

Data/Instruction selected pin Chip selected when low

P4.2 Data Bus Data Bus
Data Bus Data Bus Data Bus Data Bus

Data Bus
Data Bus Data Bus Data Bus

The Parallel 9bit MCU interface(8080 Series I)Reference Example

The Serial 4wire SPI MCU interface I Reference Example

Chip selected when low

18Bit RGB interface Reference Example

16Bit RGB interface Reference Example

6Bit RGB interface Reference Example

ER-TFTM024-3
EastRising Technology Co.,Ltd
