aleksejm/6xUSB-Power-Meter/Hardware/PCB/6xUSB_PowMet_new/6xUSB_PowMet.pdf

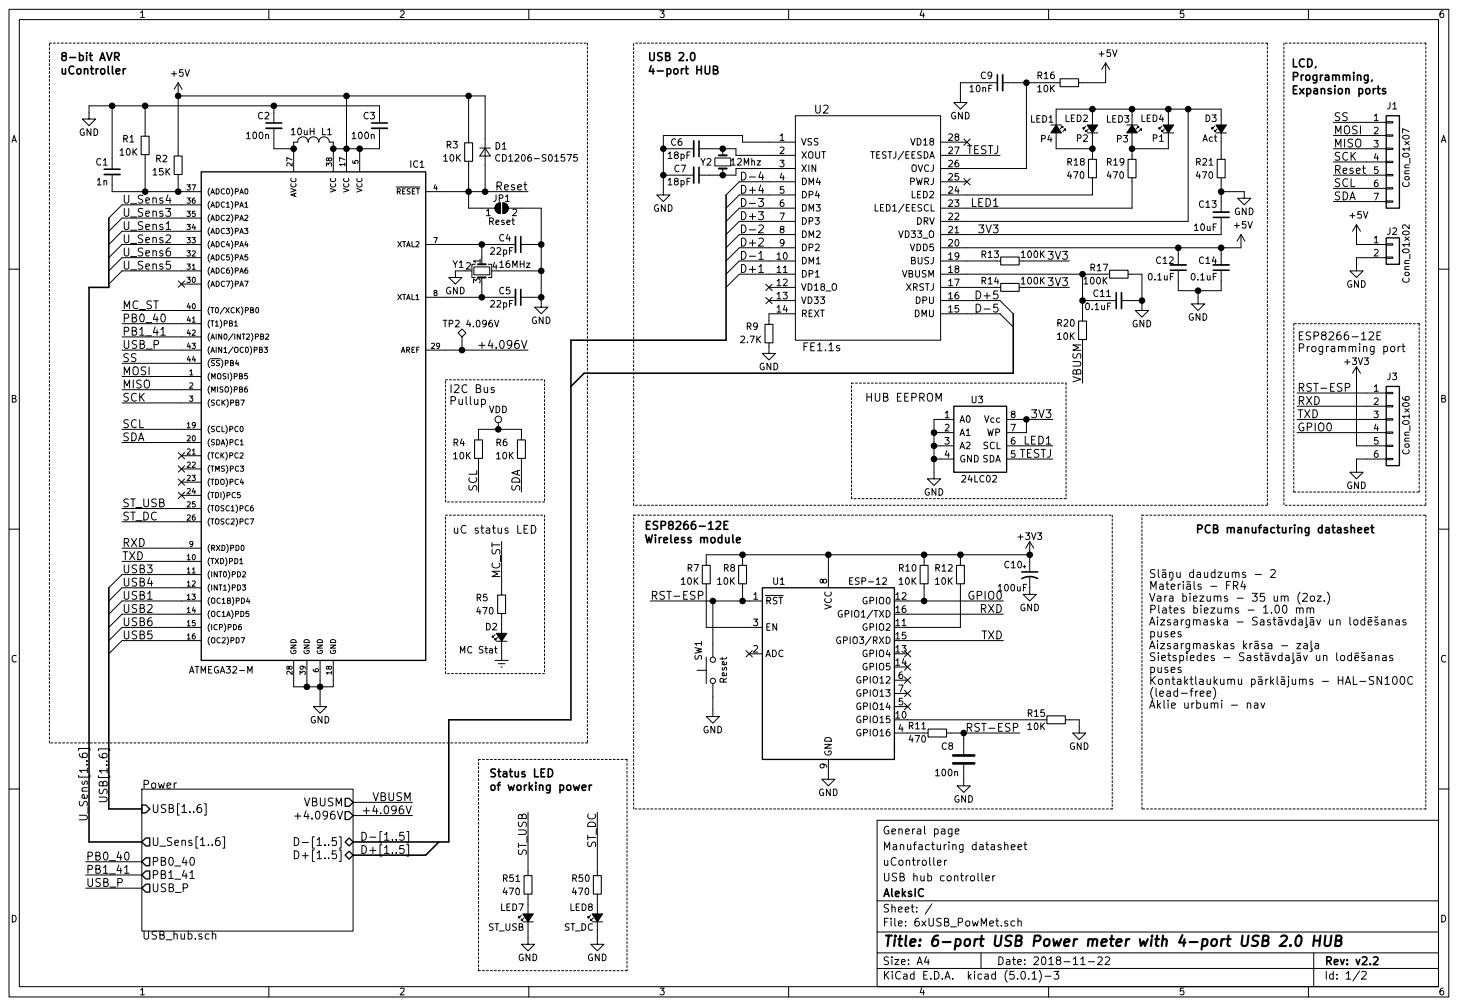
[picture p39: page 1]

Aizsargmaska - Sastvdav un lodanas puses Aizsargmaskas krsa - zaa

Sietspiedes - Sastvdav un lodanas puses Kontaktlaukumu prkljums - HAL-SN100C

(lead-free) Aklie urbumi - nav

of working power | 100nGND GND

USB hub controller uController Manufacturing datasheet

File: 6xUSB_PowMet.sch Sheet: / AleksIC

Id: 1/2 Title: 6-port USB Power meter with 4-port USB 2.0 HUB

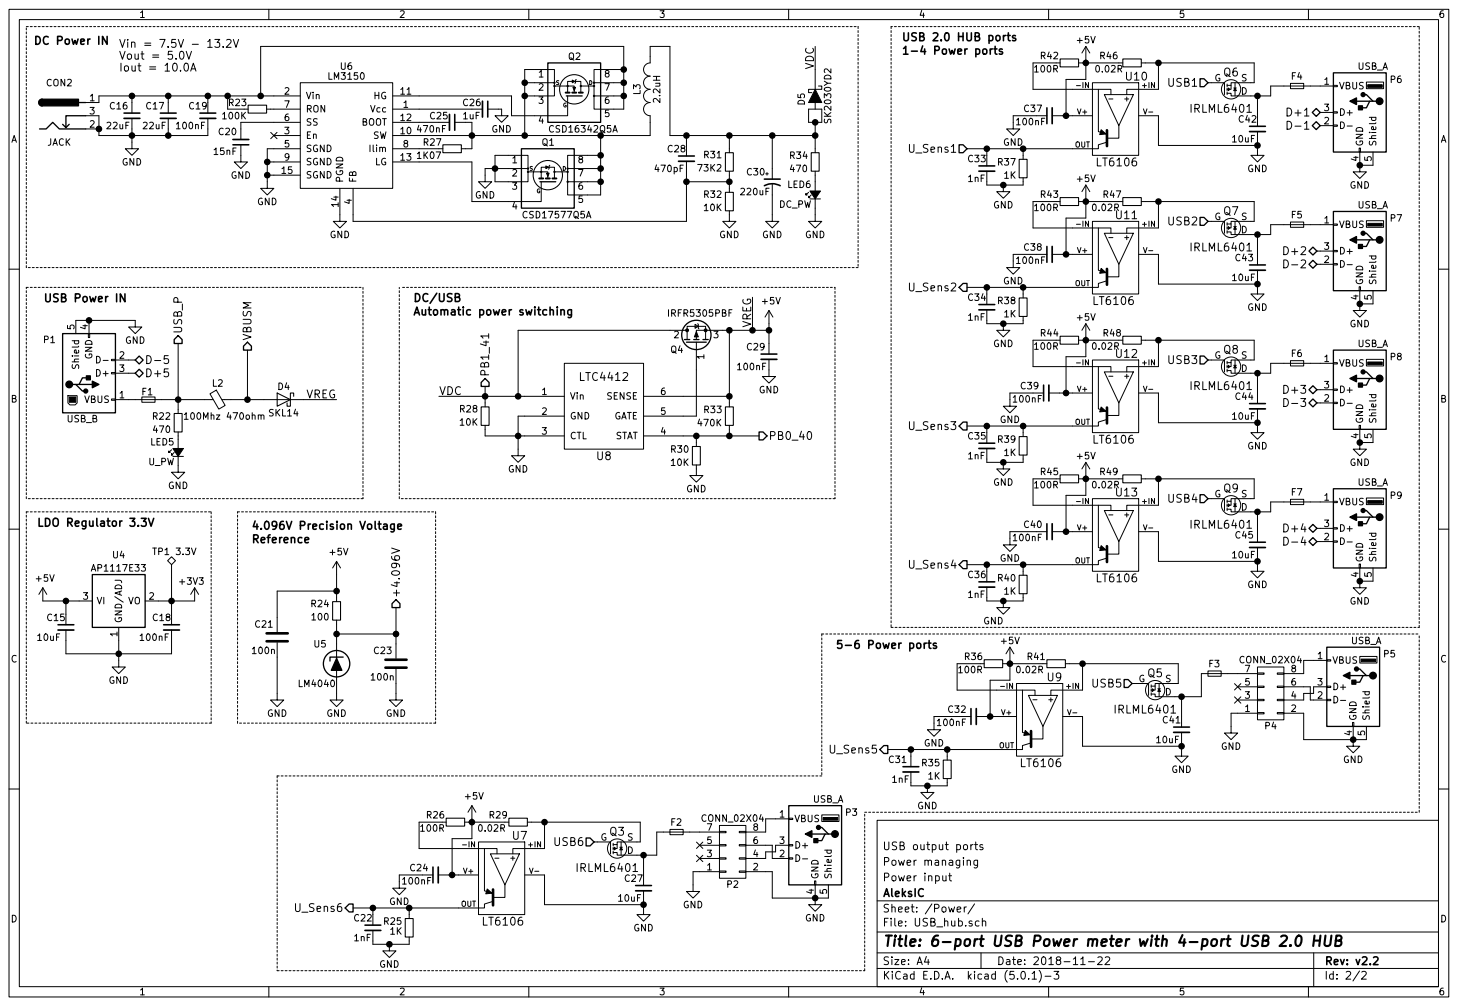
[picture p40: page 2]

Iout = 10.0A DC Power IN

USB output ports
Power managing
Power input
File: USB_hub.sch Sheet: /Power/ AleksIC

Id: 2/2 Title: 6-port USB Power meter with 4-port USB 2.0 HUB
