aleksejm/6xUSB-Power-Meter/Schematic.pdf

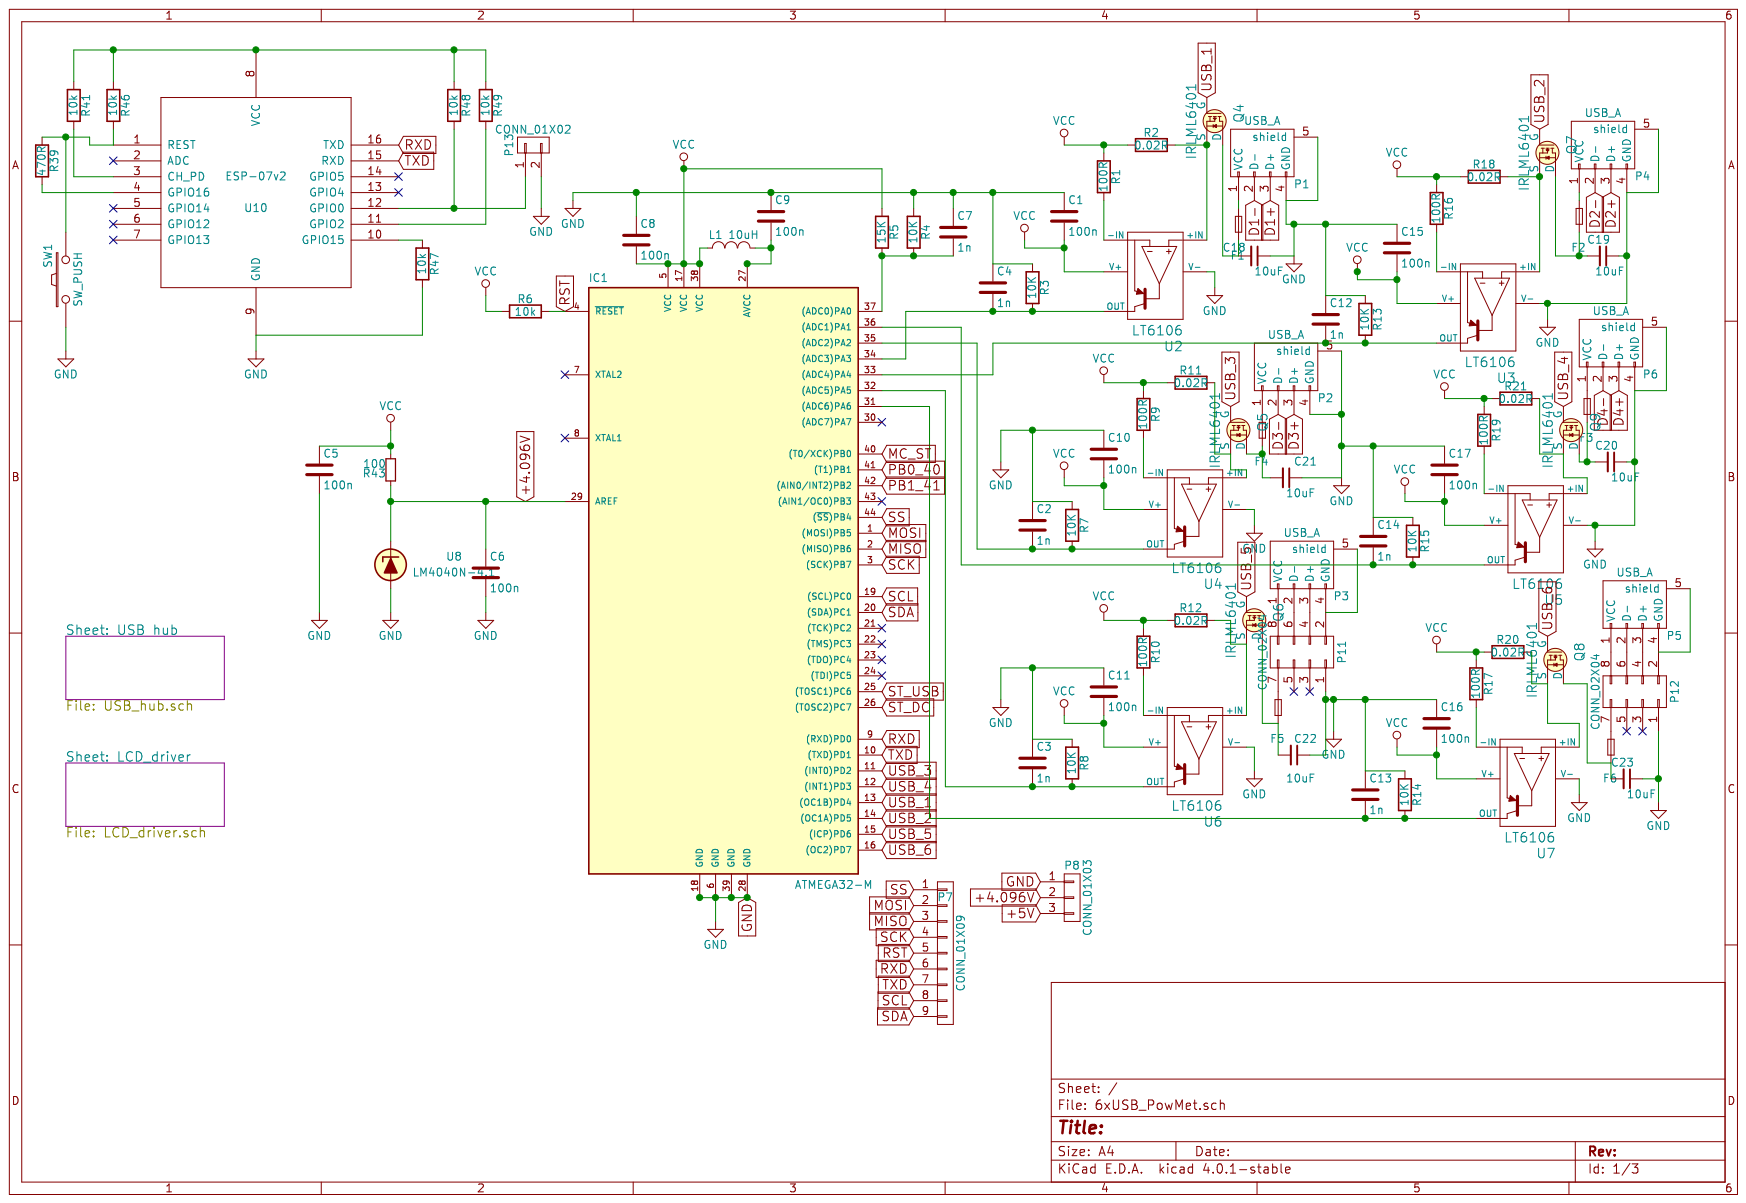
[picture p41: page 1]

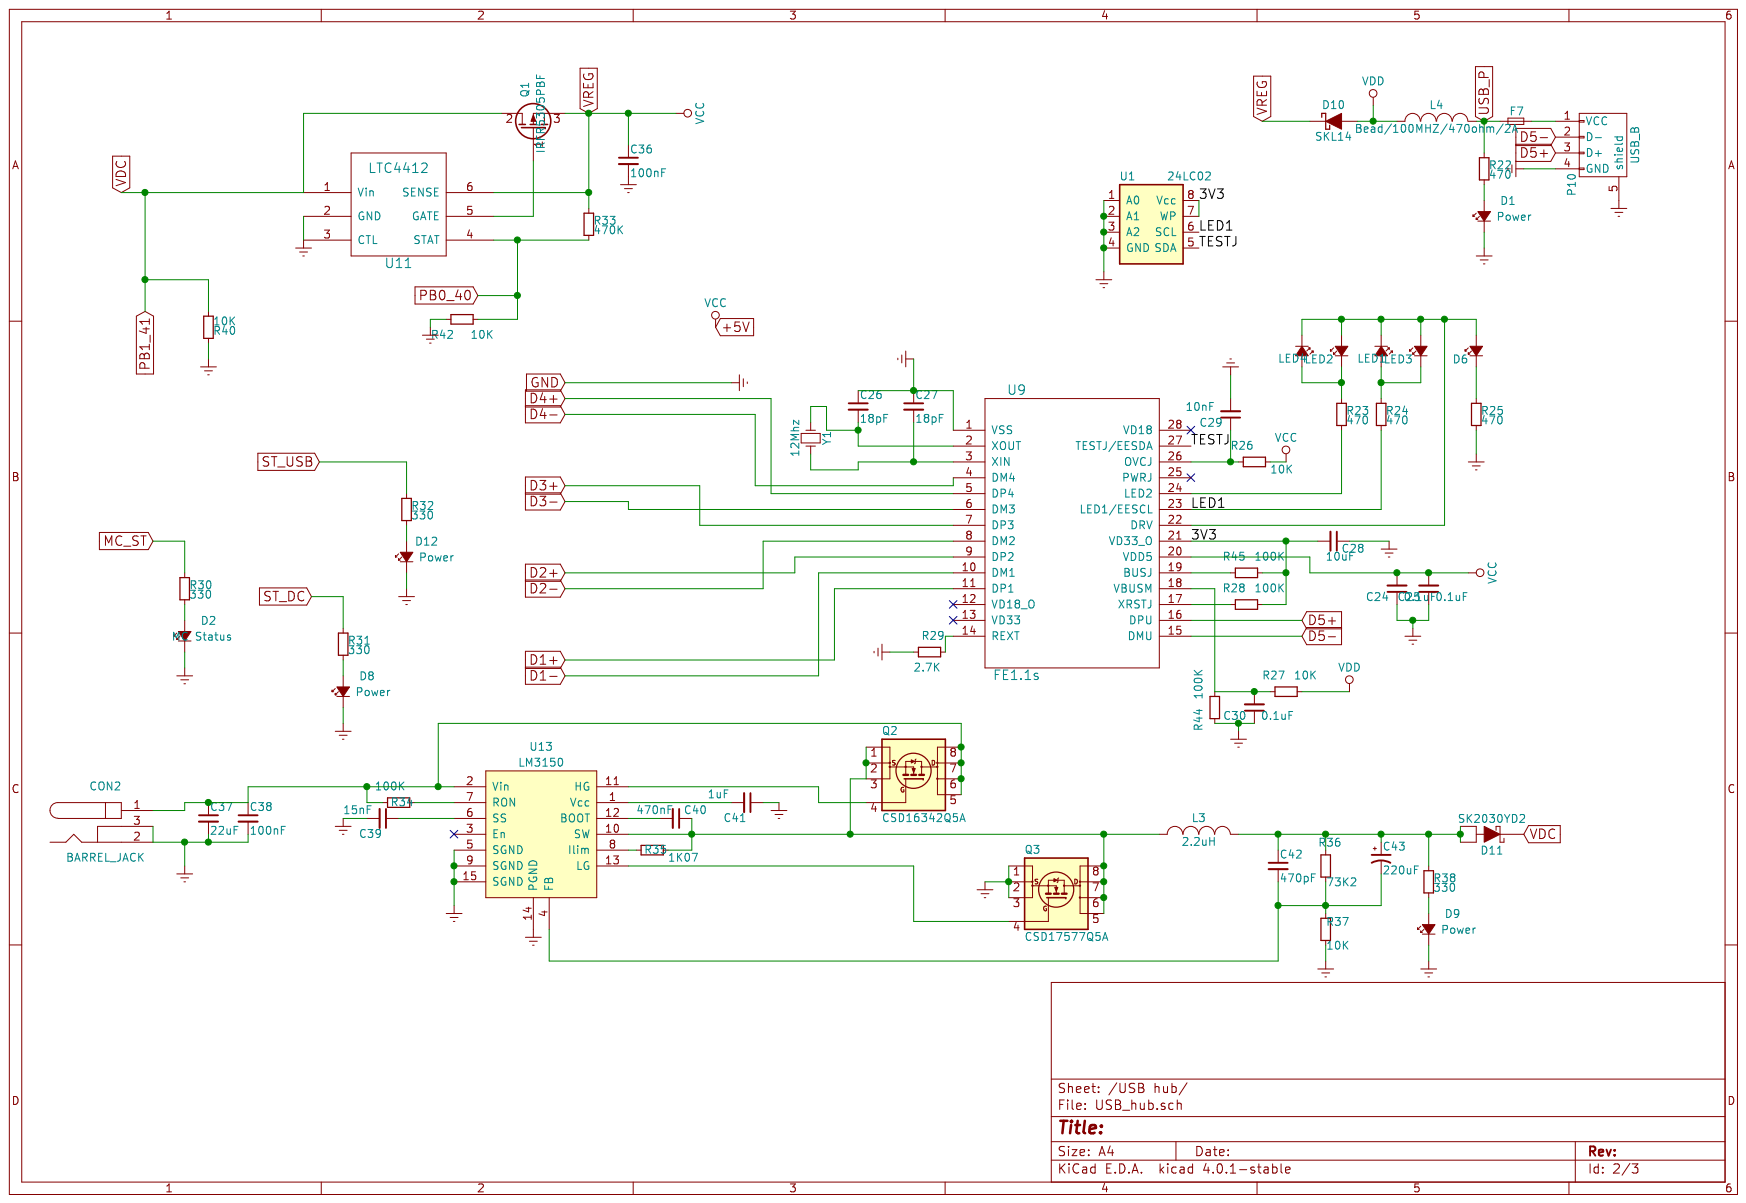
[picture p42: page 2]

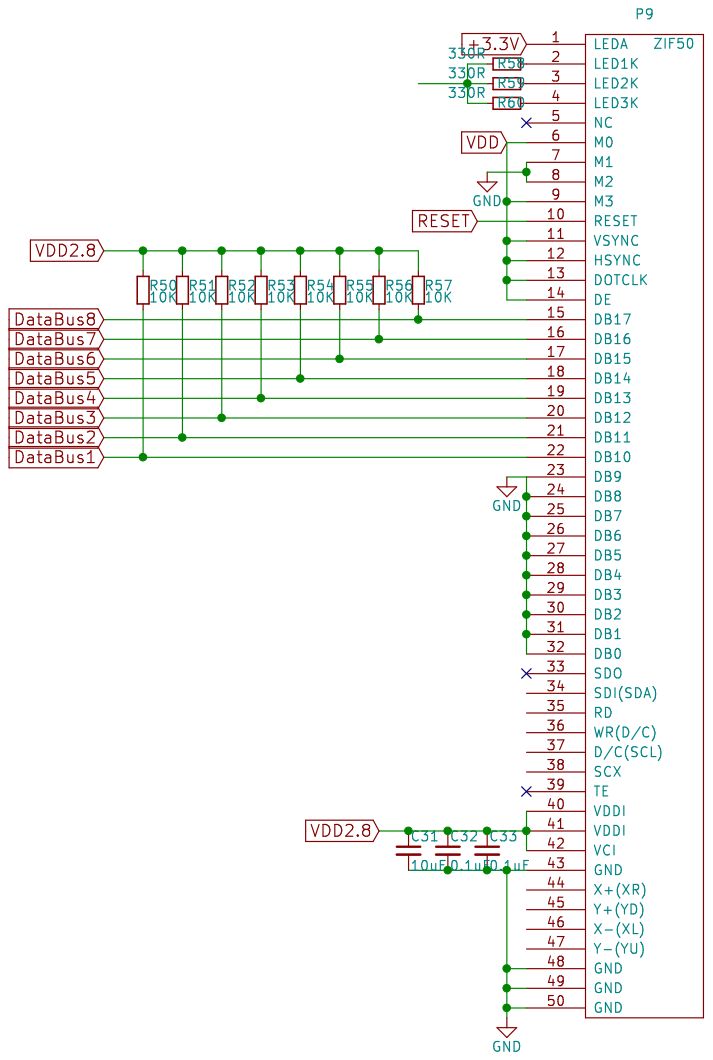
[picture p43: page 3]
