aleksejm/6xUSB-Power-Meter/Hardware/mx67329.pdf

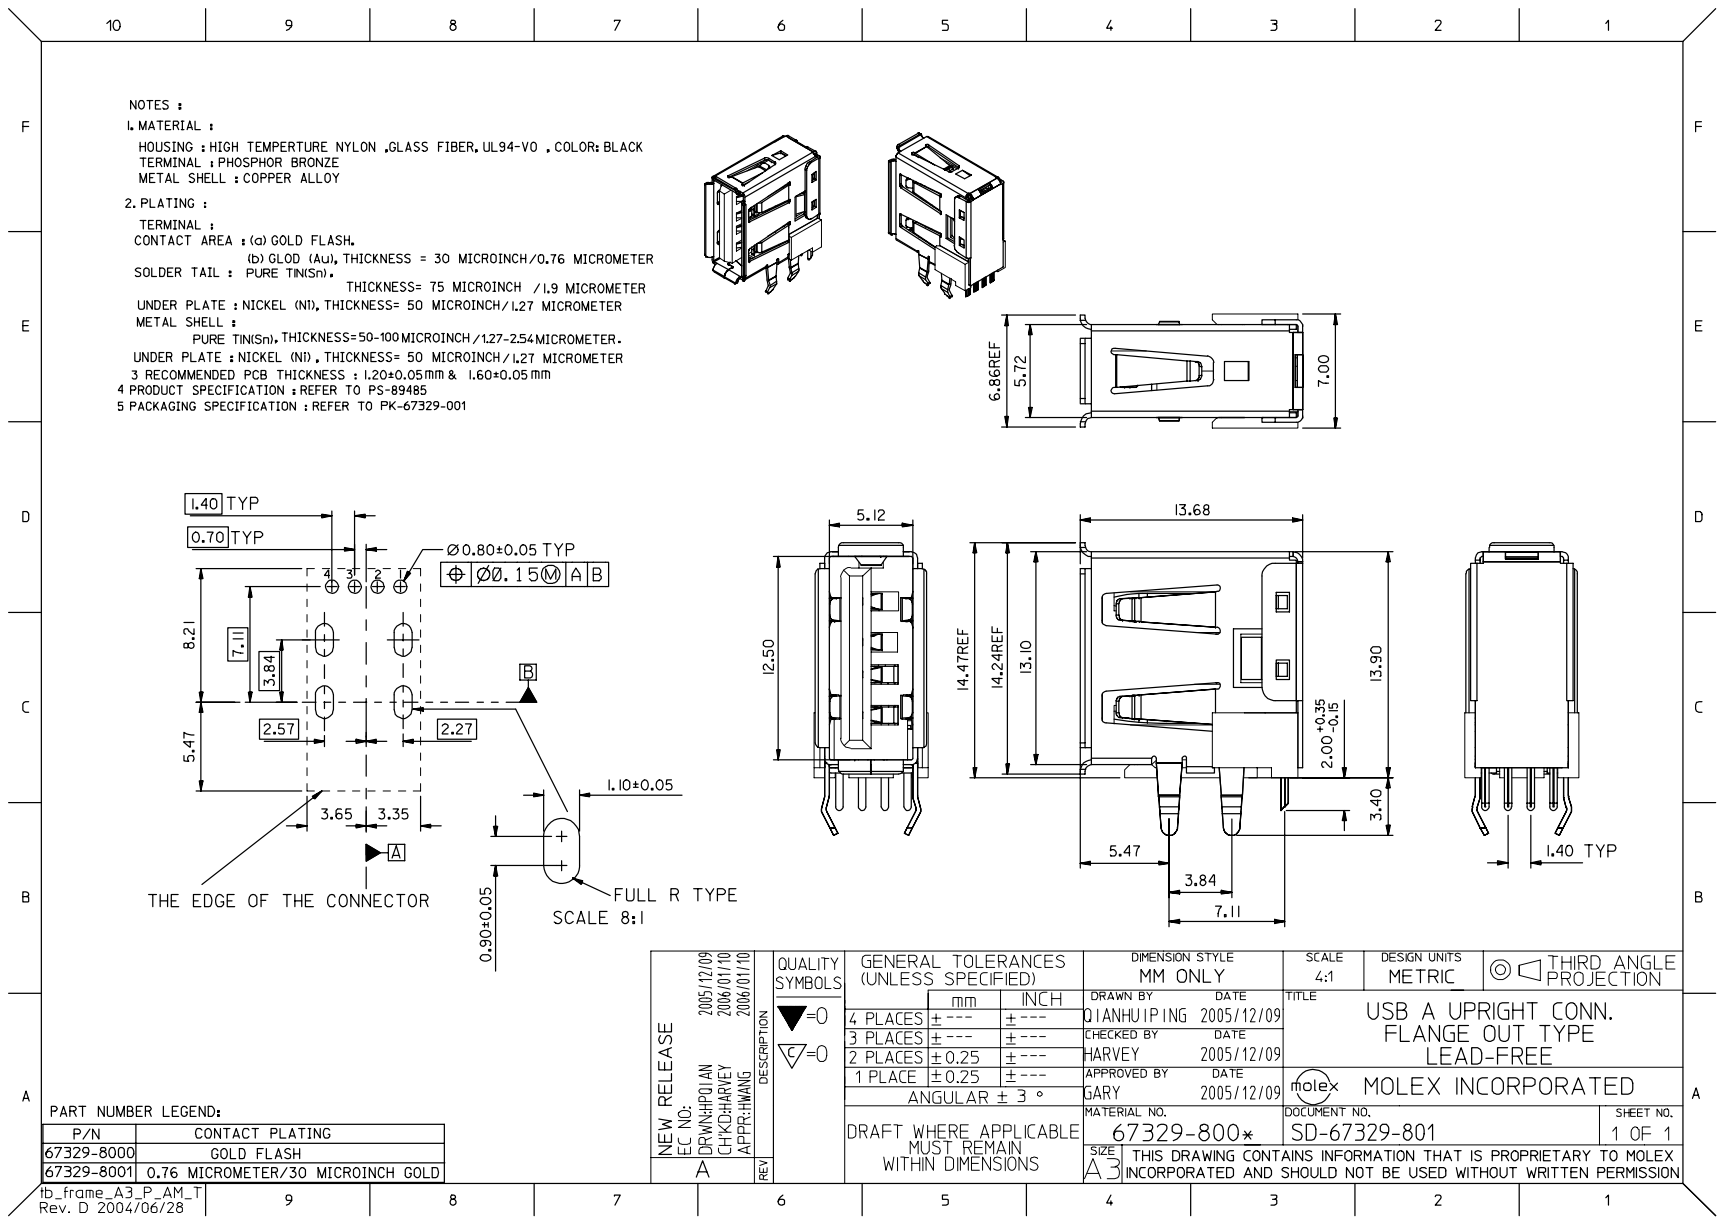
[picture p44: page 1]
