aleksejm/6xUSB-Power-Meter/Hardware/PCB/6xUSB_PowMet.pdf

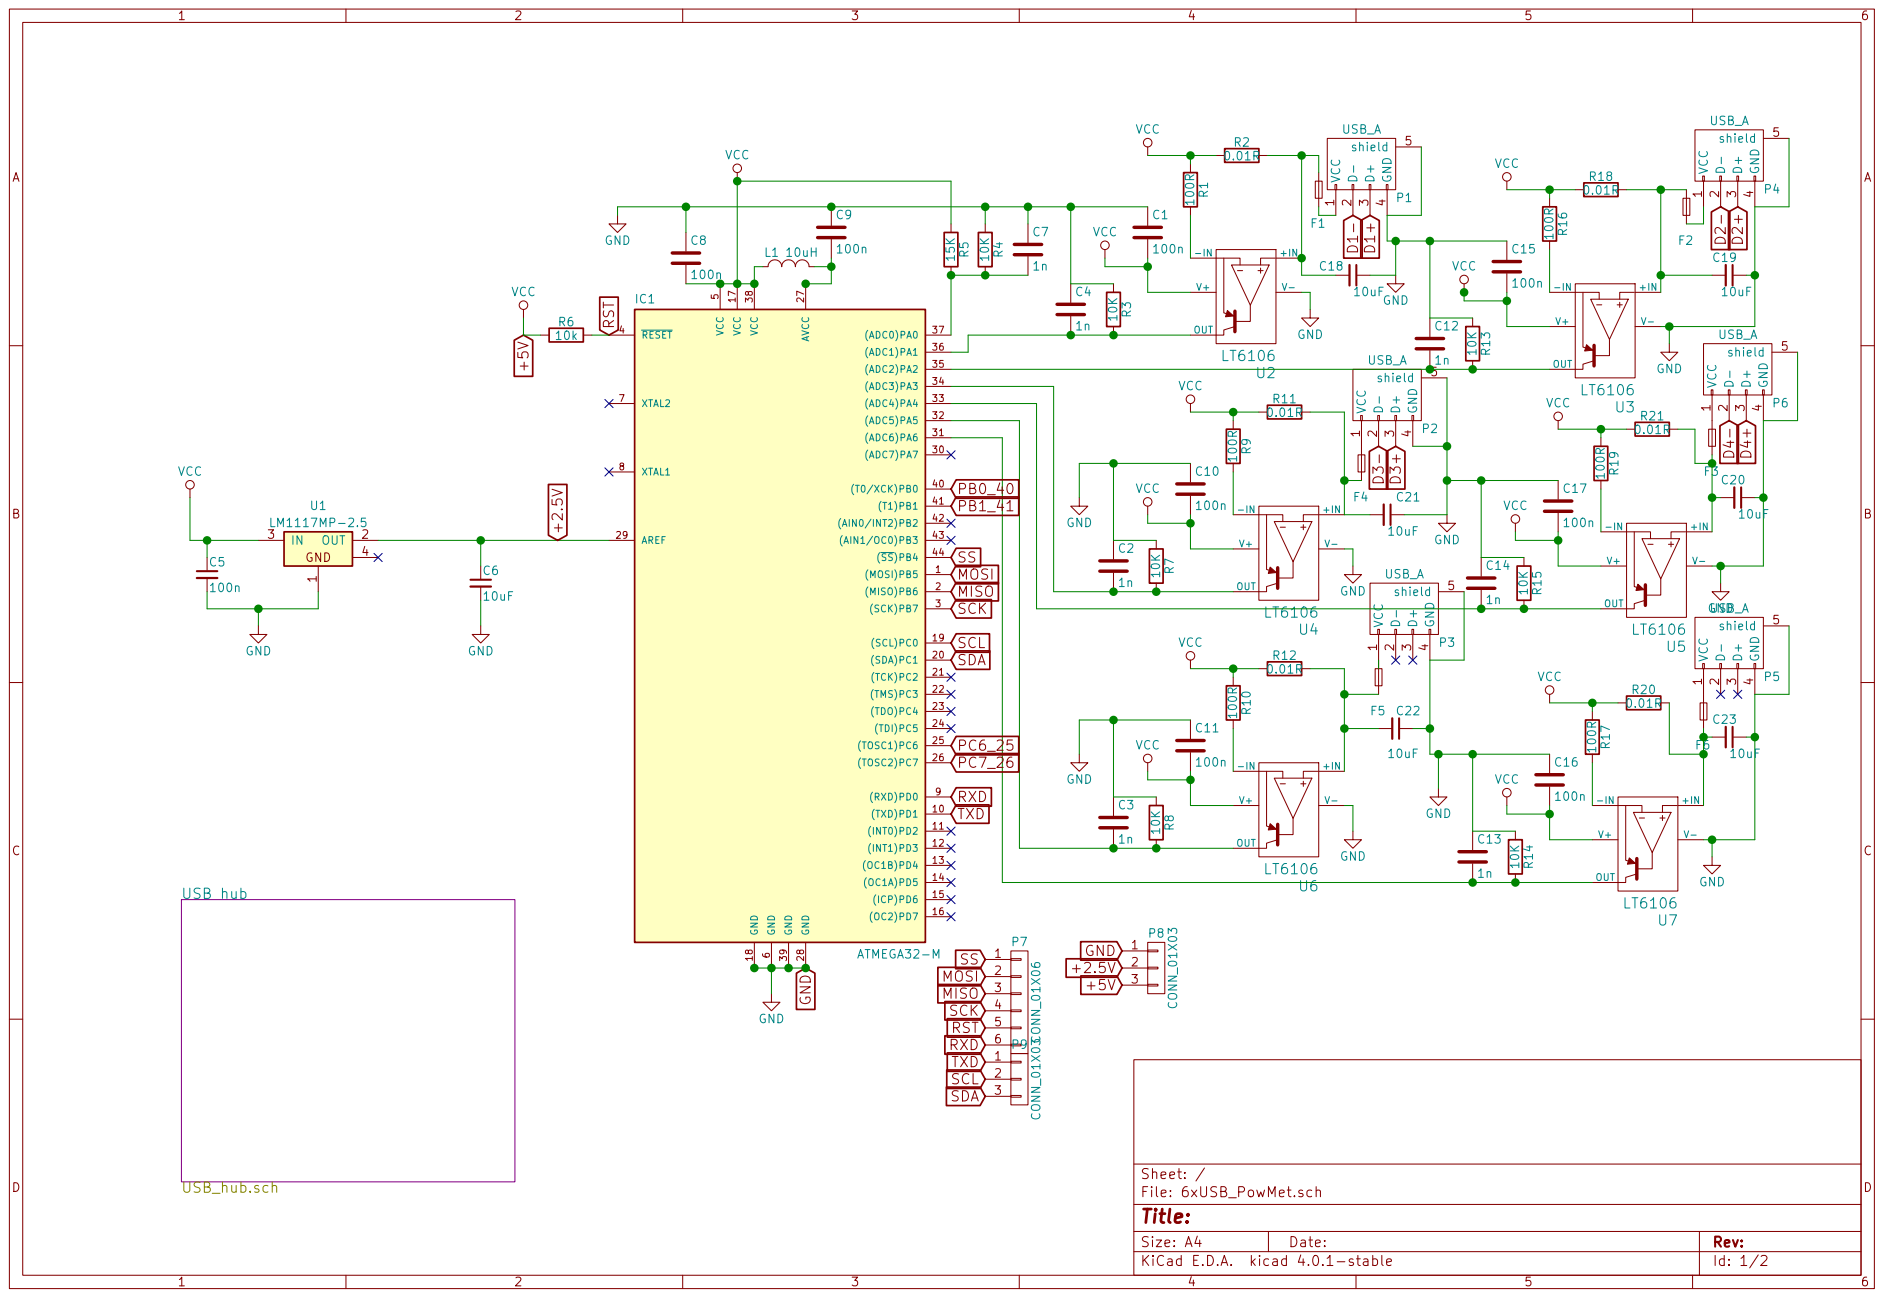
[picture p45: page 1]

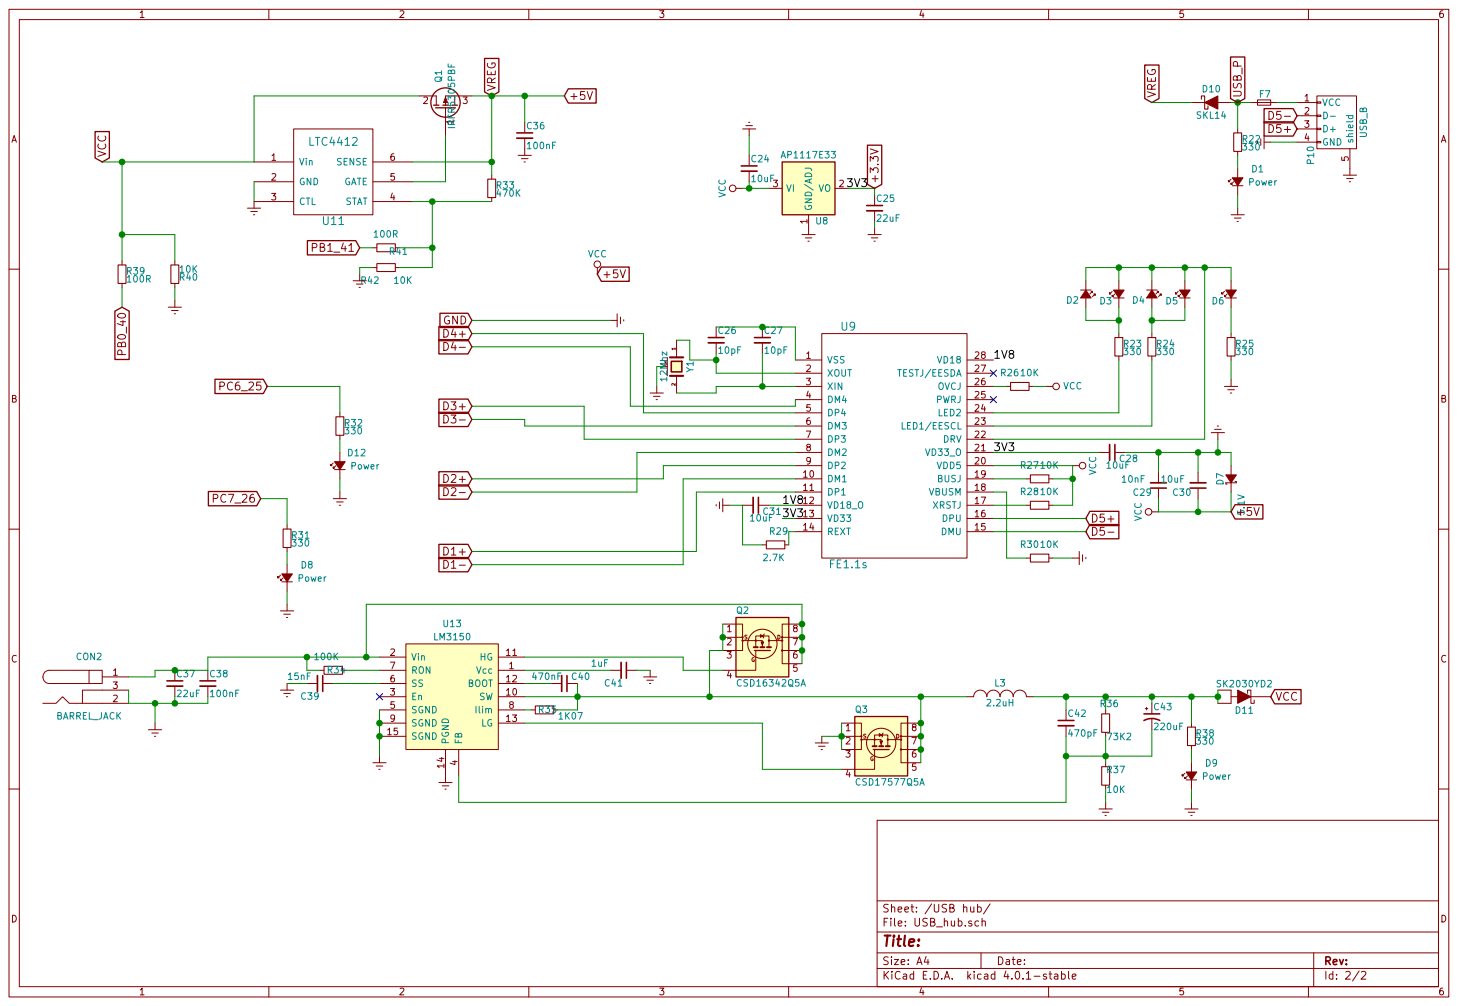
[picture p46: page 2]

File: USB_hub.sch Sheet: /USB hub/
Id: 2/2 Title:
