aleksejm/6xUSB-Power-Meter/Hardware/PCB/USB_hub-USB hub.pdf

File: USB_hub.sch Sheet: /USB hub/
Id: 2/2 Title:
