aleksejm/6xUSB-Power-Meter/Hardware/PCB/6xUSB_PowMet_new/pcb_back.pdf

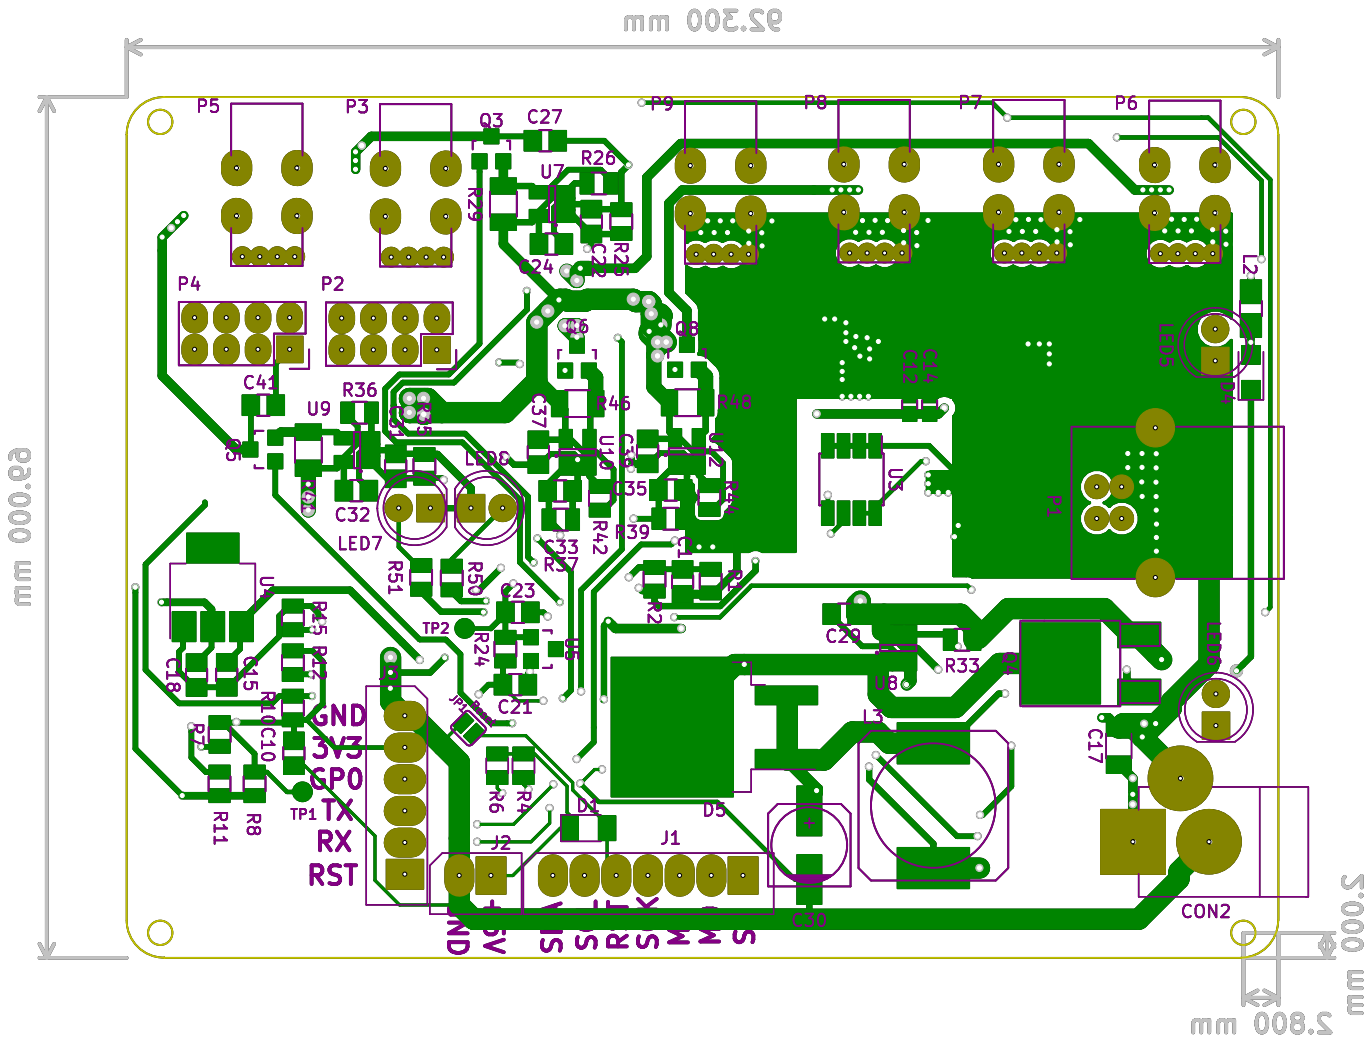
[picture p47: page 1]
