aleksejm/6xUSB-Power-Meter/Hardware/PCB/6xUSB_PowMet_new/pcb_front.pdf

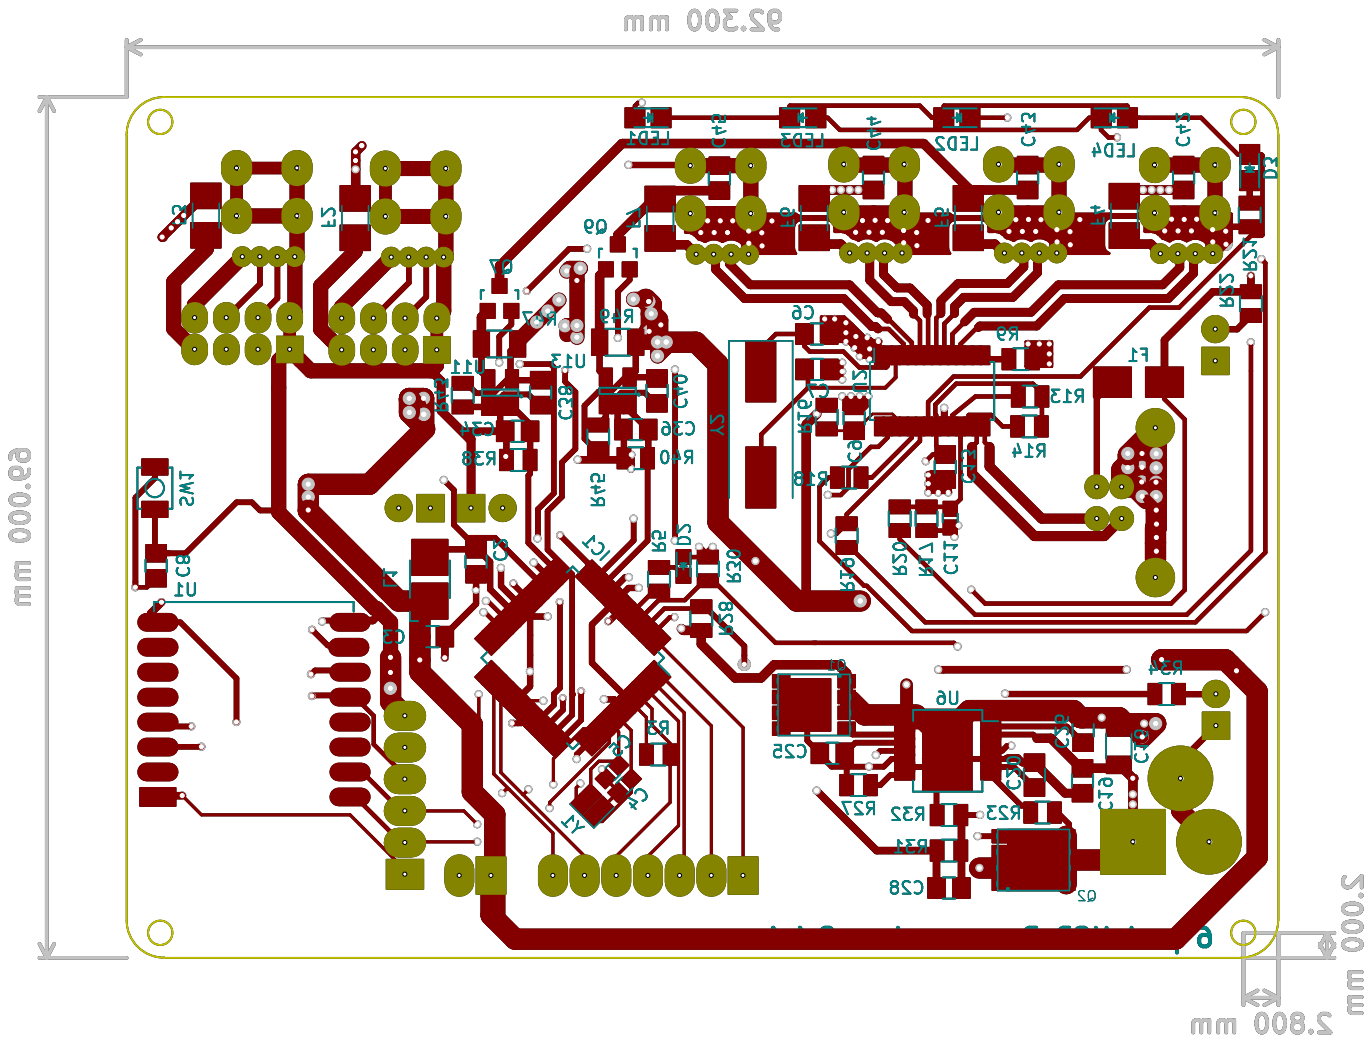
[picture p48: page 1]
