aleksejm/6xUSB-Power-Meter/3D_case/Case.PDF

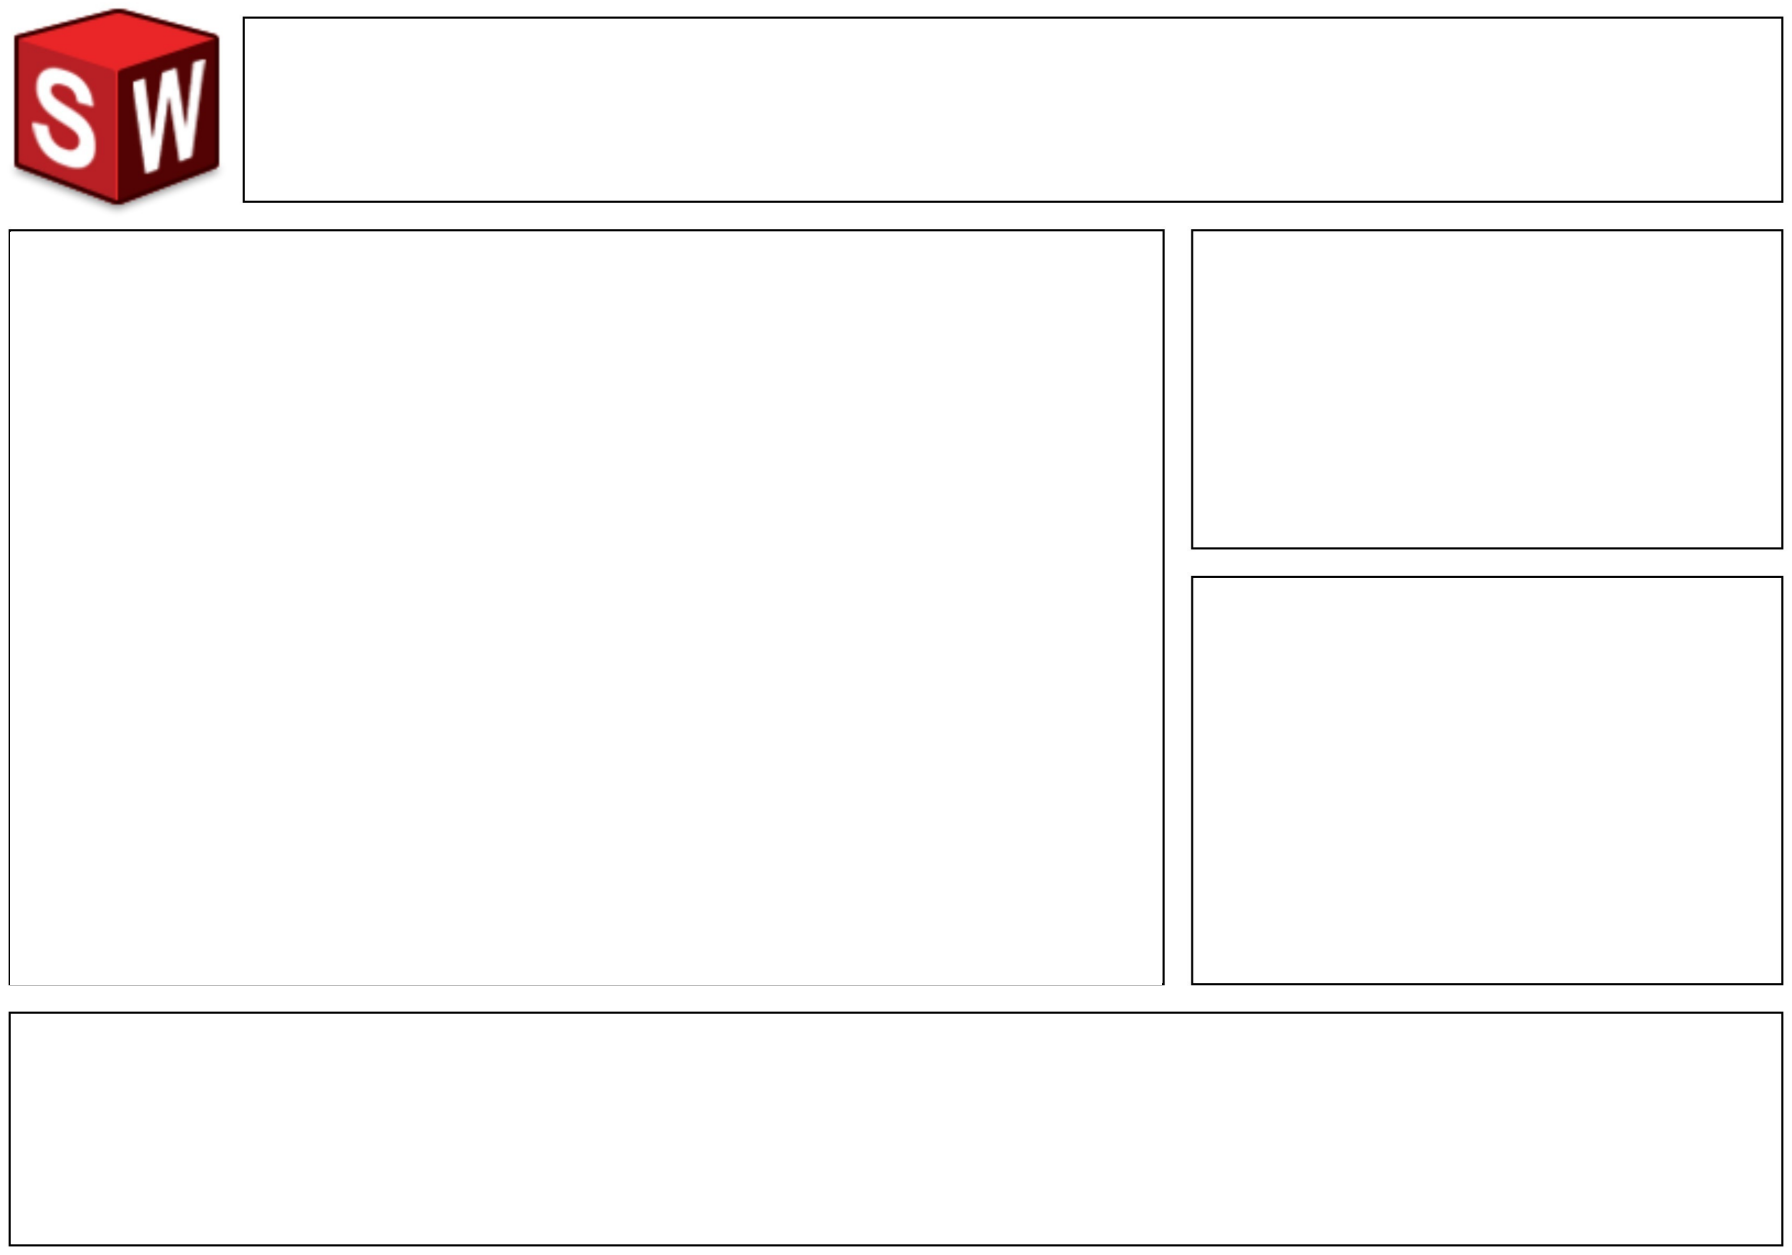
[picture p49: page 1]

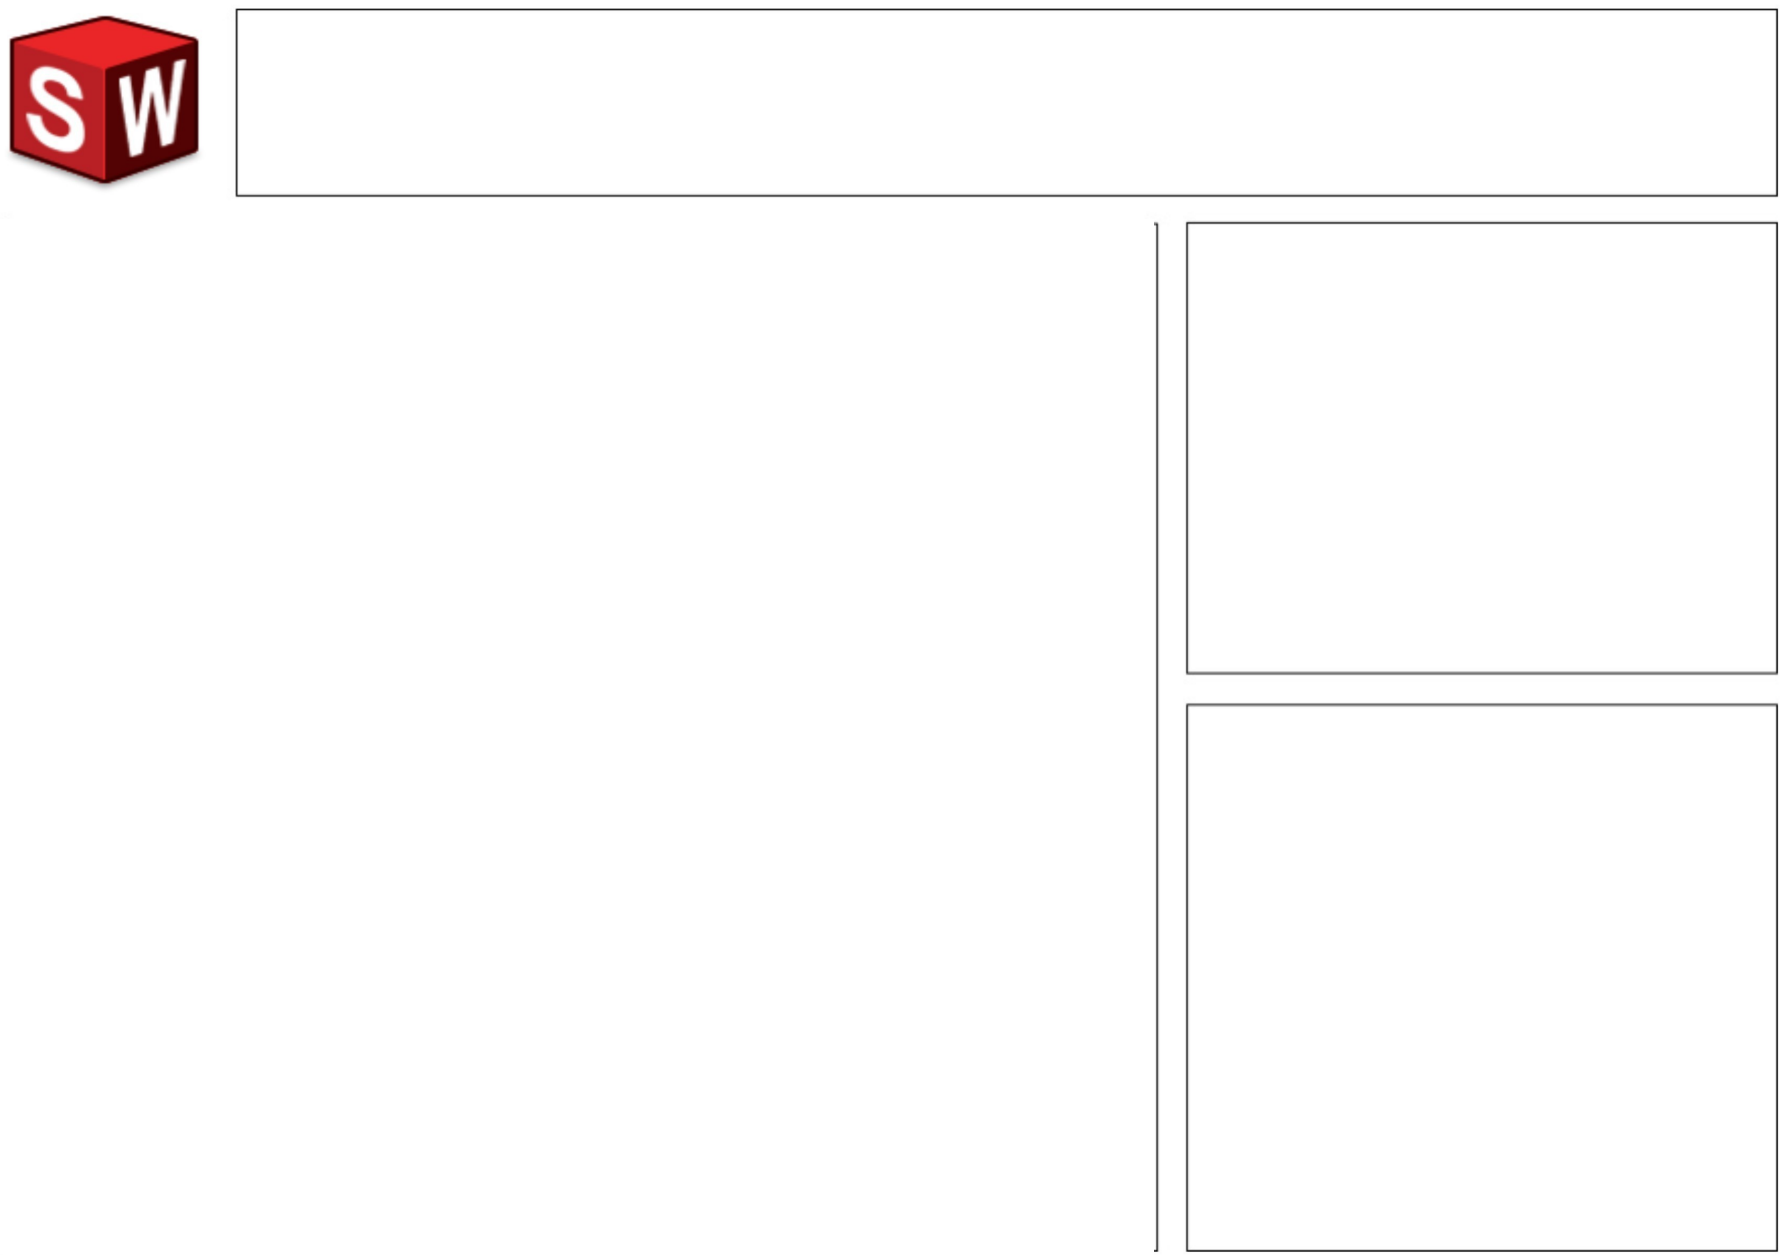
[picture p50: page 2]
