aleksejm/6xUSB-Power-Meter/(list of files, drawings)

Other design files:
Hardware/FE1_1s_B_V1_3/FE1_1s_B_V1_3/FE1_1s_B_SSOP28_V1_3.DSN
KiCad librarys/webench_schematic_exchange_design_4493365_1_Accel15/Accel15/2016-05-09_02-05-33.pcb
