aleksejm/6xUSB-Power-Meter/Hardware/6xUSB_PowMet.kicad_pcb

## KiCad design Hardware/6xUSB_PowMet.kicad_pcb (2016-04-20)

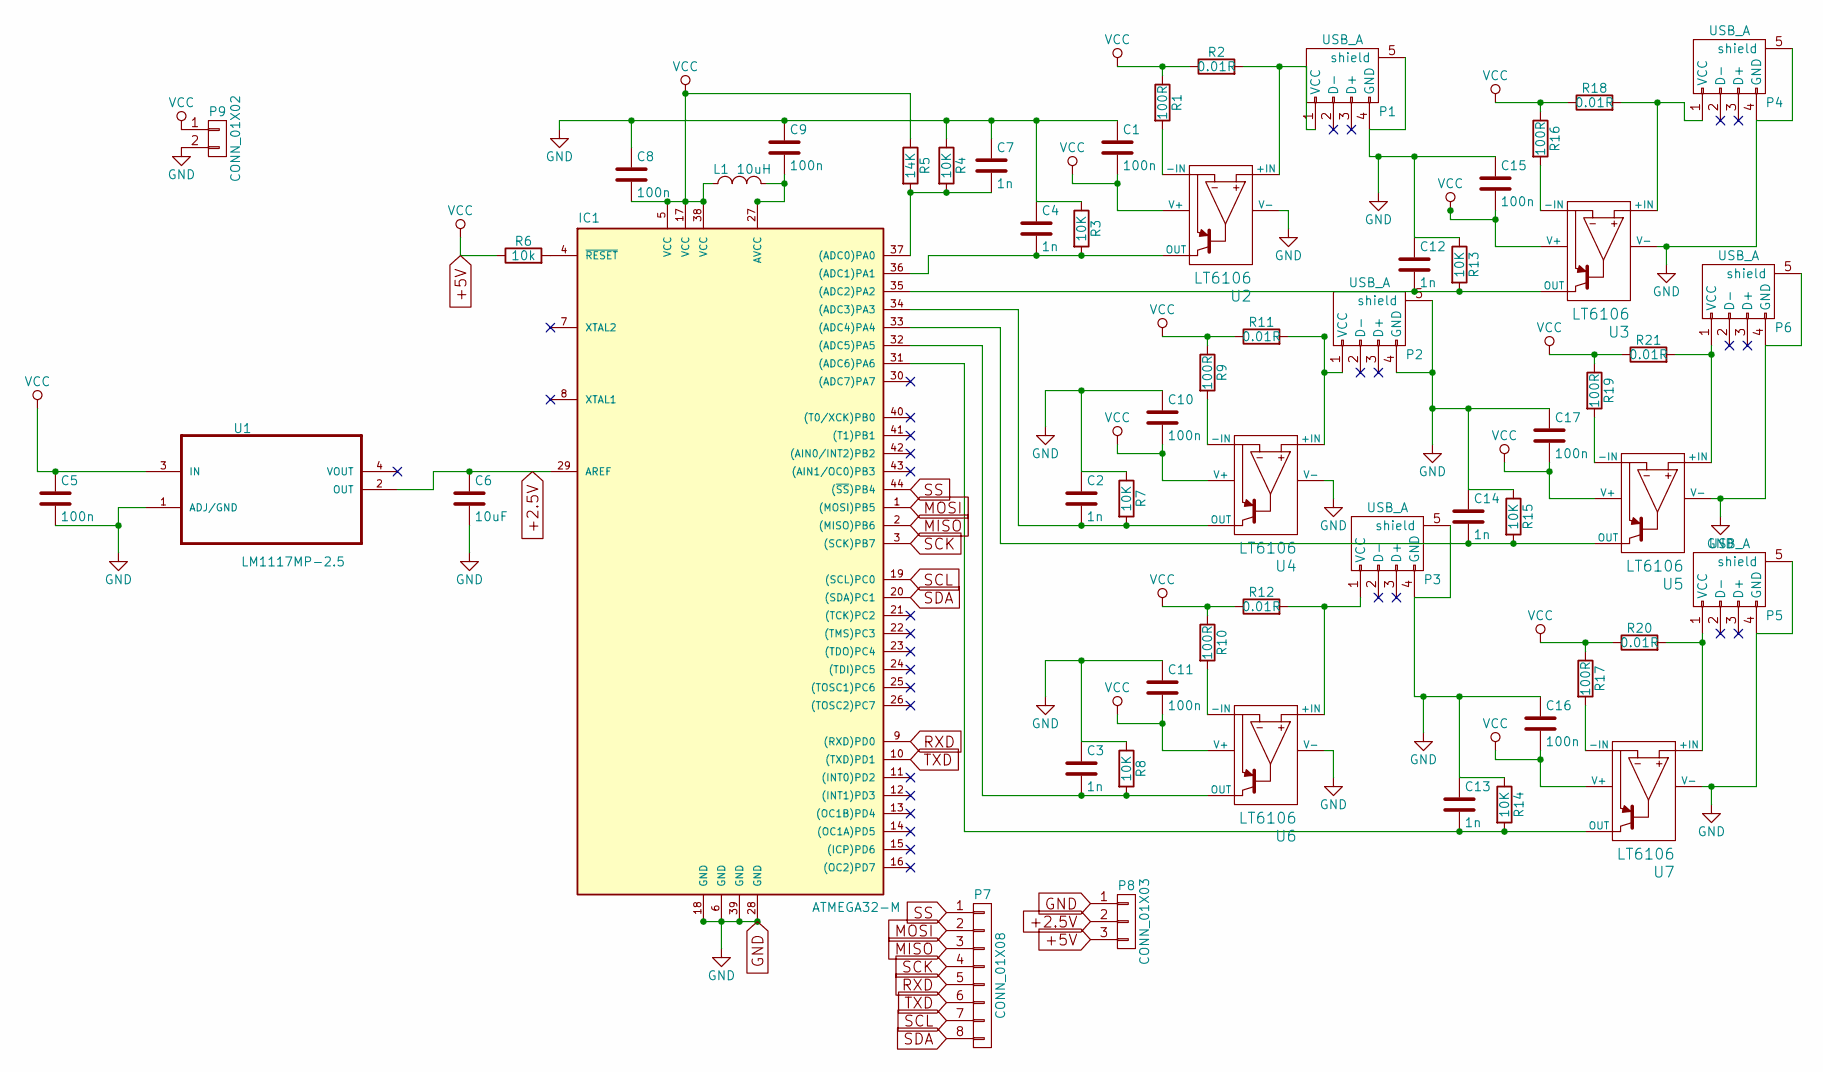
[picture p51: schematic 6xUSB_PowMet.sch]

Parts:
C1, C5, C8, C9, C10, C11, C15, C16, C17: 100n; C_0805
C2, C3, C4, C7, C12, C13, C14: 1n; C_0805
C6: 10uF; C_0805
IC1: ATMEGA32-M; TQFP-44_10x10mm_Pitch0.8mm
L1: 10uH; Resistor_Horizontal_RM15mm
P1, P2, P3, P4, P5, P6: USB_A; USB_A_Vertical
P7: CONN_01X08; Wafer_Vertical22.5x5.8x7RM2.5-8
P8: CONN_01X03; Wafer_Vertical10x5.8x7RM2.5-3
P9: CONN_01X02; BARREL_JACK
R1, R9, R10, R16, R17, R19: 100R; R_0805
R2, R11, R12, R18, R20, R21: 0.01R; R_0805
R3, R4, R7, R8, R13, R14, R15: 10K; R_0805
R5: 14K; R_0805
R6: 10k; R_0805
U1: LM1117MP-2.5; SOT-223
U2, U3, U4, U5, U6, U7: LT6106; SOT-23-5

Connections:
+2.5V: C6.1, IC1.29 (AREF), P8.2, U1.2 (OUT)
+5V: C1.2, C5.1, C8.2, C10.2, C11.2, C15.2, C16.2, C17.2, IC1.5 (VCC), IC1.17 (VCC), IC1.38 (VCC), L1.1, P8.3, P9.1, R1.1, R2.1, R5.1, R6.1, R9.1, R10.1, R11.1, R12.1, R16.1, R17.1, R18.1, R19.1, R20.1, R21.1, U1.3 (IN), U2.5 (V+), U3.5 (V+), U4.5 (V+), U5.5 (V+), U6.5 (V+), U7.5 (V+)
GND: C1.1, C2.1, C3.1, C4.1, C5.2, C6.2, C7.1, C8.1, C9.1, C10.1, C11.1, C12.1, C13.1, C14.1, C15.1, C16.1, C17.1, IC1.6 (GND), IC1.18 (GND), IC1.28 (GND), IC1.39 (GND), P1.4 (GND), P1.5 (shield), P2.4 (GND), P2.5 (shield), P3.4 (GND), P3.5 (shield), P4.4 (GND), P4.5 (shield), P5.4 (GND), P5.5 (shield), P6.4 (GND), P6.5 (shield), P8.1, P9.2, R3.1, R4.1, R7.1, R8.1, R13.1, R14.1, R15.1, U1.1 (ADJ/GND), U2.2 (V-), U3.2 (V-), U4.2 (V-), U5.2 (V-), U6.2 (V-), U7.2 (V-)
MISO: IC1.2 ((MISO)PB6), P7.3
MOSI: IC1.1 ((MOSI)PB5), P7.2
unnamed: C2.2, IC1.34 ((ADC3)PA3), R7.2, U4.1 (OUT)
unnamed: C3.2, IC1.32 ((ADC5)PA5), R8.2, U6.1 (OUT)
unnamed: C4.2, IC1.36 ((ADC1)PA1), R3.2, U2.1 (OUT)
unnamed: C7.2, IC1.37 ((ADC0)PA0), R4.2, R5.2
unnamed: C9.2, IC1.27 (AVCC), L1.2
unnamed: C12.2, IC1.35 ((ADC2)PA2), R13.2, U3.1 (OUT)
unnamed: C13.2, IC1.31 ((ADC6)PA6), R14.2, U7.1 (OUT)
unnamed: C14.2, IC1.33 ((ADC4)PA4), R15.2, U5.1 (OUT)
unnamed: IC1.4 (~RESET), R6.2
unnamed: P1.1 (VCC), R2.2, U2.4 (+IN)
unnamed: P2.1 (VCC), R11.2, U4.4 (+IN)
unnamed: P3.1 (VCC), R12.2, U6.4 (+IN)
unnamed: P4.1 (VCC), R18.2, U3.4 (+IN)
unnamed: P5.1 (VCC), R20.2, U7.4 (+IN)
unnamed: P6.1 (VCC), R21.2, U5.4 (+IN)
unnamed: R1.2, U2.3 (-IN)
unnamed: R9.2, U4.3 (-IN)
unnamed: R10.2, U6.3 (-IN)
unnamed: R16.2, U3.3 (-IN)
unnamed: R17.2, U7.3 (-IN)
unnamed: R19.2, U5.3 (-IN)
RXD: IC1.9 ((RXD)PD0), P7.5
SCK: IC1.3 ((SCK)PB7), P7.4
SCL: IC1.19 ((SCL)PC0), P7.7
SDA: IC1.20 ((SDA)PC1), P7.8
SS: IC1.44 ((~SS~)PB4), P7.1
TXD: IC1.10 ((TXD)PD1), P7.6

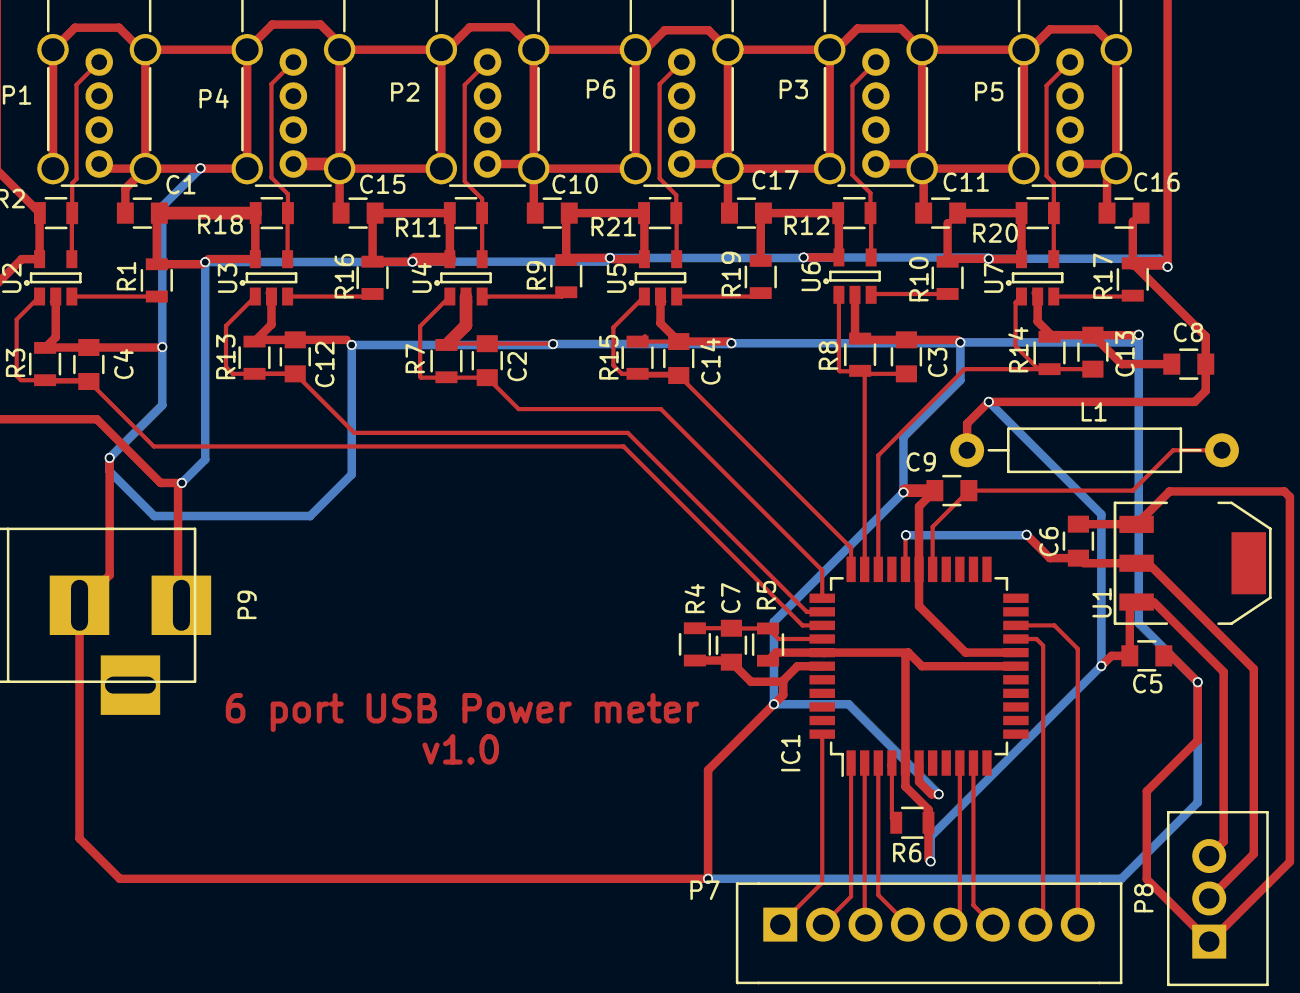
[picture p52: board Hardware/6xUSB_PowMet.kicad_pcb from above]

Board: 2 copper layers, 56 parts (0 on the bottom side), 32 nets.
