aleksejm/6xUSB-Power-Meter/Hardware/PCB/6xUSB_PowMet.kicad_pcb

## KiCad design Hardware/PCB/6xUSB_PowMet.kicad_pcb (2019-04-29)

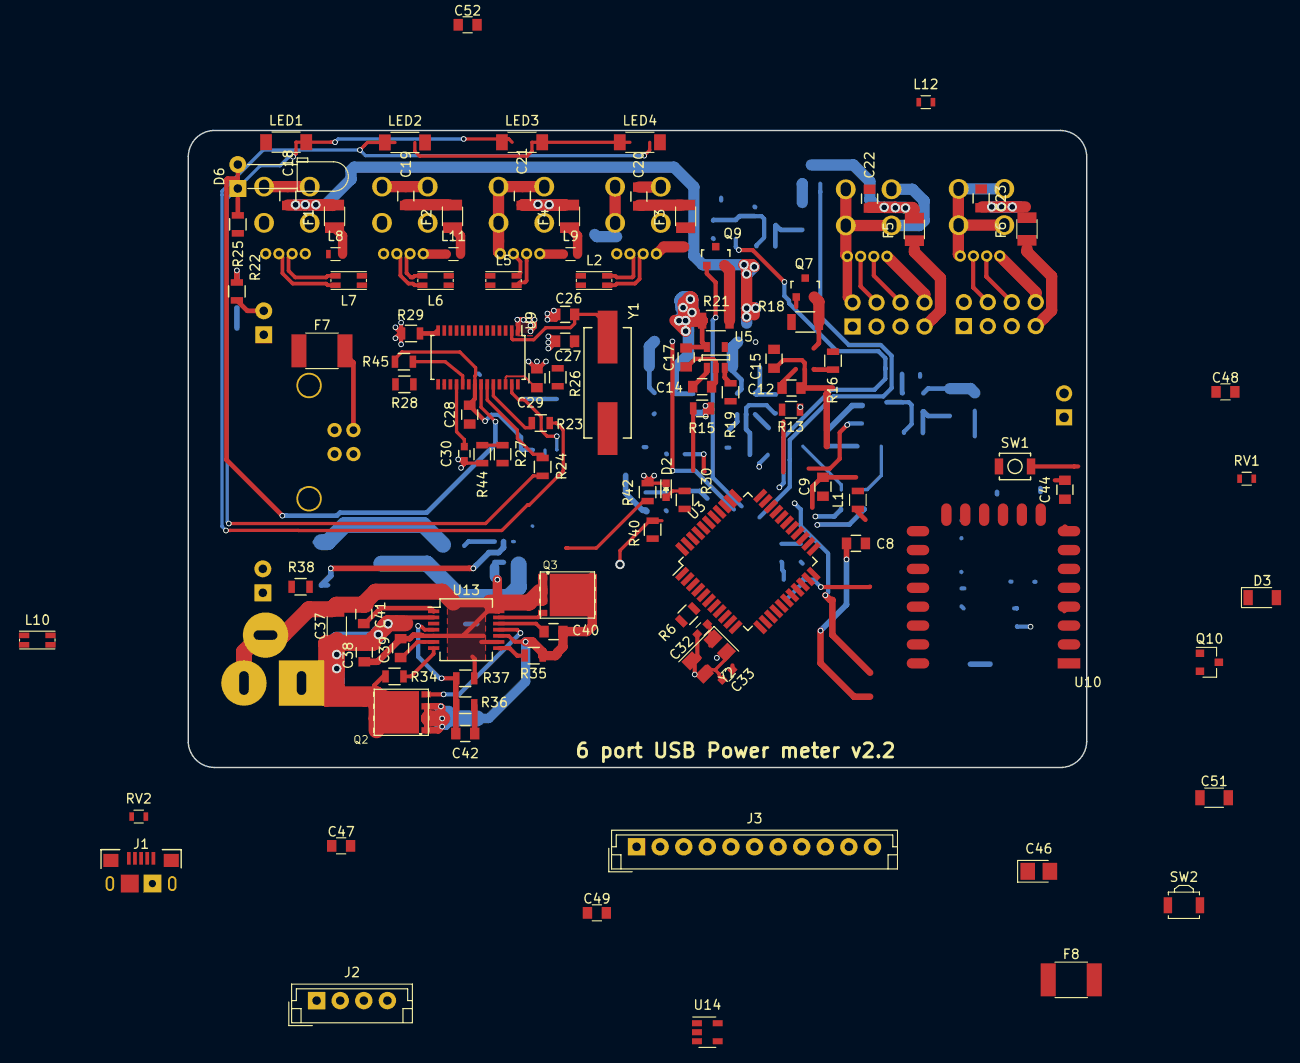
[picture p53: board Hardware/PCB/6xUSB_PowMet.kicad_pcb from above]

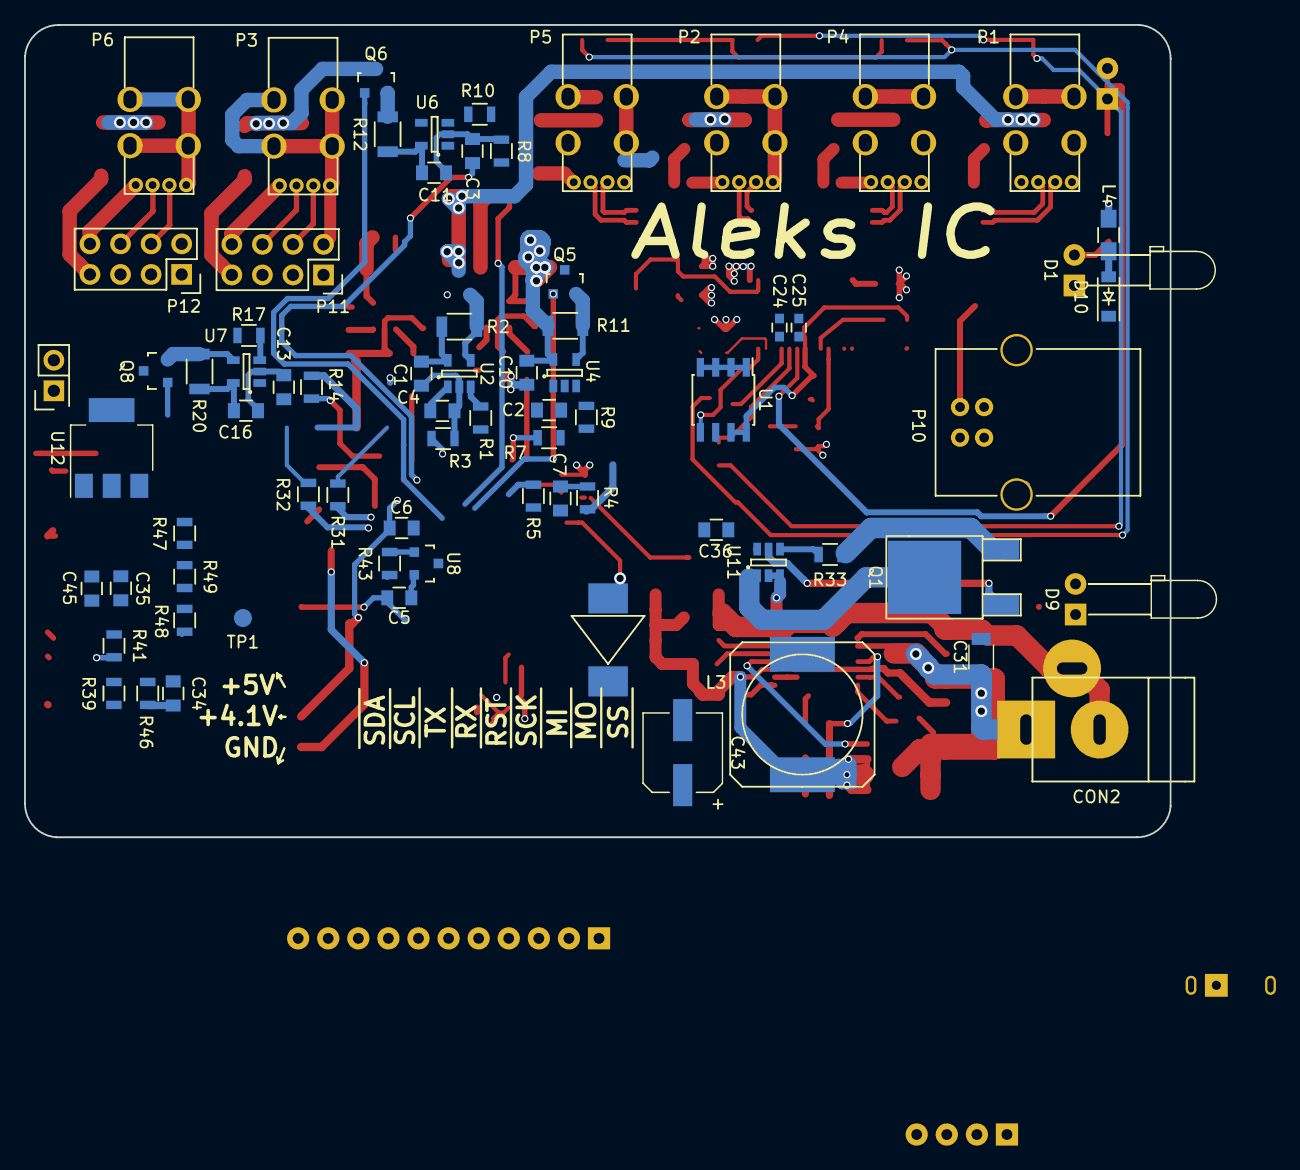
[picture p54: board Hardware/PCB/6xUSB_PowMet.kicad_pcb from below]

Board: 4 copper layers, 95.2 x 67.5 mm, 175 parts (73 on the bottom side), 137 nets.

Parts:
C1, C3, C4, C5, C6, C7, C8, C9, C10, C15, C16, C17, C27, C34, C35, C38, C48: 100n; C_0805
C2: 0.33uF; C_0805
C11, C12, C13, C14, C21, C22, C23, C42: 1nF; C_0805
C18, C19, C20, C28, C36, C44, C45: 10uF; C_0805
C24, C30, C33: 0.1uF; C_0603
C25, C32: 22pF; C_0603
C26, C52: 18pF; C_0805
C29: 10nF; C_0805
C31, C37, C51: 47uF; C_1206
C39: 15nF; C_0805
C40: 470nF; C_0805
C41, C47, C49: 1uF; C_0805
C43: 330uF; CP_Elec_6.3x5.8
C46: 22uF; CP_Tantalum_Case-R_EIA-2012-12_Reflow
CON2: BARREL_JACK; JACK_ALIM
D1: USB Power; LED_D3.0mm_Horizontal_O6.35mm_Z6.0mm
D2: MC Status; LED_0603
D3: CD1206-S01575; D_1206
D6: Led_Small_3mm; LED_D3.0mm_Horizontal_O6.35mm_Z6.0mm
D9: Power DC; LED_D3.0mm_Horizontal_O6.35mm_Z6.0mm
D10: SKL14; SOD-123
D11: SK152-TP; DO-214AB-SMC
F1, F2, F3, F4, F5, F6: F_Small; Fuse_SMD1206_Reflow
F7, F8: MSMF050-2; R_1812
J1: MICROUSB; USB-MICRO-B-FCI-10118193
J2: CONN_01X04; JST_EH_B04B-EH-A_04x2.50mm_Straight
J3: CONN_01X11; JST_EH_B11B-EH-A_11x2.50mm_Straight
L1: MH2029-300Y; L_0805
L2, L5, L6, L7, L10: WE-CNSW; L_CommonMode_Wuerth_WE-CNSW
L3: 4.7uH 5.2mOhm; SELF-WE-PD-XXL
L4: Bead/100MHZ/470ohm/2A; R_0805_HandSoldering
L8, L9, L11, L12: WE-CBF; L_0603
LED1, LED2, LED3, LED4: Led_Small; L_1806
P1, P2, P3, P4, P5, P6: USB_A; USB_A_Vertical
P10: USB_B
P11, P12: CONN_02X04; Socket_Strip_Straight_2x04
P13: Burn; Pin_Header_Straight_2x01
Q1: IRFR5305PBF; TO-252-2Lead
Q2: CSD16321Q5; AB2_SON5x6_FET
Q3: CSD18509Q5B; AB2_SON5x6_FET
Q5, Q6, Q7, Q8, Q9, Q10: IRLML6401; SOT-23
R1, R46: 470R; R_0805
R2, R11, R12, R18, R20, R21: 0.02R; R_1206
R3, R4, R6, R8, R9, R10, R13, R15, R16, R17, R19, R26, R27, R30, R37, R39, R40, R42: 10K; R_0805
R5: 15K; R_0805
R7, R32: 22R; R_0805
R14, R22, R23, R24, R25, R41, R43, R44, R47: 100R; R_0805
R28, R38, R45: 100K; R_0805
R29: 2.7K; R_0805
R31: 330; R_0805
R33: 470K; R_0805
R34: 237K; R_0805
R35: 1K07; R_0805
R36: 73K2; R_0805
R48, R49: 150R; R_0805
RV1, RV2: CG0603MLC-05E; L_0603
SW1: Reset; SW_SPST_B3U-1000P
SW2: Reset; SW_SPST_B3U-3000P
TP1: TEST; Measurement_Point_Round-SMD-Pad_Small
U1: 24LC02; SOIC-8_3.9x4.9mm_Pitch1.27mm
U2, U4, U5, U6, U7, U14: LT6106; SOT-23-5
U3: ATMEGA32U4-AU; LQFP-44_10x10mm_Pitch0.8mm
U8: LM4040N-4.1; SOT-23
U9: FE1.1s; TSSOP-28_4.4x9.7mm_Pitch0.65mm
U10: ESP-07v2; ESP-12E
U11: LTC4412; SOT-23-6
U12: 5v to 3.3v LDO; SOT-223-3Lead_TabPin2
U13: LM3150; SSOP-14_5.3x6.2mm_Pitch0.65mm
Y1: 12Mhz; Crystal_HC49-SD_SMD
Y2: 16.000 Mhz; Crystal_SMD_5032-4pin_5.0x3.2mm

Connections:
+3v3: C5.1, C6.1, J2.4, R3.2, R6.2, R10.2, R13.2, TP1.1, U10.8, U12.3
+4.096V: C9.1, C10.1, J2.2, R14.2, U3.42, U8.1
+5V: C2.1, C3.2, C4.2, C8.1, C15.2, C16.2, C17.2, C24.2, C27.2, C33.2, C34.2, C35.2, C48.1, D3.1, D11.2, J2.3, L1.1, Q1.3, R2.1, R4.1, R5.1, R11.1, R12.1, R14.1, R18.1, R20.1, R21.1, R22.1, R24.1, R25.1, R33.1, R41.1, R42.1, R43.1, R44.1, U2.5, U3.2, U3.14, U3.24, U3.34, U4.5, U5.5, U6.5, U7.5, U9.20, U11.6, U12.1, U14.5
/USB hub/3V3: C28.2, R38.1, R45.1, U1.7, U1.8, U9.21
/USB hub/LED1: R47.2, U1.6, U9.23
/USB hub/TESTJ: U1.5, U9.27
ADC9: J3.10, U3.26
ADC10: J3.11, U3.27
D1+: L7.2, P1.3
D1-: L7.3, P1.2
D2+: L6.2, P4.3
D2-: L6.3, P4.2
D3+: L5.2, P2.3
D3-: L5.3, P2.2
D4+: L2.2, P5.3
D4-: L2.3, P5.2
D5+: L10.1, P10.3
D5-: L10.4, P10.2
D+: R7.1, U3.4
D-: R32.1, U3.3
GND: C1.1, C2.2, C3.1, C4.1, C5.2, C6.2, C7.2, C8.2, C9.2, C10.2, C11.1, C12.1, C13.1, C14.1, C15.1, C16.1, C17.1, C18.1, C19.1, C20.1, C21.1, C22.1, C23.1, C24.1, C25.2, C26.1, C27.1, C28.1, C29.2, C31.2, C32.2, C33.1, C34.1, C35.1, C36.1, C37.2, C38.2, C39.2, C41.1, C43.2, C44.1, C45.1, C46.2, C47.1, C48.2, C49.1, C51.2, C52.1, CON2.2, CON2.3, D1.1, D2.1, D9.1, J1.5, J2.1, P1.4, P1.5, P2.4, P2.5, P4.4, P4.5, P5.4, P5.5, P10.4, P10.5, P11.1, P12.1, P13.2, Q3.1, Q3.2, Q3.3, R8.1, R9.1, R15.2, R16.2, R17.2, R19.2, R26.2, R29.2, R30.2, R37.1, R39.2, R40.2, R48.2, RV1.2, RV2.2, SW1.1, SW2.2, U1.1, U1.2, U1.3, U1.4, U2.2, U3.5, U3.15, U3.23, U3.35, U3.43, U4.2, U5.2, U6.2, U7.2, U8.2, U9.1, U10.15, U11.2, U11.3, U12.2, U13.5, U13.9, U13.14, U14.2, Y2.2, Y2.4
MC_ST: R46.1, U3.29
MISO: J3.3, U3.11
MOSI: J3.2, U3.10
unnamed: C1.2, R1.1, R6.1, SW1.2, U10.1
unnamed: C11.2, R5.2, R15.1, U3.30
unnamed: C12.2, R16.1, U2.1, U3.41
unnamed: C13.2, R17.1, U3.39, U4.1
unnamed: C14.2, R19.1, U3.37, U5.1
unnamed: C18.2, F1.2, Q10.3
unnamed: C19.2, F4.2, Q5.3
unnamed: C20.2, F3.2, Q6.3
unnamed: C21.2, R30.1, U3.40, U6.1
unnamed: C22.2, R39.1, U3.36, U7.1
unnamed: C23.2, R40.1, U3.38, U14.1
unnamed: C25.1, U3.16, Y2.3
unnamed: C26.2, U9.2, Y1.1
unnamed: C29.1, R42.2, U9.26
unnamed: C30.1, R28.1
unnamed: C30.2, R27.2, R28.2, U9.18
unnamed: C31.1, C37.1, C38.1, C51.1, CON2.1, Q2.5, Q2.6, Q2.7, Q2.8, R34.2, U13.2
unnamed: C32.1, U3.17, Y2.1
unnamed: C36.2, F2.2, Q7.3
unnamed: C39.1, U13.6
unnamed: C40.1, L3.1, Q2.1, Q2.2, Q2.3, Q3.5, Q3.6, Q3.7, Q3.8, R35.1, U13.10
unnamed: C40.2, U13.12
unnamed: C41.2, U13.1
unnamed: C42.1, C43.1, D11.1, L3.2, R31.1, R36.2
unnamed: C42.2, R36.1, R37.2, U13.4
unnamed: C44.2, F5.2, Q9.3
unnamed: C45.2, F6.2, Q8.3
unnamed: C46.1, F8.1, J1.1
unnamed: C47.2, L1.2, U3.44
unnamed: C49.2, U3.6
unnamed: C52.2, U9.3, Y1.2
unnamed: D1.2, R49.2
unnamed: D2.2, R46.2
unnamed: D6.1, R48.1
unnamed: D6.2, LED1.2, LED2.1, LED3.2, LED4.1, U9.22
unnamed: D9.2, R31.2
unnamed: D10.2, L4.1
unnamed: F1.1, L8.2
unnamed: F2.1, L11.2
unnamed: F3.1, P11.7
unnamed: F4.1, L9.2
unnamed: F5.1, L12.2
unnamed: F6.1, P12.7
unnamed: F7.2, P10.1
unnamed: J1.2, R32.2, RV2.1
unnamed: J1.3, R7.2, RV1.1
unnamed: L2.1, U9.5
unnamed: L2.4, U9.4
unnamed: L5.1, U9.7
unnamed: L5.4, U9.6
unnamed: L6.1, U9.9
unnamed: L6.4, U9.8
unnamed: L7.1, U9.11
unnamed: L7.4, U9.10
unnamed: L8.1, P1.1
unnamed: L9.1, P2.1
unnamed: L10.2, U9.16
unnamed: L10.3, U9.15
unnamed: L11.1, P4.1
unnamed: L12.1, P5.1
unnamed: LED1.1, LED4.2, R23.1
unnamed: LED2.2, LED3.1, R47.1
unnamed: P3.4, P3.5, P11.2
unnamed: P3.3, P11.4
unnamed: P3.2, P11.6
unnamed: P3.1, P11.8
unnamed: P6.4, P6.5, P12.2
unnamed: P6.3, P12.4
unnamed: P6.2, P12.6
unnamed: P6.1, P12.8
unnamed: P13.1, R10.1, U10.18
unnamed: Q1.1, U11.5
unnamed: Q2.4, U13.11
unnamed: Q3.4, U13.13
unnamed: Q5.2, R11.2, U4.4
unnamed: Q6.2, R12.2, U5.4
unnamed: Q7.2, R18.2, U6.4
unnamed: Q8.2, R20.2, U7.4
unnamed: Q9.2, R21.2, U14.4
unnamed: Q10.2, R2.2, U2.4
unnamed: R1.2, U10.4
unnamed: R3.1, U10.3
unnamed: R9.2, U10.16
unnamed: R13.1, U10.17
unnamed: R22.2, U2.3
unnamed: R23.2, U9.24
unnamed: R24.2, U4.3
unnamed: R25.2, U5.3
unnamed: R29.1, U9.14
unnamed: R34.1, U13.7
unnamed: R35.2, U13.8
unnamed: R38.2, U9.17
unnamed: R41.2, U6.3
unnamed: R43.2, U7.3
unnamed: R44.2, U14.3
unnamed: R45.2, U9.19
PB0_40: R26.1, R33.2, U3.28, U11.4
RST: D3.2, J3.5, R4.2, SW2.1, U3.13
RXD: J3.6, U3.20, U10.22
SCK: J3.4, U3.9
SCL: J3.8, U3.18
SDA: J3.9, U3.19
SS: J3.1, U3.8
TXD: J3.7, U3.21, U10.21
USB_1: Q10.1, U3.1
USB_2: Q7.1, U3.12
USB_3: Q5.1, U3.32
USB_4: Q9.1, U3.33
USB_5: Q6.1, U3.31
USB_6: Q8.1, U3.22
USB_P: F7.1, L4.2, R49.1, U3.25
VBUS: C7.1, F8.2, R8.2, U3.7
VREG: D10.1, Q1.2, R27.1, U11.1
