aleksejm/6xUSB-Power-Meter/Hardware/PCB/6xUSB_PowMet_new/6xUSB_PowMet.kicad_pcb

## KiCad design Hardware/PCB/6xUSB_PowMet_new/6xUSB_PowMet.kicad_pcb (2019-04-29)

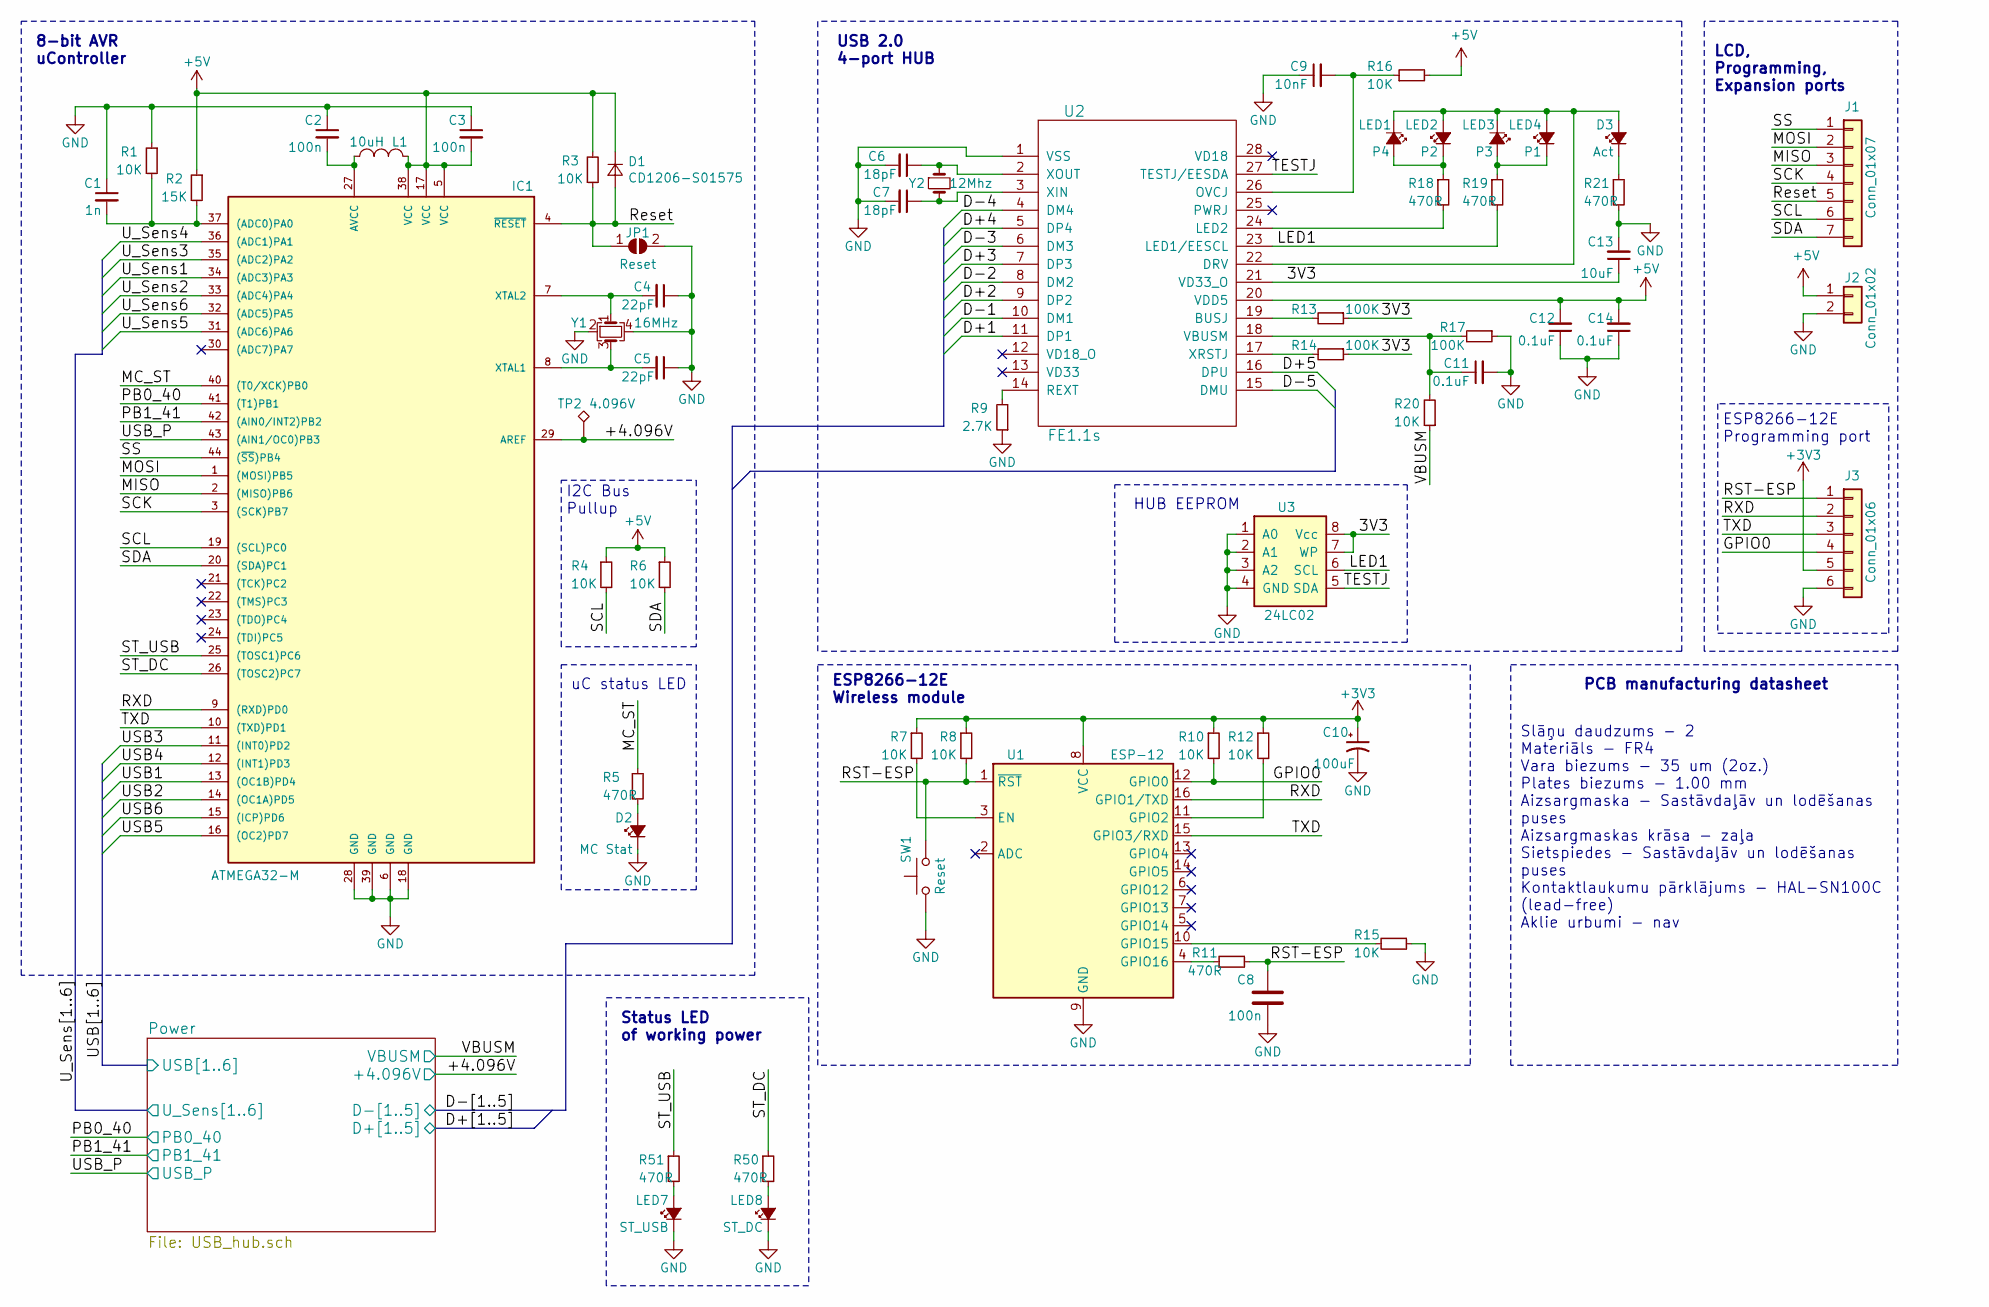
[picture p55: schematic 6xUSB_PowMet.sch, 6-port USB Power meter with 4-port USB 2.0 HUB]

Parts:
C1: 1n; C_0805; Tolerance 10%; Voltage 25V
C2, C3, C8: 100n; C_0805; Tolerance 10%; Voltage 25V
C4, C5: 22pF; C_0603; Tolerance 5%; Voltage 25V
C6, C7: 18pF; C_0805; Tolerance 5%; Voltage 50V
C9: 10nF; C_0805; Tolerance 10%; Voltage 50V
C10: 100uF; C_0805; Tolerance 20%; Voltage 6.3V
C11, C12, C14: 0.1uF; C_0603; Tolerance 10%; Voltage 25V
C13: 10uF; C_0805; Tolerance 10%; Voltage 16V
D1: CD1206-S01575; D_1206; Voltage 100V; Part Number CD1206-S01575
D2: MC Stat; LED_0603
D3: Act; LED_0805
IC1: ATMEGA32-M; TQFP-44_10x10mm_Pitch0.8mm
J1: Conn_01x07; Molex_SPOX-5267_22-03-5075_07x2.54mm_Straight
J2: Conn_01x02; Molex_SPOX-5267_22-03-5025_02x2.54mm_Straight
J3: Conn_01x06; Molex_SPOX-5267_22-03-5065_06x2.54mm_Straight
JP1: Reset; SMT-JUMPER_2_NO_SILK
L1: 10uH; Inductor_1212
LED1: P4; LED_0805
LED2: P2; LED_0805
LED3: P3; LED_0805
LED4: P1; LED_0805
LED7: ST_USB; LED_D5.0mm
LED8: ST_DC; LED_D5.0mm
R1: 10K; R_0805; Tolerance 1%; Power Rating 125mW
R2: 15K; R_0805; Tolerance 1%; Power Rating 125mW
R3, R4, R6, R7, R8, R10, R12, R15, R16, R20: 10K; R_0805; Tolerance 5%; Power Rating 125mW
R5, R18, R19, R21: 470R; R_0805; Power Rating 125mW; Tolerance 5%
R9: 2.7K; R_0805; Tolerance 1%; Voltage 150V; Part Number MCWR08X2701FTL
R11, R50, R51: 470R; R_0805; Tolerance 5%; Power Rating 125mW
R13, R14, R17: 100K; R_0805; Tolerance 5%; Power Rating 125mW
SW1: Reset; SW_SPST_B3U-1000P
TP2: 4.096V; TEST-SMD-SMALL
U1: ESP-12
U2: FE1.1s; TSSOP-28_4.4x9.7mm_Pitch0.65mm; Part Number FE1.1s-BSOP28B
U3: 24LC02; SOIC-8_3.9x4.9mm_Pitch1.27mm; Part Number 24LC02BT-I/SN
Y1: 16MHz; Crystal_SMD_2016-4pin_2.0x1.6mm; Tolerance 30PPM; Part Number 402F16033CLR
Y2: 12Mhz; Crystal_SMD_HC49-SD

Connections:
+3V3: C10.1, J3.5, R7.1, R8.1, R10.1, R12.1, U1.8 (VCC); also elsewhere on the board
+5V: C3.2, C12.2, C14.2, D1.1 (K), IC1.5 (VCC), IC1.17 (VCC), IC1.38 (VCC), J2.1, L1.1, R2.1, R3.2, R4.1, R6.1, R16.2, U2.20 (VDD5); also elsewhere on the board
/3V3: C13.1, R13.1, R14.1, U2.21 (VD33_O), U3.7 (WP), U3.8 (Vcc)
/+4.096V: IC1.29 (AREF), TP2.1; also elsewhere on the board
/D+1: U2.11 (DP1); also elsewhere on the board
/D+2: U2.9 (DP2); also elsewhere on the board
/D+3: U2.7 (DP3); also elsewhere on the board
/D+4: U2.5 (DP4); also elsewhere on the board
/D+5: U2.16 (DPU); also elsewhere on the board
/D-1: U2.10 (DM1); also elsewhere on the board
/D-2: U2.8 (DM2); also elsewhere on the board
/D-3: U2.6 (DM3); also elsewhere on the board
/D-4: U2.4 (DM4); also elsewhere on the board
/D-5: U2.15 (DMU); also elsewhere on the board
/GPIO0: J3.4, R10.2, U1.12 (GPIO0)
/LED1: R19.2, U2.23 (LED1/EESCL), U3.6 (SCL)
/MC_ST: IC1.40 ((T0/XCK)PB0), R5.1
/MISO: IC1.2 ((MISO)PB6), J1.3
/MOSI: IC1.1 ((MOSI)PB5), J1.2
/PB0_40: IC1.41 ((T1)PB1); also elsewhere on the board
/PB1_41: IC1.42 ((AIN0/INT2)PB2); also elsewhere on the board
/RST-ESP: C8.1, J3.1, R8.2, R11.2, SW1.2, U1.1 (~RST)
/RXD: IC1.9 ((RXD)PD0), J3.2, U1.16 (GPIO1/TXD)
/Reset: D1.2 (A), IC1.4 (~RESET), J1.5, JP1.1 (A), R3.1
/SCK: IC1.3 ((SCK)PB7), J1.4
/SCL: IC1.19 ((SCL)PC0), J1.6, R4.2
/SDA: IC1.20 ((SDA)PC1), J1.7, R6.2
/SS: IC1.44 ((~SS~)PB4), J1.1
/ST_DC: IC1.26 ((TOSC2)PC7), R50.1
/ST_USB: IC1.25 ((TOSC1)PC6), R51.1
/TESTJ: U2.27 (TESTJ/EESDA), U3.5 (SDA)
/TXD: IC1.10 ((TXD)PD1), J3.3, U1.15 (GPIO3/RXD)
/USB1: IC1.13 ((OC1B)PD4); also elsewhere on the board
/USB2: IC1.14 ((OC1A)PD5); also elsewhere on the board
/USB3: IC1.11 ((INT0)PD2); also elsewhere on the board
/USB4: IC1.12 ((INT1)PD3); also elsewhere on the board
/USB5: IC1.16 ((OC2)PD7); also elsewhere on the board
/USB6: IC1.15 ((ICP)PD6); also elsewhere on the board
/USB_P: IC1.43 ((AIN1/OC0)PB3); also elsewhere on the board
/U_Sens1: IC1.34 ((ADC3)PA3); also elsewhere on the board
/U_Sens2: IC1.33 ((ADC4)PA4); also elsewhere on the board
/U_Sens3: IC1.35 ((ADC2)PA2); also elsewhere on the board
/U_Sens4: IC1.36 ((ADC1)PA1); also elsewhere on the board
/U_Sens5: IC1.31 ((ADC6)PA6); also elsewhere on the board
/U_Sens6: IC1.32 ((ADC5)PA5); also elsewhere on the board
/VBUSM: R20.1; also elsewhere on the board
GND: C1.1, C2.1, C3.1, C4.1, C5.1, C6.2, C7.2, C8.2, C9.1, C10.2, C11.2, C12.1, C13.2, C14.1, D2.1 (K), IC1.6 (GND), IC1.18 (GND), IC1.28 (GND), IC1.39 (GND), J2.2, J3.6, JP1.2 (B), LED7.1 (K), LED8.1 (K), R1.1, R9.1, R15.1, R17.1, R21.2, SW1.1, U1.9 (GND), U2.1 (VSS), U3.1 (A0), U3.2 (A1), U3.3 (A2), U3.4 (GND), Y1.2, Y1.4; also elsewhere on the board
unnamed: C1.2, IC1.37 ((ADC0)PA0), R1.2, R2.2
unnamed: C2.2, IC1.27 (AVCC), L1.2
unnamed: C4.2, IC1.7 (XTAL2), Y1.1
unnamed: C5.2, IC1.8 (XTAL1), Y1.3
unnamed: C6.1, U2.2 (XOUT), Y2.1
unnamed: C7.1, U2.3 (XIN), Y2.2
unnamed: C9.2, R16.1, U2.26 (OVCJ)
unnamed: C11.1, R17.2, R20.2, U2.18 (VBUSM)
unnamed: D2.2 (A), R5.2
unnamed: D3.1 (K), R21.1
unnamed: D3.2 (A), LED1.1 (K), LED2.2 (A), LED3.1 (K), LED4.2 (A), U2.22 (DRV)
unnamed: LED1.2 (A), LED2.1 (K), R18.1
unnamed: LED3.2 (A), LED4.1 (K), R19.1
unnamed: LED7.2 (A), R51.2
unnamed: LED8.2 (A), R50.2
unnamed: R7.2, U1.3 (EN)
unnamed: R9.2, U2.14 (REXT)
unnamed: R11.1, U1.4 (GPIO16)
unnamed: R12.2, U1.11 (GPIO2)
unnamed: R13.2, U2.19 (BUSJ)
unnamed: R14.2, U2.17 (XRSTJ)
unnamed: R15.2, U1.10 (GPIO15)
unnamed: R18.2, U2.24 (LED2)

Notes on the sheet:
USB 2.0 4-port HUB
HUB EEPROM
8-bit AVR uController
LCD, Programming, Expansion ports
I2C Bus Pullup
uC status LED
ESP8266-12E Programming port
ESP8266-12E Wireless module
PCB manufacturing datasheet
Status LED of working power
Slāņu daudzums - 2 Materiāls - FR4 Vara biezums - 35 um (2oz.) Plates biezums - 1.00 mm Aizsargmaska - Sastāvdaļāv un lodēšanas puses Aizsargmaskas krāsa - zaļa Sietspiedes - Sastāvdaļāv un lodēšanas puses Kontaktlaukumu pārklājums - HAL-SN100C (lead-free) Aklie urbumi - nav
