aleksejm/6xUSB-Power-Meter/Hardware/PCB/6xUSB_PowMet_new/6xUSB_PowMet.kicad_pcb

## KiCad design Hardware/PCB/6xUSB_PowMet_new/6xUSB_PowMet.kicad_pcb (continued)

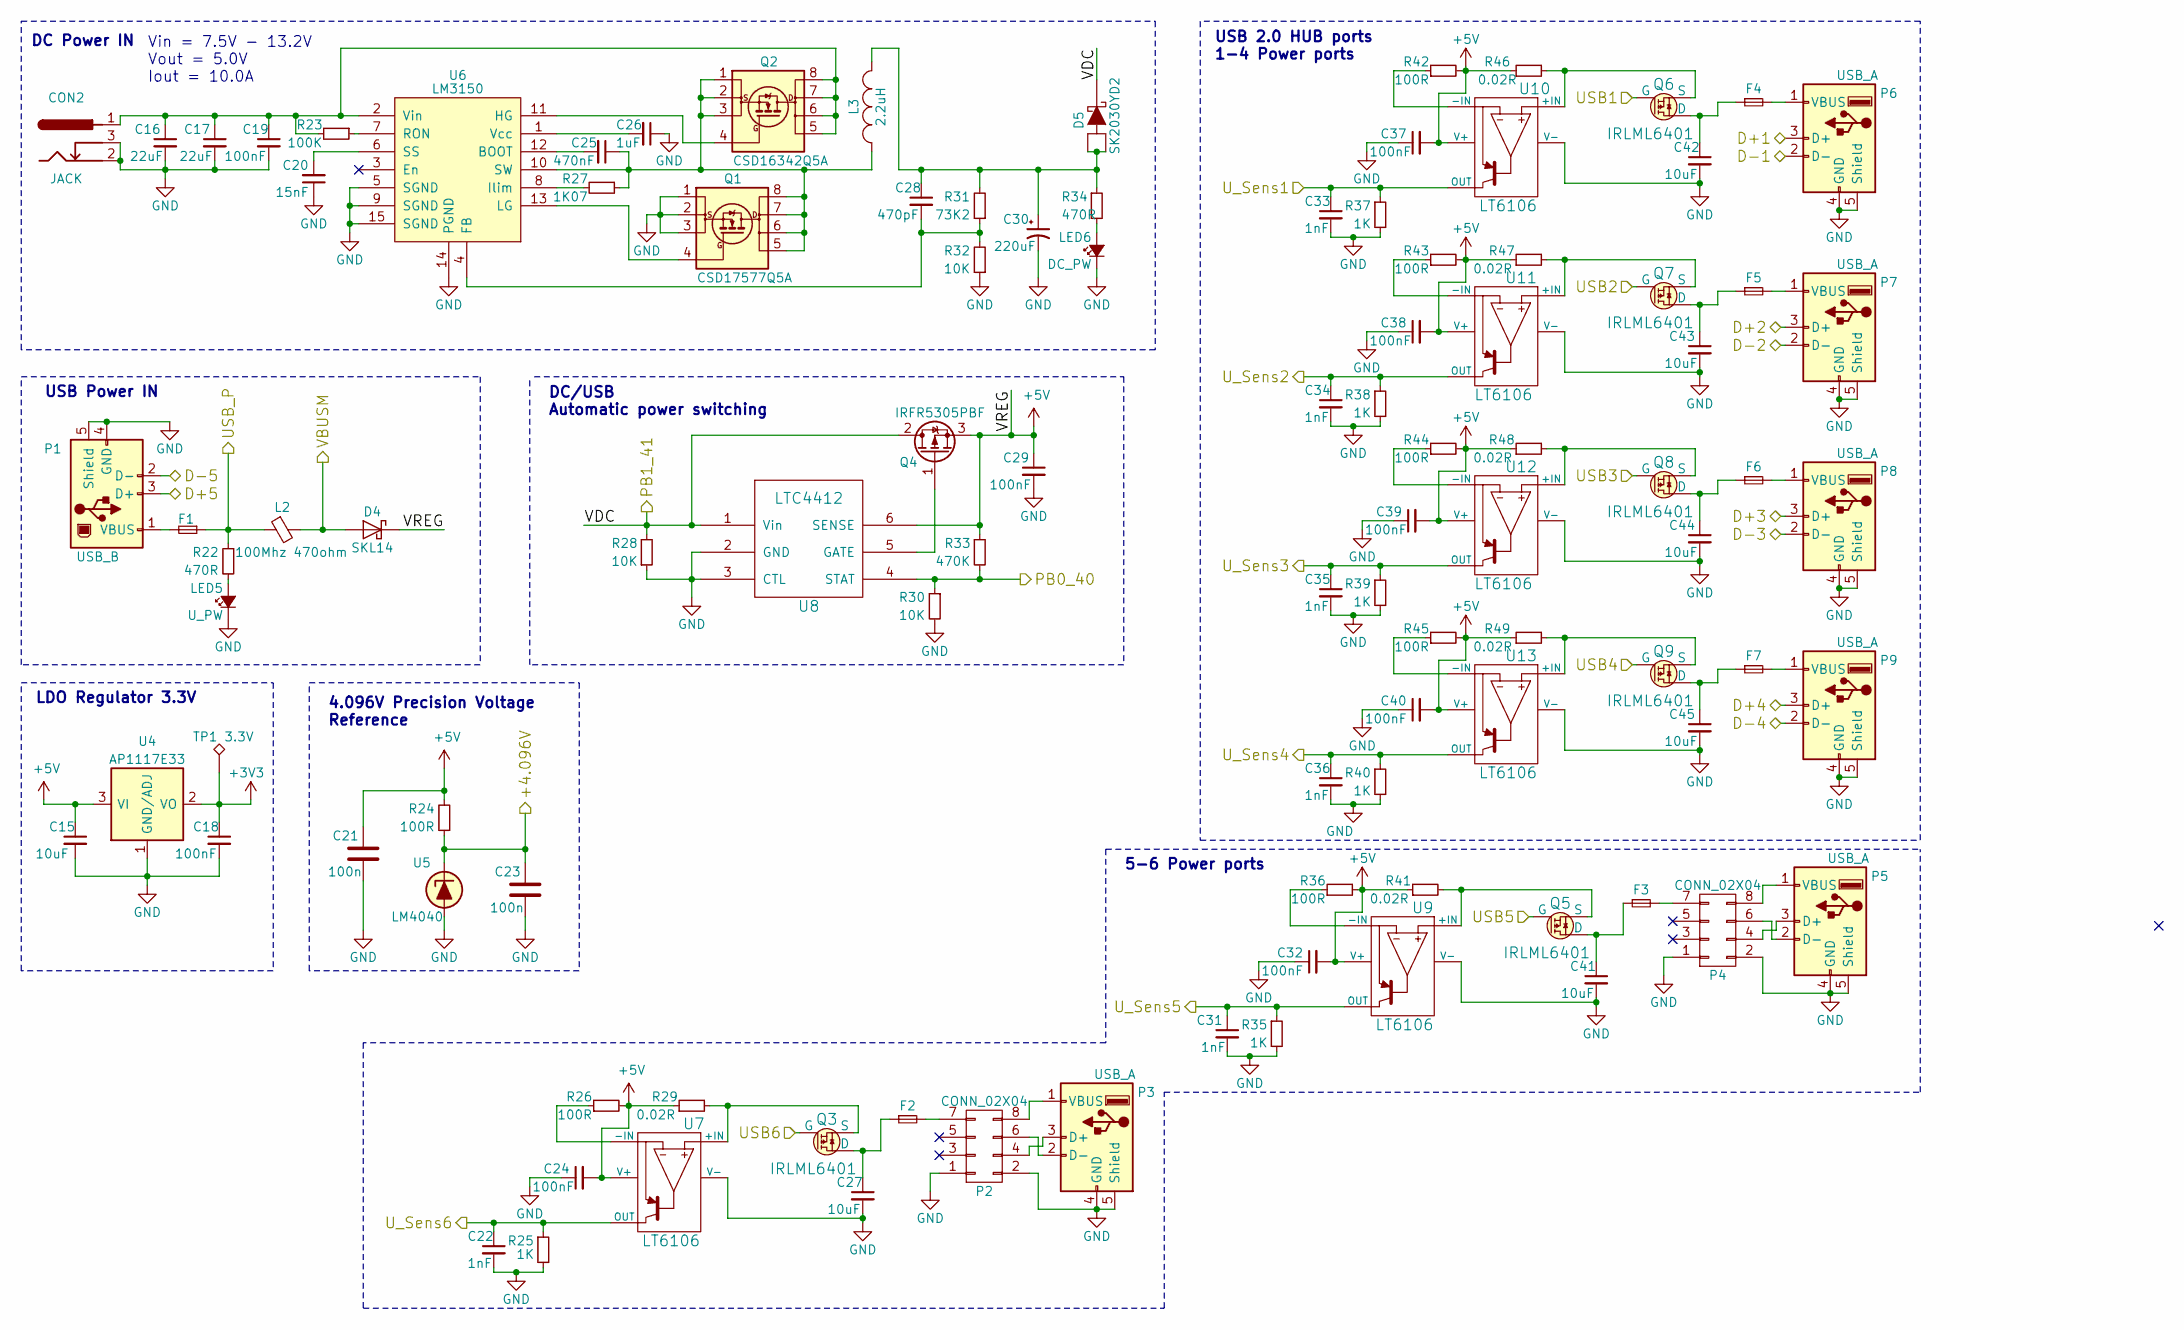
[picture p56: schematic USB_hub.sch, 6-port USB Power meter with 4-port USB 2.0 HUB]

Parts:
C15, C27, C41, C42, C43, C44, C45: 10uF; C_0805; Tolerance 10%; Voltage 25V
C16, C17: 22uF; C_1206; Tolerance 10%; Voltage 25V
C18, C19, C24, C29, C32, C37, C38, C39, C40: 100nF; C_0805; Tolerance 10%; Voltage 25V
C20: 15nF; C_0805; Tolerance 10%; Voltage 50V
C21, C23: 100n; C_0805; Tolerance 10%; Voltage 25V
C22, C31, C33, C34, C35, C36: 1nF; C_0805; Tolerance 10%; Voltage 25V
C25: 470nF; C_0805; Tolerance 10%; Voltage 16V
C26: 1uF; C_0805; Tolerance 10%; Voltage 16V
C28: 470pF; C_0805; Tolerance 10%; Voltage 50V
C30: 220uF; c_elec_6.3x7.7; Tolerance 20%; Voltage 6.3V
CON2: JACK; JACK_ALIM
D4: SKL14; D_SOD-123F
D5: SK2030YD2; TO-263-2; Voltage 30V
F1: 500mA; Fuse_SMD1206_HandSoldering
F2, F3, F4, F5, F6, F7: F_Small; Fuse_SMD1206_Wave; Part Number C1S 3.5
L2: 100Mhz 470ohm; R_0805_HandSoldering
L3: 2.2uH; SELF-WE-PD-XXL; Part Number SRP1270-2R2M
LED5: U_PW; LED_D5.0mm
LED6: DC_PW; LED_D5.0mm
P1: USB_B
P2, P4: CONN_02X04; Socket_Strip_Straight_2x04
P3, P5, P6, P7, P8, P9: USB_A; USB_A_Vertical; Part Number 614004184726
Q1: CSD17577Q5A; AB2_SON5x6_FET; Voltage 30V; Part Number CSD17577Q5A
Q2: CSD16342Q5A; AB2_SON5x6_FET; Voltage 25V
Q3, Q5, Q6, Q7, Q8, Q9: IRLML6401; SOT-23; Part Number IRLML6401GTRPBF
Q4: IRFR5305PBF; TO-252-2Lead; Part Number IRFR5305TRLPBF
R22: 470R; R_0805; Power Rating 125mW; Tolerance 5%
R23: 100K; R_0805; Tolerance 1%; Power Rating 125mW
R24: 100R; R_0805; Tolerance 1%; Power Rating 125mW
R25, R35, R37, R38, R39, R40: 1K; R_0805; Power Rating 125mW; Tolerance 1%
R26, R36, R42, R43, R44, R45: 100R; R_0805; Power Rating 125mW; Tolerance 1%
R27: 1K07; R_0805; Tolerance 1%; Power Rating 125mW
R28, R30: 10K; R_0805; Tolerance 5%; Power Rating 125mW
R29, R41, R46, R47, R48, R49: 0.02R; R_1206; Power Rating 125mW; Tolerance 1%
R31: 73K2; R_0805; Tolerance 1%; Power Rating 125mW
R32: 10K; R_0805; Tolerance 1%; Power Rating 125mW
R33: 470K; R_0805; Tolerance 5%; Power Rating 125mW
R34: 470R; R_0805; Tolerance 5%; Power Rating 125mW
TP1: 3.3V; TEST-SMD-SMALL
U4: AP1117E33; SOT-89-3; Part Number AP1117E33G-13
U5: LM4040; SOT-23; Part Number LM4040DIM3-4.1/NOPB
U6: LM3150; SSOP-14_5.3x6.2mm_Pitch0.65mm; Part Number LM3150MH/NOPB
U7, U9, U10, U11, U12, U13: LT6106; SOT-23-5; Part Number LT6106IS5#TRMPBF
U8: LTC4412; SOT-23-6; Part Number LTC4412ES6#TRMPBF

Connections:
+3V3: C18.1, TP1.1, U4.2 (VO); also elsewhere on the board
+5V: C15.1, C21.1, C24.2, C29.1, C32.2, C37.2, C38.2, C39.2, C40.2, D4.1 (K), Q4.3 (S), R24.2, R26.2, R29.1, R33.1, R36.2, R41.1, R42.2, R43.2, R44.2, R45.2, R46.1, R47.1, R48.1, R49.1, U4.3 (VI), U7.5 (V+), U8.6 (SENSE), U9.5 (V+), U10.5 (V+), U11.5 (V+), U12.5 (V+), U13.5 (V+); also elsewhere on the board
/+4.096V: C23.1, R24.1, U5.1; also elsewhere on the board
/D+1: P6.3 (D+); also elsewhere on the board
/D+2: P7.3 (D+); also elsewhere on the board
/D+3: P8.3 (D+); also elsewhere on the board
/D+4: P9.3 (D+); also elsewhere on the board
/D+5: P1.3 (D+); also elsewhere on the board
/D-1: P6.2 (D-); also elsewhere on the board
/D-2: P7.2 (D-); also elsewhere on the board
/D-3: P8.2 (D-); also elsewhere on the board
/D-4: P9.2 (D-); also elsewhere on the board
/D-5: P1.2 (D-); also elsewhere on the board
/PB0_40: R30.1, R33.2, U8.4 (STAT); also elsewhere on the board
/PB1_41: D5.2 (K), Q4.2 (D), R28.2, U8.1 (Vin); also elsewhere on the board
/USB1: Q6.1 (G); also elsewhere on the board
/USB2: Q7.1 (G); also elsewhere on the board
/USB3: Q8.1 (G); also elsewhere on the board
/USB4: Q9.1 (G); also elsewhere on the board
/USB5: Q5.1 (G); also elsewhere on the board
/USB6: Q3.1 (G); also elsewhere on the board
/USB_P: F1.1, L2.1, R22.1; also elsewhere on the board
/U_Sens1: C33.1, R37.1, U10.1 (OUT); also elsewhere on the board
/U_Sens2: C34.1, R38.1, U11.1 (OUT); also elsewhere on the board
/U_Sens3: C35.1, R39.1, U12.1 (OUT); also elsewhere on the board
/U_Sens4: C36.1, R40.1, U13.1 (OUT); also elsewhere on the board
/U_Sens5: C31.1, R35.1, U9.1 (OUT); also elsewhere on the board
/U_Sens6: C22.1, R25.1, U7.1 (OUT); also elsewhere on the board
/VBUSM: D4.2 (A), L2.2; also elsewhere on the board
GND: C15.2, C16.2, C17.2, C18.2, C19.2, C20.1, C21.2, C22.2, C23.2, C24.1, C26.1, C27.2, C29.2, C30.2, C31.2, C32.1, C33.2, C34.2, C35.2, C36.2, C37.1, C38.1, C39.1, C40.1, C41.2, C42.2, C43.2, C44.2, C45.2, CON2.2, CON2.3, LED5.1 (K), LED6.1 (K), P1.4 (GND), P1.5 (Shield), P2.1, P2.2, P3.4 (GND), P3.5 (Shield), P4.1, P4.2, P5.4 (GND), P5.5 (Shield), P6.4 (GND), P6.5 (Shield), P7.4 (GND), P7.5 (Shield), P8.4 (GND), P8.5 (Shield), P9.4 (GND), P9.5 (Shield), Q1.1 (S), Q1.2 (S), Q1.3 (S), R25.2, R28.1, R30.2, R32.1, R35.2, R37.2, R38.2, R39.2, R40.2, U4.1 (GND/ADJ), U5.2, U6.5 (SGND), U6.9 (SGND), U6.14 (PGND), U6.15 (SGND), U7.2 (V-), U8.2 (GND), U8.3 (CTL), U9.2 (V-), U10.2 (V-), U11.2 (V-), U12.2 (V-), U13.2 (V-); also elsewhere on the board
unnamed: C16.1, C17.1, C19.1, CON2.1, Q2.5 (D), Q2.6 (D), Q2.7 (D), Q2.8 (D), R23.2, U6.2 (Vin)
unnamed: C20.2, U6.6 (SS)
unnamed: C25.1, L3.1, Q1.5 (D), Q1.6 (D), Q1.7 (D), Q1.8 (D), Q2.1 (S), Q2.2 (S), Q2.3 (S), R27.1, U6.10 (SW)
unnamed: C25.2, U6.12 (BOOT)
unnamed: C26.2, U6.1 (Vcc)
unnamed: C27.1, F2.1, Q3.3 (D)
unnamed: C28.1, C30.1, D5.1 (A), D5.3 (A), L3.2, R31.2, R34.1
unnamed: C28.2, R31.1, R32.2, U6.4 (FB)
unnamed: C41.1, F3.1, Q5.3 (D)
unnamed: C42.1, F4.1, Q6.3 (D)
unnamed: C43.1, F5.1, Q7.3 (D)
unnamed: C44.1, F6.1, Q8.3 (D)
unnamed: C45.1, F7.1, Q9.3 (D)
unnamed: F1.2, P1.1 (VBUS)
unnamed: F2.2, P2.7
unnamed: F3.2, P4.7
unnamed: F4.2, P6.1 (VBUS)
unnamed: F5.2, P7.1 (VBUS)
unnamed: F6.2, P8.1 (VBUS)
unnamed: F7.2, P9.1 (VBUS)
unnamed: LED5.2 (A), R22.2
unnamed: LED6.2 (A), R34.2
unnamed: P2.4, P3.3 (D+)
unnamed: P2.6, P3.2 (D-)
unnamed: P2.8, P3.1 (VBUS)
unnamed: P4.4, P5.3 (D+)
unnamed: P4.6, P5.2 (D-)
unnamed: P4.8, P5.1 (VBUS)
unnamed: Q1.4 (G), U6.13 (LG)
unnamed: Q2.4 (G), U6.11 (HG)
unnamed: Q3.2 (S), R29.2, U7.4 (+IN)
unnamed: Q4.1 (G), U8.5 (GATE)
unnamed: Q5.2 (S), R41.2, U9.4 (+IN)
unnamed: Q6.2 (S), R46.2, U10.4 (+IN)
unnamed: Q7.2 (S), R47.2, U11.4 (+IN)
unnamed: Q8.2 (S), R48.2, U12.4 (+IN)
unnamed: Q9.2 (S), R49.2, U13.4 (+IN)
unnamed: R23.1, U6.7 (RON)
unnamed: R26.1, U7.3 (-IN)
unnamed: R27.2, U6.8 (Ilim)
unnamed: R36.1, U9.3 (-IN)
unnamed: R42.1, U10.3 (-IN)
unnamed: R43.1, U11.3 (-IN)
unnamed: R44.1, U12.3 (-IN)
unnamed: R45.1, U13.3 (-IN)

Notes on the sheet:
Vin = 7.5V - 13.2V Vout = 5.0V Iout = 10.0A
DC Power IN
DC/USB Automatic power switching
USB Power IN
LDO Regulator 3.3V
4.096V Precision Voltage Reference
USB 2.0 HUB ports 1-4 Power ports
5-6 Power ports

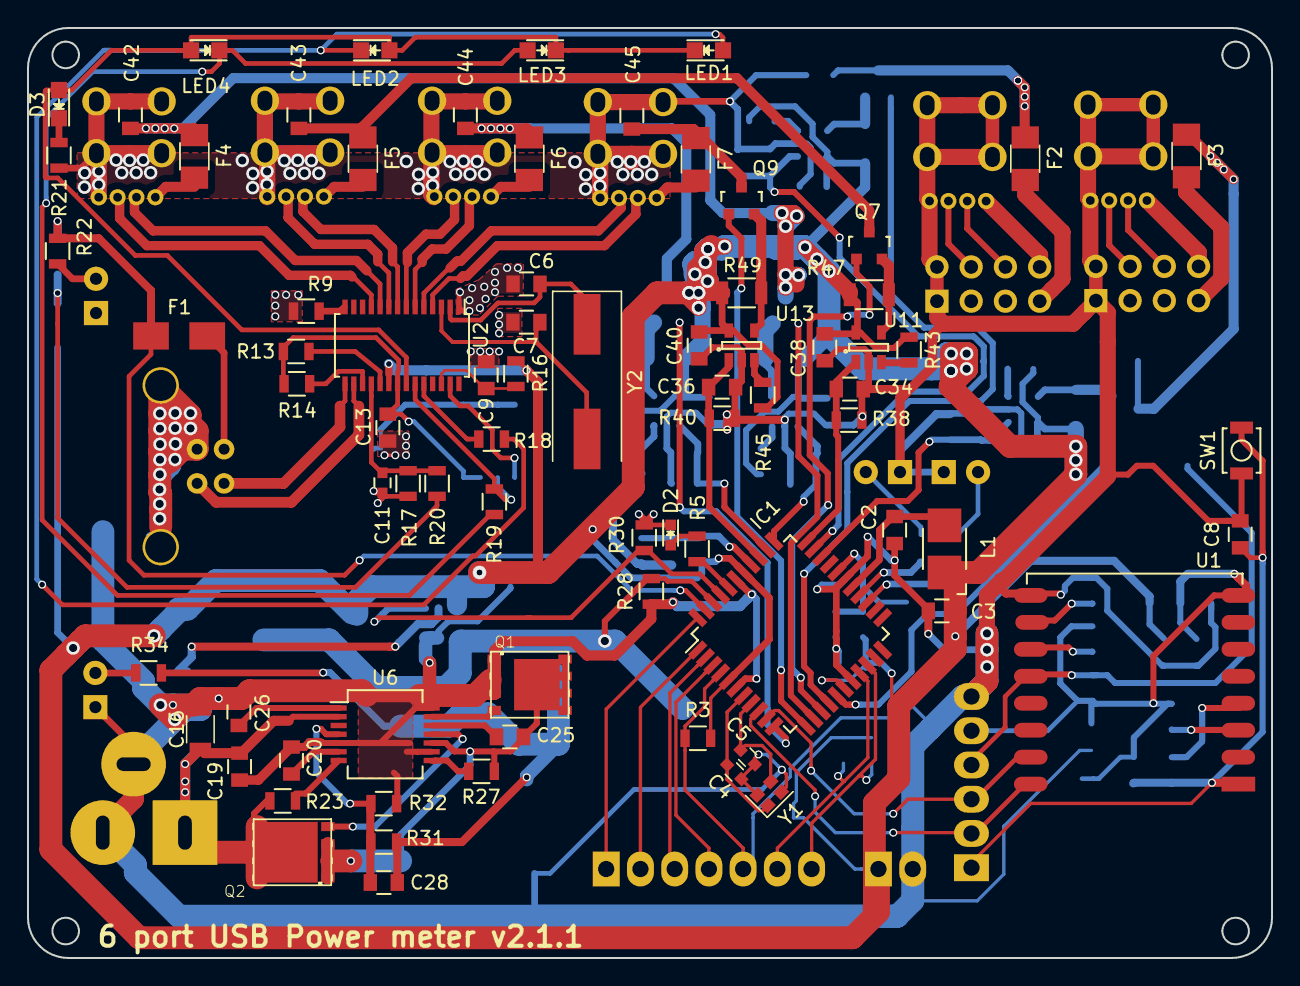
[picture p57: board Hardware/PCB/6xUSB_PowMet_new/6xUSB_PowMet.kicad_pcb from above]

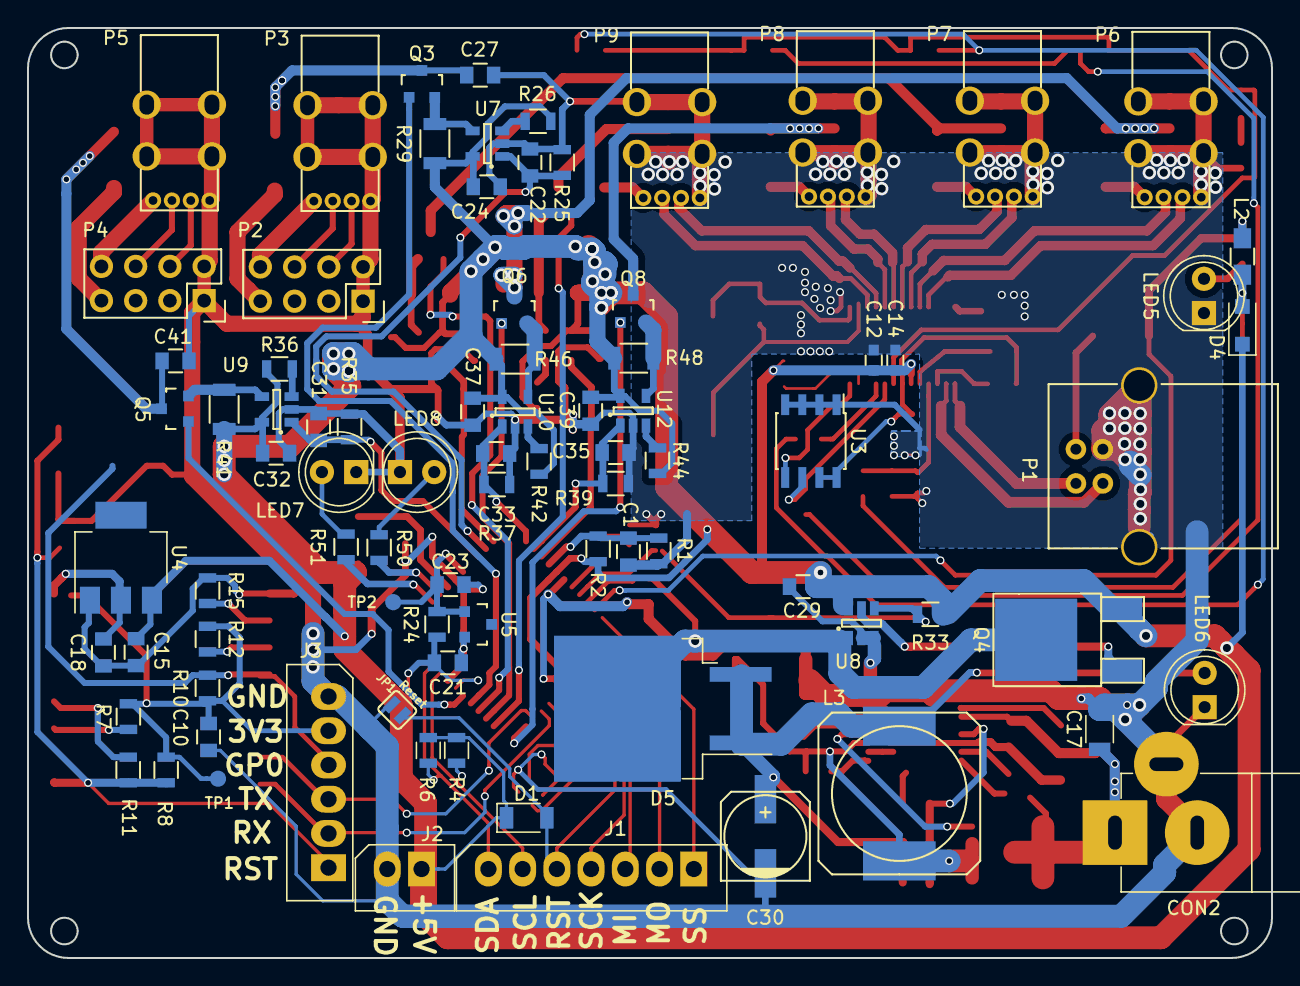
[picture p58: board Hardware/PCB/6xUSB_PowMet_new/6xUSB_PowMet.kicad_pcb from below]

Board: 2 copper layers, 92.3 x 69.0 mm, 161 parts (85 on the bottom side), 115 nets.
