aleksejm/6xUSB-Power-Meter/6xUSB_PowMet.kicad_pcb

## KiCad design 6xUSB_PowMet.kicad_pcb (2016-05-06)

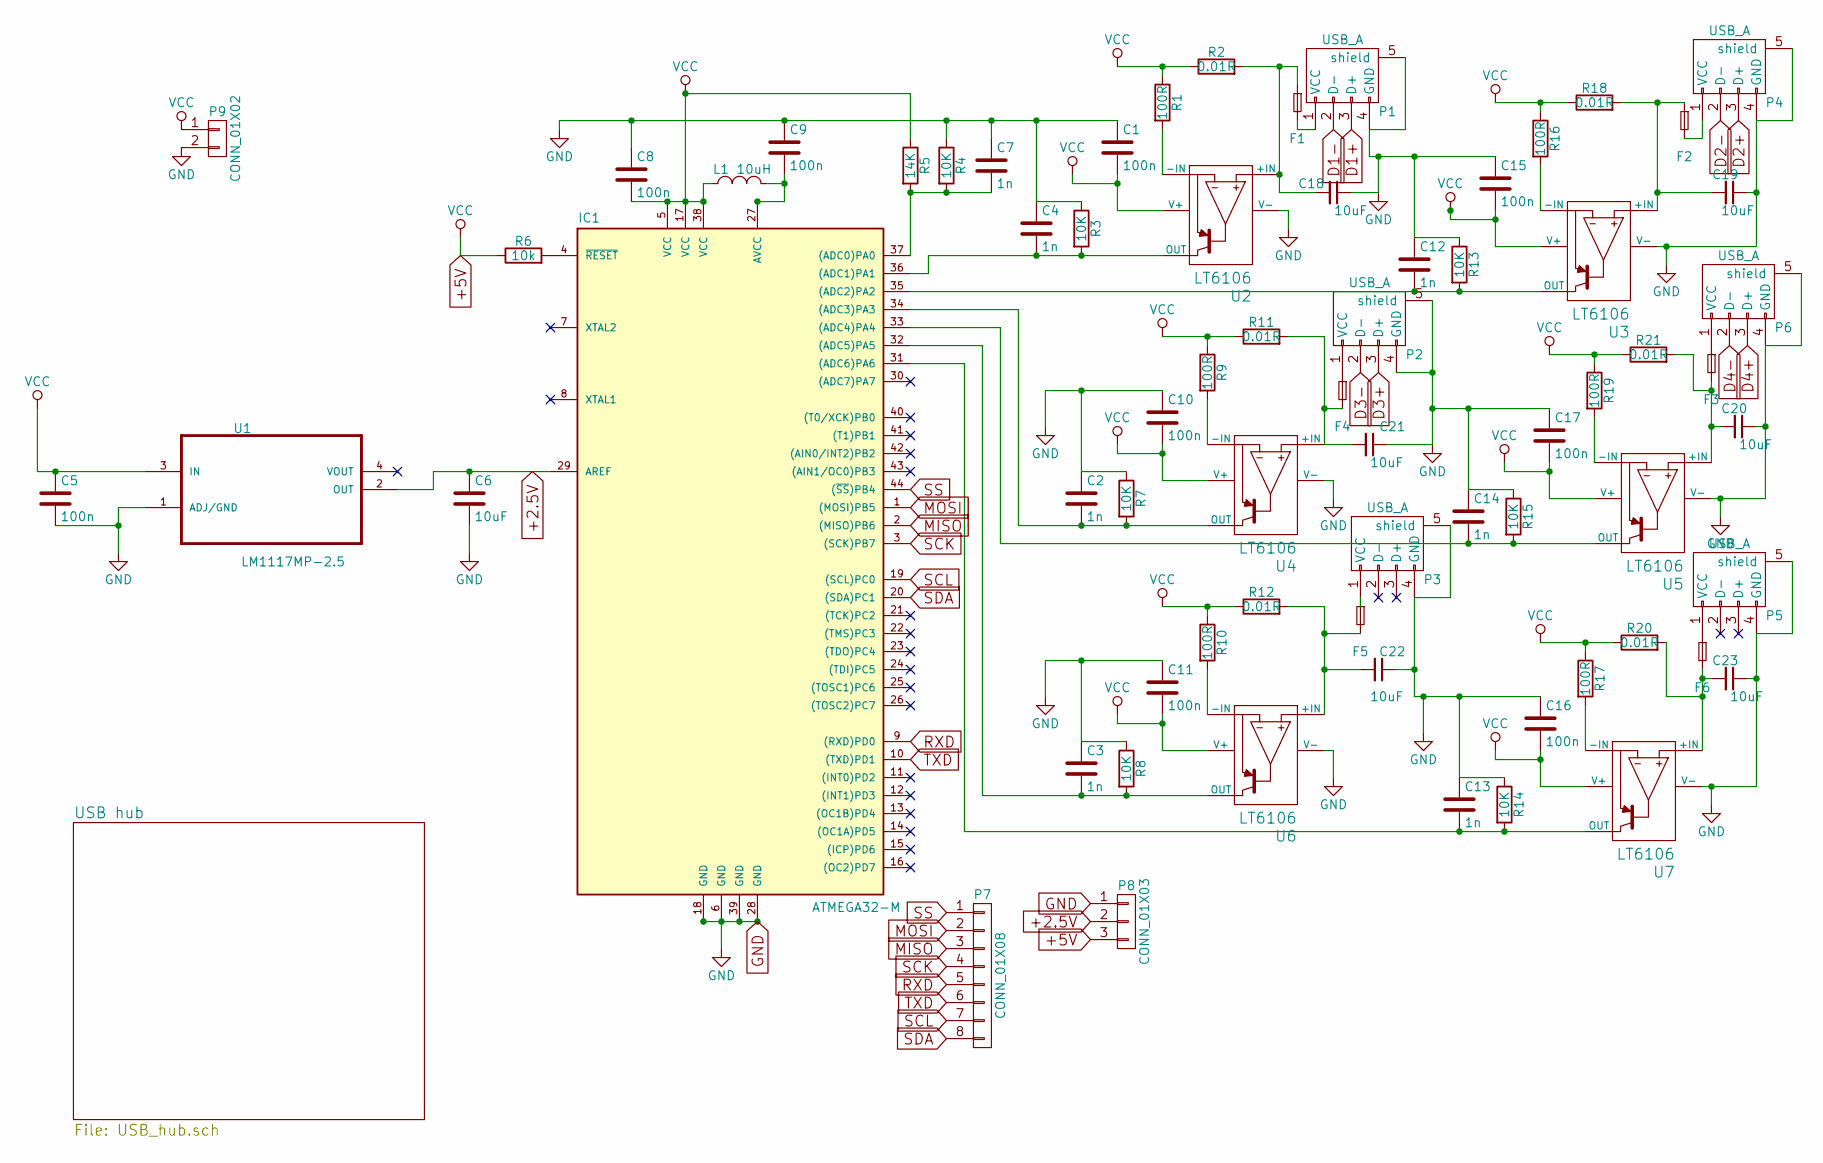
[picture p59: schematic 6xUSB_PowMet.sch]

Parts:
C1, C5, C8, C9, C10, C11, C15, C16, C17: 100n; C_0805
C2, C3, C4, C7, C12, C13, C14: 1n; C_0805
C6: 10uF; C_0805
C18, C19, C20, C21, C22, C23: 10uF; C_0805_HandSoldering
F1, F2, F3, F4, F5, F6: F_Small; Fuse_SMD1206_HandSoldering
IC1: ATMEGA32-M; TQFP-44_10x10mm_Pitch0.8mm
L1: 10uH; Resistor_Horizontal_RM15mm
P1, P2, P3, P4, P5, P6: USB_A; USB_A_Vertical
P7: CONN_01X08; Wafer_Vertical22.5x5.8x7RM2.5-8
P8: CONN_01X03; Wafer_Vertical10x5.8x7RM2.5-3
P9: CONN_01X02; BARREL_JACK
R1, R9, R10, R16, R17, R19: 100R; R_0805
R2, R11, R12, R18, R20, R21: 0.01R; R_0805
R3, R4, R7, R8, R13, R14, R15: 10K; R_0805
R5: 14K; R_0805
R6: 10k; R_0805
U1: LM1117MP-2.5; SOT-223
U2, U3, U4, U5, U6, U7: LT6106; SOT-23-5

Connections:
+2.5V: C6.1, IC1.29 (AREF), P8.2, U1.2 (OUT)
+5V: C1.2, C5.1, C8.2, C10.2, C11.2, C15.2, C16.2, C17.2, IC1.5 (VCC), IC1.17 (VCC), IC1.38 (VCC), L1.1, P8.3, P9.1, R1.1, R2.1, R5.1, R6.1, R9.1, R10.1, R11.1, R12.1, R16.1, R17.1, R18.1, R19.1, R20.1, R21.1, U1.3 (IN), U2.5 (V+), U3.5 (V+), U4.5 (V+), U5.5 (V+), U6.5 (V+), U7.5 (V+); also elsewhere on the board
D1+: P1.3 (D+); also elsewhere on the board
D1-: P1.2 (D-); also elsewhere on the board
D2+: P4.3 (D+); also elsewhere on the board
D2-: P4.2 (D-); also elsewhere on the board
D3+: P2.3 (D+); also elsewhere on the board
D3-: P2.2 (D-); also elsewhere on the board
D4+: P6.3 (D+); also elsewhere on the board
D4-: P6.2 (D-); also elsewhere on the board
GND: C1.1, C2.1, C3.1, C4.1, C5.2, C6.2, C7.1, C8.1, C9.1, C10.1, C11.1, C12.1, C13.1, C14.1, C15.1, C16.1, C17.1, C18.1, C19.1, C20.1, C21.1, C22.1, C23.1, IC1.6 (GND), IC1.18 (GND), IC1.28 (GND), IC1.39 (GND), P1.4 (GND), P1.5 (shield), P2.4 (GND), P2.5 (shield), P3.4 (GND), P3.5 (shield), P4.4 (GND), P4.5 (shield), P5.4 (GND), P5.5 (shield), P6.4 (GND), P6.5 (shield), P8.1, P9.2, R3.1, R4.1, R7.1, R8.1, R13.1, R14.1, R15.1, U1.1 (ADJ/GND), U2.2 (V-), U3.2 (V-), U4.2 (V-), U5.2 (V-), U6.2 (V-), U7.2 (V-); also elsewhere on the board
MISO: IC1.2 ((MISO)PB6), P7.3
MOSI: IC1.1 ((MOSI)PB5), P7.2
unnamed: C2.2, IC1.34 ((ADC3)PA3), R7.2, U4.1 (OUT)
unnamed: C3.2, IC1.32 ((ADC5)PA5), R8.2, U6.1 (OUT)
unnamed: C4.2, IC1.36 ((ADC1)PA1), R3.2, U2.1 (OUT)
unnamed: C7.2, IC1.37 ((ADC0)PA0), R4.2, R5.2
unnamed: C9.2, IC1.27 (AVCC), L1.2
unnamed: C12.2, IC1.35 ((ADC2)PA2), R13.2, U3.1 (OUT)
unnamed: C13.2, IC1.31 ((ADC6)PA6), R14.2, U7.1 (OUT)
unnamed: C14.2, IC1.33 ((ADC4)PA4), R15.2, U5.1 (OUT)
unnamed: C18.2, F1.1, R2.2, U2.4 (+IN)
unnamed: C19.2, F2.1, R18.2, U3.4 (+IN)
unnamed: C20.2, F3.2, R21.2, U5.4 (+IN)
unnamed: C21.2, F4.2, R11.2, U4.4 (+IN)
unnamed: C22.2, F5.2, R12.2, U6.4 (+IN)
unnamed: C23.2, F6.2, R20.2, U7.4 (+IN)
unnamed: F1.2, P1.1 (VCC)
unnamed: F2.2, P4.1 (VCC)
unnamed: F3.1, P6.1 (VCC)
unnamed: F4.1, P2.1 (VCC)
unnamed: F5.1, P3.1 (VCC)
unnamed: F6.1, P5.1 (VCC)
unnamed: IC1.4 (~RESET), R6.2
unnamed: R1.2, U2.3 (-IN)
unnamed: R9.2, U4.3 (-IN)
unnamed: R10.2, U6.3 (-IN)
unnamed: R16.2, U3.3 (-IN)
unnamed: R17.2, U7.3 (-IN)
unnamed: R19.2, U5.3 (-IN)
RXD: IC1.9 ((RXD)PD0), P7.5
SCK: IC1.3 ((SCK)PB7), P7.4
SCL: IC1.19 ((SCL)PC0), P7.7
SDA: IC1.20 ((SDA)PC1), P7.8
SS: IC1.44 ((~SS~)PB4), P7.1
TXD: IC1.10 ((TXD)PD1), P7.6

Schematic: USB_hub.sch

Parts:
C24, C25: 4.7uF; C_0805_HandSoldering
C26, C27: 10pF; C_0805_HandSoldering
C28, C30, C31: 10uF; C_0805_HandSoldering
C29: 10nF; C_0805_HandSoldering
D1: Power; LED-5MM
D2, D3, D4, D5, D6: Led_Small; LED-5MM
D7: 5.1V; SMC_Standard
F7: F_Small; Fuse_SMD1206_HandSoldering
P10: USB_B
R22, R23, R24, R25: 330; R_0805_HandSoldering
R26, R27, R28, R30: 10K; R_0805_HandSoldering
R29: 2.7K; R_0805_HandSoldering
U8: AP1117E33; SOT89-3_Housing_Handsoldering
U9: FE1.1s; SSOP-28_5.3x10.2mm_Pitch0.65mm
Y1: 12Mhz; Crystal_HC49-SD_SMD

Connections:
+5V: C24.2, C29.1, C30.1, D7.1 (K), F7.1, F7.2, P10.1, R22.1, R26.1, R27.1, R28.1, U8.3 (VI), U9.20 (VDD5); also elsewhere on the board
/USB hub/1V8: C31.1, U9.12 (VD18_O), U9.28 (VD18)
/USB hub/3V3: C25.1, C28.2, U8.2 (VO), U9.13 (VD33), U9.21 (VD33_O)
D1+: U9.11 (DP1); also elsewhere on the board
D1-: U9.10 (DM1); also elsewhere on the board
D2+: U9.9 (DP2); also elsewhere on the board
D2-: U9.8 (DM2); also elsewhere on the board
D3+: U9.7 (DP3); also elsewhere on the board
D3-: U9.6 (DM3); also elsewhere on the board
D4+: U9.5 (DP4); also elsewhere on the board
D4-: U9.4 (DM4); also elsewhere on the board
D5+: P10.3, U9.16 (DPU)
D5-: P10.2, U9.15 (DMU)
GND: C24.1, C25.2, C28.1, C29.2, C30.2, C31.2, D1.1 (K), D7.2 (A), P10.4, P10.5, R25.2, R29.2, R30.1, U8.1 (GND/ADJ); also elsewhere on the board
unnamed: C26.1, C27.1, U9.1 (VSS)
unnamed: C26.2, U9.2 (XOUT), Y1.1
unnamed: C27.2, U9.3 (XIN), Y1.2
unnamed: D1.2 (A), R22.2
unnamed: D2.1 (K), D3.2 (A), D4.1 (K), D5.2 (A), D6.2 (A), U9.22 (DRV)
unnamed: D2.2 (A), D3.1 (K), R23.1
unnamed: D4.2 (A), D5.1 (K), R24.1
unnamed: D6.1 (K), R25.1
unnamed: R23.2, U9.24 (LED2)
unnamed: R24.2, U9.23 (LED1/EESCL)
unnamed: R26.2, U9.26 (OVCJ)
unnamed: R27.2, U9.19 (BUSJ)
unnamed: R28.2, U9.17 (XRSTJ)
unnamed: R29.1, U9.14 (REXT)
unnamed: R30.2, U9.18 (VBUSM)

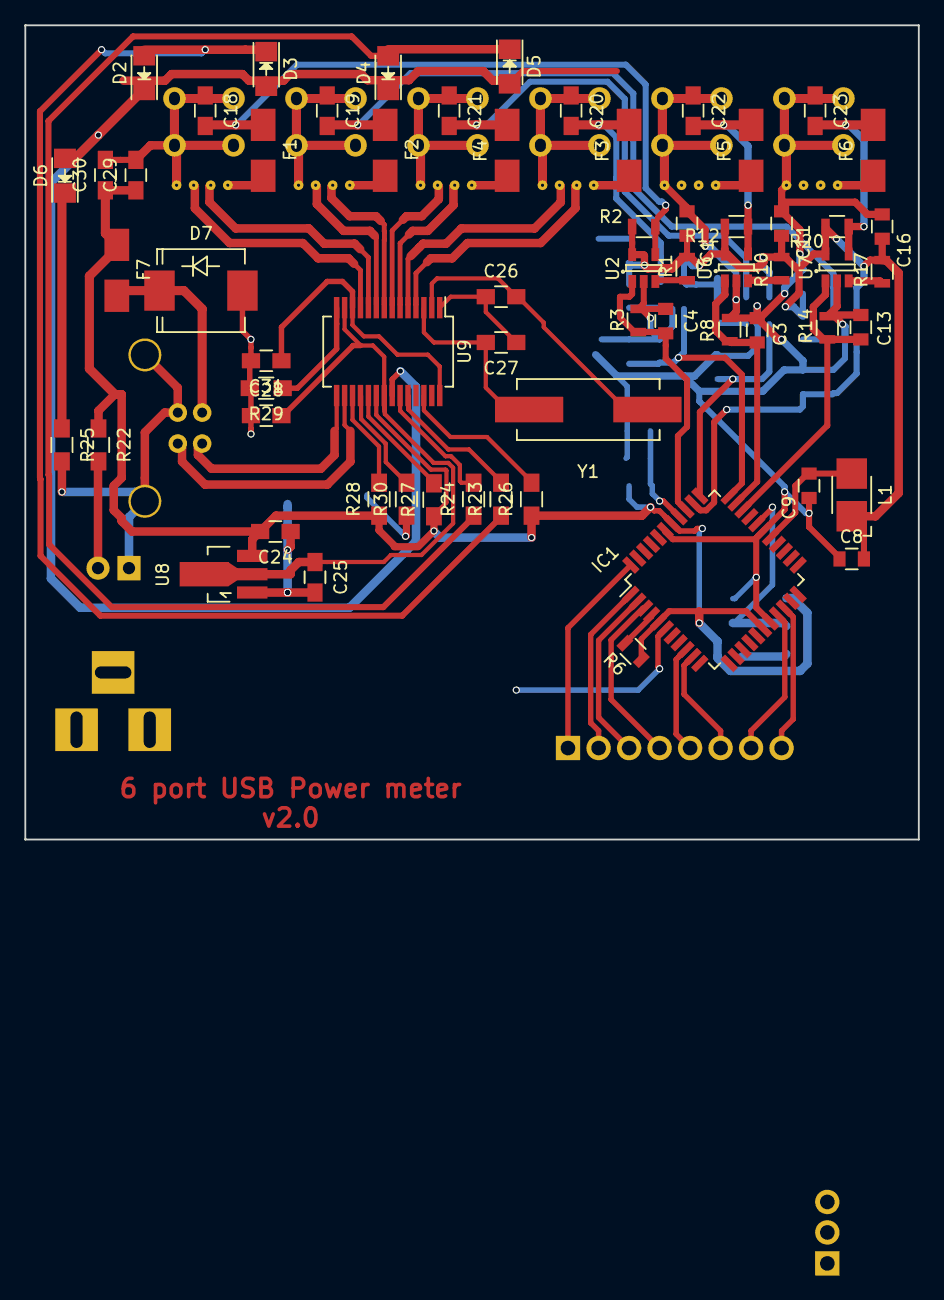
[picture p60: board 6xUSB_PowMet.kicad_pcb from above]

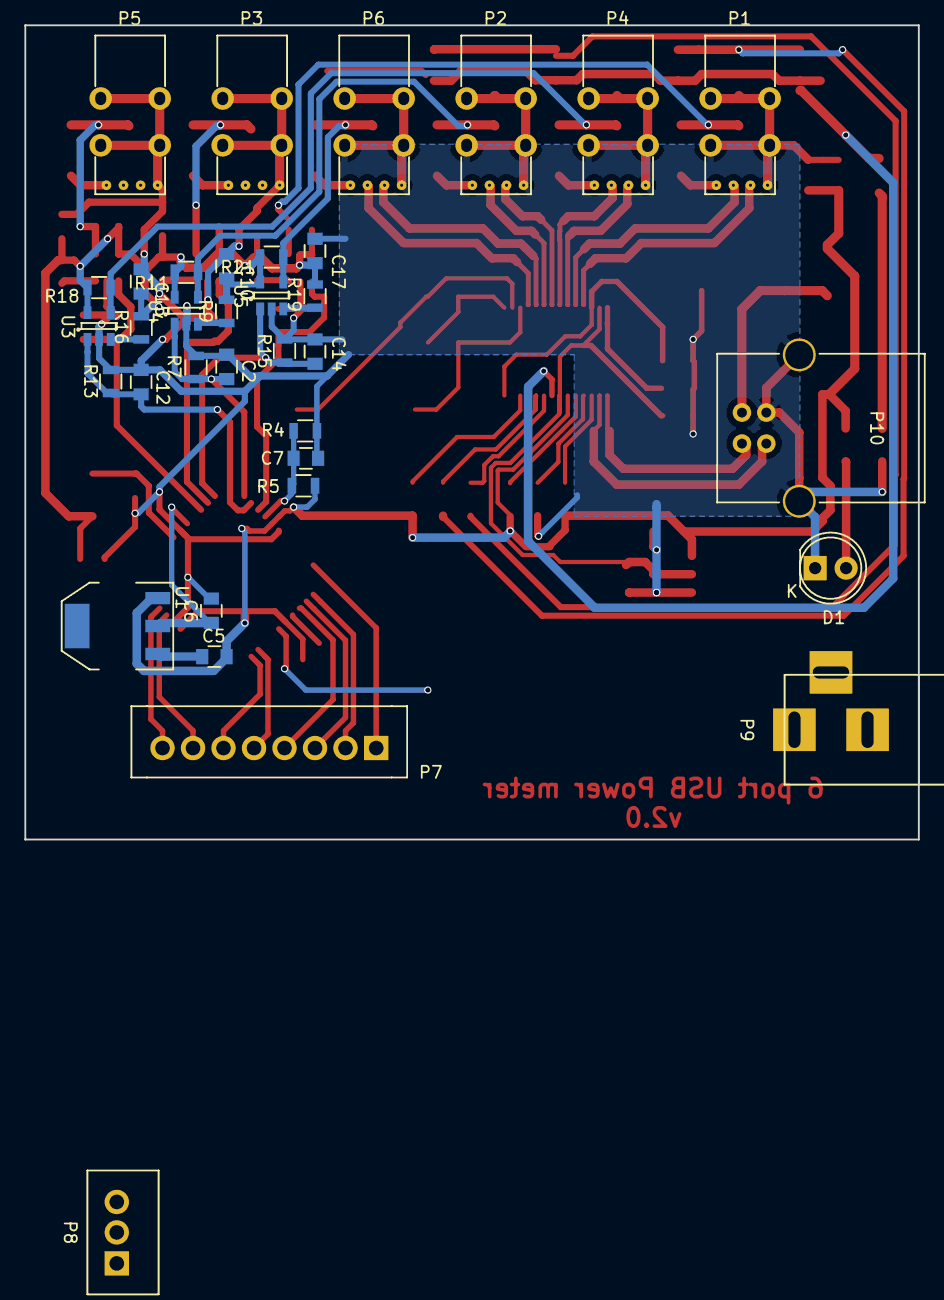
[picture p61: board 6xUSB_PowMet.kicad_pcb from below]

Board: 2 copper layers, 73.2 x 66.8 mm, 97 parts (35 on the bottom side), 65 nets.
