aleksejm/6xUSB-Power-Meter/ESP-12-breakout-master/ESP12E-breakout.kicad_pcb

## KiCad design ESP-12-breakout-master/ESP12E-breakout.kicad_pcb (2019-04-29)

Schematic: ESP12E-breakout.sch

Parts:
C1: 10uF; C_0805
C2: 100uF; C_0805
D1: LED; LED-0805
P1: CONN_01X10; Pin_Header_Straight_1x10
P2: Logo; 3k5
P3: CONN_01X08; Pin_Header_Straight_1x08
P4: OSHW logo; oshw-logo-kicad-copper-10mm
R1, R2, R3, R4, R5, R6: 10K; R_0805_HandSoldering
SW1: RESET; smd_push
SW2: FLASH; smd_push
U1: ESP-12E
U2: AP1117; SOT-223_edit

Connections:
/0: P3.5, R3.1, SW2.1, U1.18
/2: P3.6, R4.1, U1.17
/3V3: C2.1, P1.8, R1.2, R2.2, R3.2, R4.2, R6.2, U1.8, U2.2 (VO)
/4: P3.4, U1.19
/5: P3.3, U1.20
/5V: C1.1, P1.9, U2.3 (VI)
/12: P1.6, U1.6
/13: P1.7, U1.7
/14: P1.5, U1.5
/15: P3.7, R5.2, U1.16
/16: P1.4, U1.4
/ADC: P1.2, U1.2
/CH_PD: P1.3, R2.1, U1.3
/RESET: P1.1, R1.1, SW1.2, U1.1
/RX: P3.2, U1.21
/TX: P3.1, U1.22
GND: C1.2, C2.2, D1.1, P1.10, P3.8, R5.1, SW1.1, SW2.2, U1.15, U2.1 (GND/ADJ)
unnamed: D1.2, R6.1

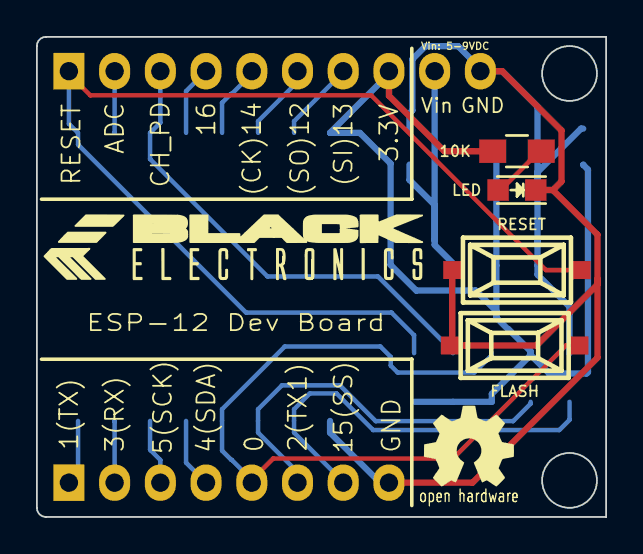
[picture p62: board ESP12E-breakout.kicad_pcb from above]

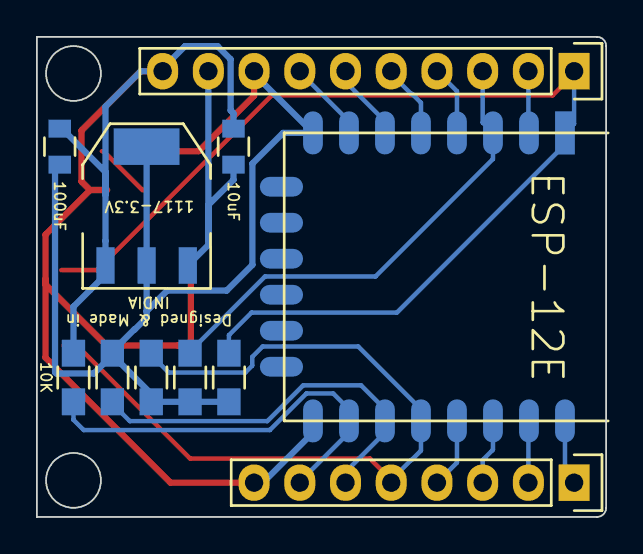
[picture p63: board ESP12E-breakout.kicad_pcb from below]

Board: 2 copper layers, 31.6 x 26.7 mm, 17 parts (11 on the bottom side), 18 nets.
