aleksejm/6xUSB-Power-Meter/Hardware/Webench desing for eagle/webench_schematic_exchange_design_4493365_25_Eagle/Eagle/2017-07-22_13-20-53/2017-07-22_13-20-53.brd

## EAGLE design Hardware/Webench desing for eagle/webench_schematic_exchange_design_4493365_25_Eagle/Eagle/2017-07-22_13-20-53/2017-07-22_13-20-53.brd (2019-04-29)

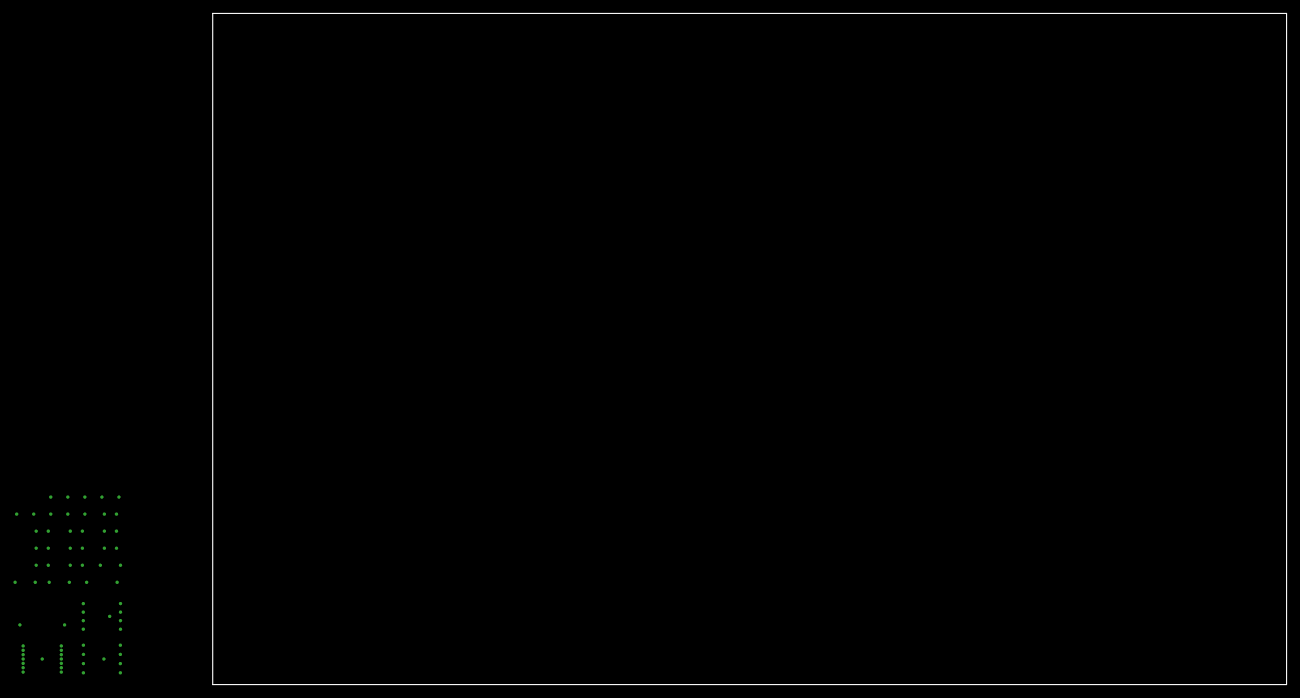
[picture p64: board 2017-07-22_13-20-53.brd from above]

Board: 2 copper layers, 160.0 x 100.0 mm, 27 parts (0 on the bottom side), 12 nets, no tracks yet.

Parts:
CBST: 470nF; 0805
CBYP: 100nF; 0805
CFF: 1nF; 0805
CIN: 47uF; 1206
CIN_2, CIN_3: 47uF; 1206
COUT: 330uF; SM_RADIAL_6.3AMM
CSS: 15nF; 0805
CVCC: 1uF; 0805
GND1, GND2, GND3, GND4, GND5, GND6, GND7, GND8: WB_GND
IOUT_1: WB_CURRENT_LOAD
L1: 4.7uH; XAL1010
M1: 25V; TRANS_NEXFET_Q5
M2: 40V; TRANS_NEXFET_Q5B
RFB1: 10k; 0805
RFB2: 73.2k; 0805
RILIM: 464; 0805
RON: 237k; 0805
U1: LM3150MH/NOPB; MXA14A
VIN: WB_BATTERY

Connections:
0: CBYP.2, CIN.2, CIN_2.2, CIN_3.2, COUT.2, CSS.2, CVCC.2, GND1.1, GND2.1, GND3.1, GND4.1, GND5.1, GND6.1, GND7.1, GND8.1, IOUT_1.2, M2.1, M2.2, M2.3, RFB1.2, U1.5, U1.9, U1.14, U1.15, VIN.2
1: CSS.1, U1.6
2: CBYP.1, CIN.1, CIN_2.1, CIN_3.1, M1.5, M1.6, M1.7, M1.8, M1.9, RON.1, U1.2, VIN.1
3: RON.2, U1.7
4: CFF.1, COUT.1, IOUT_1.1, L1.2, RFB2.1
5: CFF.2, RFB1.1, RFB2.2, U1.4
6: CBST.2, L1.1, M1.1, M1.2, M1.3, M2.5, M2.6, M2.7, M2.8, M2.9, RILIM.1, U1.10
7: M2.4, U1.13
8: M1.4, U1.11
9: CBST.1, U1.12
10: CVCC.1, U1.1
11: RILIM.2, U1.8
