aleksejm/6xUSB-Power-Meter/arduino-micro-reference-design/Micro_Rev1j.brd

## EAGLE design arduino-micro-reference-design/Micro_Rev1j.brd (2019-04-29)

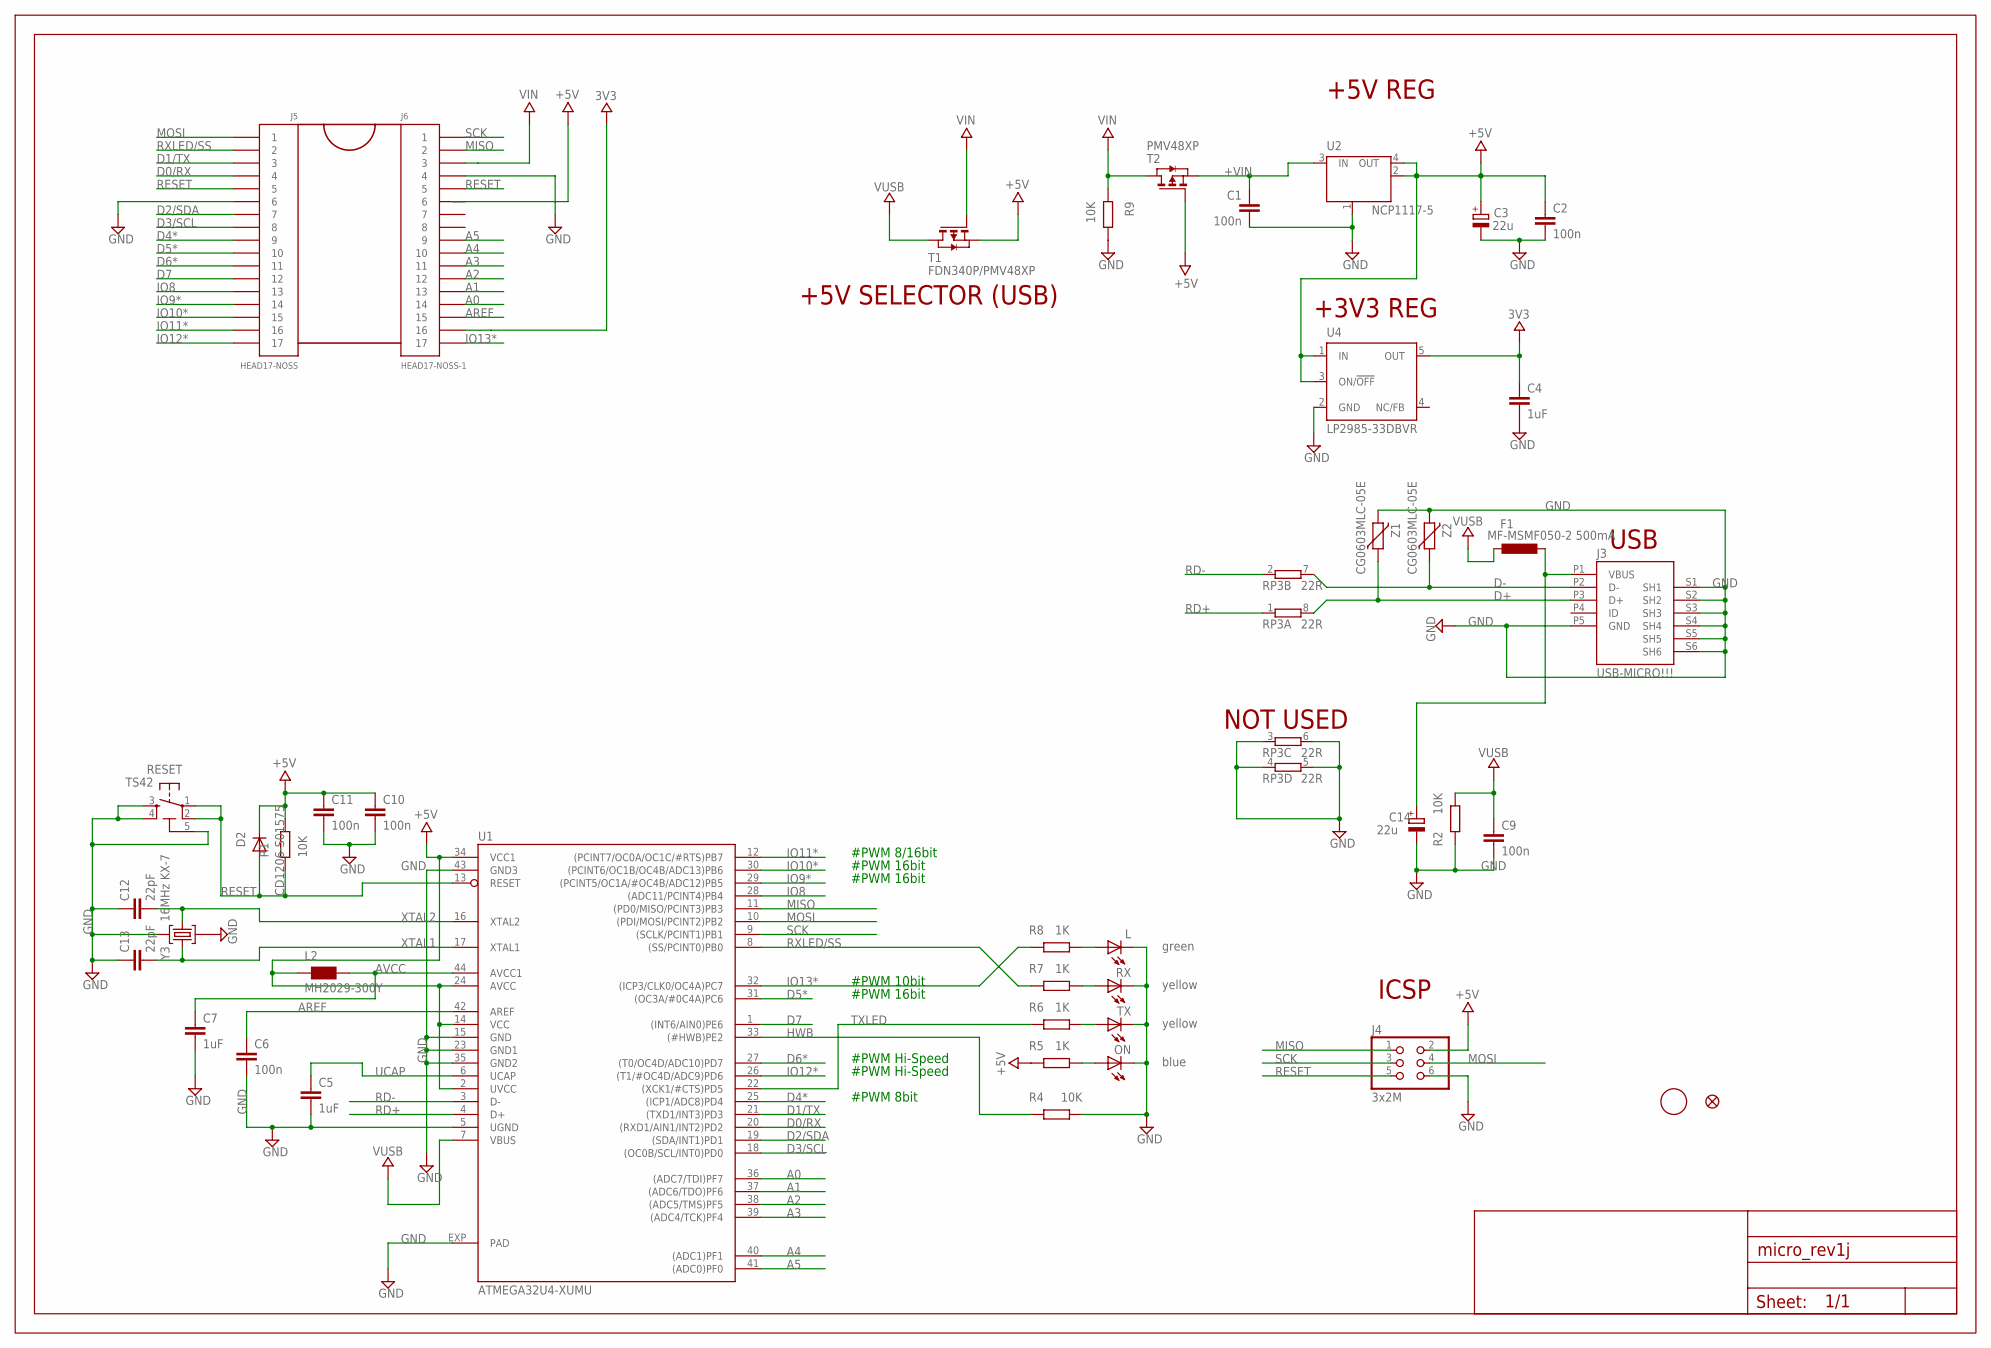
[picture p65: schematic Micro_Rev1j.sch]

Parts:
C1, C2, C6, C9, C10, C11: 100n; C0402
C3, C14: 22u; SMC_B
C4, C5, C7: 1uF; C0402
C12, C13: 22pF; C0402
D2: CD1206-S01575; MINIMELF
F1: MF-MSMF050-2 500mA; L1812
FRAME1: DNP; FRAME
J3: USB-MICRO!!!; CON2_USB_MICRO_B_AT
J4: 3x2M; 2X03
J5: HEAD17-NOSS
J6: HEAD17-NOSS-1
L: green; CHIPLED_0805
L2: MH2029-300Y; 0805
ON: blue; CHIPLED_0805
R1, R2, R4, R9: 10K; R0402
R5, R6, R7, R8: 1K; R0402
RESET: TS42
RP3: 22R; CAY16
RX: yellow; CHIPLED_0805
T1: FDN340P/PMV48XP; SOT-23
T2: PMV48XP; SOT-23
TX: yellow; CHIPLED_0805
U1: ATMEGA32U4-XUMU; QFN44ML7X7
U2: NCP1117-5; SOT223
U4: LP2985-33DBVR; SOT23-DBV
U$37: FIDUCIALMOUNT; FIDUCIA-MOUNT
U$53: FIDUCIAL1X2; FIDUCIAL-1X2
Y3: 16MHz KX-7; CRYSTAL-3.2-2.5
Z1, Z2: CG0603MLC-05E; CT/CN0603

Connections:
3V3: C4.1, J6.16, U4.5 (OUT)
+5V: C2.1, C3.+, C10.1, C11.1, D2.C, J4.2, J6.6, L2.1, R1.1, R5.1, T1.2 (S), T2.3 (G), U1.2 (UVCC), U1.14 (VCC), U1.24 (AVCC), U1.34 (VCC1), U2.2 (OUT), U2.4 (OUT), U4.1 (IN), U4.3 (ON/!OFF)
+VIN: C1.1, T2.2 (S), U2.3 (IN)
A0: J6.14, U1.36 ((ADC7/TDI)PF7)
A1: J6.13, U1.37 ((ADC6/TDO)PF6)
A2: J6.12, U1.38 ((ADC5/TMS)PF5)
A3: J6.11, U1.39 ((ADC4/TCK)PF4)
A4: J6.10, U1.40 ((ADC1)PF1)
A5: J6.9, U1.41 ((ADC0)PF0)
AREF: C6.1, J6.15, U1.42 (AREF)
AVCC: C7.1, L2.2, U1.44 (AVCC1)
D0/RX: J5.4, U1.20 ((RXD1/AIN1/INT2)PD2)
D1/TX: J5.3, U1.21 ((TXD1/INT3)PD3)
D2/SDA: J5.7, U1.19 ((SDA/INT1)PD1)
D3/SCL: J5.8, U1.18 ((OC0B/SCL/INT0)PD0)
D4*: J5.9, U1.25 ((ICP1/ADC8)PD4)
D5*: J5.10, U1.31 ((OC3A/#0C4A)PC6)
D6*: J5.11, U1.27 ((T0/OC4D/ADC10)PD7)
D7: J5.12, U1.1 ((INT6/AIN0)PE6)
D+: J3.P3 (D+), RP3.8 (2), Z1.1
D-: J3.P2 (D-), RP3.7 (2), Z2.1
GND: C1.2, C2.2, C3.-, C4.2, C5.2, C6.2, C7.2, C9.2, C10.2, C11.2, C12.1, C13.1, C14.-, J3.P5 (GND), J3.S1 (SH1), J3.S2 (SH2), J3.S3 (SH3), J3.S4 (SH4), J3.S5 (SH5), J3.S6 (SH6), J4.6, J5.6, J6.4, L.C, ON.C, R2.1, R4.2, R9.1, RESET.3, RESET.4, RESET.5 (5-GND), RP3.3 (1), RP3.4 (1), RP3.5 (2), RP3.6 (2), RX.C, TX.C, U1.5 (UGND), U1.15 (GND), U1.23 (GND1), U1.35 (GND2), U1.43 (GND3), U1.EXP (PAD), U2.1 (GND/ADJ), U4.2 (GND), Y3.2 (GND), Y3.4 (GND), Z1.2, Z2.2
HWB: R4.1, U1.33 ((#HWB)PE2)
IO8: J5.13, U1.28 ((ADC11/PCINT4)PB4)
IO9*: J5.14, U1.29 ((PCINT5/OC1A/#OC4B/ADC12)PB5)
IO10*: J5.15, U1.30 ((PCINT6/OC1B/OC4B/ADC13)PB6)
IO11*: J5.16, U1.12 ((PCINT7/OC0A/OC1C/#RTS)PB7)
IO12*: J5.17, U1.26 ((T1/#OC4D/ADC9)PD6)
IO13*: J6.17, R8.1, U1.32 ((ICP3/CLK0/OC4A)PC7)
MISO: J4.1, J6.2, U1.11 ((PD0/MISO/PCINT3)PB3)
MOSI: J4.4, J5.1, U1.10 ((PDI/MOSI/PCINT2)PB2)
unnamed: R7.2, RX.A
unnamed: ON.A, R5.2
unnamed: R6.2, TX.A
unnamed: L.A, R8.2
RD+: RP3.1, U1.4 (D+)
RD-: RP3.2 (1), U1.3 (D-)
RESET: D2.A, J4.5, J5.5, J6.5, R1.2, RESET.1, RESET.2, U1.13 (RESET)
RXLED/SS: J5.2, R7.1, U1.8 ((SS/PCINT0)PB0)
SCK: J4.3, J6.1, U1.9 ((SCLK/PCINT1)PB1)
TXLED: R6.1, U1.22 ((XCK1/#CTS)PD5)
UCAP: C5.1, U1.6 (UCAP)
VIN: J6.3, R9.2, T1.3 (G), T2.1 (D)
VUSB: C9.1, F1.2, R2.2, T1.1 (D), U1.7 (VBUS)
VUSBD: C14.+, F1.1, J3.P1 (VBUS)
XTAL1: C13.2, U1.17 (XTAL1), Y3.3 (C2)
XTAL2: C12.2, U1.16 (XTAL2), Y3.1 (C1)

Notes on the sheet:
+5V REG
ICSP
USB
+5V SELECTOR (USB)
NOT USED
+3V3 REG
#PWM 8bit
#PWM Hi-Speed
#PWM 16bit
#PWM 10bit
#PWM 8/16bit

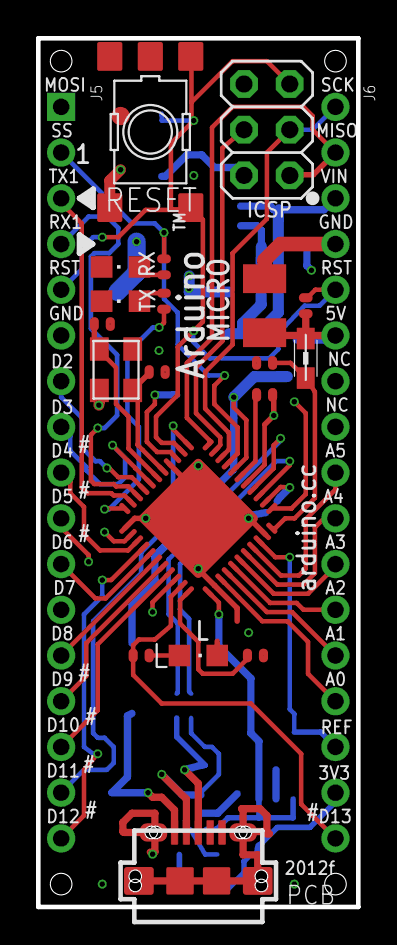
[picture p66: board Micro_Rev1j.brd from above]

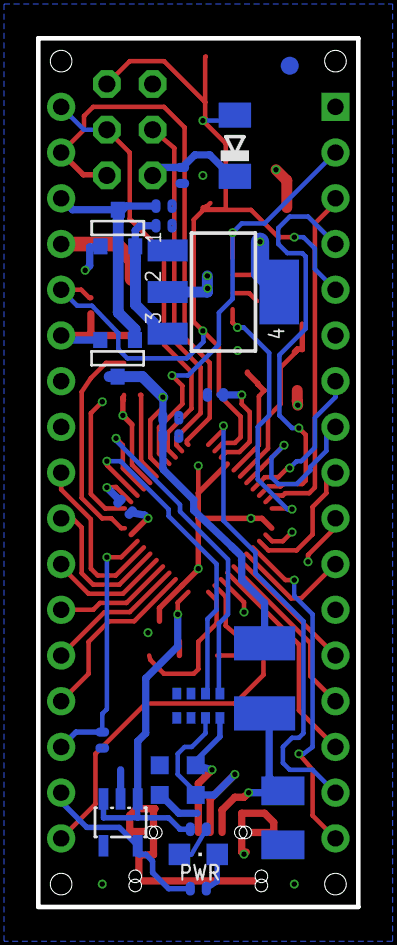
[picture p67: board Micro_Rev1j.brd from below]

Board: 4 copper layers, 17.8 x 48.3 mm, 45 parts (22 on the bottom side), 47 nets.
