aleksejm/6xUSB-Power-Meter/Hardware/Webench desing for eagle/webench_board_exchange_design_4493365_25_Eagle/Eagle/2017-07-22_13-21-48/2017-07-22_13-21-48.brd

## EAGLE design Hardware/Webench desing for eagle/webench_board_exchange_design_4493365_25_Eagle/Eagle/2017-07-22_13-21-48/2017-07-22_13-21-48.brd (2019-04-29)

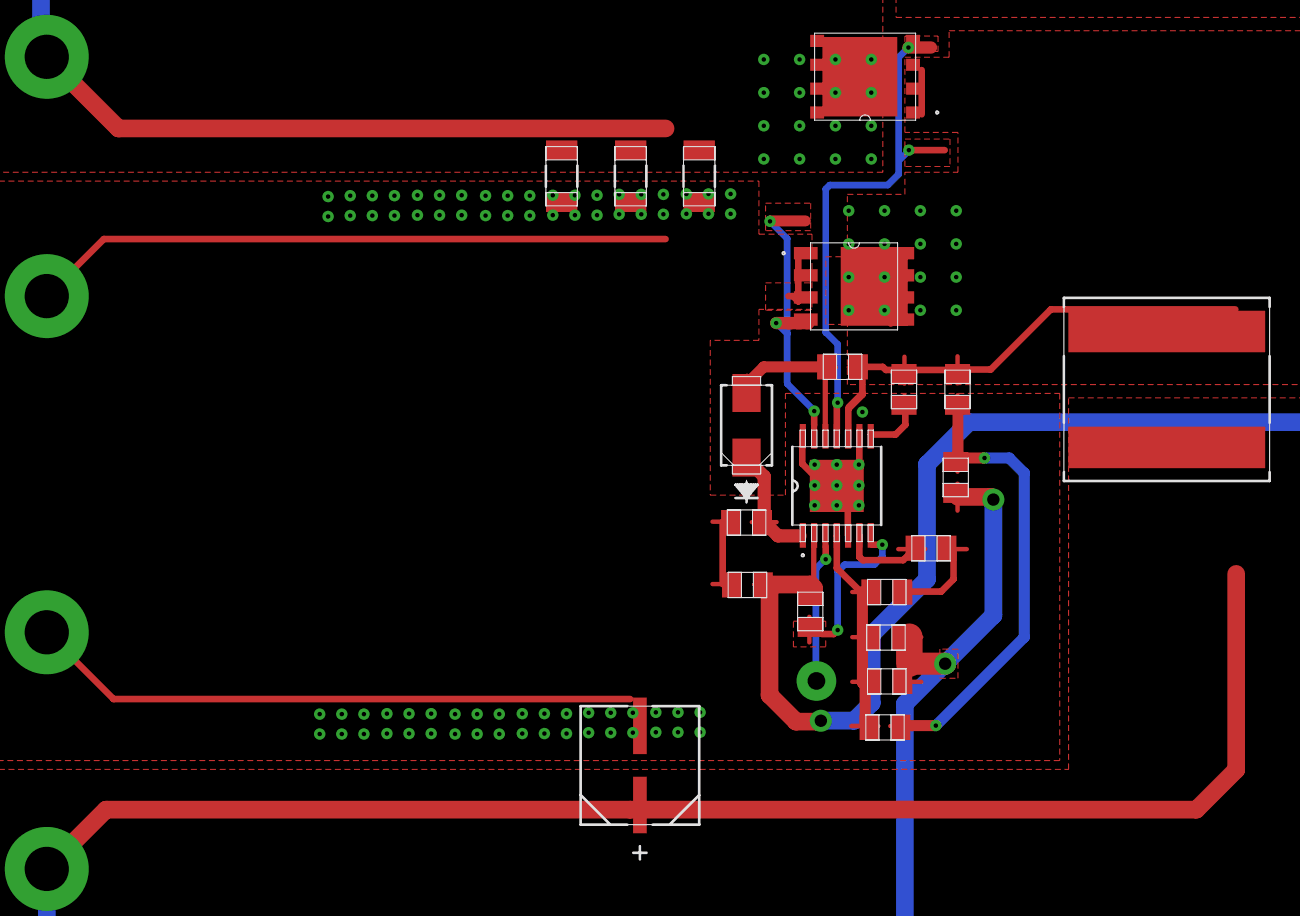
[picture p68: board 2017-07-22_13-21-48.brd from above]

Board: 4 copper layers, 26 parts (0 on the bottom side), 14 nets.

Parts:
CAC: 0805
CBST: 0805
CBYP: 0805
CFF: 0805
CIN_1, CIN_2, CIN_3: 1206
COUT: SM_RADIAL_6.3AMM
CR: 0805
CSS: 0805
CVCC: 0805
DBST: SMA
EN: TP-1502
GND, GND1: TP-1502
L1: XAL1010
M1: TRANS_NEXFET_Q5
M2: TRANS_NEXFET_Q5B
RFB1, RFB2: 0805
RLIM: 0805
RON: 0805
RR: 0805
U1: MXA14A
VIN: TP-1502
VOUT: TP-1502

Connections:
0: CBYP.2, CIN_1.2, CIN_2.2, CIN_3.2, COUT.2, CSS.2, CVCC.2, GND.1, GND1.1, M2.1, M2.2, M2.3, RFB1.2, U1.5, U1.9, U1.14, U1.15
1: CSS.1, U1.6
2: CBYP.1, CIN_1.1, CIN_2.1, CIN_3.1, M1.5, M1.6, M1.7, M1.8, M1.9, RON.1, U1.2, VIN.1
3: RON.2, U1.7
4: CFF.1, COUT.1, CR.2, L1.2, RFB2.1, VOUT.1
5: CAC.1, CFF.2, RFB1.1, RFB2.2, U1.4
6: CBST.2, L1.1, M1.1, M1.2, M1.3, M2.5, M2.6, M2.7, M2.8, M2.9, RLIM.1, RR.2, U1.10
7: M2.4, U1.13
8: M1.4, U1.11
9: CBST.1, DBST.2, U1.12
10: CVCC.1, DBST.1, U1.1
11: RLIM.2, U1.8
18: EN.1, U1.3
25: CAC.2, CR.1, RR.1
