aleksejm/6xUSB-Power-Meter/Hardware/TXLine/txline.ini

[Microstrip Line]
Phys Length Unit=4
Length=0.0074871834
Width=0.0012469
Width Unit=0
Height=0.000254
Height Unit=4
Thickness=1e-06
Thickness Unit=0
[Material Parameter]
Diel Constant=4.5
Loss Tangent=0.02
Conductivity=58800000
Conductivity Unit=3
[Coupled Microstrip Line]
Phys Length Unit=1
Length=0.015
Width=0.0007
Width Unit=1
Gap=0.0004
Gap Unit=1
Height=0.05
Height Unit=1
Thickness=0.0002032
Thickness Unit=1
[Slot Line]
Phys Length Unit=4
Length=0.0062014862
Gap=7.4204068e-05
Gap Unit=4
Height=0.0002032
Height Unit=4
[Strip Line]
Phys Length Unit=4
Length=0.0074871834
Width=5e-05
Width Unit=0
Height=0.000100000054
Height Unit=4
Thickness=1e-06
Thickness Unit=0
[CPW Line]
Phys Length Unit=4
Length=0.0074871834
Width=5e-05
Width Unit=0
Gap=1.00000054e-05
Gap Unit=4
Height=0.0001
Height Unit=0
Thickness=1e-06
Thickness Unit=0
[Grounded CPW Line]
Phys Length Unit=4
Length=0.0074871834
Width=5e-05
Width Unit=0
Gap=1.00000054e-05
Gap Unit=4
Height=0.0001
Height Unit=0
Thickness=1e-06
Thickness Unit=0
[Coupled Strip Line]
Phys Length Unit=4
Length=0.0074871834
Width=5e-05
Width Unit=0
Gap=4.99999e-05
Gap Unit=4
Height=0.0001
Height Unit=0
Thickness=1e-06
Thickness Unit=0
[Coax Line]
Phys Length Unit=4
Length=0.0062014862
Inner diameter=0.000100000054
Inner diameter Unit=4
Outer diameter=0.000499999
Outer diameter Unit=4
