aleksejm/6xUSB-Power-Meter/ER-TFTM024-3(4-Wire-SPI)_TP_SD_FONT_FLASH/9341TP.h

//=============================================================
//Define lcd io
sbit CS=P1^0;		//chip select when low
sbit RS=P1^1;		//high :data  low:command    
sbit SCL=P1^7;		//SERIAL CLOCK INPUT    
sbit SDI=P1^5;	     //SERIAL DATA INPUT   
sbit SDO=P1^6;	     //SERIAL DATA OUTPUT  
sbit RES=P3^7;		//reset
sbit BL_ON=P3^0;    //Blacklight Control     H:ON   L:OFF

//====================================================//

void ILI9341_Initial(void);
void Write_Cmd_Data(unsigned char x);
void Write_Cmd(unsigned char DL);
void Write_Data(unsigned char DH,unsigned char DL);
void delayms(unsigned int tt);
void  Write_Data_U16(unsigned int y);
static void LCD_SetPos(unsigned char x0,unsigned char x1,unsigned  int y0,unsigned int y1);
void ClearScreen(unsigned int bColor);
void LCD_FULL(unsigned int i);


unsigned int code pic[];

//===============================================================
// all display one colour
void ClearScreen(unsigned int bColor)
{
 unsigned int i,j;
 LCD_SetPos(0,239,0,319);//320x240
 for (i=0;i<320;i++)
	{
	
	   for (j=0;j<240;j++)
	       Write_Data_U16(bColor);
	}
}


//===============================================================
//write parameter
void  Write_Cmd_Data (unsigned char CMDP)
{ unsigned char i;
 	 
    CS=0;
   	RS=1;
    for(i=0;i<8;i++)
     {  SCL=0;
        if(CMDP&0x80) SDI=1;
       	else SDI=0;
       	SCL=1;
        CMDP=CMDP<<1;
     }
   	CS=1;

}


//==============================================================
//write  data word
void  Write_Data_U16(unsigned int y)
{
	unsigned char m,n;
	m=y>>8;
	n=y;
	Write_Data(m,n);

}
//=============================================================
//write command

void Write_Cmd(unsigned char CMD)
{ unsigned char i;
 	 
    CS=0;
   	RS=0;
    for(i=0;i<8;i++)
     {  SCL=0;
        if(CMD&0x80) SDI=1;
       	else SDI=0;
       	SCL=1;
        CMD=CMD<<1;
     }
   	CS=1;


}

//===================================================================
//write data byte

void Write_Data(unsigned char DH,unsigned char DL)
{unsigned char i;
 	 
    CS=0;
   	RS=1;
    for(i=0;i<8;i++)
     {  SCL=0;
        if(DH&0x80) SDI=1;
       	else SDI=0;
       	SCL=1;
        DH=DH<<1;
     }

    for(i=0;i<8;i++)
     {  SCL=0;
        if(DL&0x80) SDI=1;
       	else SDI=0;
       	SCL=1;
        DL=DL<<1;
     }

   	CS=1;

}




//============================================================
//delay 
void delayms(unsigned int count)
{
    int i,j;                                                                                
    for(i=0;i<count;i++)                                                                    
       {
	     for(j=0;j<125;j++);
       }                                                                                     
}


//============================================================

void LCD_FULL(unsigned int i)
{//show Box
    unsigned int w,u;
 LCD_SetPos(0,239,0,319);//320x240

	    for(w=0;w<240;w++)
		{    
          	Write_Data_U16(~i);

		}

  	for(w=0;w<318;w++)		    
        {  	Write_Data_U16(~i);
	    	
			for(u=0;u<238;u++)
         	Write_Data_U16(i);

          	Write_Data_U16(~i);		
		}

	    for(w=0;w<240;w++)
		{    
          	Write_Data_U16(~i);

		}	
	
}


//============================================================
//show gray

void DispRGBGray(void)
{  

	unsigned int  A,B,C;
    unsigned int  i,j,k,DH;

 LCD_SetPos(0,239,0,319);//320x240



	for(k=0;k<80;k++)
	{   
    	A=0;
    	B=0;
    	C=0;
		for(i=0;i<16;i++)
		{    
    		for(j=0;j<15;j++)
    		{
     			DH=(A<<11)+(B<<5)+C;
     			Write_Data_U16(DH);
    		}
    		A=A+2;
   			B=B+4;
    		C=C+2;
  		}

	}


	for(k=0;k<80;k++)
	{   
    	A=0;
    	B=0;
    	C=0;
		for(i=0;i<16;i++)
		{    
    		for(j=0;j<15;j++)
    		{
     			DH=(A<<11)+B+C;
     			Write_Data_U16(DH);
    		}
    		A=A+2;

  		}

	}

	for(k=0;k<80;k++)
	{   
    	A=0;
    	B=0;
    	C=0;
		for(i=0;i<16;i++)
		{    
    		for(j=0;j<15;j++)
    		{
     			DH=A+(B<<5)+C;
     			Write_Data_U16(DH);
    		}
    		B=B+4;

  		}

	}

	for(k=0;k<80;k++)
	{   
    	A=0;
    	B=0;
    	C=0;
		for(i=0;i<16;i++)
		{    
    		for(j=0;j<15;j++)
    		{
     			DH=A+B+C;
     			Write_Data_U16(DH);
    		}
    		C=C+2;

  		}

	}




}

//============================================================
//show picture
void show_picture(void)
{
	unsigned char i,j;
	unsigned int m=0,n=0;
 LCD_SetPos(0,239,0,319);//320x240
	for(j=0;j<160;j++)
	{
        for(i=0;i<120;i++)
		{
            Write_Data_U16(pic[m++]);
	    }
		for(i=0;i<120;i++)
		{
            Write_Data_U16(pic[n++]);
	    }
	}

   	m=0;
   	n=0;
	for(j=0;j<160;j++)
	{
        for(i=0;i<120;i++)
		{
            Write_Data_U16(pic[m++]);
	    }
		for(i=0;i<120;i++)
		{
            Write_Data_U16(pic[n++]);
	    }
	}

	


    return;
}



//=============================================================
//lcd initial

void ILI9341_Initial(void)

{	 
 	CS=1;
/*	delayms(5);
	RES=0;
	delayms(10);
	RES=1;
	delayms(120);
*/
	Write_Cmd(0x11);
	delayms(120);

 	Write_Cmd(0xCF);   
	Write_Cmd_Data(0x00); 
	Write_Cmd_Data(0xc3); 
	Write_Cmd_Data(0X30); 
      
 	Write_Cmd(0xED);   
	Write_Cmd_Data(0x64); 
	Write_Cmd_Data(0x03); 
	Write_Cmd_Data(0X12); 
	Write_Cmd_Data(0X81); 
      
 	Write_Cmd(0xE8);   
	Write_Cmd_Data(0x85); 
	Write_Cmd_Data(0x10); 
	Write_Cmd_Data(0x79); 
      
 	Write_Cmd(0xCB);   
	Write_Cmd_Data(0x39); 
	Write_Cmd_Data(0x2C); 
	Write_Cmd_Data(0x00); 
	Write_Cmd_Data(0x34); 
	Write_Cmd_Data(0x02); 
      
 	Write_Cmd(0xF7);   
	Write_Cmd_Data(0x20); 
      
 	Write_Cmd(0xEA);   
	Write_Cmd_Data(0x00); 
	Write_Cmd_Data(0x00); 
      
 	Write_Cmd(0xC0);    //Power control 
	Write_Cmd_Data(0x22);   //VRH[5:0] 
      
 	Write_Cmd(0xC1);    //Power control 
	Write_Cmd_Data(0x11);   //SAP[2:0];BT[3:0] 
      
 	Write_Cmd(0xC5);    //VCM control 
	Write_Cmd_Data(0x3d); 
    //LCD_DataWrite_ILI9341(0x30); 
	Write_Cmd_Data(0x20); 
      
 	Write_Cmd(0xC7);    //VCM control2 
    //LCD_DataWrite_ILI9341(0xBD); 
	Write_Cmd_Data(0xAA); //0xB0 
    
 	Write_Cmd(0x36);    // Memory Access Control 
	Write_Cmd_Data(0x08); 
      
 	Write_Cmd(0x3A);   
	Write_Cmd_Data(0x55); 
    
 	Write_Cmd(0xB1);   
	Write_Cmd_Data(0x00);   
	Write_Cmd_Data(0x13); 
      
 	Write_Cmd(0xB6);    // Display Function Control 
	Write_Cmd_Data(0x0A); 
	Write_Cmd_Data(0xA2); 
    
 	Write_Cmd(0xF6);     
	Write_Cmd_Data(0x01); 
	Write_Cmd_Data(0x30); 
      
 	Write_Cmd(0xF2);    // 3Gamma Function Disable 
	Write_Cmd_Data(0x00); 
      
 	Write_Cmd(0x26);    //Gamma curve selected 
	Write_Cmd_Data(0x01); 
      
 	Write_Cmd(0xE0);    //Set Gamma 
	Write_Cmd_Data(0x0F); 
	Write_Cmd_Data(0x3F); 
	Write_Cmd_Data(0x2F); 
	Write_Cmd_Data(0x0C); 
	Write_Cmd_Data(0x10); 
	Write_Cmd_Data(0x0A); 
	Write_Cmd_Data(0x53); 
	Write_Cmd_Data(0XD5); 
	Write_Cmd_Data(0x40); 
	Write_Cmd_Data(0x0A); 
	Write_Cmd_Data(0x13); 
	Write_Cmd_Data(0x03); 
	Write_Cmd_Data(0x08); 
	Write_Cmd_Data(0x03); 
	Write_Cmd_Data(0x00); 
      
 	Write_Cmd(0XE1);    //Set Gamma 
	Write_Cmd_Data(0x00); 
	Write_Cmd_Data(0x00); 
	Write_Cmd_Data(0x10); 
	Write_Cmd_Data(0x03); 
	Write_Cmd_Data(0x0F); 
	Write_Cmd_Data(0x05); 
	Write_Cmd_Data(0x2C); 
	Write_Cmd_Data(0xA2); 
	Write_Cmd_Data(0x3F); 
	Write_Cmd_Data(0x05); 
	Write_Cmd_Data(0x0E); 
	Write_Cmd_Data(0x0C); 
	Write_Cmd_Data(0x37); 
	Write_Cmd_Data(0x3C); 
	Write_Cmd_Data(0x0F); 
      
 	Write_Cmd(0x11);    //Exit Sleep 
	delayms(120);
 	Write_Cmd(0x29);    //Display on 
	delayms(50);



}





	    
void Enter_Sleep(void) 
{ 
	Write_Cmd(0x28);     // Display off 
	Write_Cmd(0x10);     // Enter Sleep mode 
} 
 
void Exit_Sleep(void) 
{ 
	Write_Cmd(0x11);     // Sleep out 
	delayms(120); 
	Write_Cmd(0x29);     // Display on 
} 



//===============================================================
//定义坐标
static void LCD_SetPos(unsigned char x0,unsigned char x1,unsigned int y0,unsigned int y1)
{unsigned char YSH,YSL,YEH,YEL;

	YSH=y0>>8;
	YSL=y0;

	YEH=y1>>8;
	YEL=y1;

 	Write_Cmd(0x2A);
	Write_Cmd_Data (0x00);
	Write_Cmd_Data (x0);
	Write_Cmd_Data (0x00);
	Write_Cmd_Data (x1);
	Write_Cmd(0x2B);
	Write_Cmd_Data (YSH);
	Write_Cmd_Data (YSL);
	Write_Cmd_Data (YEH);
	Write_Cmd_Data (YEL);
	Write_Cmd(0x2C);//LCD_WriteCMD(GRAMWR);
}

unsigned int code pic[]=
{
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

};
