aleksejm/6xUSB-Power-Meter/ER-TFTM024-3(4-Wire-SPI)_TP_SD_FONT_FLASH/sd.c

//----------------------------------------------------------------------
//EASTRISING TECHNOLOGY CO,.LTD.//
// Module    : 2.4 INCH TFT LCD  240RGB*320 DOTS
// Lanuage   : C51 Code
// Create    : JAVEN LIU
// Date      : 2014-07-25
// Drive IC  : LCD:ILI9341  TP:TSC2046  FLASH: W25Q32BV   FONT CHIP:GT21L16T1W
// INTERFACE : LCD 4WIER SPI   TP:SPI  FLASH:SPI   FONT CHIP:SPI  SD CARD: SPI
// MCU 		 : STC12LE5C60S2
// VDD		 : 5V OR 3.3 V
// MCU VDD   : 3.3V
//----------------------------------------------------------------------

#include <STC12C5A.H>
#include <stdio.h>
#include <intrins.h>
#include<9341TP.h>
#include<word.h>
#include<TP.h>
#include"fontchip.h"
#include"25Q32.h"
//=============================================================
//define SD card IO
sbit SD_CLK = P1^7;
sbit SD_DI  = P1^5;
sbit SD_DO  = P1^6;
sbit SD_CS  = P1^4;
//===========================================================

//===========================================================
//Buffer
unsigned char xdata DATA[512];

//===========================================================
//write one byte to SD
void SdWrite(unsigned char n)
{

unsigned char i;

for(i=8;i;i--)
{
SD_CLK=0;
SD_DI=(n&0x80);
n<<=1;
SD_CLK=1;
}
SD_DI=1; 
} 
//===========================================================
//read one byte
unsigned char SdRead()
{
unsigned char n,i;
for(i=8;i;i--)
{
SD_CLK=0;
SD_CLK=1;
n<<=1;
if(SD_DO) n|=1;

}
return n;
}
//============================================================
//Detecting the response of the SD card
unsigned char SdResponse()
{
unsigned char i=0,response;

while(i<=8)
{
response = SdRead();
if(response==0x00)
break;
if(response==0x01)
break;
i++;
}
return response;
} 
//================================================================
//Send commands to the SD card
void SdCommand(unsigned char command, unsigned long argument, unsigned char CRC)
{

SdWrite(command|0x40);
SdWrite(((unsigned char *)&argument)[0]);
SdWrite(((unsigned char *)&argument)[1]);
SdWrite(((unsigned char *)&argument)[2]);
SdWrite(((unsigned char *)&argument)[3]);
SdWrite(CRC);
}
//================================================================
//Initialize the SD card
unsigned char SdInit(void)
{
int delay=0, trials=0;
unsigned char i;
unsigned char response=0x01;

SD_CS=1;
for(i=0;i<=9;i++)
SdWrite(0xff);
SD_CS=0;

//Send Command 0 to put MMC in SPI mode
SdCommand(0x00,0,0x95);


response=SdResponse();

if(response!=0x01)
{
return 0;
} 

while(response==0x01)
{
SD_CS=1;
SdWrite(0xff);
SD_CS=0;
SdCommand(0x01,0x00ffc000,0xff);
response=SdResponse();
} 

SD_CS=1;
SdWrite(0xff);
return 1; 
}
//================================================================
//Specify the address to write  the SD card data, a maximum of 512 bytes
unsigned char SdWriteBlock(unsigned char *Block, unsigned long address,int len)
{
unsigned int count;
unsigned char dataResp;
//Block size is 512 bytes exactly
//First Lower SS

SD_CS=0;
//Then send write command
SdCommand(0x18,address,0xff);

if(SdResponse()==00)
{
SdWrite(0xff);
SdWrite(0xff);
SdWrite(0xff);
//command was a success - now send data
//start with DATA TOKEN = 0xFE
SdWrite(0xfe);
//now send data
for(count=0;count<len;count++) SdWrite(*Block++);

for(;count<512;count++) SdWrite(0);
//data block sent - now send checksum
SdWrite(0xff); 
SdWrite(0xff);
//Now read in the DATA RESPONSE token
dataResp=SdRead();
//Following the DATA RESPONSE token
//are a number of BUSY bytes
//a zero byte indicates the MMC is busy

while(SdRead()==0);

dataResp=dataResp&0x0f; //mask the high byte of the DATA RESPONSE token
SD_CS=1;
SdWrite(0xff);
if(dataResp==0x0b)
{
//printf("DATA WAS NOT ACCEPTED BY CARD -- CRC ERROR\n");
return 0;
}
if(dataResp==0x05)
return 1;

//printf("Invalid data Response token.\n");
return 0;
}
//printf("Command 0x18 (Write) was not received by the MMC.\n");
return 0;
}

//=======================================================================
//Specified address from the SD card to read data, a maximum of 512 bytes
unsigned char SdReadBlock(unsigned char *Block, unsigned long address,int len)
{
unsigned int count;
//Block size is 512 bytes exactly
//First Lower SS

 //printf("MMC_read_block\n");

SD_CS=0;
//Then send write command
SdCommand(0x11,address,0xff);

if(SdResponse()==00)
{
//command was a success - now send data
//start with DATA TOKEN = 0xFE
while(SdRead()!=0xfe);

for(count=0;count<len;count++) *Block++=SdRead(); 

for(;count<512;count++) SdRead();

//data block sent - now send checksum
SdRead();
SdRead();
//Now read in the DATA RESPONSE token
SD_CS=1;
SdRead();
return 1;
}
 //printf("Command 0x11 (Read) was not received by the MMC.\n");
return 0;
}

//============================================================	
main()
{
 unsigned char  xa=0; 
 unsigned long j;  
  unsigned int f,i,ya=0;
  unsigned long AddTemp;////SD card physical address of the first data address initial value
 	P1=0xff;
 	P2=0xff;
 	P3=0xff;
 	P0=0xff;
	BL_ON=0;
	ILI9341_Initial();//LCD initialization
	BL_ON=1;
while(1)
{

	LCD_FULL(0xf800);
	 while(KEY);	    
	LCD_FULL(0x07e0);
	 while(KEY);	 	
	LCD_FULL(0x001f);
	 while(KEY);
	LCD_FULL(0x07ff);
     while(KEY); 
	LCD_FULL(0xffe0);
     while(KEY); 
	LCD_FULL(0xf81f);
     while(KEY);

	ClearScreen(0x00);	//all off
	 while(KEY);

	ClearScreen(0xffff);	//all display
	 while(KEY);

	DispRGBGray();
     while(KEY); 

	show_picture();        //pictuer in mcu
     while(KEY); 
	 
	TPTEST();

 	ClearScreen(0xffff);	//all display
	Display_GB2312_String();
	while(KEY);
 	ClearScreen(0xffff);	//all display
	SHOW_BOOK(book);			
	while(KEY);

 	flash();
	while(KEY);

	SdInit();         //SD Card initialization
	f=7;			//Total number of picture
	AddTemp=328192; //1G TF CARD
 while(f--)
 {
  	   LCD_SetPos(0,240,0,320); 
 for(j=0;j<300;j++)   ////A picture information  comprising 300x512 bytes
    {
    SdReadBlock(DATA,AddTemp+(j*512),512);
    for(i=0;i<256;i++)                    
	   {   

   	   Write_Data(DATA[2*i],DATA[2*i+1]);	 

       }
     } 
     AddTemp = AddTemp+((j+20)*512);         
     while(KEY);                        
	 
 } 
}
}
