aleksejm/6xUSB-Power-Meter/(commit log)

2016-04-20 6 port USB power meter with OLED display
    6 port USB power meter/PSU with OLED display
    [6xUSB_PowMet.kicad_pcb, 6xUSB_PowMet.sch]
2016-05-06 Schematic updates
    [6xUSB_PowMet-B.Adhes.gbr, 6xUSB_PowMet-B.CrtYd.gbr, 6xUSB_PowMet-B.Cu.gbr, 6xUSB_PowMet-B.Fab.gbr, 6xUSB_PowMet-B.Mask.gbr, 6xUSB_PowMet-B.SilkS.gbr, 6xUSB_PowMet-Cmts.User.gbr, 6xUSB_PowMet-Dwgs.User.gbr]
2016-05-16 Removed some files
    [6xUSB_PowMet-B.Adhes.gbr, 6xUSB_PowMet-B.CrtYd.gbr, 6xUSB_PowMet-B.Cu.gbr, 6xUSB_PowMet-B.Fab.gbr, 6xUSB_PowMet-B.Mask.gbr, 6xUSB_PowMet-B.SilkS.gbr, 6xUSB_PowMet-Cmts.User.gbr, 6xUSB_PowMet-Dwgs.User.gbr]
2016-05-26 Updated pcb
    Updated schematic and solved some pcb mistakes
    [6xUSB_PowMet.kicad_pcb, Parts.xlsx, USB_hub.sch, _saved_6xUSB_PowMet.sch]
2016-05-31 Upd_sch
    Updated schematic and PCB
    [6xUSB_PowMet.kicad_pcb, 6xUSB_PowMet.sch, Parts.xlsx, USB_hub.sch, _saved_6xUSB_PowMet.sch]
2016-06-01 Updates schematic
    Updated schematic and added datasheets
    [6xUSB_PowMet.sch, BOM_4493365_19.xls, USB_hub.sch]
2016-06-07 Upd
    Schematic updates and PCB
    [6xUSB_PowMet-B.CrtYd.gbr, 6xUSB_PowMet-B.Cu.gbl, 6xUSB_PowMet-B.Fab.gbr, 6xUSB_PowMet-B.Mask.gbs, 6xUSB_PowMet-B.Paste.gbp, 6xUSB_PowMet-B.SilkS.gbo, 6xUSB_PowMet-Dwgs.User.gbr, 6xUSB_PowMet-Edge.Cuts.gm1]
